irqmask/koewiba-domotic/hw/gateway_usb/doc/gateway_usb_back.png

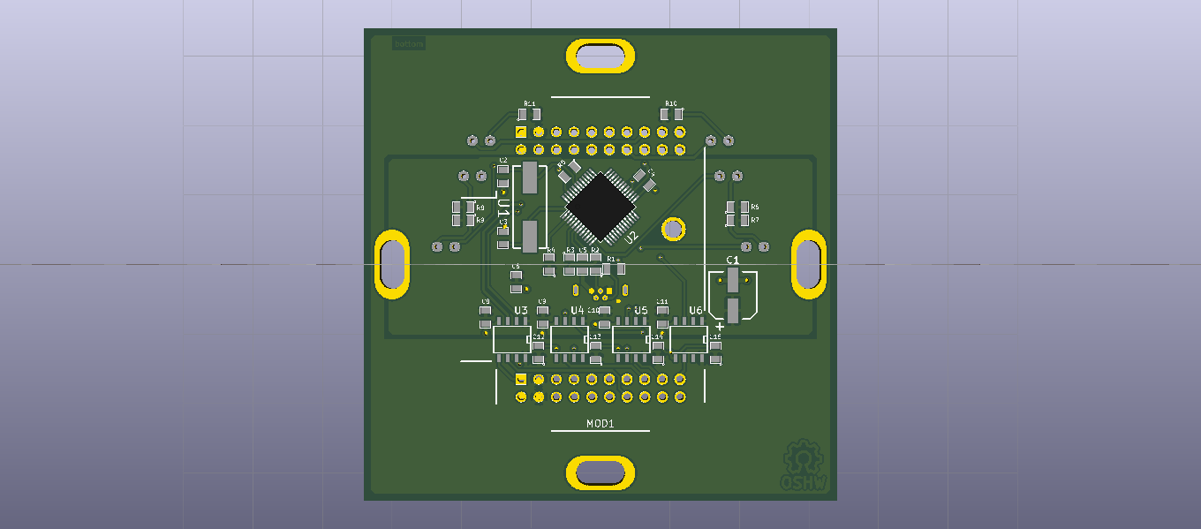
hw/gateway_usb/doc/gateway_usb_back.png
