irqmask/koewiba-domotic/hw/pi2-base/doc/pi2-base_back.jpg

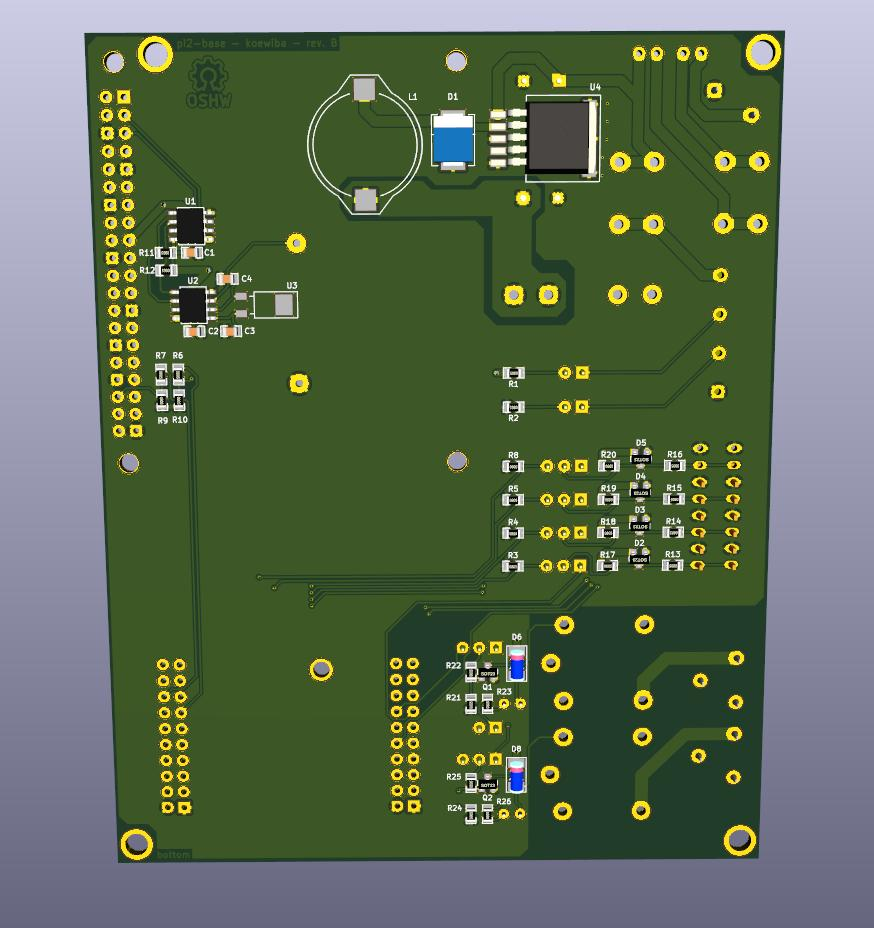
hw/pi2-base/doc/pi2-base_back.jpg
