irqmask/koewiba-domotic/README.md

# koewiba-domotic
home-automation

<a href="https://scan.coverity.com/projects/irqmask-koewiba-domotic">
  
</a>
