irqmask/koewiba-domotic/hw/README.txt

To load KICAD symbols and footprints, make a symbolic link called 'kicadlibrary' to your checked-out symbol- and footprint- library.
e.g. ln -s ~/Projekte/electronic/00library/kicad/ kicadlibrary
