irqmask/koewiba-domotic/doc/drawings/03_two_nodes_gateway_router_mqttgateway_mqtt_openhab.png

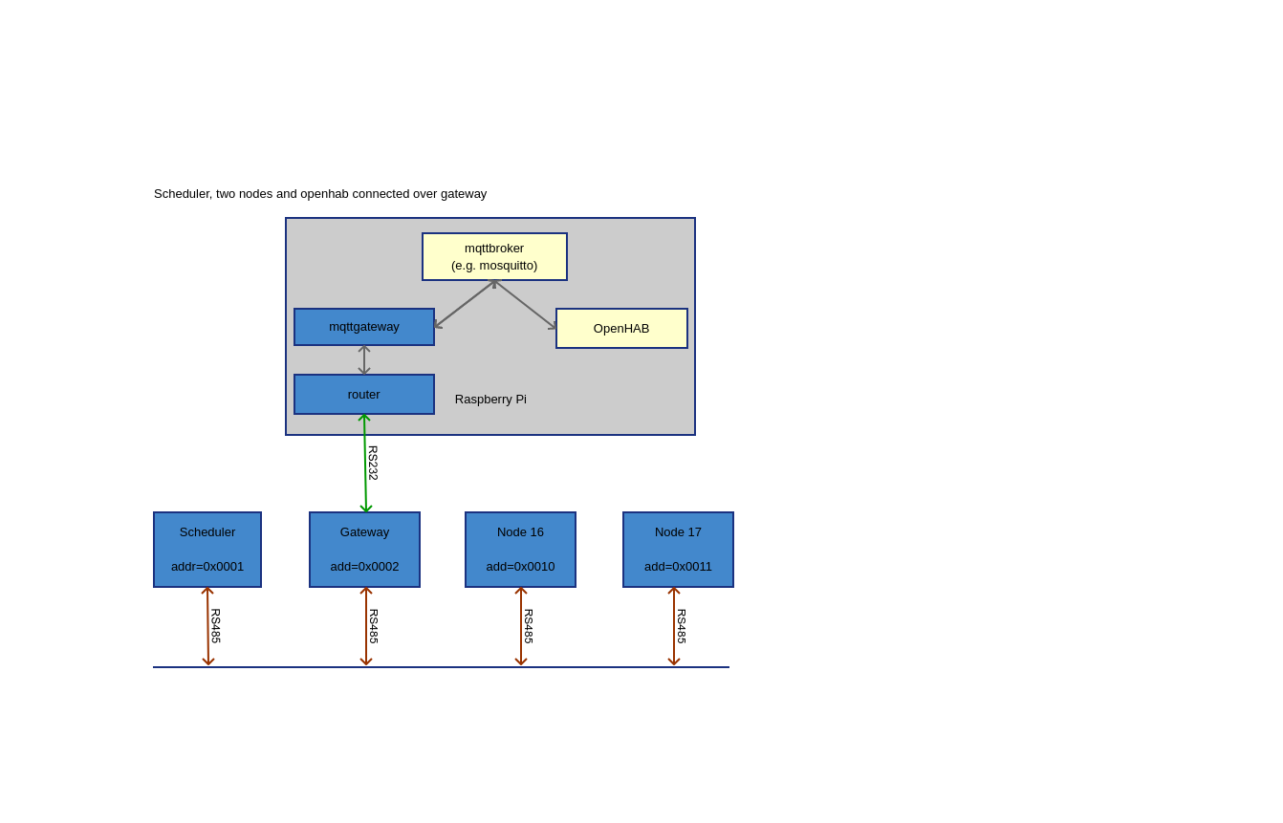
doc/drawings/03_two_nodes_gateway_router_mqttgateway_mqtt_openhab.png
