irqmask/koewiba-domotic/doc/drawings/04_two_networks.png

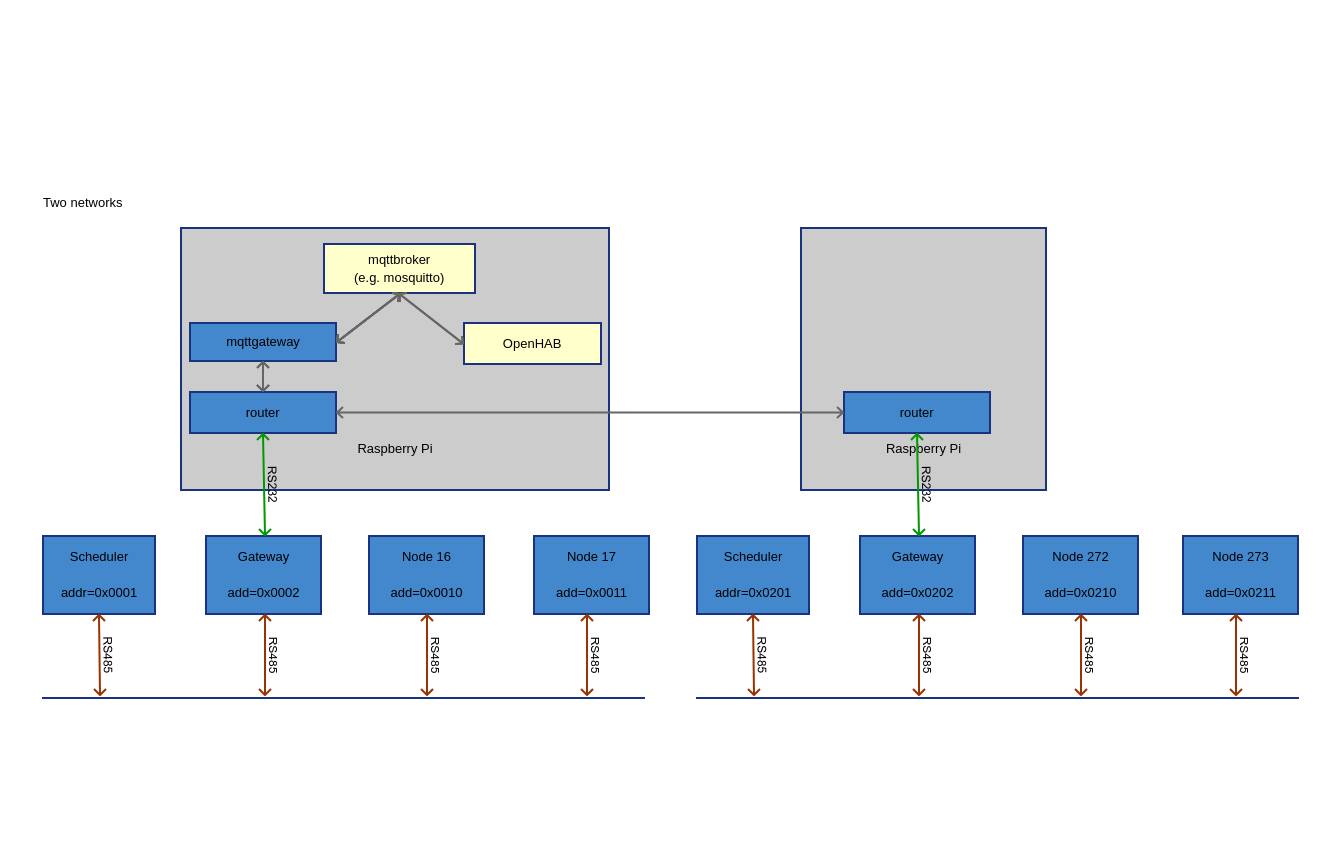
doc/drawings/04_two_networks.png
