irqmask/koewiba-domotic/hw/bus-module_atmega324/bus-module_atmega324_back.jpg

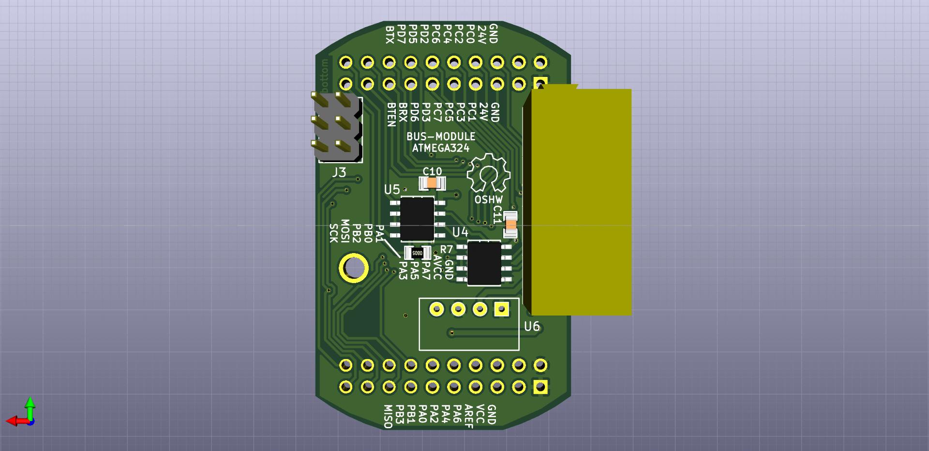
hw/bus-module_atmega324/bus-module_atmega324_back.jpg
