irqmask/koewiba-domotic/hw/bus-module_atmega324/bus-module_atmega324_front.jpg

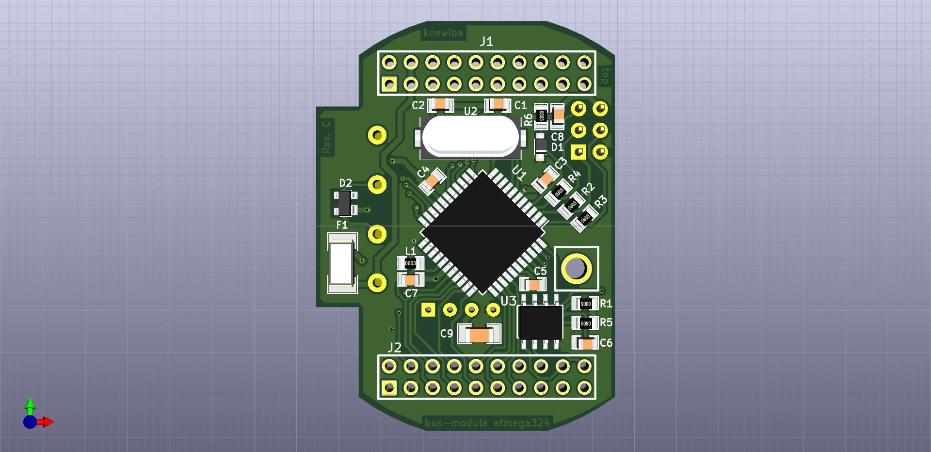
hw/bus-module_atmega324/bus-module_atmega324_front.jpg
