irqmask/koewiba-domotic/hw/bus-module_atmega328/bus-module_atmega328_back.jpg

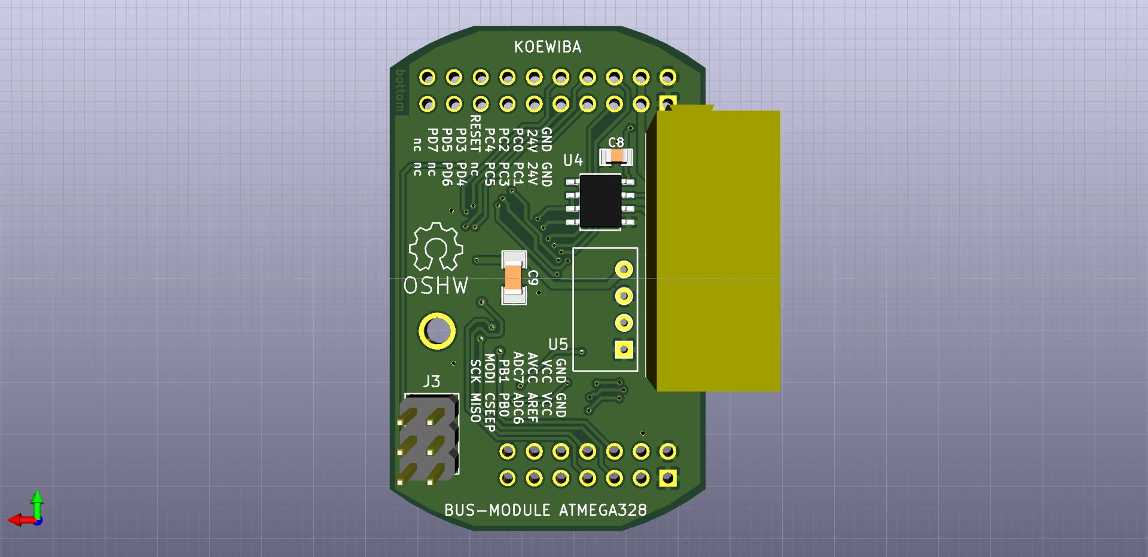
hw/bus-module_atmega328/bus-module_atmega328_back.jpg
