irqmask/koewiba-domotic/hw/bus-module_atmega328/bus-module_atmega328_front.jpg

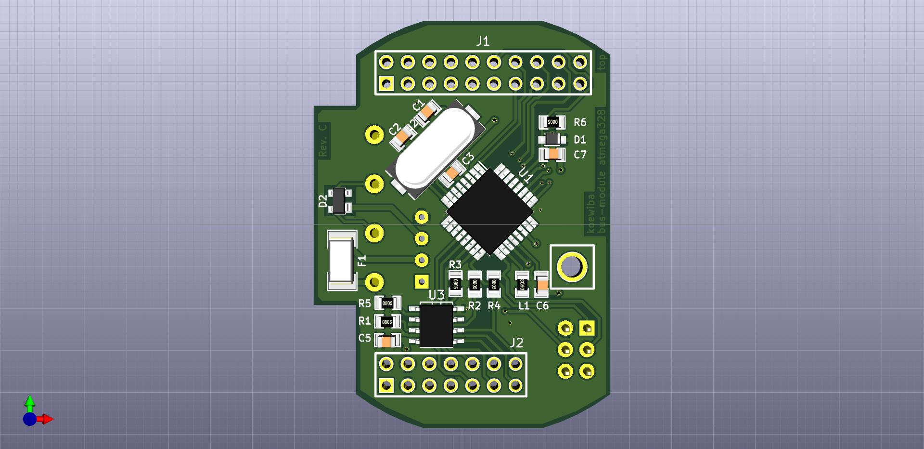
hw/bus-module_atmega328/bus-module_atmega328_front.jpg
