irqmask/koewiba-domotic/hw/bus-module_attiny1634/bus-module_attiny1634_front.jpg

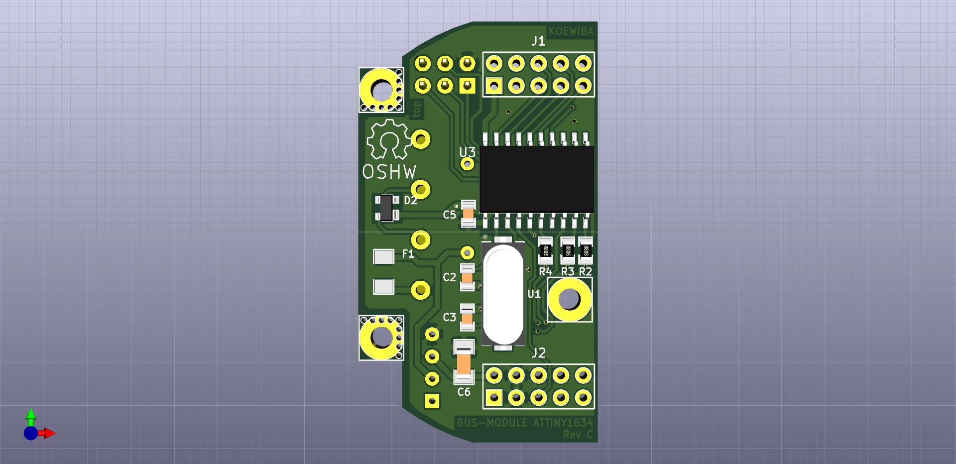
hw/bus-module_attiny1634/bus-module_attiny1634_front.jpg
