irqmask/koewiba-domotic/hw/gateway_usb/doc/gateway_usb_front.png

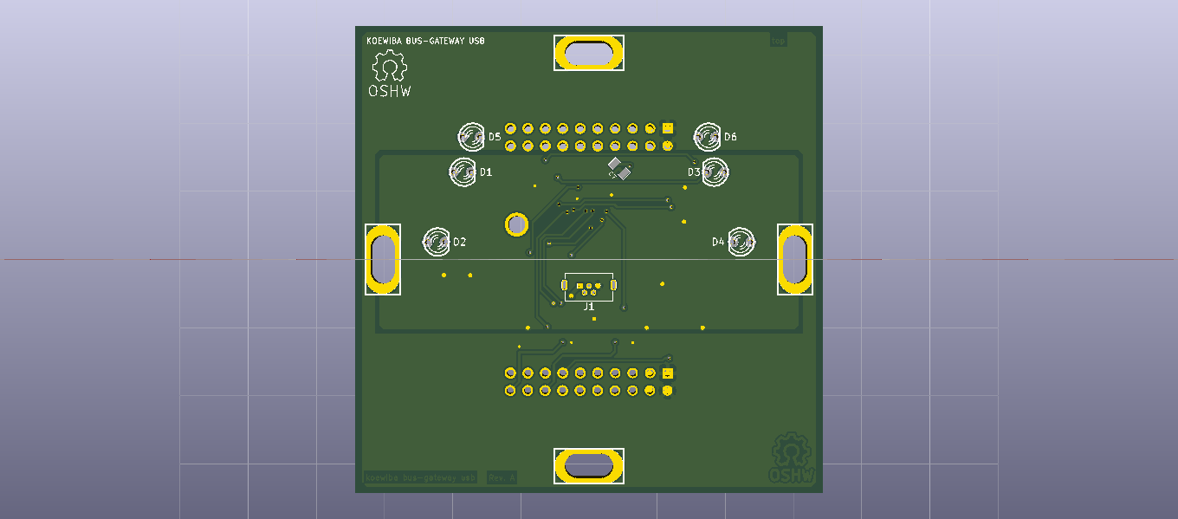
hw/gateway_usb/doc/gateway_usb_front.png
