irqmask/koewiba-domotic/hw/heatervalve/reflectedlightbarrier.png

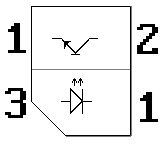
hw/heatervalve/reflectedlightbarrier.png
