irqmask/koewiba-domotic/hw/motor_switch_3pole_5x/doc/motor_switch_3pole_5x_back_3d.jpg

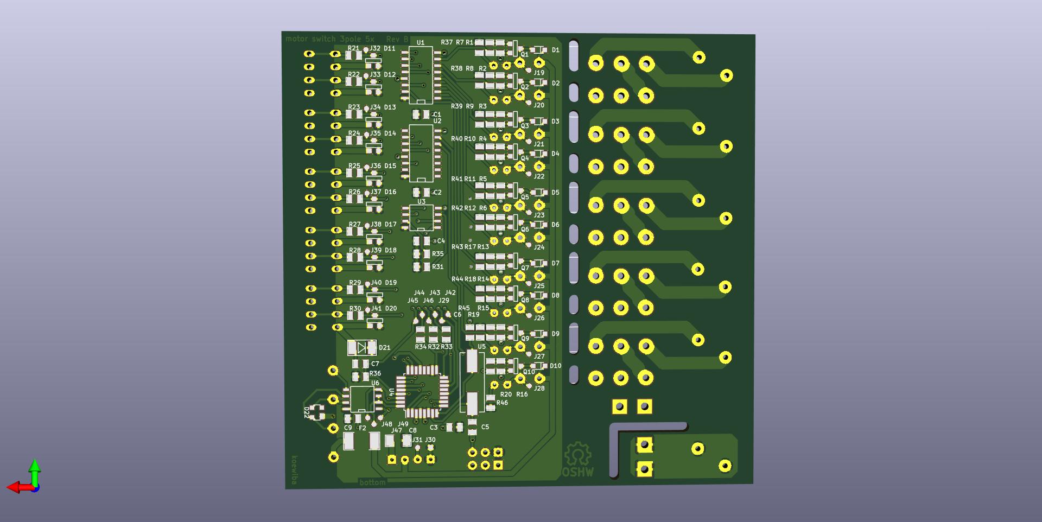
hw/motor_switch_3pole_5x/doc/motor_switch_3pole_5x_back_3d.jpg
