irqmask/koewiba-domotic/hw/motor_switch_3pole_5x/doc/motor_switch_3pole_5x_front_3d.jpg

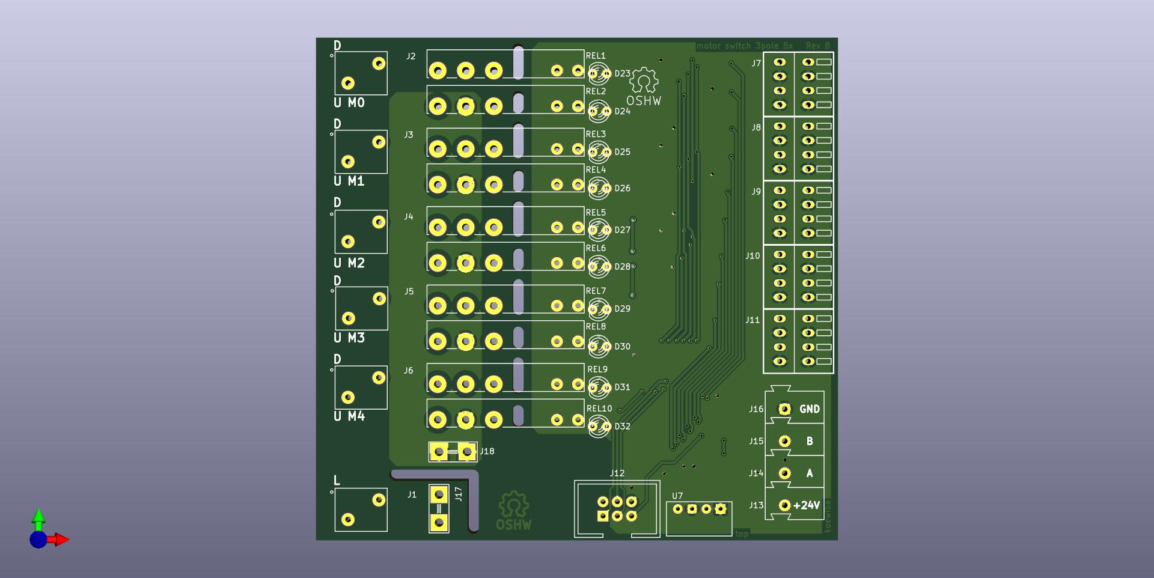
hw/motor_switch_3pole_5x/doc/motor_switch_3pole_5x_front_3d.jpg
