irqmask/koewiba-domotic/hw/roomthermostat/roomthermostat_back_3d.jpg

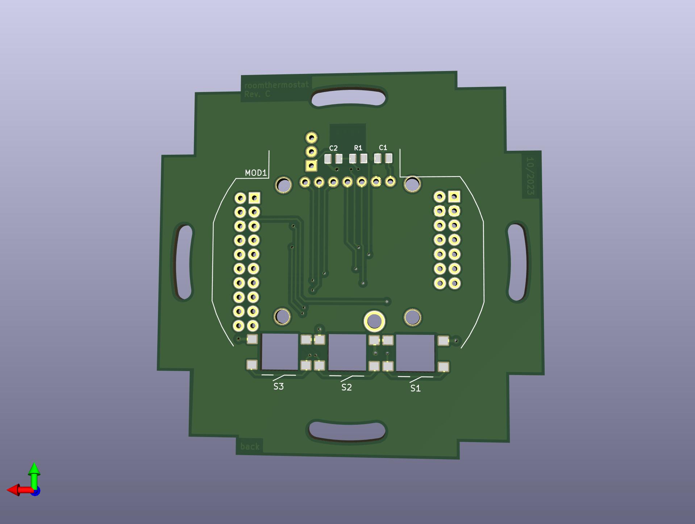
hw/roomthermostat/roomthermostat_back_3d.jpg
