irqmask/koewiba-domotic/hw/roomthermostat/roomthermostat_front_3d.jpg

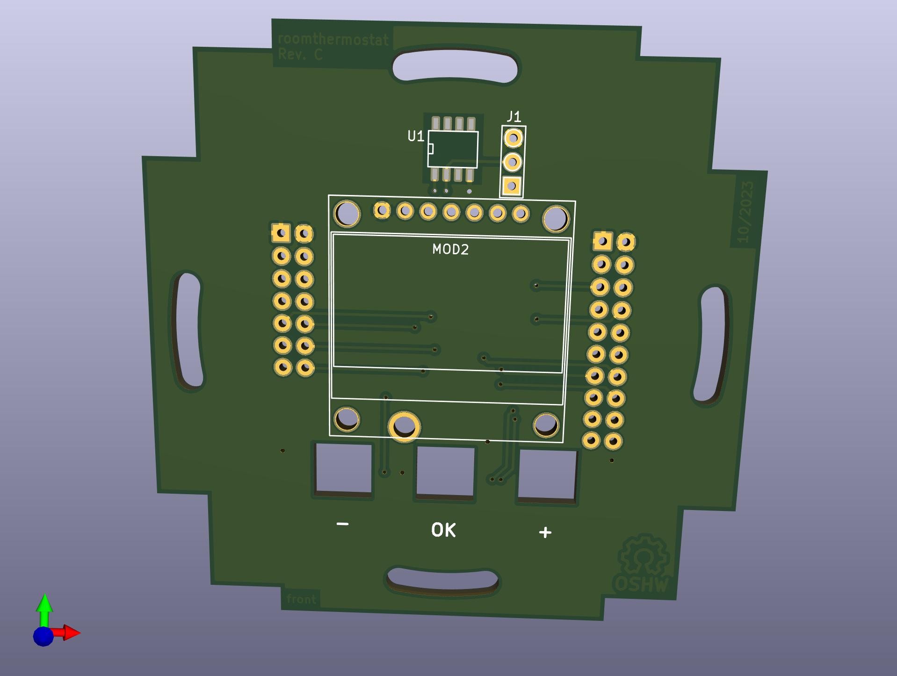
hw/roomthermostat/roomthermostat_front_3d.jpg
