irqmask/koewiba-domotic/hw/switch_3pole_5x/doc/switch_3pole_5x_front_3d.jpg

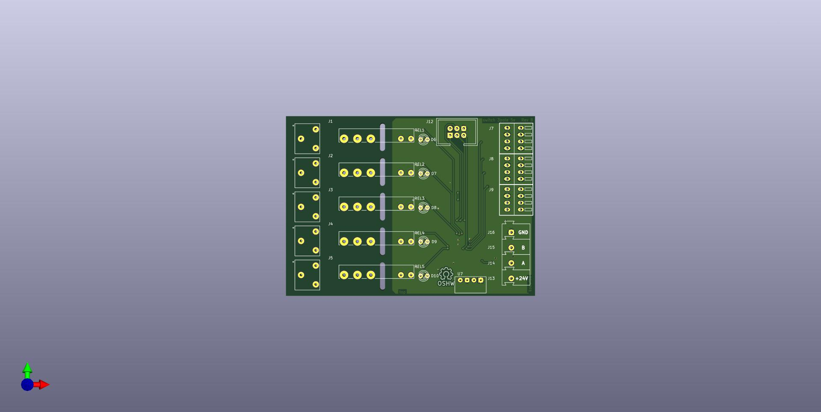
hw/switch_3pole_5x/doc/switch_3pole_5x_front_3d.jpg
