irqmask/koewiba-domotic/sw/doc/drawings/serial_gateway.png

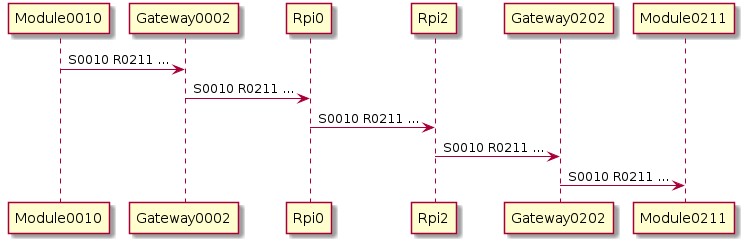
sw/doc/drawings/serial_gateway.png
