irqmask/koewiba-domotic/doc/RegisterOverview.ods

Register |  | default |  |  |  | blind-control (app id 0006h) |  |  |  | Blind-control_5+4 (app id 000Bh) |  |  |  | gateway232(app id 0002h) |  |  |  | pushbutton8 (app id 0009h) |  |  |  | roomthermostate (app id 0007h) |  |  |  | scheduler(app id 0001h) |  |  |  | led2 (app id 0008h) |  |  |  | switch5 (app id 000Ah) |  |  |  | heatervalve (app id 000Ch)
dec | hex | Name | Description | Size | pv | Name | Description | Size | pv | Name | Description | Size | pv | Name | Description | Size | pv | Name | Description | Size | pv | Name | Description | Size | pv | Name | Description | Size | pv | Name | Description | Size | pv | Name | Description | Size | pv | Name | Description | Size | pv
0 | 00 | unused | n/a |  |  | unused | n/a |  |  | unused | n/a |  |  | unused | n/a |  |  | unused | n/a |  |  | unused | n/a |  |  | unused | n/a |  |  | unused | n/a |  |  | unused | n/a |  |  | unused | n/a
1 | 01 | ModuleID | Module ID as it appears on the bus | uint8 | p | ModuleID | Module ID as it appears on the bus | uint8 | p | ModuleID | Module ID as it appears on the bus | uint8 | p | ModuleID | Module ID as it appears on the bus | uint8 | p | ModuleID | Module ID as it appears on the bus | uint8 | p | ModuleID | Module ID as it appears on the bus | uint8 | p | ModuleID | Module ID as it appears on the bus | uint8 | p | ModuleID | Module ID as it appears on the bus | uint8 | p | ModuleID | Module ID as it appears on the bus | uint8 | p | ModuleID | Module ID as it appears on the bus | uint8 | p
2 | 02 | BldFlag | Storage for bootloader flags | uint8 | p | BldFlag | Storage for bootloader flags | uint8 | p | BldFlag | Storage for bootloader flags | uint8 | p | BldFlag | Storage for bootloader flags | uint8 | p | BldFlag | Storage for bootloader flags | uint8 | p | BldFlag | Storage for bootloader flags | uint8 | p | BldFlag | Storage for bootloader flags | uint8 | p | BldFlag | Storage for bootloader flags | uint8 | p | BldFlag | Storage for bootloader flags | uint8 | p | BldFlag | Storage for bootloader flags | uint8 | p
16 | 10 | FirstAppSpecific | n/a | ? |  | PositionCurrent | Current position of blind 0. 100 = completely closed. 0 = completely open | uint8 | vro | PositionCurrent | Current position of blind 0. 100 = completely closed. 0 = completely open | uint8 | vro | Input1 | State of Input 1 (open 255, closed 0) | uint8 | vro | APP_eReg_K0_Mode | Key mode function | uint8 | p | TemperatureCurrent | Current measured temperature in 1/100Kelvin | uint16 | vro | FirstAppSpecific | n/a | ? |  | IntensityChn0Current | Current intensity 0..255 | uint8 | vro | Chn0SwitchCurrent | Current intensity 0...255 | uint8 | vro | IntTempCurrent | Internal temperature sensor measurement in 1/100 Kelvin | uint16 | vro
17 | 11 | ... | ... |  |  | PositionSetPoint | Wanted position of blind. 100 = completely closed. 0 = completely open | uint8 | v | PositionSetPoint | Wanted position of blind. 100 = completely closed. 0 = completely open | uint8 | v | Input2 | State of Input 2 (open 255, closed 0) | uint8 | vro | APP_eReg_K0_RemoteAddr | Receiver's address | uint16 | p | TemperatureSetPoint | Desired temperature in 1/100 Kelvin | uint16 | v | ... | ... |  |  | IntensityChn1Current | Current intensity 0..255 | uint8 | vro | Chn0SwitchSetPoint | Target intensity 0...255 | uint8 | v | ResTempCurrent | Resulting temperature in 1/100 Kelvin. Depends on TemperatureMode | uint16 | vro
18 | 12 |  |  |  |  | PositionDifference | Difference between wanted and current position | int8 | vro | PositionDifference | Difference between wanted and current position | int8 | vro | Input3 | State of Input 3 (open 255, closed 0) | uint8 | vro | APP_eReg_K0_RemoteReg | Receiver's register to set | uint8 | p | TemperatureOffset | Offset to adjust sensor | int16 | p |  |  |  |  | IntensityChn0SetPoint | Target intensity 0..255 | uint8 | p | Chn0ThresholdOff | If intensity goes below, channel switches off | int8 | p | IntTempOffset | Offset to calibrate internal temperature sensor in 1/100 Kelvin | int16 | p
19 | 13 |  |  |  |  | ReactionDelay | Delay time in timer ticks (1/100sec) until movement starts after applying power | uint8 | p | ReactionDelay | Delay time in timer ticks (1/100sec) until movement starts after applying power | uint8 | p | Input4 | State of Input 4 (open 255, closed 0) | uint8 | vro | APP_eReg_K0_Value | Value to set (not used in all modes) | uint8 | p | WindowSensorModuleID | Module ID of module which delivers the window state | uint16 | p |  |  |  |  | IntensityChn1SetPoint | Target intensity 0..255 | uint8 | p | Chn0ThresholdOn | Target intensity 0..255 | uint8 | p | TempMode | 0=internal, 1=external, 2=average int+ext | uint8 | p
20 | 14 |  |  |  |  | DurationOpen | Duration in timer ticks (1/100sec) to fully open the blind | uint16 | p | DurationOpen | Duration in timer ticks (1/100sec) to fully open the blind | uint16 | p |  |  |  |  | APP_eReg_K0_Reserved3 | unused | uint8 | p | WindowSensor0Reg | Register number of window 0 state | uint8 | p |  |  |  |  | IntensityChn0Store | Saved intensity restored on keypress | uint8 | p | Chn0Mode | Mode of channel: Bit0: 0 -> set; 1 -> toggle | uint8 | p
21 | 15 |  |  |  |  | DurationClose | Duration in timer ticks (1/100sec) to fully close the blind | uint16 | p | DurationClose | Duration in timer ticks (1/100sec) to fully close the blind | uint16 | p |  |  |  |  | APP_eReg_K0_Reserved2 | unused | uint8 | p | WindowSensor1Reg | Register number of window 1 state | uint8 |  |  |  |  |  | IntensityChn1Store | Saved intensity restored on keypress | uint8 | p | Chn0Timer0_Weekday | Flags on which weekday this timer applies. Index flags with day-of-week | uint8 | p
22 | 16 |  |  |  |  | Mode |  | uint8 | p | Mode |  | uint8 | p |  |  |  |  | APP_eReg_K0_Reserved1 | unused | uint8 | p | Mode | 0-normal, 1-vacation | uint8 | p |  |  |  |  |  |  |  |  | Chn0Timer0_Hour |  | uint8 | p
23 | 17 |  |  |  |  | unused |  |  |  | unused |  |  |  |  |  |  |  | APP_eReg_K0_Reserved0 | unused | uint8 | p | TemperatureWindowOpen | Temperature to set when a window is opened | uint16 | p |  |  |  |  |  |  |  |  | Chn0Timer0_Minute |  | uint8 | p
24 | 18 |  |  |  |  | unused |  |  |  | unused |  |  |  |  |  |  |  | APP_eReg_K1_Mode | Key mode function | uint8 | p | TemperatureVacation | Temperature to set when in mode vacation | uint16 | p |  |  |  |  |  |  |  |  | Chn0Timer0_SetPoint |  | uint8 | p
25 | 19 |  |  |  |  | unused |  |  |  | unused |  |  |  |  |  |  |  | APP_eReg_K1_RemoteAddr | Receiver's address | uint16 | p |  |  |  |  |  |  |  |  |  |  |  |  | Chn0Timer1_Weekday | Flags on which weekday this timer applies. Index flags with day-of-week | uint8 | p
26 | 1A |  |  |  |  | TimeUp1_Weekday | Flags on which weekday this timer applies. Index flags with day-of-week | uint8 | p | PositionCurrent | Current position of blind 0. 100 = completely closed. 0 = completely open | uint8 | vro |  |  |  |  | APP_eReg_K1_RemoteReg | Receiver's register to set | uint8 | p | Temp0_Weekday | Timepoint 0: Weekday when to switch temperature | uint8 | p |  |  |  |  |  |  |  |  | Chn0Timer1_Hour |  | uint8 | p
27 | 1B |  |  |  |  | TimeUp1_Hour |  | uint8 | p | PositionSetPoint | Wanted position of blind. 100 = completely closed. 0 = completely open | uint8 | v |  |  |  |  | APP_eReg_K1_Value | Value to set (not used in all modes) | uint8 | p | Temp0_Hour | Timepoint 0: Hour when to switch temperature | uint8 | p |  |  |  |  |  |  |  |  | Chn0Timer1_Minute |  | uint8 | p
28 | 1C |  |  |  |  | TimeUp1_Minute |  | uint8 | p | PositionDifference | Difference between wanted and current position | int8 | vro |  |  |  |  | APP_eReg_K1_Reserved3 | unused | uint8 | p | Temp0_Minute | Timepoint 0: Minute when to switch temperature | uint8 | p |  |  |  |  |  |  |  |  | Chn0Timer1_SetPoint |  | uint8 | p
29 | 1D |  |  |  |  | unused |  |  |  | ReactionDelay | Delay time in timer ticks (1/100sec) until movement starts after applying power | uint8 | p |  |  |  |  | APP_eReg_K1_Reserved2 | unused | uint8 | p | Temp0_Temperature | Timepoint 0: Temperature to set when timepoint is reached | uint16 | p |  |  |  |  |  |  |  |  | Chn0Timer2_Weekday | Flags on which weekday this timer applies. Index flags with day-of-week | uint8 | p
30 | 1E |  |  |  |  | unused |  |  |  | DurationOpen | Duration in timer ticks (1/100sec) to fully open the blind | uint16 | p |  |  |  |  | APP_eReg_K1_Reserved1 | unused | uint8 | p |  |  |  |  |  |  |  |  |  |  |  |  | Chn0Timer2_Hour |  | uint8 | p
31 | 1F |  |  |  |  | TimeDown1_Weekday | Flags on which weekday this timer applies. Index flags with day-of-week | uint8 | p | DurationClose | Duration in timer ticks (1/100sec) to fully close the blind | uint16 | p |  |  |  |  | APP_eReg_K1_Reserved0 | unused | uint8 | p | Temp1_Weekday | Timepoint 1: Weekday when to switch temperature | uint8 | p |  |  |  |  |  |  |  |  | Chn0Timer2_Minute |  | uint8 | p
32 | 20 |  |  |  |  | TimeDown1_Hour |  | uint8 | p | Mode |  | uint8 | p |  |  |  |  | APP_eReg_K2_Mode | Key mode function | uint8 | p | Temp1_Hour | Timepoint 1: Hour when to switch temperature | uint8 | p |  |  |  |  |  |  |  |  | Chn0Timer2_SetPoint |  | uint8 | p | RemTempCurrentModID | ModuleID of sender of current temperature | uint16 | p
33 | 21 |  |  |  |  | TimeDown1_Minute |  | uint8 | p | unused |  |  |  |  |  |  |  | APP_eReg_K2_RemoteAddr | Receiver's address | uint16 | p | Temp1_Minute | Timepoint 1: Minute when to switch temperature | uint8 | p |  |  |  |  |  |  |  |  | Chn0Timer3_Weekday | Flags on which weekday this timer applies. Index flags with day-of-week | uint8 | p | RemTempCurrentRegNo | Sender's register number of current temperature | uint8 | p
34 | 22 |  |  |  |  | unused |  |  |  | unused |  |  |  |  |  |  |  | APP_eReg_K2_RemoteReg | Receiver's register to set | uint8 | p | Temp1_Temperature | Timepoint 1: Temperature to set when timepoint is reached | uint16 | p |  |  |  |  |  |  |  |  | Chn0Timer3_Hour |  | uint8 | p | RemTempSetpointModID | ModuleID of sender of temperature setpoint | uint16 | p
35 | 23 |  |  |  |  | unused |  |  |  | unused |  |  |  |  |  |  |  | APP_eReg_K2_Value | Value to set (not used in all modes) | uint8 | p |  |  |  |  |  |  |  |  |  |  |  |  | Chn0Timer3_Minute |  | uint8 | p | RemTempSetpointRegNo | Sender's register number of temperature setpoint | uint8 | p
36 | 24 |  |  |  |  | TimeUp2_Weekday | Flags on which weekday this timer applies. Index flags with day-of-week | uint8 | p | PositionCurrent | Current position of blind 0. 100 = completely closed. 0 = completely open | uint8 | vro |  |  |  |  | APP_eReg_K2_Reserved3 | unused | uint8 | p | Temp2_Weekday | Timepoint 2: Weekday when to switch temperature | uint8 | p |  |  |  |  |  |  |  |  | Chn0Timer3_SetPoint |  | uint8 | p | DebugReceiverModuleID | Receiver module ID for debug messages | uint16 | p
37 | 25 |  |  |  |  | TimeUp2_Hour |  | uint8 | p | PositionSetPoint | Wanted position of blind. 100 = completely closed. 0 = completely open | uint8 | v |  |  |  |  | APP_eReg_K2_Reserved2 | unused | uint8 | p | Temp2_Hour | Timepoint 2: Hour when to switch temperature | uint8 | p |  |  |  |  |  |  |  |  | Chn0Timer4_Weekday | Flags on which weekday this timer applies. Index flags with day-of-week | uint8 | p
38 | 26 |  |  |  |  | TimeUp2_Minute |  | uint8 | p | PositionDifference | Difference between wanted and current position | int8 | vro |  |  |  |  | APP_eReg_K2_Reserved1 | unused | uint8 | p | Temp2_Minute | Timepoint 2: Minute when to switch temperature | uint8 | p |  |  |  |  |  |  |  |  | Chn0Timer4_Hour |  | uint8 | p | Reg_Kp | Regulation Proportional paramater | uint16 | p
39 | 27 |  |  |  |  | unused |  |  |  | ReactionDelay | Delay time in timer ticks (1/100sec) until movement starts after applying power | uint8 | p |  |  |  |  | APP_eReg_K2_Reserved0 | unused | uint8 | p | Temp2_Temperature | Timepoint 2: Temperature to set when timepoint is reached | uint16 | p |  |  |  |  |  |  |  |  | Chn0Timer4_Minute |  | uint8 | p
40 | 28 |  |  |  |  | unused |  |  |  | DurationOpen | Duration in timer ticks (1/100sec) to fully open the blind | uint16 | p |  |  |  |  | APP_eReg_K3_Mode | Key mode function | uint8 | p |  |  |  |  |  |  |  |  |  |  |  |  | Chn0Timer4_SetPoint |  | uint8 | p
41 | 29 |  |  |  |  | TimeDown2_Weekday | Flags on which weekday this timer applies. Index flags with day-of-week | uint8 | p | DurationClose | Duration in timer ticks (1/100sec) to fully close the blind | uint16 | p |  |  |  |  | APP_eReg_K3_RemoteAddr | Receiver's address | uint16 | p | Temp3_Weekday | Timepoint 3: Weekday when to switch temperature | uint8 | p |  |  |  |  |  |  |  |  | Chn0Timer5_Weekday | Flags on which weekday this timer applies. Index flags with day-of-week | uint8 | p
42 | 2A |  |  |  |  | TimeDown2_Hour |  | uint8 | p | Mode |  | uint8 | p |  |  |  |  | APP_eReg_K3_RemoteReg | Receiver's register to set | uint8 | p | Temp3_Hour | Timepoint 3: Hour when to switch temperature | uint8 | p |  |  |  |  |  |  |  |  | Chn0Timer5_Hour |  | uint8 | p
43 | 2B |  |  |  |  | TimeDown2_Minute |  | uint8 | p | unused |  |  |  |  |  |  |  | APP_eReg_K3_Value | Value to set (not used in all modes) | uint8 | p | Temp3_Minute | Timepoint 3: Minute when to switch temperature | uint8 | p |  |  |  |  |  |  |  |  | Chn0Timer5_Minute |  | uint8 | p
44 | 2C |  |  |  |  | unused |  |  |  | unused |  |  |  |  |  |  |  | APP_eReg_K3_Reserved3 | unused | uint8 | p | Temp3_Temperature | Timepoint 3: Temperature to set when timepoint is reached | uint16 | p |  |  |  |  |  |  |  |  | Chn0Timer5_SetPoint |  | uint8 | p
45 | 2D |  |  |  |  | unused |  |  |  | unused |  |  |  |  |  |  |  | APP_eReg_K3_Reserved2 | unused | uint8 | p |  |  |  |  |  |  |  |  |  |  |  |  | Chn0Timer6_Weekday | Flags on which weekday this timer applies. Index flags with day-of-week | uint8 | p
46 | 2E |  |  |  |  | TimeUp3_Weekday | Flags on which weekday this timer applies. Index flags with day-of-week | uint8 | p | PositionCurrent | Current position of blind 0. 100 = completely closed. 0 = completely open | uint8 | vro |  |  |  |  | APP_eReg_K3_Reserved1 | unused | uint8 | p | Temp4_Weekday | Timepoint 4: Weekday when to switch temperature | uint8 | p |  |  |  |  |  |  |  |  | Chn0Timer6_Hour |  | uint8 | p
47 | 2F |  |  |  |  | TimeUp3_Hour |  | uint8 | p | PositionSetPoint | Wanted position of blind. 100 = completely closed. 0 = completely open | uint8 | v |  |  |  |  | APP_eReg_K3_Reserved0 | unused | uint8 | p | Temp4_Hour | Timepoint 4: Hour when to switch temperature | uint8 | p |  |  |  |  |  |  |  |  | Chn0Timer6_Minute |  | uint8 | p
48 | 30 |  |  |  |  | TimeUp3_Minute |  | uint8 | p | PositionDifference | Difference between wanted and current position | int8 | vro |  |  |  |  | APP_eReg_K4_Mode | Key mode function | uint8 | p | Temp4_Minute | Timepoint 4: Minute when to switch temperature | uint8 | p |  |  |  |  |  |  |  |  | Chn0Timer6_SetPoint |  | uint8 | p | Contact0State | State of the contact 0 (e.g. window) | uint8 | vro
49 | 31 |  |  |  |  | unused |  |  |  | ReactionDelay | Delay time in timer ticks (1/100sec) until movement starts after applying power | uint8 | p |  |  |  |  | APP_eReg_K4_RemoteAddr | Receiver's address | uint16 | p | Temp4_Temperature | Timepoint 4: Temperature to set when timepoint is reached | uint16 | p |  |  |  |  |  |  |  |  | Chn0Timer7_Weekday | Flags on which weekday this timer applies. Index flags with day-of-week | uint8 | p | Contact1State | State of the contact 1 (e.g. window) | uint8 | vro
50 | 32 |  |  |  |  | unused |  |  |  | DurationOpen | Duration in timer ticks (1/100sec) to fully open the blind | uint16 | p |  |  |  |  | APP_eReg_K4_RemoteReg | Receiver's register to set | uint8 | p |  |  |  |  |  |  |  |  |  |  |  |  | Chn0Timer7_Hour |  | uint8 | p
51 | 33 |  |  |  |  | TimeDown3_Weekday | Flags on which weekday this timer applies. Index flags with day-of-week | uint8 | p | DurationClose | Duration in timer ticks (1/100sec) to fully close the blind | uint16 | p |  |  |  |  | APP_eReg_K4_Value | Value to set (not used in all modes) | uint8 | p |  |  |  |  |  |  |  |  |  |  |  |  | Chn0Timer7_Minute |  | uint8 | p
52 | 34 |  |  |  |  | TimeDown3_Hour |  | uint8 | p | Mode |  | uint8 | p |  |  |  |  | APP_eReg_K4_Reserved3 | unused | uint8 | p |  |  |  |  |  |  |  |  |  |  |  |  | Chn0Timer7_SetPoint |  | uint8 | p
53 | 35 |  |  |  |  | TimeDown3_Minute |  | uint8 | p | unused |  |  |  |  |  |  |  | APP_eReg_K4_Reserved2 | unused | uint8 | p |  |  |  |  |  |  |  |  |  |  |  |  | Chn0Unused2
54 | 36 |  |  |  |  | unused |  |  |  | unused |  |  |  |  |  |  |  | APP_eReg_K4_Reserved1 | unused | uint8 | p |  |  |  |  |  |  |  |  |  |  |  |  | Chn0Unused1
55 | 37 |  |  |  |  | unused |  |  |  | unused |  |  |  |  |  |  |  | APP_eReg_K4_Reserved0 | unused | uint8 | p |  |  |  |  |  |  |  |  |  |  |  |  | Chn0Unused0
56 | 38 |  |  |  |  | TimeUp4_Weekday | Flags on which weekday this timer applies. Index flags with day-of-week | uint8 | p | PositionCurrent | Current position of blind 0. 100 = completely closed. 0 = completely open | uint8 | vro |  |  |  |  | APP_eReg_K5_Mode | Key mode function | uint8 | p |  |  |  |  |  |  |  |  |  |  |  |  | Chn1SwitchCurrent | Current intensity 0...255 | uint8 | vro
57 | 39 |  |  |  |  | TimeUp4_Hour |  | uint8 | p | PositionSetPoint | Wanted position of blind. 100 = completely closed. 0 = completely open | uint8 | v |  |  |  |  | APP_eReg_K5_RemoteAddr | Receiver's address | uint16 | p |  |  |  |  |  |  |  |  |  |  |  |  | Chn1SwitchSetPoint | Target intensity 0...255 | uint8 | v
58 | 3A |  |  |  |  | TimeUp4_Minute |  | uint8 | p | PositionDifference | Difference between wanted and current position | int8 | vro |  |  |  |  | APP_eReg_K5_RemoteReg | Receiver's register to set | uint8 | p |  |  |  |  |  |  |  |  |  |  |  |  | Chn1ThresholdOff | If intensity goes below, channel switches off | int8 | p
59 | 3B |  |  |  |  | unused |  |  |  | ReactionDelay | Delay time in timer ticks (1/100sec) until movement starts after applying power | uint8 | p |  |  |  |  | APP_eReg_K5_Value | Value to set (not used in all modes) | uint8 | p |  |  |  |  |  |  |  |  |  |  |  |  | Chn1ThresholdOn | Target intensity 0..255 | uint8 | p
60 | 3C |  |  |  |  | unused |  |  |  | DurationOpen | Duration in timer ticks (1/100sec) to fully open the blind | uint16 | p |  |  |  |  | APP_eReg_K5_Reserved3 | unused | uint8 | p |  |  |  |  |  |  |  |  |  |  |  |  | Chn1Mode | Mode of channel: Bit0: 0 -> set; 1 -> toggle | uint8 | p
61 | 3D |  |  |  |  | TimeDown4_Weekday | Flags on which weekday this timer applies. Index flags with day-of-week | uint8 | p | DurationClose | Duration in timer ticks (1/100sec) to fully close the blind | uint16 | p |  |  |  |  | APP_eReg_K5_Reserved2 | unused | uint8 | p |  |  |  |  |  |  |  |  |  |  |  |  | Chn1Timer0_Weekday | Flags on which weekday this timer applies. Index flags with day-of-week | uint8 | p
62 | 3E |  |  |  |  | TimeDown4_Hour |  | uint8 | p | Mode |  | uint8 | p |  |  |  |  | APP_eReg_K5_Reserved1 | unused | uint8 | p |  |  |  |  |  |  |  |  |  |  |  |  | Chn1Timer0_Hour |  | uint8 | p
63 | 3F |  |  |  |  | TimeDown4_Minute |  | uint8 | p | unused |  |  |  |  |  |  |  | APP_eReg_K5_Reserved0 | unused | uint8 | p |  |  |  |  |  |  |  |  |  |  |  |  | Chn1Timer0_Minute |  | uint8 | p
64 | 40 |  |  |  |  | unused |  |  |  | unused |  |  |  |  |  |  |  | APP_eReg_K6_Mode | Key mode function | uint8 | p |  |  |  |  |  |  |  |  |  |  |  |  | Chn1Timer0_SetPoint |  | uint8 | p
65 | 41 |  |  |  |  | unused |  |  |  | unused |  |  |  |  |  |  |  | APP_eReg_K6_RemoteAddr | Receiver's address | uint16 | p |  |  |  |  |  |  |  |  |  |  |  |  | Chn1Timer1_Weekday | Flags on which weekday this timer applies. Index flags with day-of-week | uint8 | p
66 | 42 |  |  |  |  |  |  |  |  | TimeUp1_Weekday | Flags on which weekday this timer applies. Index flags with day-of-week | uint8 | p |  |  |  |  | APP_eReg_K6_RemoteReg | Receiver's register to set | uint8 | p |  |  |  |  |  |  |  |  |  |  |  |  | Chn1Timer1_Hour |  | uint8 | p
67 | 43 |  |  |  |  |  |  |  |  | TimeUp1_Hour |  | uint8 | p |  |  |  |  | APP_eReg_K6_Value | Value to set (not used in all modes) | uint8 | p |  |  |  |  |  |  |  |  |  |  |  |  | Chn1Timer1_Minute |  | uint8 | p
68 | 44 |  |  |  |  |  |  |  |  | TimeUp1_Minute |  | uint8 | p |  |  |  |  | APP_eReg_K6_Reserved3 | unused | uint8 | p |  |  |  |  |  |  |  |  |  |  |  |  | Chn1Timer1_SetPoint |  | uint8 | p
69 | 45 |  |  |  |  |  |  |  |  | unused |  |  |  |  |  |  |  | APP_eReg_K6_Reserved2 | unused | uint8 | p |  |  |  |  |  |  |  |  |  |  |  |  | Chn1Timer2_Weekday | Flags on which weekday this timer applies. Index flags with day-of-week | uint8 | p
70 | 46 |  |  |  |  |  |  |  |  | unused |  |  |  |  |  |  |  | APP_eReg_K6_Reserved1 | unused | uint8 | p |  |  |  |  |  |  |  |  |  |  |  |  | Chn1Timer2_Hour |  | uint8 | p
71 | 47 |  |  |  |  |  |  |  |  | TimeDown1_Weekday | Flags on which weekday this timer applies. Index flags with day-of-week | uint8 | p |  |  |  |  | APP_eReg_K6_Reserved0 | unused | uint8 | p |  |  |  |  |  |  |  |  |  |  |  |  | Chn1Timer2_Minute |  | uint8 | p
72 | 48 |  |  |  |  |  |  |  |  | TimeDown1_Hour |  | uint8 | p |  |  |  |  | APP_eReg_K7_Mode | Key mode function | uint8 | p |  |  |  |  |  |  |  |  |  |  |  |  | Chn1Timer2_SetPoint |  | uint8 | p
73 | 49 |  |  |  |  |  |  |  |  | TimeDown1_Minute |  | uint8 | p |  |  |  |  | APP_eReg_K7_RemoteAddr | Receiver's address | uint16 | p |  |  |  |  |  |  |  |  |  |  |  |  | Chn1Timer3_Weekday | Flags on which weekday this timer applies. Index flags with day-of-week | uint8 | p
74 | 4A |  |  |  |  |  |  |  |  | unused |  |  |  |  |  |  |  | APP_eReg_K7_RemoteReg | Receiver's register to set | uint8 | p |  |  |  |  |  |  |  |  |  |  |  |  | Chn1Timer3_Hour |  | uint8 | p
75 | 4B |  |  |  |  |  |  |  |  | unused |  |  |  |  |  |  |  | APP_eReg_K7_Value | Value to set (not used in all modes) | uint8 | p |  |  |  |  |  |  |  |  |  |  |  |  | Chn1Timer3_Minute |  | uint8 | p
76 | 4C |  |  |  |  |  |  |  |  | TimeUp2_Hour |  | uint8 | p |  |  |  |  | APP_eReg_K7_Reserved3 | unused | uint8 | p |  |  |  |  |  |  |  |  |  |  |  |  | Chn1Timer3_SetPoint |  | uint8 | p
77 | 4D |  |  |  |  |  |  |  |  | TimeUp2_Minute |  | uint8 | p |  |  |  |  | APP_eReg_K7_Reserved2 | unused | uint8 | p |  |  |  |  |  |  |  |  |  |  |  |  | Chn1Timer4_Weekday | Flags on which weekday this timer applies. Index flags with day-of-week | uint8 | p
78 | 4E |  |  |  |  |  |  |  |  | TimeUp2_Weekday | Flags on which weekday this timer applies. Index flags with day-of-week | uint8 | p |  |  |  |  | APP_eReg_K7_Reserved1 | unused | uint8 | p |  |  |  |  |  |  |  |  |  |  |  |  | Chn1Timer4_Hour |  | uint8 | p
79 | 4F |  |  |  |  |  |  |  |  | unused |  |  |  |  |  |  |  | APP_eReg_K7_Reserved0 | unused | uint8 | p |  |  |  |  |  |  |  |  |  |  |  |  | Chn1Timer4_Minute |  | uint8 | p
80 | 50 |  |  |  |  |  |  |  |  | unused |  |  |  |  |  |  |  | APP_eReg_RecMsg0_RemoteAddr | Sender's address | uint8 | p |  |  |  |  |  |  |  |  |  |  |  |  | Chn1Timer4_SetPoint |  | uint8 | p
81 | 51 |  |  |  |  |  |  |  |  | TimeDown2_Weekday | Flags on which weekday this timer applies. Index flags with day-of-week | uint8 | p |  |  |  |  | APP_eReg_RecMsg0_Command | Message command | uint16 | p |  |  |  |  |  |  |  |  |  |  |  |  | Chn1Timer5_Weekday | Flags on which weekday this timer applies. Index flags with day-of-week | uint8 | p
82 | 52 |  |  |  |  |  |  |  |  | TimeDown2_Hour |  | uint8 | p |  |  |  |  | APP_eReg_RecMsg0_Register | Messages Register number | uint8 | p |  |  |  |  |  |  |  |  |  |  |  |  | Chn1Timer5_Hour |  | uint8 | p
83 | 53 |  |  |  |  |  |  |  |  | TimeDown2_Minute |  | uint8 | p |  |  |  |  | APP_eReg_RecMsg0_LEDFunc | LED function 2: [0:3]: Bitposition | [4:7] anzusteuernde LED | uint8 | p |  |  |  |  |  |  |  |  |  |  |  |  | Chn1Timer5_Minute |  | uint8 | p
84 | 54 |  |  |  |  |  |  |  |  | unused |  |  |  |  |  |  |  | APP_eReg_RecMsg0_AddInfo | Bit -> LED | uint8 | p |  |  |  |  |  |  |  |  |  |  |  |  | Chn1Timer5_SetPoint |  | uint8 | p
85 | 55 |  |  |  |  |  |  |  |  | unused |  |  |  |  |  |  |  | APP_eReg_RecMsg1_RemoteAddr | Sender's address | uint16 | p |  |  |  |  |  |  |  |  |  |  |  |  | Chn1Timer6_Weekday | Flags on which weekday this timer applies. Index flags with day-of-week | uint8 | p
86 | 56 |  |  |  |  |  |  |  |  | TimeUp1_Weekday | Flags on which weekday this timer applies. Index flags with day-of-week | uint8 | p |  |  |  |  | APP_eReg_RecMsg1_Command | Message command | uint8 | p |  |  |  |  |  |  |  |  |  |  |  |  | Chn1Timer6_Hour |  | uint8 | p
87 | 57 |  |  |  |  |  |  |  |  | TimeUp1_Hour |  | uint8 | p |  |  |  |  | APP_eReg_RecMsg1_Register | Messages Register number | uint8 | p |  |  |  |  |  |  |  |  |  |  |  |  | Chn1Timer6_Minute |  | uint8 | p
88 | 58 |  |  |  |  |  |  |  |  | TimeUp1_Minute |  | uint8 | p |  |  |  |  | APP_eReg_RecMsg1_LEDFunc | APP_eReg_K1_Mode | uint8 | p |  |  |  |  |  |  |  |  |  |  |  |  | Chn1Timer6_SetPoint |  | uint8 | p
89 | 59 |  |  |  |  |  |  |  |  | unused |  |  |  |  |  |  |  | APP_eReg_RecMsg1_AddInfo | Bit -> LED | uint16 | p |  |  |  |  |  |  |  |  |  |  |  |  | Chn1Timer7_Weekday | Flags on which weekday this timer applies. Index flags with day-of-week | uint8 | p
90 | 5A |  |  |  |  |  |  |  |  | unused |  |  |  |  |  |  |  | APP_eReg_RecMsg2_RemoteAddr | Sender's address | uint8 | p |  |  |  |  |  |  |  |  |  |  |  |  | Chn1Timer7_Hour |  | uint8 | p
91 | 5B |  |  |  |  |  |  |  |  | TimeDown1_Weekday | Flags on which weekday this timer applies. Index flags with day-of-week | uint8 | p |  |  |  |  | APP_eReg_RecMsg2_Command | Message command | uint8 | p |  |  |  |  |  |  |  |  |  |  |  |  | Chn1Timer7_Minute |  | uint8 | p
92 | 5C |  |  |  |  |  |  |  |  | TimeDown1_Hour |  | uint8 | p |  |  |  |  | APP_eReg_RecMsg2_Register | Messages Register number | uint8 | p |  |  |  |  |  |  |  |  |  |  |  |  | Chn1Timer7_SetPoint |  | uint8 | p
93 | 5D |  |  |  |  |  |  |  |  | TimeDown1_Minute |  | uint8 | p |  |  |  |  | APP_eReg_RecMsg2_LEDFunc | LED function | uint16 | p |  |  |  |  |  |  |  |  |  |  |  |  | Chn1Unused2
94 | 5E |  |  |  |  |  |  |  |  | unused |  |  |  |  |  |  |  | APP_eReg_RecMsg2_AddInfo |  | uint8 | p |  |  |  |  |  |  |  |  |  |  |  |  | Chn1Unused1
95 | 5F |  |  |  |  |  |  |  |  | unused |  |  |  |  |  |  |  | APP_eReg_RecMsg3_RemoteAddr | Sender's address | uint8 | p |  |  |  |  |  |  |  |  |  |  |  |  | Chn1Unused0
96 | 60 |  |  |  |  |  |  |  |  | TimeUp2_Hour |  | uint8 | p |  |  |  |  | APP_eReg_RecMsg3_Command | Message command | uint8 | p |  |  |  |  |  |  |  |  |  |  |  |  | Chn2SwitchCurrent | Current intensity 0...255 | uint8 | vro
97 | 61 |  |  |  |  |  |  |  |  | TimeUp2_Minute |  | uint8 | p |  |  |  |  | APP_eReg_RecMsg3_Register | Messages Register number | uint16 | p |  |  |  |  |  |  |  |  |  |  |  |  | Chn2SwitchSetPoint | Target intensity 0...255 | uint8 | v
98 | 62 |  |  |  |  |  |  |  |  | TimeUp2_Weekday | Flags on which weekday this timer applies. Index flags with day-of-week | uint8 | p |  |  |  |  | APP_eReg_RecMsg3_LEDFunc | LED function | uint8 | p |  |  |  |  |  |  |  |  |  |  |  |  | Chn2ThresholdOff | If intensity goes below, channel switches off | int8 | p
99 | 63 |  |  |  |  |  |  |  |  | unused |  |  |  |  |  |  |  | APP_eReg_RecMsg3_AddInfo |  | uint8 | p |  |  |  |  |  |  |  |  |  |  |  |  | Chn2ThresholdOn | Target intensity 0..255 | uint8 | p
100 | 64 |  |  |  |  |  |  |  |  | unused |  |  |  |  |  |  |  | APP_eReg_RecMsg4_RemoteAddr | Sender's address | uint8 | p |  |  |  |  |  |  |  |  |  |  |  |  | Chn2Mode | Mode of channel: Bit0: 0 -> set; 1 -> toggle | uint8 | p
101 | 65 |  |  |  |  |  |  |  |  | TimeDown2_Weekday | Flags on which weekday this timer applies. Index flags with day-of-week | uint8 | p |  |  |  |  | APP_eReg_RecMsg4_Command | Message command | uint16 | p |  |  |  |  |  |  |  |  |  |  |  |  | Chn2Timer0_Weekday | Flags on which weekday this timer applies. Index flags with day-of-week | uint8 | p
102 | 66 |  |  |  |  |  |  |  |  | TimeDown2_Hour |  | uint8 | p |  |  |  |  | APP_eReg_RecMsg4_Register | Messages Register number | uint8 | p |  |  |  |  |  |  |  |  |  |  |  |  | Chn2Timer0_Hour |  | uint8 | p
103 | 67 |  |  |  |  |  |  |  |  | TimeDown2_Minute |  | uint8 | p |  |  |  |  | APP_eReg_RecMsg4_LEDFunc | LED function | uint8 | p |  |  |  |  |  |  |  |  |  |  |  |  | Chn2Timer0_Minute |  | uint8 | p
104 | 68 |  |  |  |  |  |  |  |  | unused |  |  |  |  |  |  |  | APP_eReg_RecMsg4_AddInfo |  | uint8 | p |  |  |  |  |  |  |  |  |  |  |  |  | Chn2Timer0_SetPoint | Flags on which weekday this timer applies. Index flags with day-of-week | uint8 | p
105 | 69 |  |  |  |  |  |  |  |  | unused |  |  |  |  |  |  |  | APP_eReg_RecMsg5_RemoteAddr | Sender's address | uint16 | p |  |  |  |  |  |  |  |  |  |  |  |  | Chn2Timer1_Weekday |  | uint8 | p
106 | 6A |  |  |  |  |  |  |  |  | TimeUp1_Weekday | Flags on which weekday this timer applies. Index flags with day-of-week | uint8 | p |  |  |  |  | APP_eReg_RecMsg5_Command | Message command | uint8 | p |  |  |  |  |  |  |  |  |  |  |  |  | Chn2Timer1_Hour |  | uint8 | p
107 | 6B |  |  |  |  |  |  |  |  | TimeUp1_Hour |  | uint8 | p |  |  |  |  | APP_eReg_RecMsg5_Register | Messages Register number | uint8 | p |  |  |  |  |  |  |  |  |  |  |  |  | Chn2Timer1_Minute | Flags on which weekday this timer applies. Index flags with day-of-week | uint8 | p
108 | 6C |  |  |  |  |  |  |  |  | TimeUp1_Minute |  | uint8 | p |  |  |  |  | APP_eReg_RecMsg5_LEDFunc | LED function | uint8 | p |  |  |  |  |  |  |  |  |  |  |  |  | Chn2Timer1_SetPoint |  | uint8 | p
109 | 6D |  |  |  |  |  |  |  |  | unused |  |  |  |  |  |  |  | APP_eReg_RecMsg5_AddInfo |  | uint16 | p |  |  |  |  |  |  |  |  |  |  |  |  | Chn2Timer2_Weekday |  | uint8 | p
110 | 6E |  |  |  |  |  |  |  |  | unused |  |  |  |  |  |  |  | APP_eReg_RecMsg6_RemoteAddr | Sender's address | uint8 | p |  |  |  |  |  |  |  |  |  |  |  |  | Chn2Timer2_Hour | Flags on which weekday this timer applies. Index flags with day-of-week | uint8 | p
111 | 6F |  |  |  |  |  |  |  |  | TimeDown1_Weekday | Flags on which weekday this timer applies. Index flags with day-of-week | uint8 | p |  |  |  |  | APP_eReg_RecMsg6_Command | Message command | uint8 | p |  |  |  |  |  |  |  |  |  |  |  |  | Chn2Timer2_Minute |  | uint8 | p
112 | 70 |  |  |  |  |  |  |  |  | TimeDown1_Hour |  | uint8 | p |  |  |  |  | APP_eReg_RecMsg6_Register | Messages Register number | uint8 | p |  |  |  |  |  |  |  |  |  |  |  |  | Chn2Timer2_SetPoint |  | uint8 | p
113 | 71 |  |  |  |  |  |  |  |  | TimeDown1_Minute |  | uint8 | p |  |  |  |  | APP_eReg_RecMsg6_LEDFunc | LED function | uint16 | p |  |  |  |  |  |  |  |  |  |  |  |  | Chn2Timer3_Weekday | Flags on which weekday this timer applies. Index flags with day-of-week | uint8 | p
114 | 72 |  |  |  |  |  |  |  |  | unused |  |  |  |  |  |  |  | APP_eReg_RecMsg6_AddInfo |  | uint8 | p |  |  |  |  |  |  |  |  |  |  |  |  | Chn2Timer3_Hour |  | uint8 | p
115 | 73 |  |  |  |  |  |  |  |  | unused |  |  |  |  |  |  |  | APP_eReg_RecMsg7_RemoteAddr | Sender's address | uint8 | p |  |  |  |  |  |  |  |  |  |  |  |  | Chn2Timer3_Minute |  | uint8 | p
116 | 74 |  |  |  |  |  |  |  |  | TimeUp2_Hour |  | uint8 | p |  |  |  |  | APP_eReg_RecMsg7_Command | Message command | uint8 | p |  |  |  |  |  |  |  |  |  |  |  |  | Chn2Timer3_SetPoint | Flags on which weekday this timer applies. Index flags with day-of-week | uint8 | p
117 | 75 |  |  |  |  |  |  |  |  | TimeUp2_Minute |  | uint8 | p |  |  |  |  | APP_eReg_RecMsg7_Register | Messages Register number | uint16 | p |  |  |  |  |  |  |  |  |  |  |  |  | Chn2Timer4_Weekday |  | uint8 | p
118 | 76 |  |  |  |  |  |  |  |  | TimeUp2_Weekday | Flags on which weekday this timer applies. Index flags with day-of-week | uint8 | p |  |  |  |  | APP_eReg_RecMsg7_LEDFunc | LED function | uint8 | p |  |  |  |  |  |  |  |  |  |  |  |  | Chn2Timer4_Hour |  | uint8 | p
119 | 77 |  |  |  |  |  |  |  |  | unused |  |  |  |  |  |  |  | APP_eReg_RecMsg7_AddInfo |  | uint8 | p |  |  |  |  |  |  |  |  |  |  |  |  | Chn2Timer4_Minute | Flags on which weekday this timer applies. Index flags with day-of-week | uint8 | p
120 | 78 |  |  |  |  |  |  |  |  | unused |  |  |  |  |  |  |  | APP_eReg_RecMsg8_RemoteAddr | Sender's address | uint8 | p |  |  |  |  |  |  |  |  |  |  |  |  | Chn2Timer4_SetPoint |  | uint8 | p
121 | 79 |  |  |  |  |  |  |  |  | TimeDown2_Weekday | Flags on which weekday this timer applies. Index flags with day-of-week | uint8 | p |  |  |  |  | APP_eReg_RecMsg8_Command | Message command | uint16 | p |  |  |  |  |  |  |  |  |  |  |  |  | Chn2Timer5_Weekday |  | uint8 | p
122 | 7A |  |  |  |  |  |  |  |  | TimeDown2_Hour |  | uint8 | p |  |  |  |  | APP_eReg_RecMsg8_Register | Messages Register number | uint8 | p |  |  |  |  |  |  |  |  |  |  |  |  | Chn2Timer5_Hour | Flags on which weekday this timer applies. Index flags with day-of-week | uint8 | p
123 | 7B |  |  |  |  |  |  |  |  | TimeDown2_Minute |  | uint8 | p |  |  |  |  | APP_eReg_RecMsg8_LEDFunc | LED function | uint8 | p |  |  |  |  |  |  |  |  |  |  |  |  | Chn2Timer5_Minute |  | uint8 | p
124 | 7C |  |  |  |  |  |  |  |  | unused |  |  |  |  |  |  |  | APP_eReg_RecMsg8_AddInfo |  | uint8 | p |  |  |  |  |  |  |  |  |  |  |  |  | Chn2Timer5_SetPoint |  | uint8 | p
125 | 7D |  |  |  |  |  |  |  |  | unused |  |  |  |  |  |  |  | APP_eReg_RecMsg9_RemoteAddr | Sender's address | uint16 | p |  |  |  |  |  |  |  |  |  |  |  |  | Chn2Timer6_Weekday |  | uint8 | p
126 | 7E |  |  |  |  |  |  |  |  | TimeUp1_Weekday | Flags on which weekday this timer applies. Index flags with day-of-week | uint8 | p |  |  |  |  | APP_eReg_RecMsg9_Command | Message command | uint8 | p |  |  |  |  |  |  |  |  |  |  |  |  | Chn2Timer6_Hour |  | uint8 | p
127 | 7F |  |  |  |  |  |  |  |  | TimeUp1_Hour |  | uint8 | p |  |  |  |  | APP_eReg_RecMsg9_Register | Messages Register number | uint8 | p |  |  |  |  |  |  |  |  |  |  |  |  | Chn2Timer6_Minute |  | uint8 | p
128 | 80 |  |  |  |  | 0 |  |  |  | TimeUp1_Minute |  | uint8 | p | 0 | 0 |  |  | APP_eReg_RecMsg9_LEDFunc | LED function | uint8 | p | 0 | 0 |  |  | 0 | 0 |  |  | 0 | 0 |  |  | Chn2Timer6_SetPoint |  | uint8 | p | 0 | 0
129 | 81 |  |  |  |  | 0 |  |  |  | unused |  |  |  | 0 | 0 |  |  | APP_eReg_RecMsg9_AddInfo |  | uint16 | p | 0 | 0 |  |  | 0 | 0 |  |  | 0 | 0 |  |  | Chn2Timer7_Weekday |  | uint8 | p | 0 | 0
130 | 82 |  |  |  |  | 0 |  |  |  | unused |  |  |  | 0 | 0 |  |  | APP_eReg_RecMsg10_RemoteAddr | Sender's address | uint8 | p | 0 | 0 |  |  | 0 | 0 |  |  | 0 | 0 |  |  | Chn2Timer7_Hour |  | uint8 | p | 0 | 0
131 | 83 |  |  |  |  | 0 |  |  |  | TimeDown1_Weekday | Flags on which weekday this timer applies. Index flags with day-of-week | uint8 | p | 0 | 0 |  |  | APP_eReg_RecMsg10_Command | Message command | uint8 | p | 0 | 0 |  |  | 0 | 0 |  |  | 0 | 0 |  |  | Chn2Timer7_Minute |  | uint8 | p | 0 | 0
132 | 84 |  |  |  |  | 0 |  |  |  | TimeDown1_Hour |  | uint8 | p | 0 | 0 |  |  | APP_eReg_RecMsg10_Register | Messages Register number | uint8 | p | 0 | 0 |  |  | 0 | 0 |  |  | 0 | 0 |  |  | Chn2Timer7_SetPoint |  | uint8 | p | 0 | 0
133 | 85 |  |  |  |  | 0 |  |  |  | TimeDown1_Minute |  | uint8 | p | 0 | 0 |  |  | APP_eReg_RecMsg10_LEDFunc | LED function | uint16 | p | 0 | 0 |  |  | 0 | 0 |  |  | 0 | 0 |  |  | Chn2Unused2 |  |  |  | 0 | 0
134 | 86 |  |  |  |  | 0 |  |  |  | unused |  |  |  | 0 | 0 |  |  | APP_eReg_RecMsg10_AddInfo |  | uint8 | p | 0 | 0 |  |  | 0 | 0 |  |  | 0 | 0 |  |  | Chn2Unused1 |  |  |  | 0 | 0
135 | 87 |  |  |  |  | 0 |  |  |  | unused |  |  |  | 0 | 0 |  |  | APP_eReg_RecMsg11_RemoteAddr | Sender's address | uint8 | p | 0 | 0 |  |  | 0 | 0 |  |  | 0 | 0 |  |  | Chn2Unused0 |  |  |  | 0 | 0
136 | 88 |  |  |  |  | 0 |  |  |  | TimeUp2_Hour |  | uint8 | p | 0 | 0 |  |  | APP_eReg_RecMsg11_Command | Message command | uint8 | p | 0 | 0 |  |  | 0 | 0 |  |  | 0 | 0 |  |  | Chn3SwitchCurrent | Current intensity 0...255 | uint8 | vro | 0 | 0
137 | 89 |  |  |  |  | 0 |  |  |  | TimeUp2_Minute |  | uint8 | p | 0 | 0 |  |  | APP_eReg_RecMsg11_Register | Messages Register number | uint16 | p | 0 | 0 |  |  | 0 | 0 |  |  | 0 | 0 |  |  | Chn3SwitchSetPoint | Target intensity 0...255 | uint8 | v | 0 | 0
138 | 8A |  |  |  |  | 0 |  |  |  | TimeUp2_Weekday | Flags on which weekday this timer applies. Index flags with day-of-week | uint8 | p | 0 | 0 |  |  | APP_eReg_RecMsg11_LEDFunc | LED function | uint8 | p | 0 | 0 |  |  | 0 | 0 |  |  | 0 | 0 |  |  | Chn3ThresholdOff | If intensity goes below, channel switches off | int8 | p | 0 | 0
139 | 8B |  |  |  |  | 0 |  |  |  | unused |  |  |  | 0 | 0 |  |  | APP_eReg_RecMsg11_AddInfo |  | uint8 | p | 0 | 0 |  |  | 0 | 0 |  |  | 0 | 0 |  |  | Chn3ThresholdOn | Target intensity 0..255 | uint8 | p | 0 | 0
140 | 8C |  |  |  |  | 0 |  |  |  | unused |  |  |  | 0 | 0 |  |  | APP_eReg_RecMsg12_RemoteAddr | Sender's address | uint8 | p | 0 | 0 |  |  | 0 | 0 |  |  | 0 | 0 |  |  | Chn3Mode | Mode of channel: Bit0: 0 -> set; 1 -> toggle | uint8 | p | 0 | 0
141 | 8D |  |  |  |  | 0 |  |  |  | TimeDown2_Weekday | Flags on which weekday this timer applies. Index flags with day-of-week | uint8 | p | 0 | 0 |  |  | APP_eReg_RecMsg12_Command | Message command | uint16 | p | 0 | 0 |  |  | 0 | 0 |  |  | 0 | 0 |  |  | Chn3Timer0_Weekday | Flags on which weekday this timer applies. Index flags with day-of-week | uint8 | p | 0 | 0
142 | 8E |  |  |  |  | 0 |  |  |  | TimeDown2_Hour |  | uint8 | p | 0 | 0 |  |  | APP_eReg_RecMsg12_Register | Messages Register number | uint8 | p | 0 | 0 |  |  | 0 | 0 |  |  | 0 | 0 |  |  | Chn3Timer0_Hour |  | uint8 | p | 0 | 0
143 | 8F |  |  |  |  | 0 |  |  |  | TimeDown2_Minute |  | uint8 | p | 0 | 0 |  |  | APP_eReg_RecMsg12_LEDFunc | LED function | uint8 | p | 0 | 0 |  |  | 0 | 0 |  |  | 0 | 0 |  |  | Chn3Timer0_Minute |  | uint8 | p | 0 | 0
144 | 90 |  |  |  |  | 0 |  |  |  | unused |  |  |  | 0 | 0 |  |  | APP_eReg_RecMsg12_AddInfo |  |  |  | 0 | 0 |  |  | 0 | 0 |  |  | 0 | 0 |  |  | Chn3Timer0_SetPoint | Flags on which weekday this timer applies. Index flags with day-of-week | uint8 | p | 0 | 0
145 | 91 |  |  |  |  | 0 |  |  |  | unused |  |  |  | 0 | 0 |  |  | APP_eReg_RecMsg13_RemoteAddr | Sender's address |  |  | 0 | 0 |  |  | 0 | 0 |  |  | 0 | 0 |  |  | Chn3Timer1_Weekday | Flags on which weekday this timer applies. Index flags with day-of-week | uint8 | p | 0 | 0
146 | 92 |  |  |  |  | 0 |  |  |  | 0 | 0 |  |  | 0 | 0 |  |  | APP_eReg_RecMsg13_Command | Message command |  |  | 0 | 0 |  |  | 0 | 0 |  |  | 0 | 0 |  |  | Chn3Timer1_Hour |  | uint8 | p | 0 | 0
147 | 93 |  |  |  |  | 0 |  |  |  | 0 | 0 |  |  | 0 | 0 |  |  | APP_eReg_RecMsg13_Register | Messages Register number |  |  | 0 | 0 |  |  | 0 | 0 |  |  | 0 | 0 |  |  | Chn3Timer1_Minute |  | uint8 | p | 0 | 0
148 | 94 |  |  |  |  | 0 |  |  |  | 0 | 0 |  |  | 0 | 0 |  |  | APP_eReg_RecMsg13_LEDFunc | LED function |  |  | 0 | 0 |  |  | 0 | 0 |  |  | 0 | 0 |  |  | Chn3Timer1_SetPoint |  | uint8 | p | 0 | 0
149 | 95 |  |  |  |  | 0 |  |  |  | 0 | 0 |  |  | 0 | 0 |  |  | APP_eReg_RecMsg13_AddInfo |  |  |  | 0 | 0 |  |  | 0 | 0 |  |  | 0 | 0 |  |  | Chn3Timer2_Weekday | Flags on which weekday this timer applies. Index flags with day-of-week | uint8 | p | 0 | 0
150 | 96 |  |  |  |  | 0 |  |  |  | 0 | 0 |  |  | 0 | 0 |  |  | APP_eReg_RecMsg14_RemoteAddr | Sender's address |  |  | 0 | 0 |  |  | 0 | 0 |  |  | 0 | 0 |  |  | Chn3Timer2_Hour |  | uint8 | p | 0 | 0
151 | 97 |  |  |  |  | 0 |  |  |  | 0 | 0 |  |  | 0 | 0 |  |  | APP_eReg_RecMsg14_Command | Message command |  |  | 0 | 0 |  |  | 0 | 0 |  |  | 0 | 0 |  |  | Chn3Timer2_Minute |  | uint8 | p | 0 | 0
152 | 98 |  |  |  |  | 0 |  |  |  | 0 | 0 |  |  | 0 | 0 |  |  | APP_eReg_RecMsg14_Register | Messages Register number |  |  | 0 | 0 |  |  | 0 | 0 |  |  | 0 | 0 |  |  | Chn3Timer2_SetPoint |  | uint8 | p | 0 | 0
153 | 99 |  |  |  |  | 0 |  |  |  | 0 | 0 |  |  | 0 | 0 |  |  | APP_eReg_RecMsg14_LEDFunc | LED function |  |  | 0 | 0 |  |  | 0 | 0 |  |  | 0 | 0 |  |  | Chn3Timer3_Weekday | Flags on which weekday this timer applies. Index flags with day-of-week | uint8 | p | 0 | 0
154 | 9A |  |  |  |  | 0 |  |  |  | 0 | 0 |  |  | 0 | 0 |  |  | APP_eReg_RecMsg14_AddInfo |  |  |  | 0 | 0 |  |  | 0 | 0 |  |  | 0 | 0 |  |  | Chn3Timer3_Hour |  | uint8 | p | 0 | 0
155 | 9B |  |  |  |  | 0 |  |  |  | 0 | 0 |  |  | 0 | 0 |  |  | APP_eReg_RecMsg15_RemoteAddr | Sender's address |  |  | 0 | 0 |  |  | 0 | 0 |  |  | 0 | 0 |  |  | Chn3Timer3_Minute |  | uint8 | p | 0 | 0
156 | 9C |  |  |  |  | 0 |  |  |  | 0 | 0 |  |  | 0 | 0 |  |  | APP_eReg_RecMsg15_Command | Message command |  |  | 0 | 0 |  |  | 0 | 0 |  |  | 0 | 0 |  |  | Chn3Timer3_SetPoint |  | uint8 | p | 0 | 0
157 | 9D |  |  |  |  | 0 |  |  |  | 0 | 0 |  |  | 0 | 0 |  |  | APP_eReg_RecMsg15_Register | Messages Register number |  |  | 0 | 0 |  |  | 0 | 0 |  |  | 0 | 0 |  |  | Chn3Timer4_Weekday | Flags on which weekday this timer applies. Index flags with day-of-week | uint8 | p | 0 | 0
158 | 9E |  |  |  |  | 0 |  |  |  | 0 | 0 |  |  | 0 | 0 |  |  | APP_eReg_RecMsg15_LEDFunc | LED function |  |  | 0 | 0 |  |  | 0 | 0 |  |  | 0 | 0 |  |  | Chn3Timer4_Hour |  | uint8 | p | 0 | 0
159 | 9F |  |  |  |  | 0 |  |  |  | 0 | 0 |  |  | 0 | 0 |  |  | APP_eReg_RecMsg15_AddInfo |  |  |  | 0 | 0 |  |  | 0 | 0 |  |  | 0 | 0 |  |  | Chn3Timer4_Minute |  | uint8 | p | 0 | 0
160 | A0 |  |  |  |  | 0 |  |  |  | 0 | 0 |  |  | 0 | 0 |  |  | APP_eReg_0_LEDState | [0..3] Intensity: 0x0=off ... 0xF=bright [4..7] Blink freq.: 0x0=const. | 0x10=slow ... 0xF0=fast Examples: 0x0F = LED on 0x?0 = LED off (higher nibble doesn't matter) 0xFF = LED very fast blinking 0x88 = LED half inensity, blinking with medium freq. |  |  | 0 | 0 |  |  | 0 | 0 |  |  | 0 | 0 |  |  | Chn3Timer4_SetPoint |  | uint8 | p | 0 | 0
161 | A1 |  |  |  |  | 0 |  |  |  | 0 | 0 |  |  | 0 | 0 |  |  | APP_eReg_1_LEDState |  |  |  | 0 | 0 |  |  | 0 | 0 |  |  | 0 | 0 |  |  | Chn3Timer5_Weekday | Flags on which weekday this timer applies. Index flags with day-of-week | uint8 | p | 0 | 0
162 | A2 |  |  |  |  | 0 |  |  |  | 0 | 0 |  |  | 0 | 0 |  |  | APP_eReg_2_LEDState | 0 |  |  | 0 | 0 |  |  | 0 | 0 |  |  | 0 | 0 |  |  | Chn3Timer5_Hour |  | uint8 | p | 0 | 0
163 | A3 |  |  |  |  | 0 |  |  |  | 0 | 0 |  |  | 0 | 0 |  |  | APP_eReg_3_LEDState | 0 |  |  | 0 | 0 |  |  | 0 | 0 |  |  | 0 | 0 |  |  | Chn3Timer5_Minute |  | uint8 | p | 0 | 0
164 | A4 |  |  |  |  | 0 |  |  |  | 0 | 0 |  |  | 0 | 0 |  |  | APP_eReg_4_LEDState | 0 |  |  | 0 | 0 |  |  | 0 | 0 |  |  | 0 | 0 |  |  | Chn3Timer5_SetPoint |  | uint8 | p | 0 | 0
165 | A5 |  |  |  |  | 0 |  |  |  | 0 | 0 |  |  | 0 | 0 |  |  | APP_eReg_5_LEDState | 0 |  |  | 0 | 0 |  |  | 0 | 0 |  |  | 0 | 0 |  |  | Chn3Timer6_Weekday | Flags on which weekday this timer applies. Index flags with day-of-week | uint8 | p | 0 | 0
166 | A6 |  |  |  |  | 0 |  |  |  | 0 | 0 |  |  | 0 | 0 |  |  | APP_eReg_6_LEDState | 0 |  |  | 0 | 0 |  |  | 0 | 0 |  |  | 0 | 0 |  |  | Chn3Timer6_Hour |  | uint8 | p | 0 | 0
167 | A7 |  |  |  |  | 0 |  |  |  | 0 | 0 |  |  | 0 | 0 |  |  | APP_eReg_7_LEDState | 0 |  |  | 0 | 0 |  |  | 0 | 0 |  |  | 0 | 0 |  |  | Chn3Timer6_Minute |  | uint8 | p | 0 | 0
168 | A8 |  |  |  |  | 0 |  |  |  | 0 | 0 |  |  | 0 | 0 |  |  |  |  |  |  | 0 | 0 |  |  | 0 | 0 |  |  | 0 | 0 |  |  | Chn3Timer6_SetPoint |  | uint8 | p | 0 | 0
169 | A9 |  |  |  |  | 0 |  |  |  | 0 | 0 |  |  | 0 | 0 |  |  |  |  |  |  | 0 | 0 |  |  | 0 | 0 |  |  | 0 | 0 |  |  | Chn3Timer7_Weekday | Flags on which weekday this timer applies. Index flags with day-of-week | uint8 | p | 0 | 0
170 | AA |  |  |  |  | 0 |  |  |  | 0 | 0 |  |  | 0 | 0 |  |  |  |  |  |  | 0 | 0 |  |  | 0 | 0 |  |  | 0 | 0 |  |  | Chn3Timer7_Hour |  | uint8 | p | 0 | 0
171 | AB |  |  |  |  | 0 |  |  |  | 0 | 0 |  |  | 0 | 0 |  |  |  |  |  |  | 0 | 0 |  |  | 0 | 0 |  |  | 0 | 0 |  |  | Chn3Timer7_Minute |  | uint8 | p | 0 | 0
172 | AC |  |  |  |  | 0 |  |  |  | 0 | 0 |  |  | 0 | 0 |  |  |  |  |  |  | 0 | 0 |  |  | 0 | 0 |  |  | 0 | 0 |  |  | Chn3Timer7_SetPoint |  | uint8 | p | 0 | 0
173 | AD |  |  |  |  | 0 |  |  |  | 0 | 0 |  |  | 0 | 0 |  |  |  |  |  |  | 0 | 0 |  |  | 0 | 0 |  |  | 0 | 0 |  |  | Chn3Unused2 |  |  |  | 0 | 0
174 | AE |  |  |  |  | 0 |  |  |  | 0 | 0 |  |  | 0 | 0 |  |  |  |  |  |  | 0 | 0 |  |  | 0 | 0 |  |  | 0 | 0 |  |  | Chn3Unused1 |  |  |  | 0 | 0
175 | AF |  |  |  |  | 0 |  |  |  | 0 | 0 |  |  | 0 | 0 |  |  |  |  |  |  | 0 | 0 |  |  | 0 | 0 |  |  | 0 | 0 |  |  | Chn3Unused0 |  |  |  | 0 | 0
176 | B0 |  |  |  |  | 0 |  |  |  | 0 | 0 |  |  | 0 | 0 |  |  |  |  |  |  | 0 | 0 |  |  | 0 | 0 |  |  | 0 | 0 |  |  | Chn4SwitchCurrent | Current intensity 0...255 | uint8 | vro | 0 | 0
177 | B1 |  |  |  |  | 0 |  |  |  | 0 | 0 |  |  | 0 | 0 |  |  |  |  |  |  | 0 | 0 |  |  | 0 | 0 |  |  | 0 | 0 |  |  | Chn4SetPoint | Target intensity 0...255 | uint8 | v | 0 | 0
178 | B2 |  |  |  |  | 0 |  |  |  | 0 | 0 |  |  | 0 | 0 |  |  |  |  |  |  | 0 | 0 |  |  | 0 | 0 |  |  | 0 | 0 |  |  | Chn4ThresholdOff | If intensity goes below, channel switches off | int8 | p | 0 | 0
179 | B3 |  |  |  |  | 0 |  |  |  | 0 | 0 |  |  | 0 | 0 |  |  |  |  |  |  | 0 | 0 |  |  | 0 | 0 |  |  | 0 | 0 |  |  | Chn4ThresholdOn | Target intensity 0..255 | uint8 | p | 0 | 0
180 | B4 |  |  |  |  | 0 |  |  |  | 0 | 0 |  |  | 0 | 0 |  |  |  |  |  |  | 0 | 0 |  |  | 0 | 0 |  |  | 0 | 0 |  |  | Chn4Mode | Mode of channel: Bit0: 0 -> set; 1 -> toggle | uint8 | p | 0 | 0
181 | B5 |  |  |  |  | 0 |  |  |  | 0 | 0 |  |  | 0 | 0 |  |  |  |  |  |  | 0 | 0 |  |  | 0 | 0 |  |  | 0 | 0 |  |  | Chn4Timer0_Weekday | Flags on which weekday this timer applies. Index flags with day-of-week | uint8 | p | 0 | 0
182 | B6 |  |  |  |  | 0 |  |  |  | 0 | 0 |  |  | 0 | 0 |  |  |  |  |  |  | 0 | 0 |  |  | 0 | 0 |  |  | 0 | 0 |  |  | Chn4Timer0_Hour |  | uint8 | p | 0 | 0
183 | B7 |  |  |  |  | 0 |  |  |  | 0 | 0 |  |  | 0 | 0 |  |  |  |  |  |  | 0 | 0 |  |  | 0 | 0 |  |  | 0 | 0 |  |  | Chn4Timer0_Minute |  | uint8 | p | 0 | 0
184 | B8 |  |  |  |  | 0 |  |  |  | 0 | 0 |  |  | 0 | 0 |  |  |  |  |  |  | 0 | 0 |  |  | 0 | 0 |  |  | 0 | 0 |  |  | Chn4Timer0_SetPoint |  | uint8 | p | 0 | 0
185 | B9 |  |  |  |  | 0 |  |  |  | 0 | 0 |  |  | 0 | 0 |  |  |  |  |  |  | 0 | 0 |  |  | 0 | 0 |  |  | 0 | 0 |  |  | Chn4Timer1_Weekday | Flags on which weekday this timer applies. Index flags with day-of-week | uint8 | p | 0 | 0
186 | BA |  |  |  |  | 0 |  |  |  | 0 | 0 |  |  | 0 | 0 |  |  |  |  |  |  | 0 | 0 |  |  | 0 | 0 |  |  | 0 | 0 |  |  | Chn4Timer1_Hour |  | uint8 | p | 0 | 0
187 | BB |  |  |  |  | 0 |  |  |  | 0 | 0 |  |  | 0 | 0 |  |  |  |  |  |  | 0 | 0 |  |  | 0 | 0 |  |  | 0 | 0 |  |  | Chn4Timer1_Minute |  | uint8 | p | 0 | 0
188 | BC |  |  |  |  | 0 |  |  |  | 0 | 0 |  |  | 0 | 0 |  |  |  |  |  |  | 0 | 0 |  |  | 0 | 0 |  |  | 0 | 0 |  |  | Chn4Timer1_SetPoint |  | uint8 | p | 0 | 0
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
213 | D5 |  |  |  |  | 0 |  |  |  | 0 | 0 |  |  | 0 | 0 |  |  |  |  |  |  | 0 | 0 |  |  | 0 | 0 |  |  | 0 | 0 |  |  | Chn4Unused2 |  | uint8 | p | 0 | 0
214 | D6 |  |  |  |  | 0 |  |  |  | 0 | 0 |  |  | 0 | 0 |  |  |  |  |  |  | 0 | 0 |  |  | 0 | 0 |  |  | 0 | 0 |  |  | Chn4Unused1 |  | uint8 | p | 0 | 0
215 | D7 |  |  |  |  | 0 |  |  |  | 0 | 0 |  |  | 0 | 0 |  |  |  |  |  |  | 0 | 0 |  |  | 0 | 0 |  |  | 0 | 0 |  |  | Chn4Unused0 |  | uint8 | p | 0 | 0
216 | D8 |  |  |  |  | 0 |  |  |  | 0 | 0 |  |  | 0 | 0 |  |  |  |  |  |  | 0 | 0 |  |  | 0 | 0 |  |  | 0 | 0 |  |  |  |  |  |  | 0 | 0
217 | D9 |  |  |  |  | 0 |  |  |  | 0 | 0 |  |  | 0 | 0 |  |  |  |  |  |  | 0 | 0 |  |  | 0 | 0 |  |  | 0 | 0 |  |  |  |  |  |  | 0 | 0
218 | DA |  |  |  |  | 0 |  |  |  | 0 | 0 |  |  | 0 | 0 |  |  |  |  |  |  | 0 | 0 |  |  | 0 | 0 |  |  | 0 | 0 |  |  |  |  |  |  | 0 | 0
219 | DB |  |  |  |  | 0 |  |  |  | 0 | 0 |  |  | 0 | 0 |  |  |  |  |  |  | 0 | 0 |  |  | 0 | 0 |  |  | 0 | 0 |  |  |  |  |  |  | 0 | 0
220 | DC |  |  |  |  | 0 |  |  |  | 0 | 0 |  |  | 0 | 0 |  |  |  |  |  |  | 0 | 0 |  |  | 0 | 0 |  |  | 0 | 0 |  |  |  |  |  |  | 0 | 0
221 | DD |  |  |  |  | 0 |  |  |  | 0 | 0 |  |  | 0 | 0 |  |  |  |  |  |  | 0 | 0 |  |  | 0 | 0 |  |  | 0 | 0 |  |  |  |  |  |  | 0 | 0
222 | DE |  |  |  |  | 0 |  |  |  | 0 | 0 |  |  | 0 | 0 |  |  |  |  |  |  | 0 | 0 |  |  | 0 | 0 |  |  | 0 | 0 |  |  |  |  |  |  | 0 | 0
223 | DF |  |  |  |  | Year | Current date and time. DayOfWeek: 0=Monday, 6=Sunday | uint16 | v | Year | Current date and time. DayOfWeek: 0=Monday, 6=Sunday | uint16 | v | 0 | 0 |  |  |  |  |  |  | 0 | 0 |  |  | 0 | 0 |  |  | 0 | 0 |  |  | Year | Current date and time. DayOfWeek: 0=Monday, 6=Sunday | uint16 | v | 0 | 0
224 | E0 |  |  |  |  | Month |  | uint8 | v | Month |  | uint8 | v | 0 | 0 |  |  |  |  |  |  | 0 | 0 |  |  | 0 | 0 |  |  | 0 | 0 |  |  | Month |  | uint8 | v | 0 | 0
225 | E1 |  |  |  |  | Day |  | uint8 | v | Day |  | uint8 | v | 0 | 0 |  |  |  |  |  |  | 0 | 0 |  |  | 0 | 0 |  |  | 0 | 0 |  |  | Day |  | uint8 | v | 0 | 0
226 | E2 |  |  |  |  | DayOfWeek |  | uint8 | v | DayOfWeek |  | uint8 | v | 0 | 0 |  |  |  |  |  |  | 0 | 0 |  |  | 0 | 0 |  |  | 0 | 0 |  |  | DayOfWeek |  | uint8 | v | 0 | 0
227 | E3 |  |  |  |  | Hour |  | uint8 | v | Hour |  | uint8 | v | 0 | 0 |  |  |  |  |  |  | 0 | 0 |  |  | 0 | 0 |  |  | 0 | 0 |  |  | Hour |  | uint8 | v | 0 | 0
228 | E4 | ... |  |  |  | Minute |  | uint8 | v | Minute |  | uint8 | v | ... | 0 |  |  |  |  |  |  | ... | 0 |  |  | ... | 0 |  |  | ... | 0 |  |  | Minute |  | uint8 | v | ... | 0
229 | E5 | LastAppSpecific | n/a |  |  | Second |  | uint8 | v | Second |  | uint8 | v | LastAppSpecific | n/a |  |  | LastAppSpecific | n/a |  |  | LastAppSpecific | n/a |  |  | LastAppSpecific | n/a |  |  | LastAppSpecific | n/a |  |  | Second |  | uint8 | v | LastAppSpecific | n/a
230 | E6 | DeviceSignature0 | 1st byte of device signature | uint8 | pro | DeviceSignature0 | 1st byte of device signature | uint8 | pro | DeviceSignature0 | 1st byte of device signature | uint8 | pro | DeviceSignature0 | 1st byte of device signature | uint8 | pro | DeviceSignature0 | 1st byte of device signature | uint8 | pro | DeviceSignature0 | 1st byte of device signature | uint8 | pro | DeviceSignature0 | 1st byte of device signature | uint8 | pro | DeviceSignature0 | 1st byte of device signature | uint8 | pro | DeviceSignature0 | 1st byte of device signature | uint8 | pro | DeviceSignature0 | 1st byte of device signature | uint8 | pro
231 | E7 | DeviceSignature1 | 2nd byte of device signature | uint8 | pro | DeviceSignature1 | 2nd byte of device signature | uint8 | pro | DeviceSignature1 | 2nd byte of device signature | uint8 | pro | DeviceSignature1 | 2nd byte of device signature | uint8 | pro | DeviceSignature1 | 2nd byte of device signature | uint8 | pro | DeviceSignature1 | 2nd byte of device signature | uint8 | pro | DeviceSignature1 | 2nd byte of device signature | uint8 | pro | DeviceSignature1 | 2nd byte of device signature | uint8 | pro | DeviceSignature1 | 2nd byte of device signature | uint8 | pro | DeviceSignature1 | 2nd byte of device signature | uint8 | pro
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
241 | F1
242 | F2
243 | F3
244 | F4
245 | F5
