irqmask/koewiba-domotic/hw/templates/board_outline_missing_left.dxf

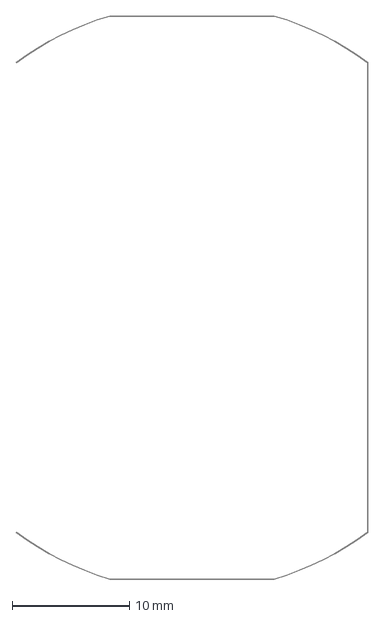
[picture p22: CAD file, 2015-11-01]
hw/templates/board_outline_missing_left.dxf
30.0 x 48.0 mm
