irqmask/koewiba-domotic/hw/templates/board_outline.dxf

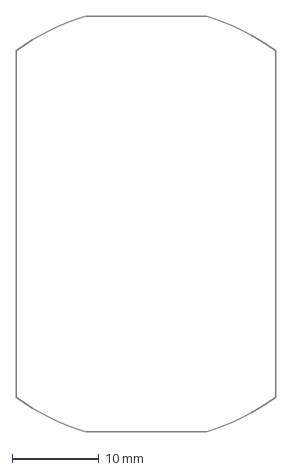
[picture p23: CAD file, 2015-11-01]
hw/templates/board_outline.dxf
30.0 x 48.0 mm
