irqmask/koewiba-domotic/doc/drawings/01_minimal_setup_2nodes.png

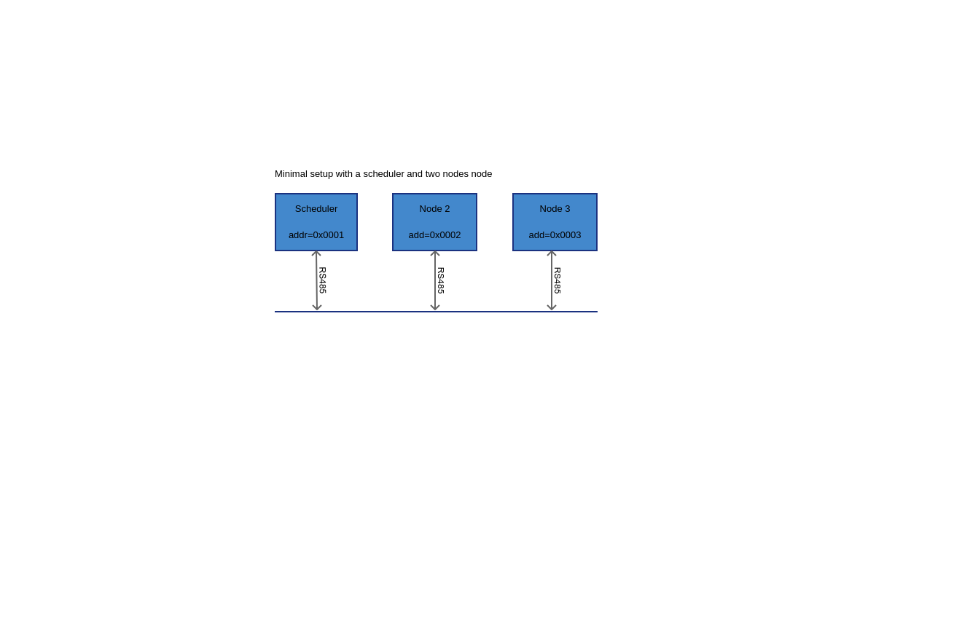
doc/drawings/01_minimal_setup_2nodes.png
