irqmask/koewiba-domotic/doc/drawings/02_minimal_setup_with_gateway.png

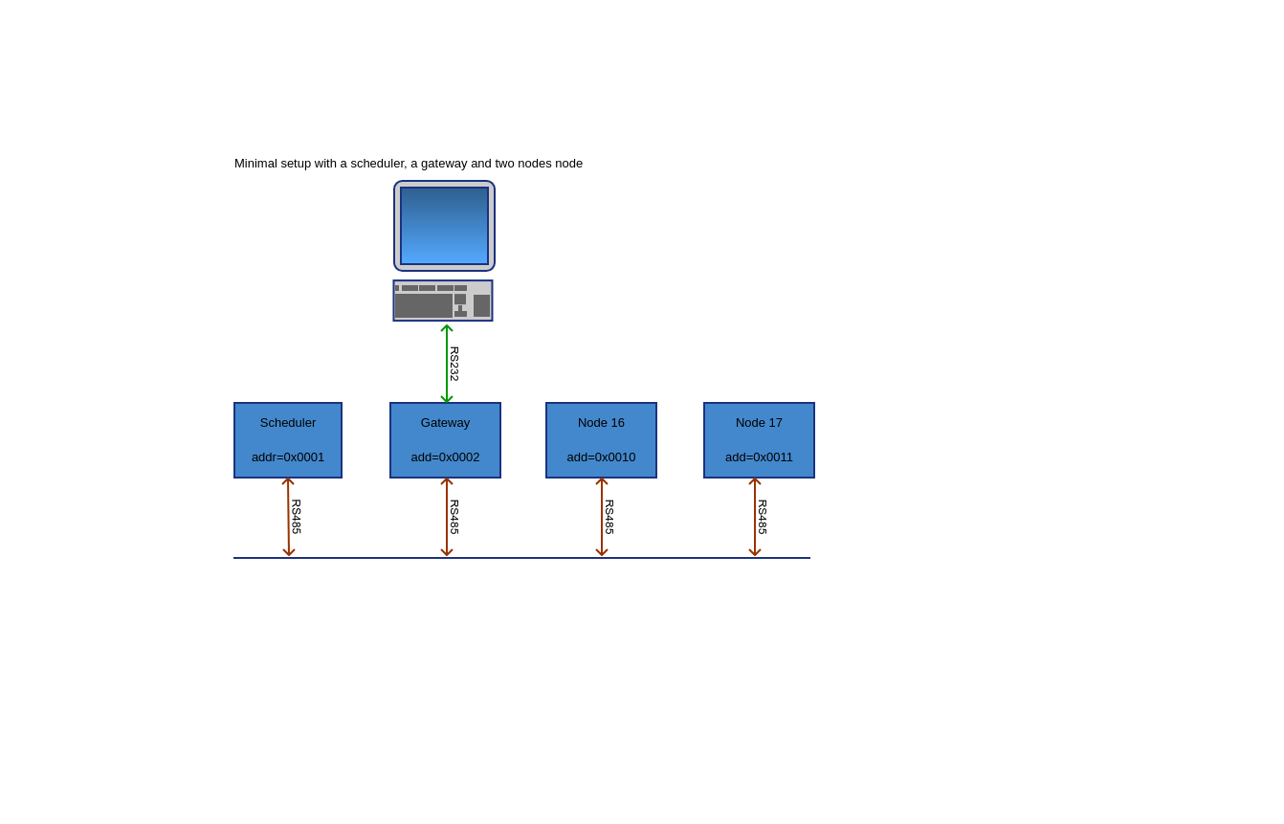
doc/drawings/02_minimal_setup_with_gateway.png
