irqmask/koewiba-domotic/hw/pi2-base/doc/errata.txt

Revision A:
-------------------
<n/a>

Revision B:
-------------------
- WAGO243 pin-holes are too tight
