irqmask/koewiba-domotic/hw/motor_switch_3pole/doc/errata.txt

motor-switch-3pole

Revision 1
- Relay Pins totally mixed up in footprint!
