irqmask/koewiba-domotic/(threads)

Thread 2 (2019-04-19):

wallclock stops when controller goes into sleepmode

irqmask, 2019-04-19:

irqmask, 2019-04-23:
Solved. Modules which need the time to wake the controller from sleepmode shall place a "#define TIMER_WAKEUP 1" definition in appconfig.h

Closed 2019-04-23.
