irqmask/koewiba-domotic/hw/roomthermostat/roomthermostat.pdf

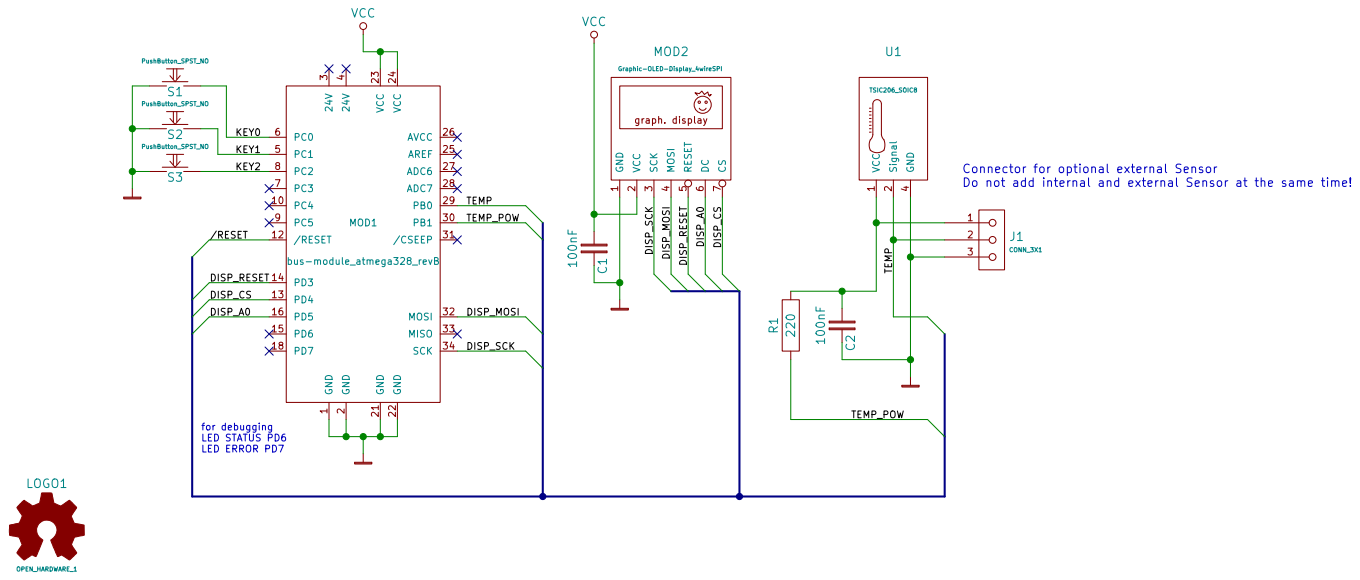
[picture p26: page 1]

2 GND 21 GND 22 VCC 23 VCC 24 AREF

Id: 1/1 Title: roomthermostat File: roomthermostat.kicad_sch Sheet: / koewiba
