irqmask/koewiba-domotic/hw/heatervalve-interface/heatervalve-interface.pdf

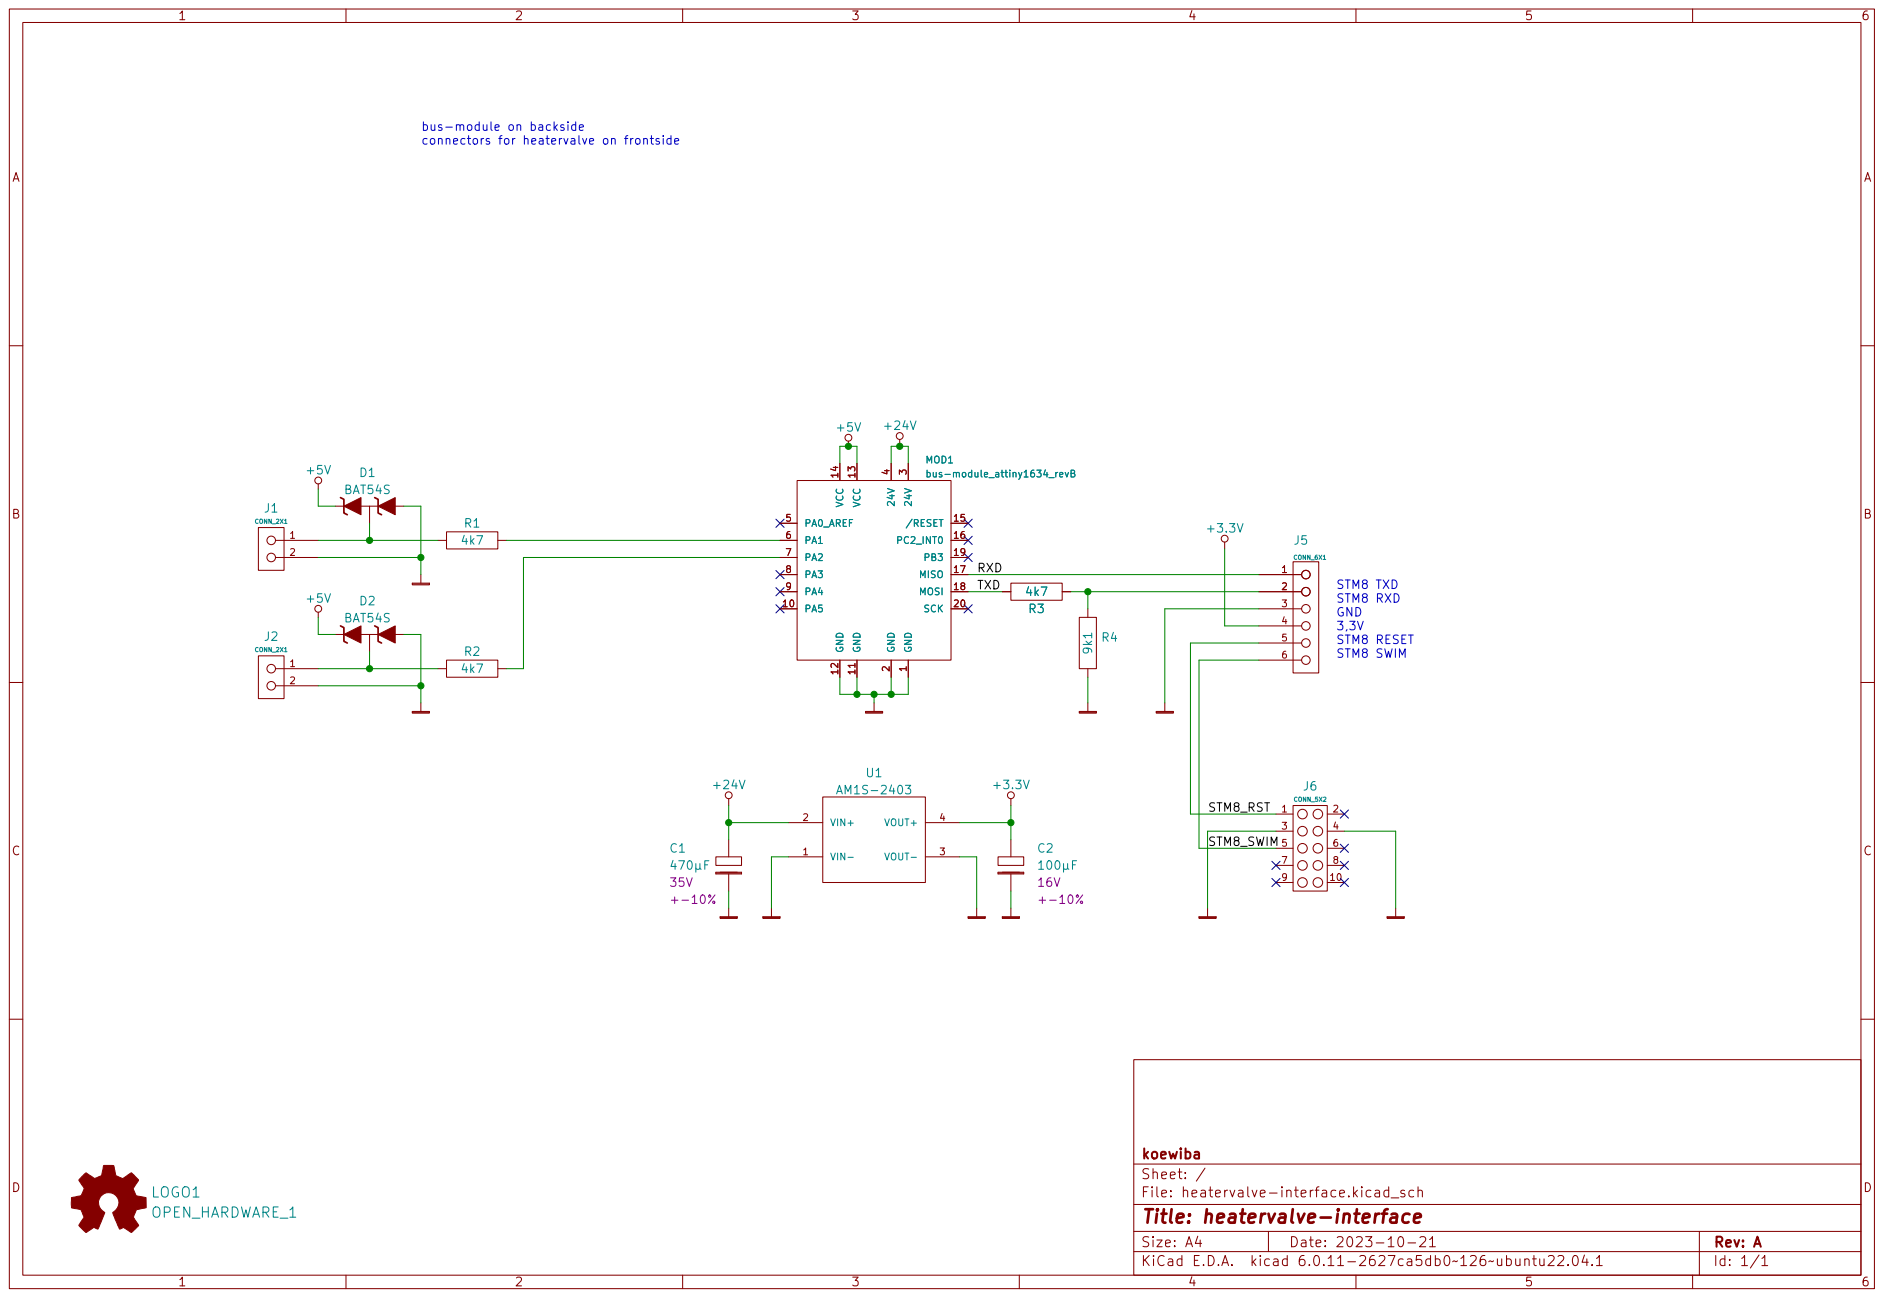
[picture p27: page 1]

Id: 1/1 Title: heatervalve-interface
