irqmask/koewiba-domotic/hw/heatervalve/heatervalve.pdf

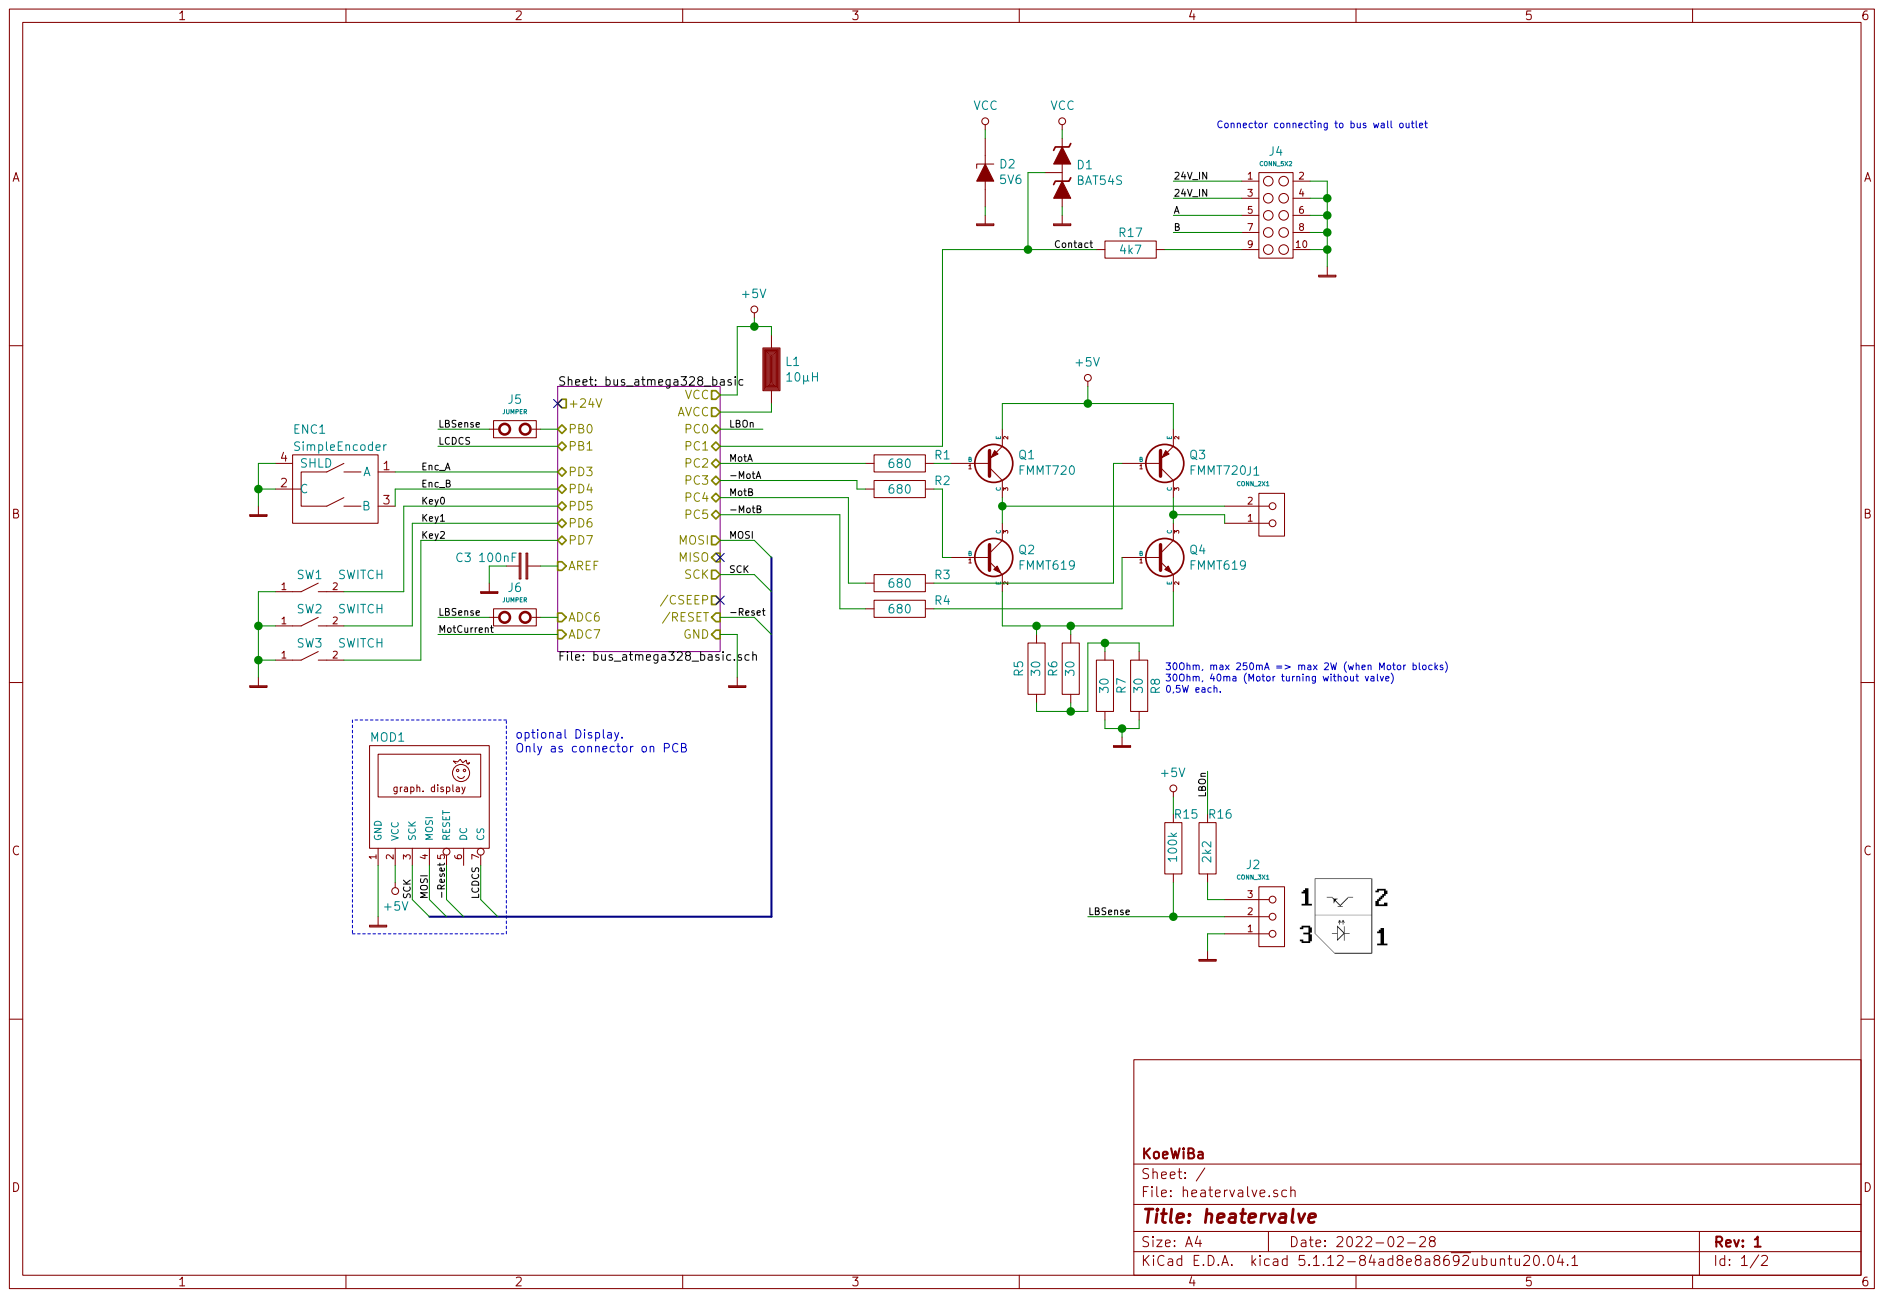
[picture p28: page 1]

Connector connecting to bus wall outlet

30Ohm, max 250mA => max 2W (when Motor blocks) 30Ohm, 40ma (Motor turning without valve) 0,5W each.

optional Display.
Only as connector on PCB

File: heatervalve.sch Sheet: / KoeWiBa

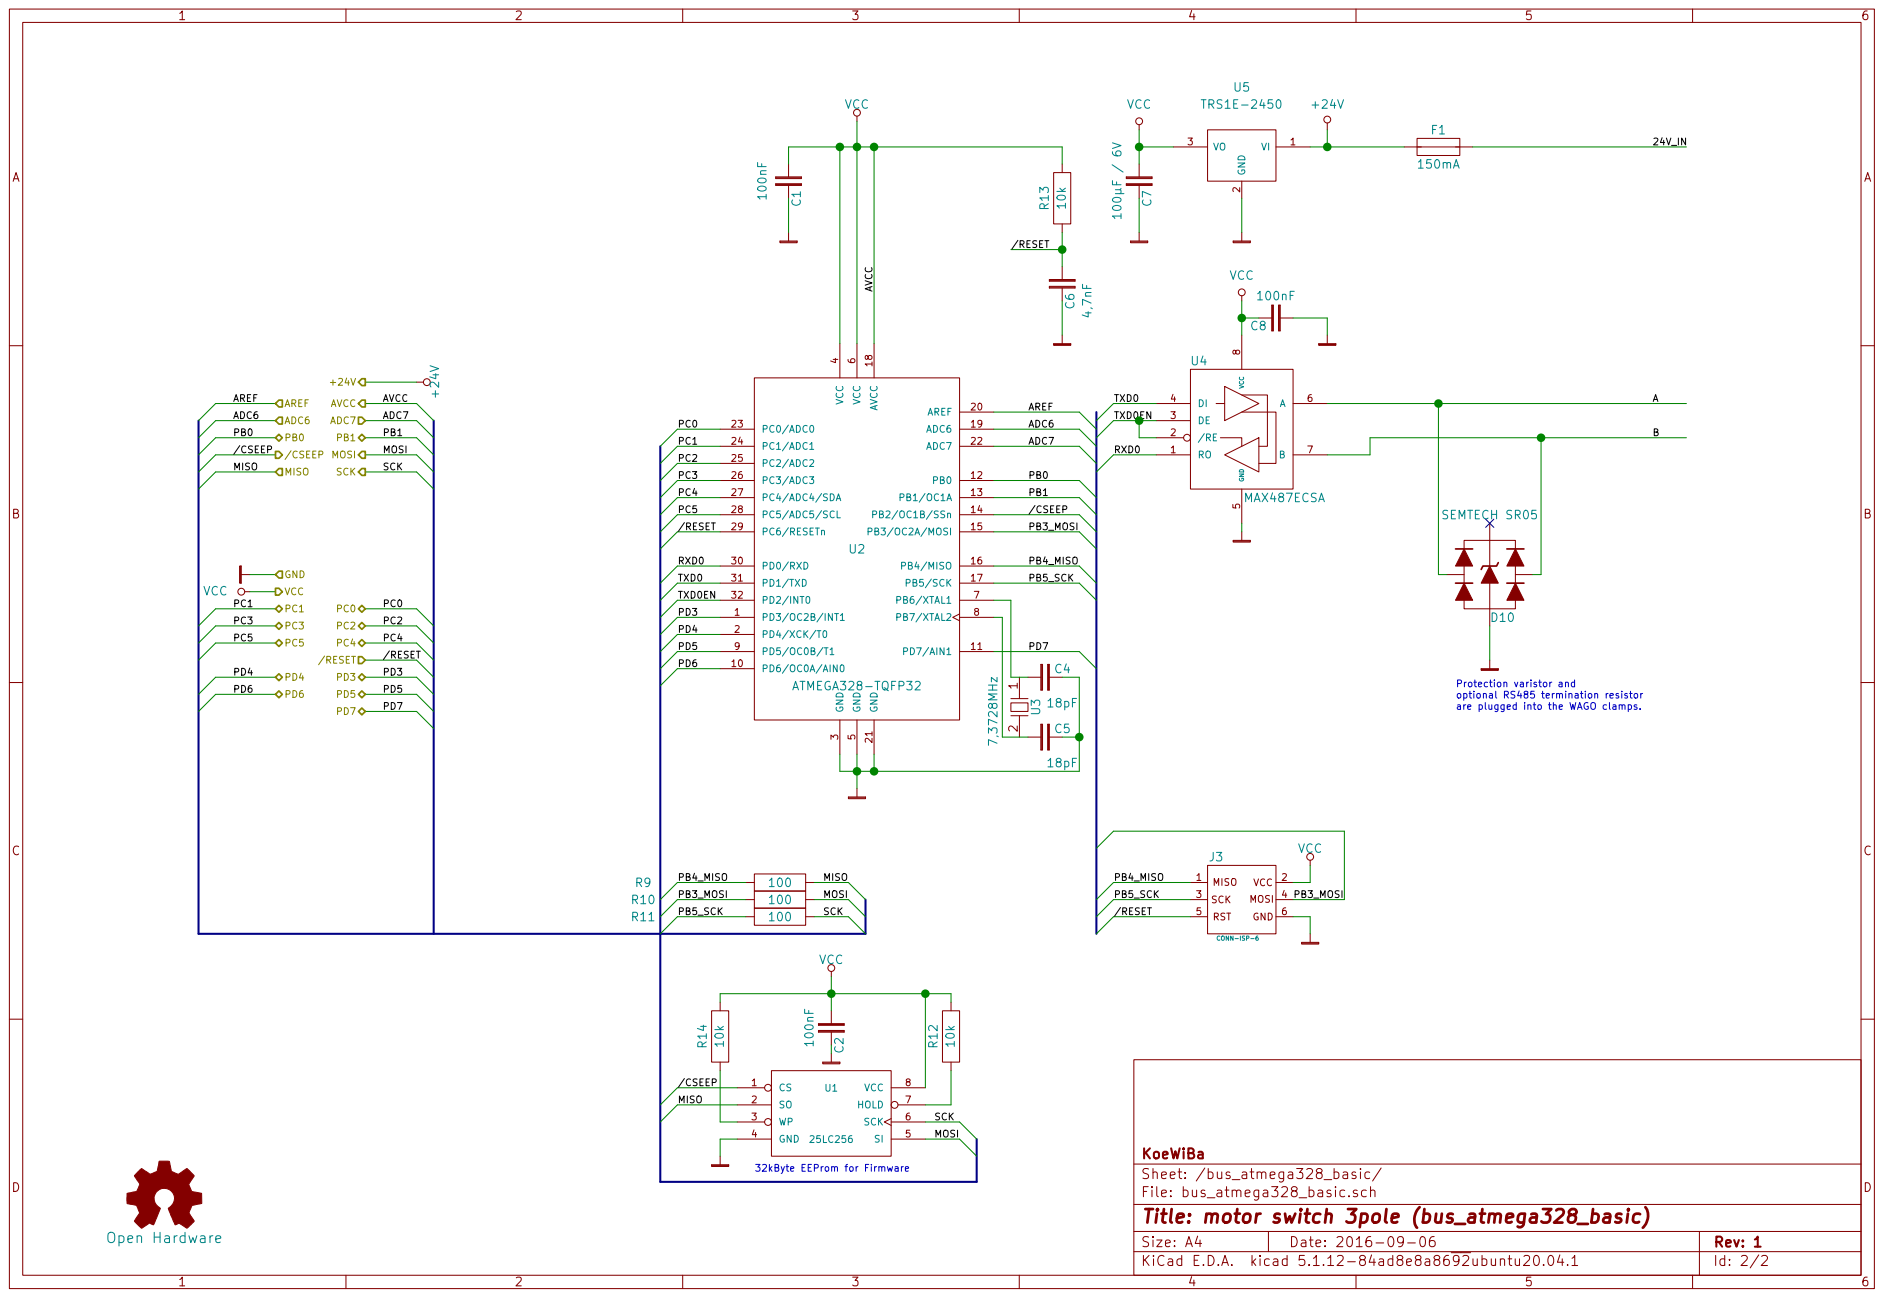
[picture p29: page 2]

Protection varistor and
optional RS485 termination resistor are plugged into the WAGO clamps.

File: bus_atmega328_basic.sch
Id: 2/2 Title: motor switch 3pole (bus_atmega328_basic)
