irqmask/koewiba-domotic/hw/switch_3pole_5x/switch_3pole_5x.pdf

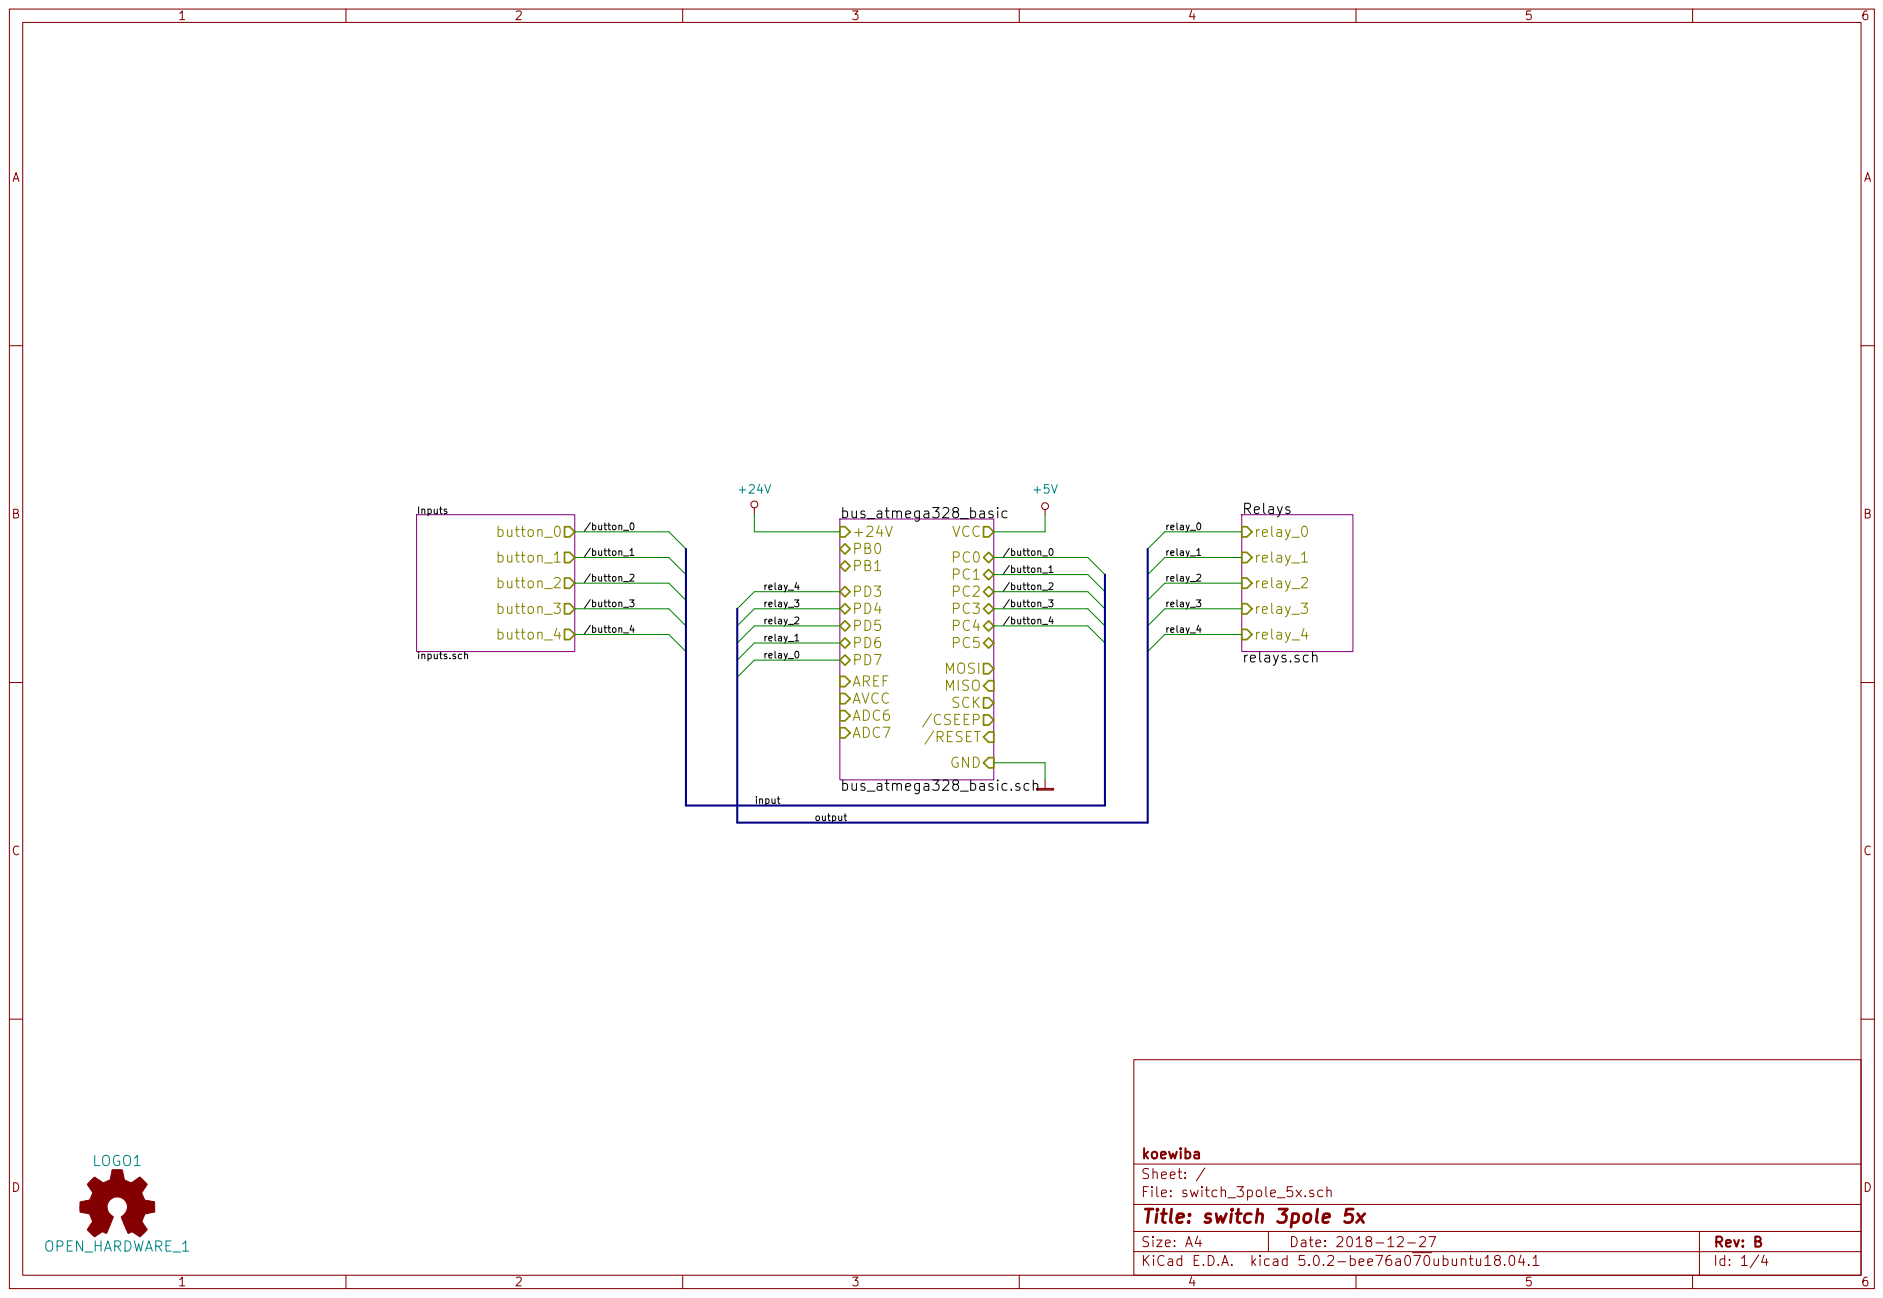
[picture p30: page 1]

File: switch_3pole_5x.sch Sheet: / koewiba

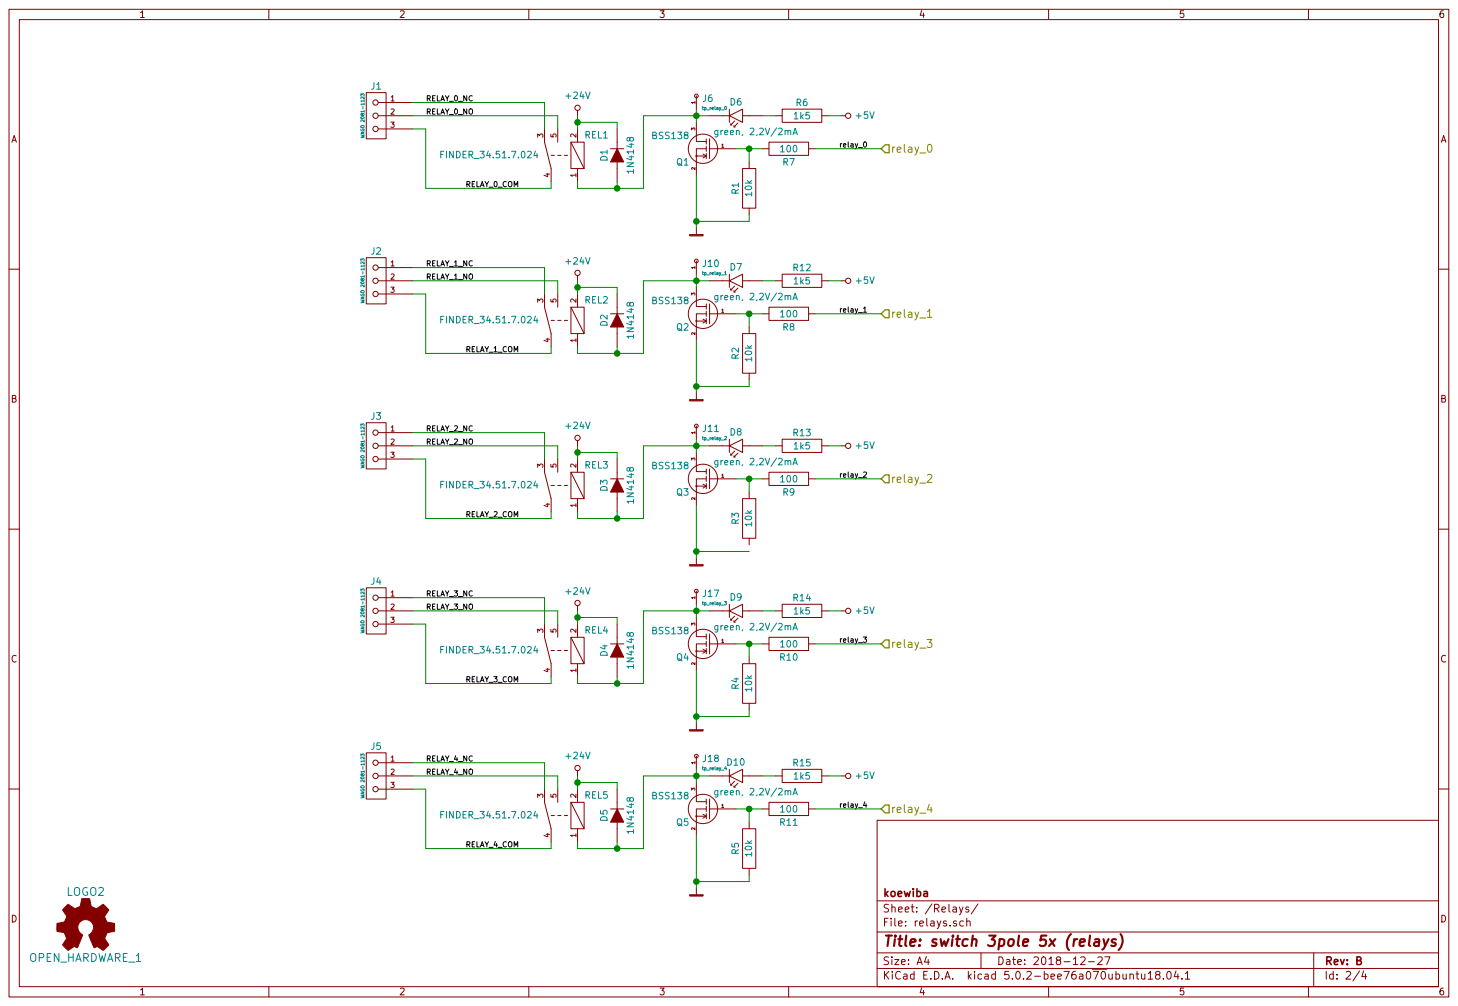
[picture p31: page 2]

File: relays.sch
Id: 2/4 Title: switch 3pole 5x (relays)

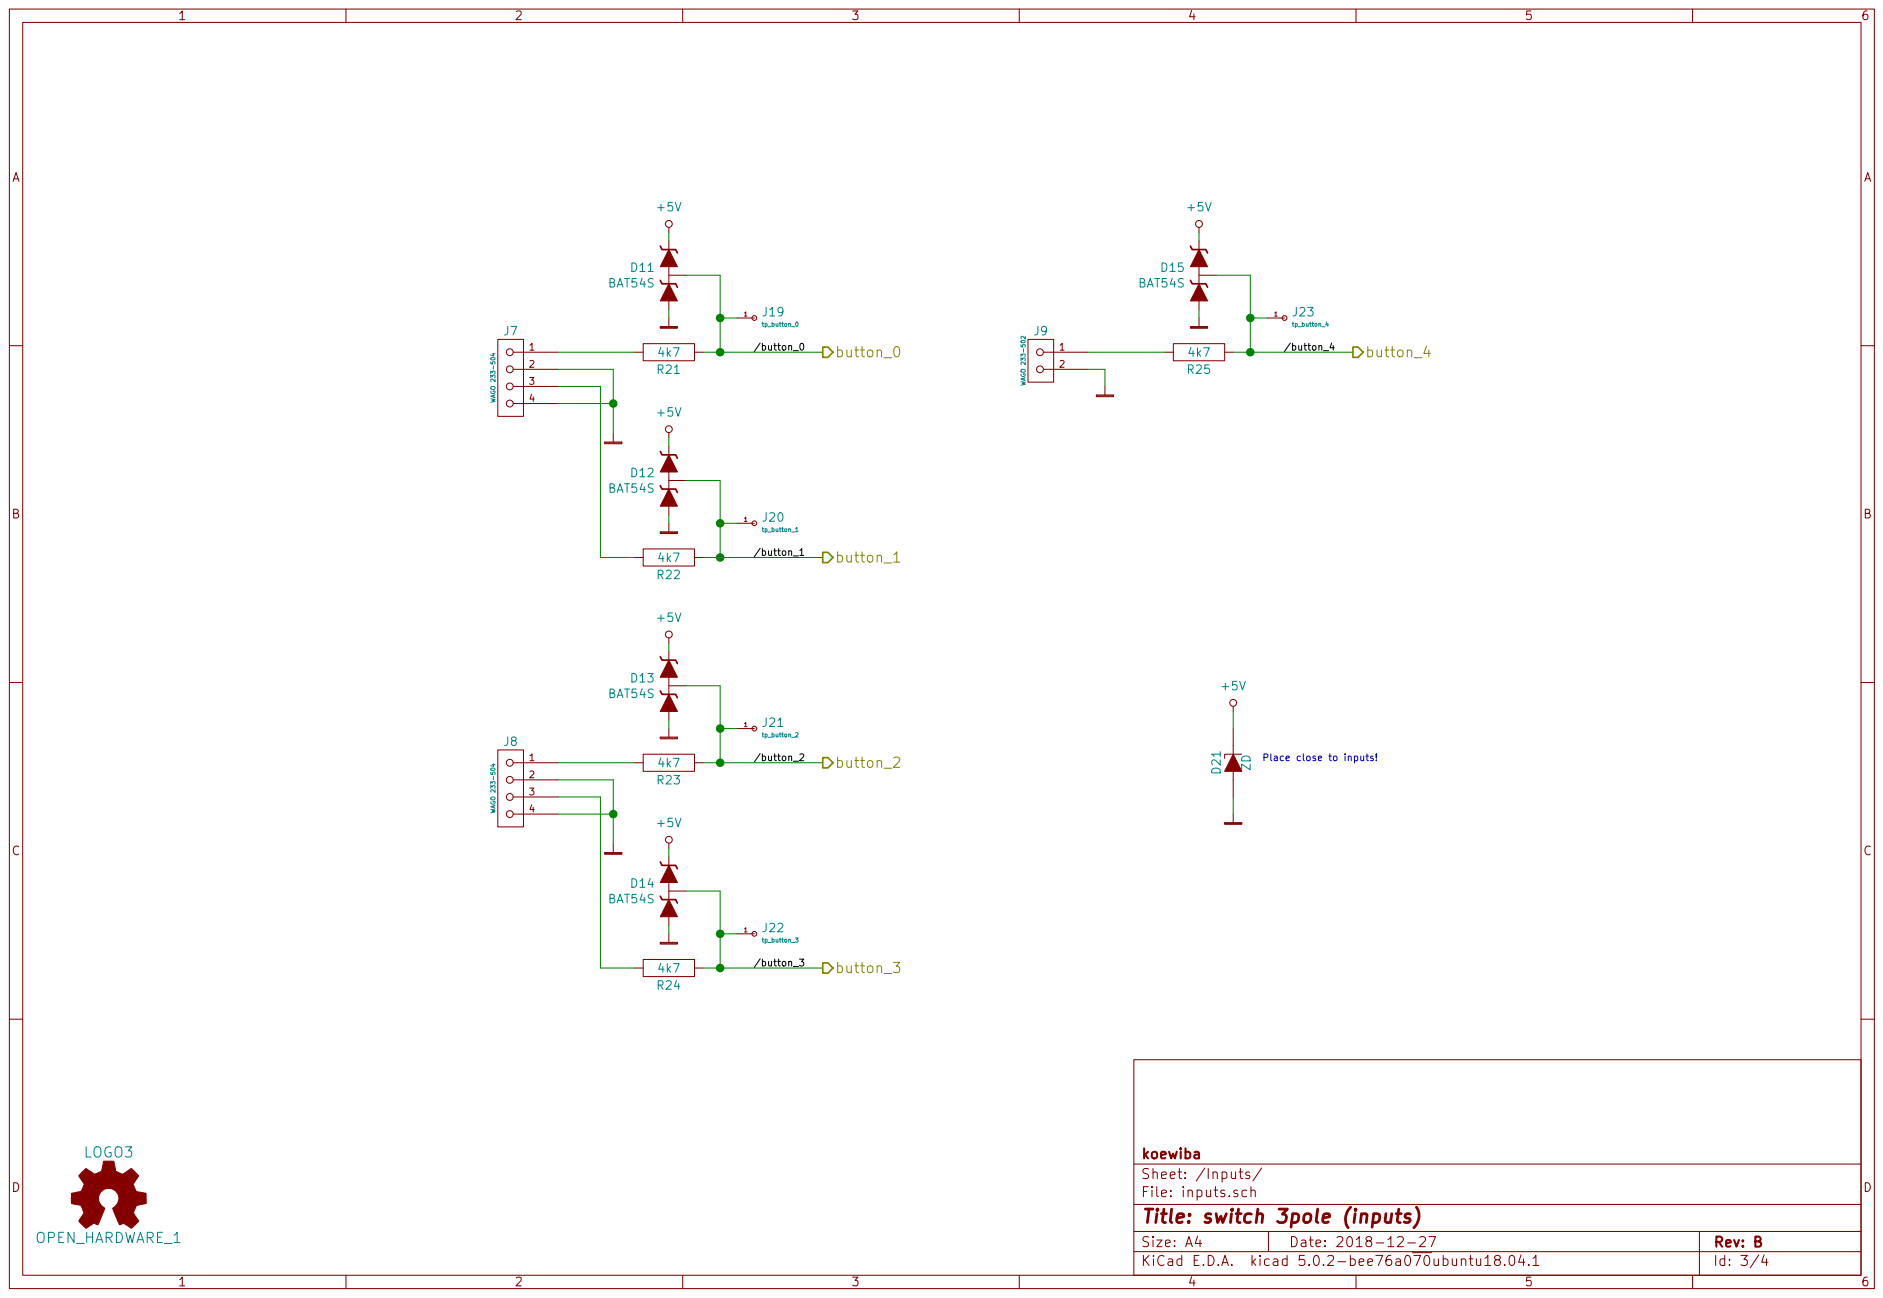
[picture p32: page 3]

Place close to inputs!

File: inputs.sch
Id: 3/4 Title: switch 3pole (inputs)

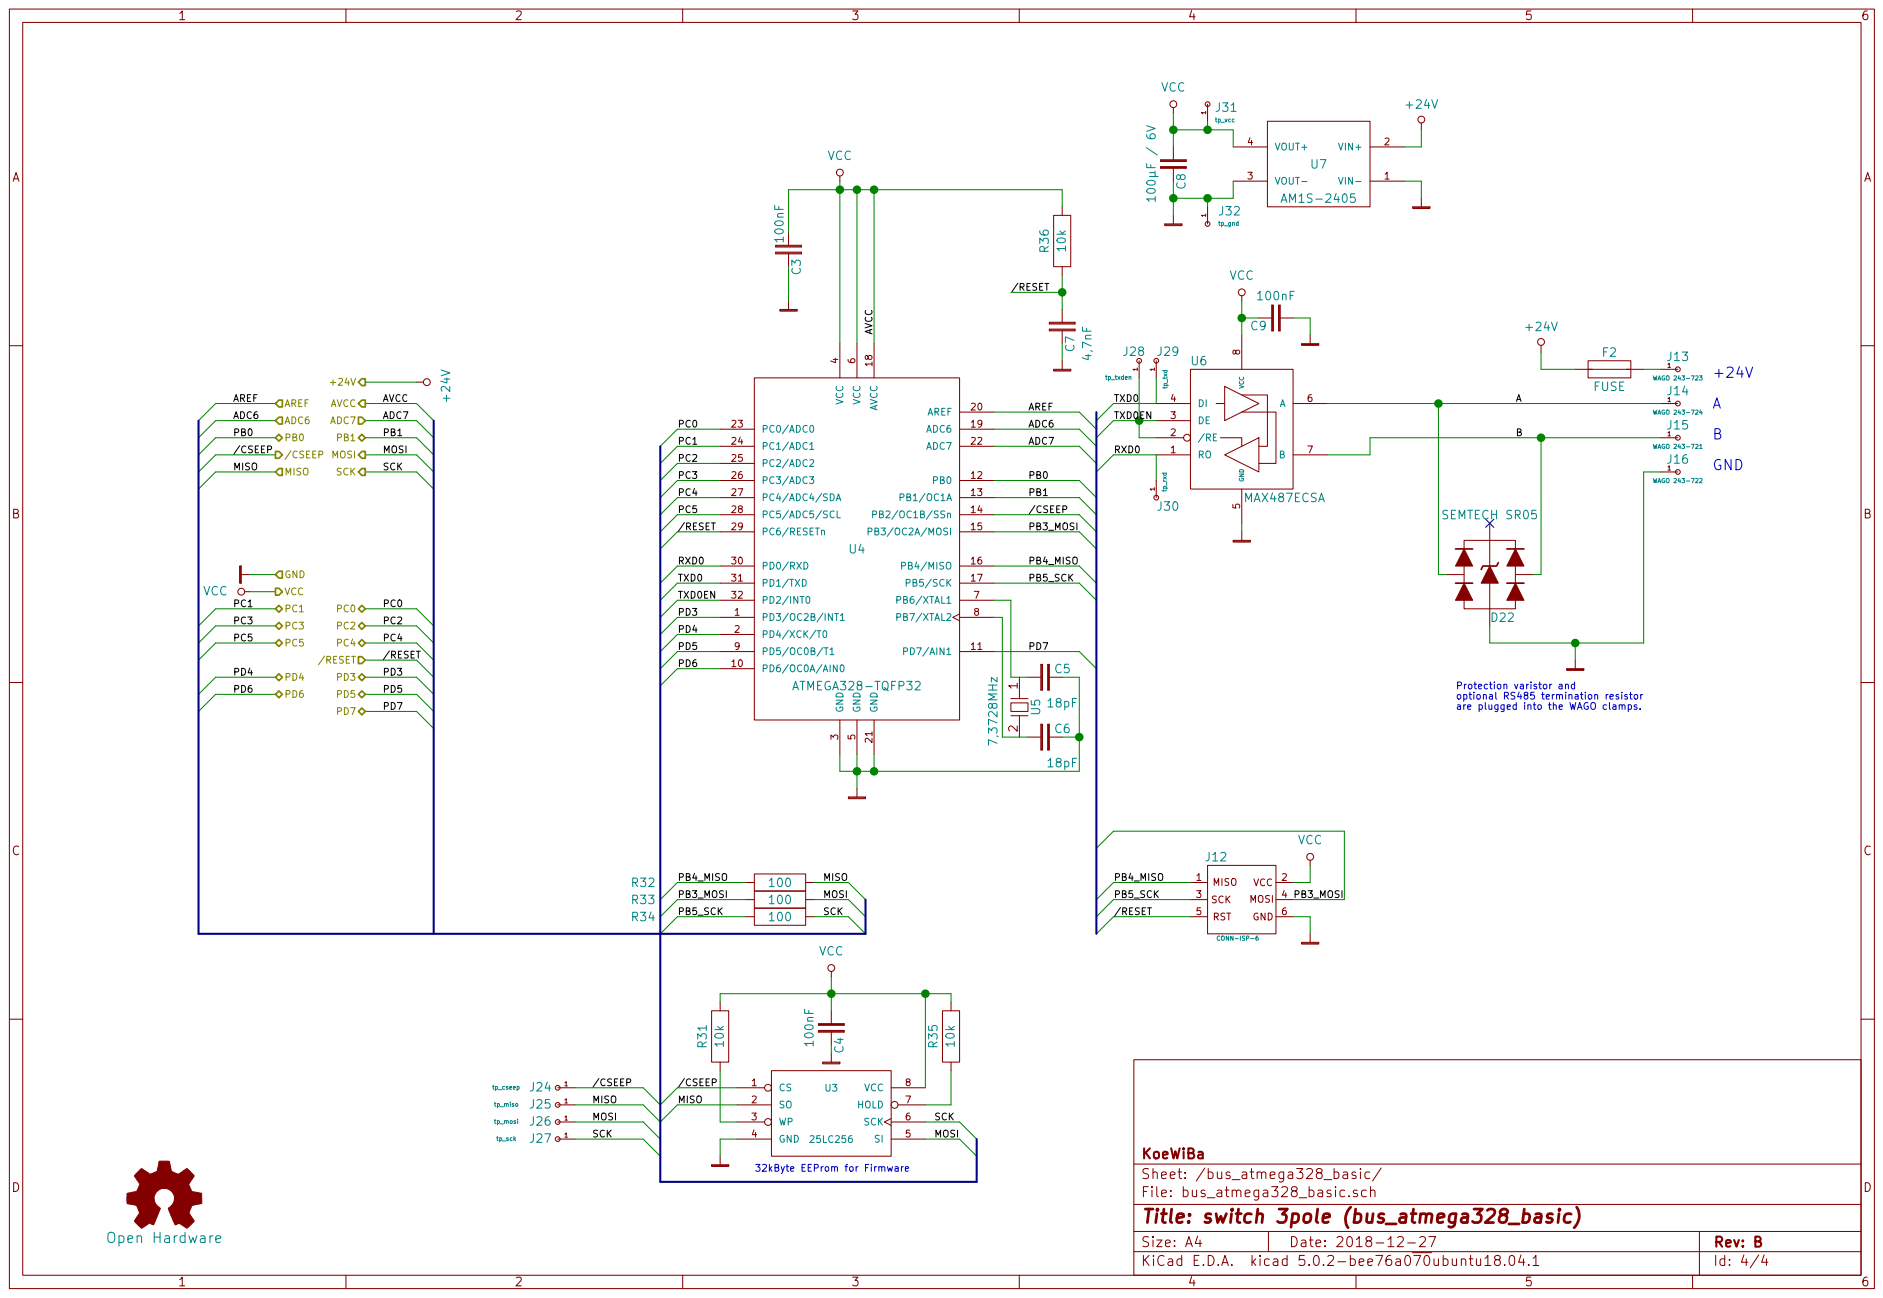
[picture p33: page 4]

optional RS485 termination resistor are plugged into the WAGO clamps. D22 SEMTECH SR05 VCC

/CSEEP MISO MOSI SCK
