irqmask/koewiba-domotic/hw/bus-module_attiny1634/bus-module_attiny1634.pdf

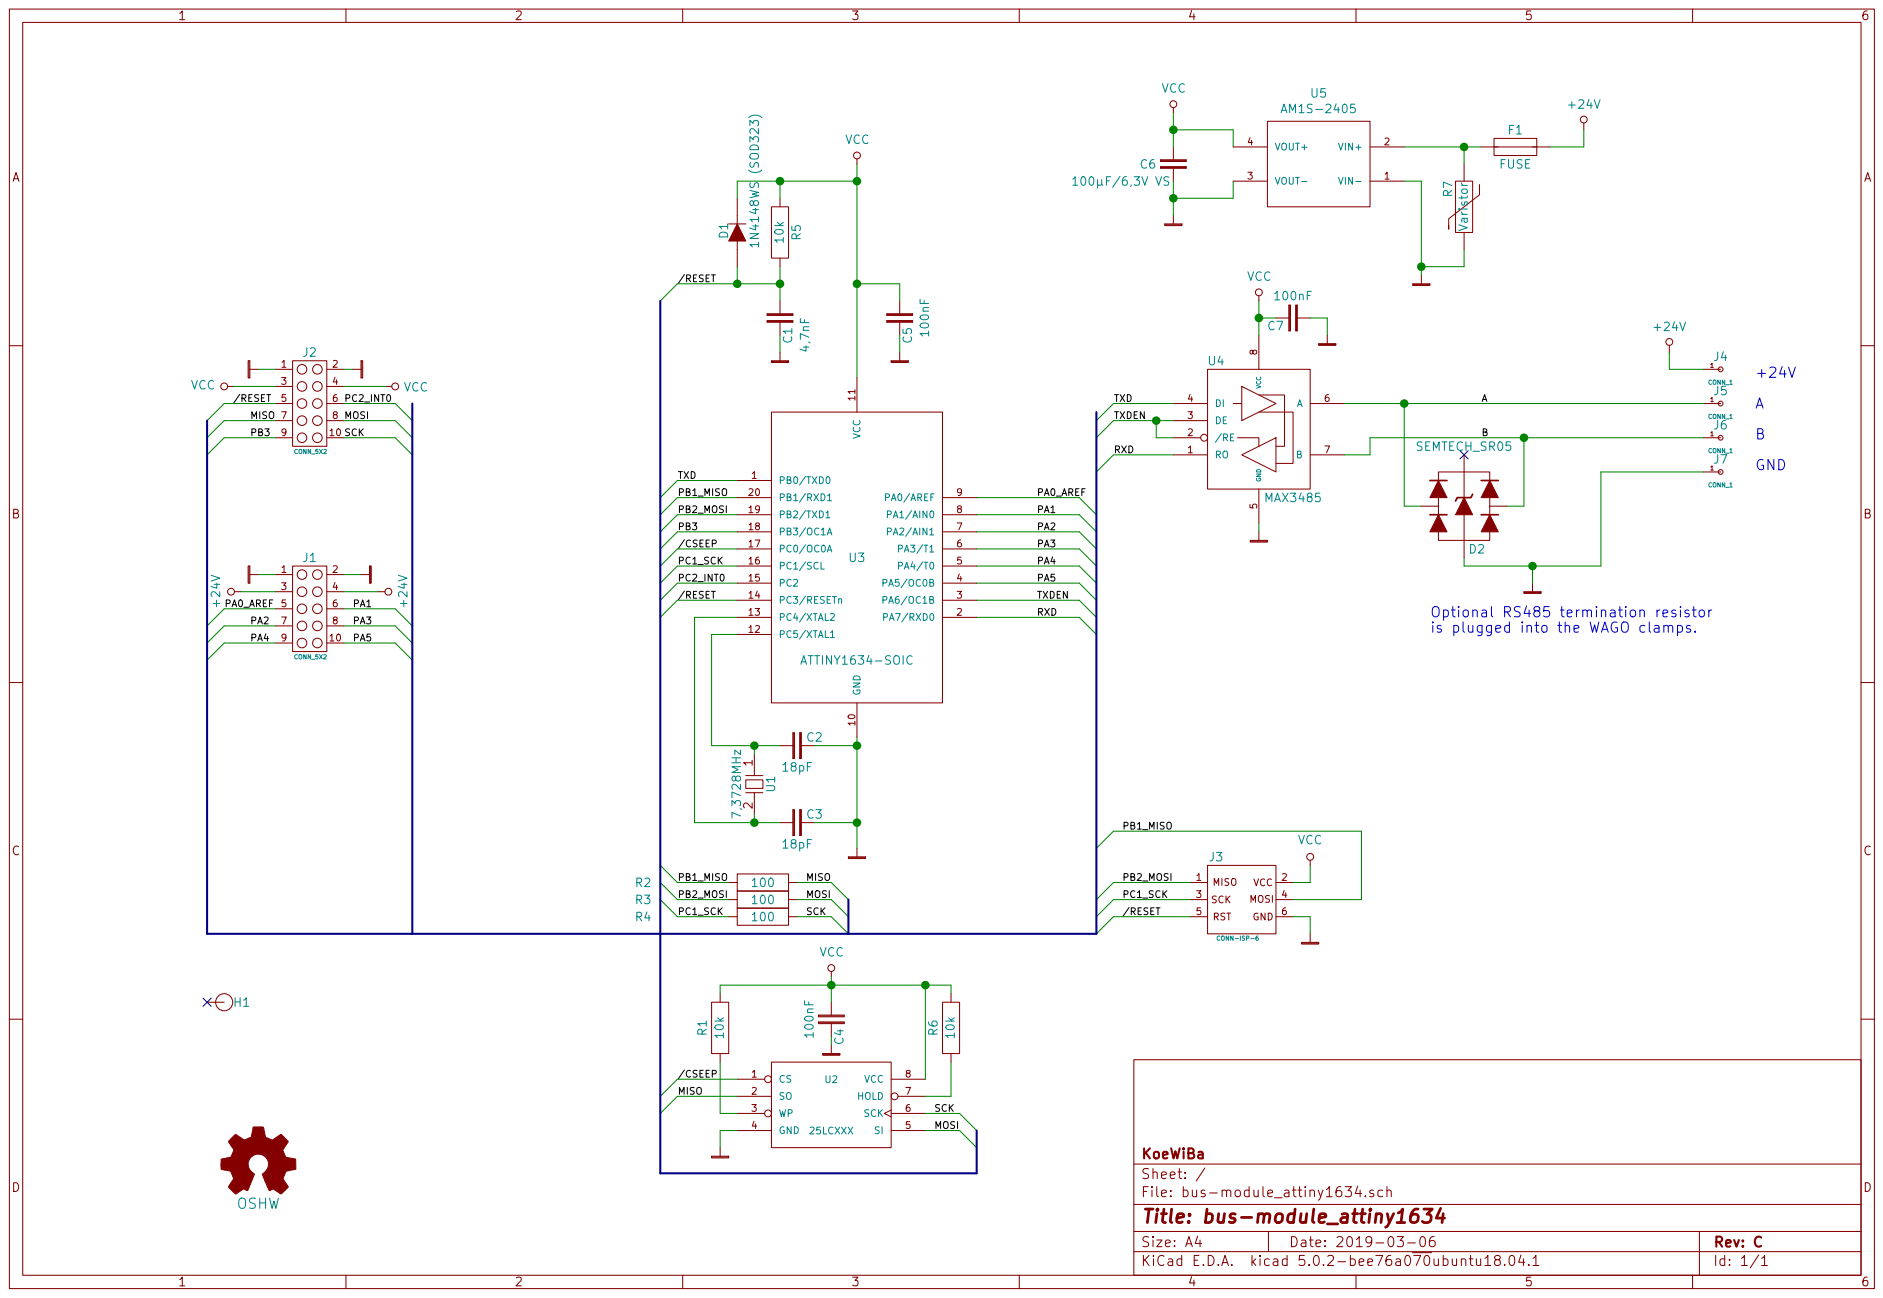
[picture p34: page 1]

Optional RS485 termination resistor
is plugged into the WAGO clamps.

File: bus-module_attiny1634.sch Sheet: / KoeWiBa
