irqmask/koewiba-domotic/hw/motor_switch_3pole_5x/motor_switch_3pole_5x.pdf

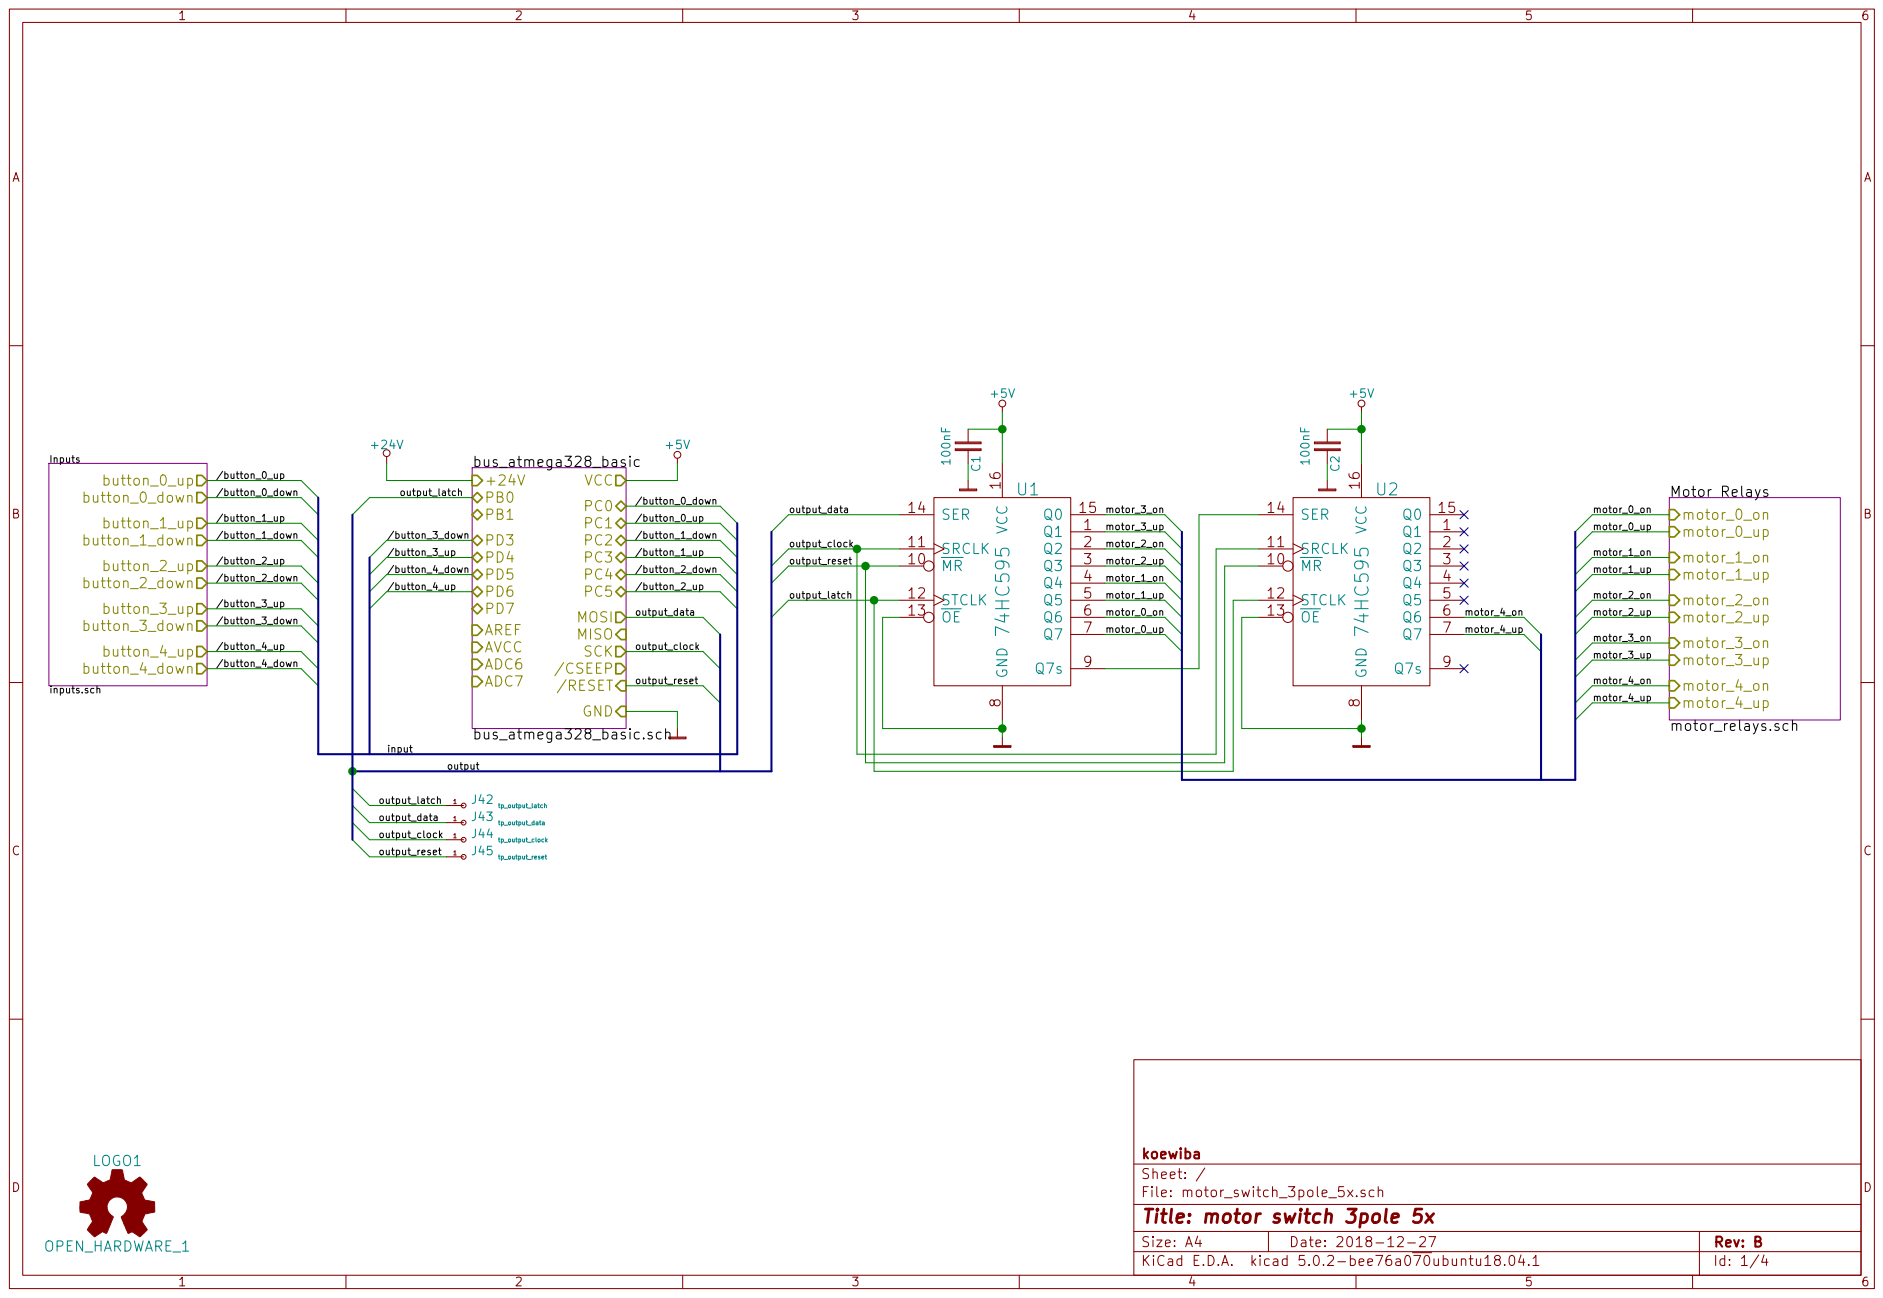
[picture p35: page 1]

8 Q7s 9 MR 10 SRCLK 11 STCLK 12 OE 13 SER 14 Q0 15 VCC 16 U1 74HC595 C2100nF C1100nF

8 Q7s 9 MR 10 SRCLK 11 STCLK 12 OE 13 SER 14 Q0 15 VCC 16 U2 74HC595

File: motor_switch_3pole_5x.sch Sheet: / koewiba

Id: 1/4 Title: motor switch 3pole 5x

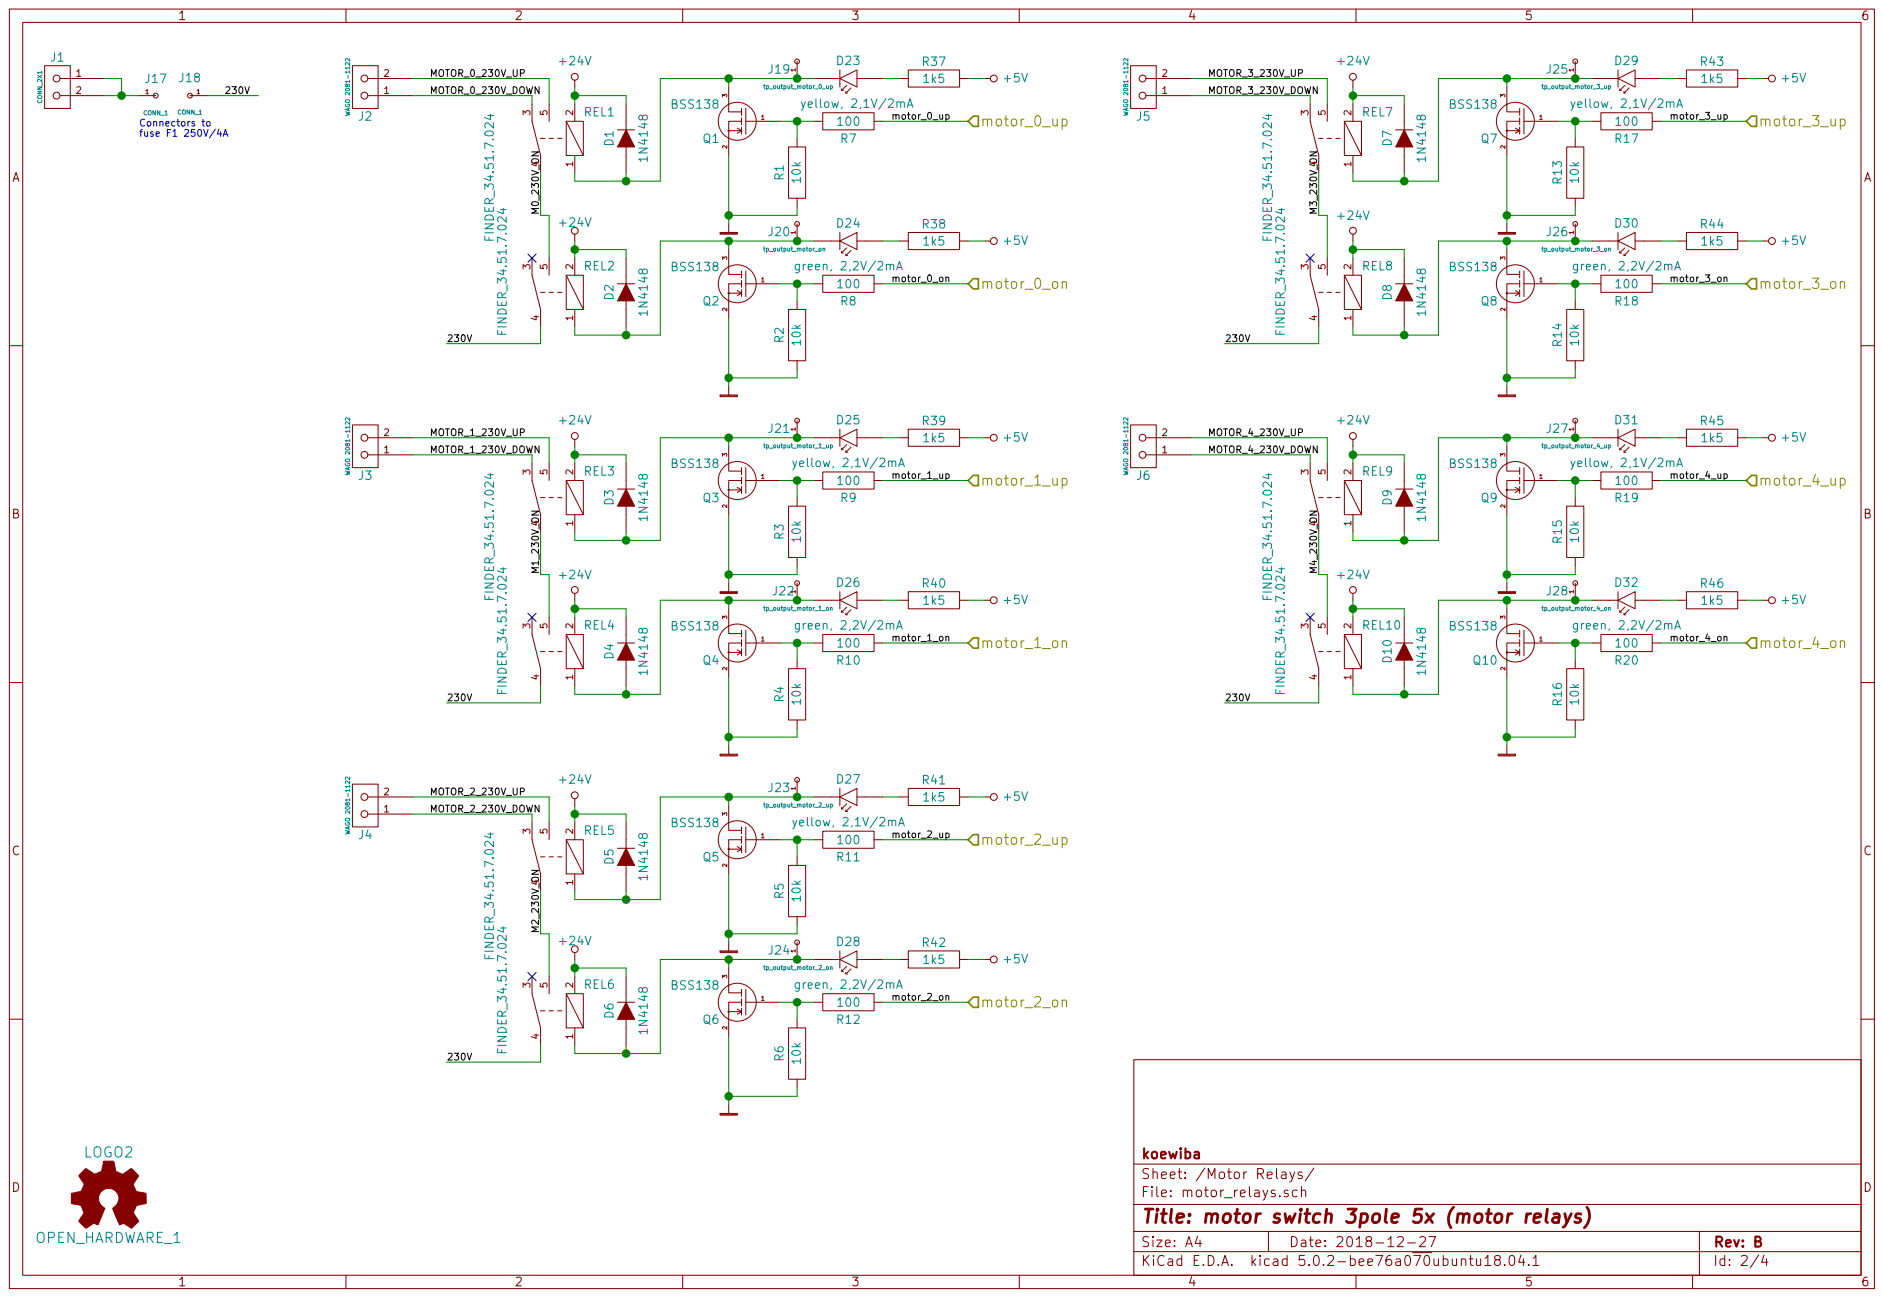
[picture p36: page 2]

Sheet: /Motor Relays/ koewiba

File: motor_relays.sch
Id: 2/4 Title: motor switch 3pole 5x (motor relays)

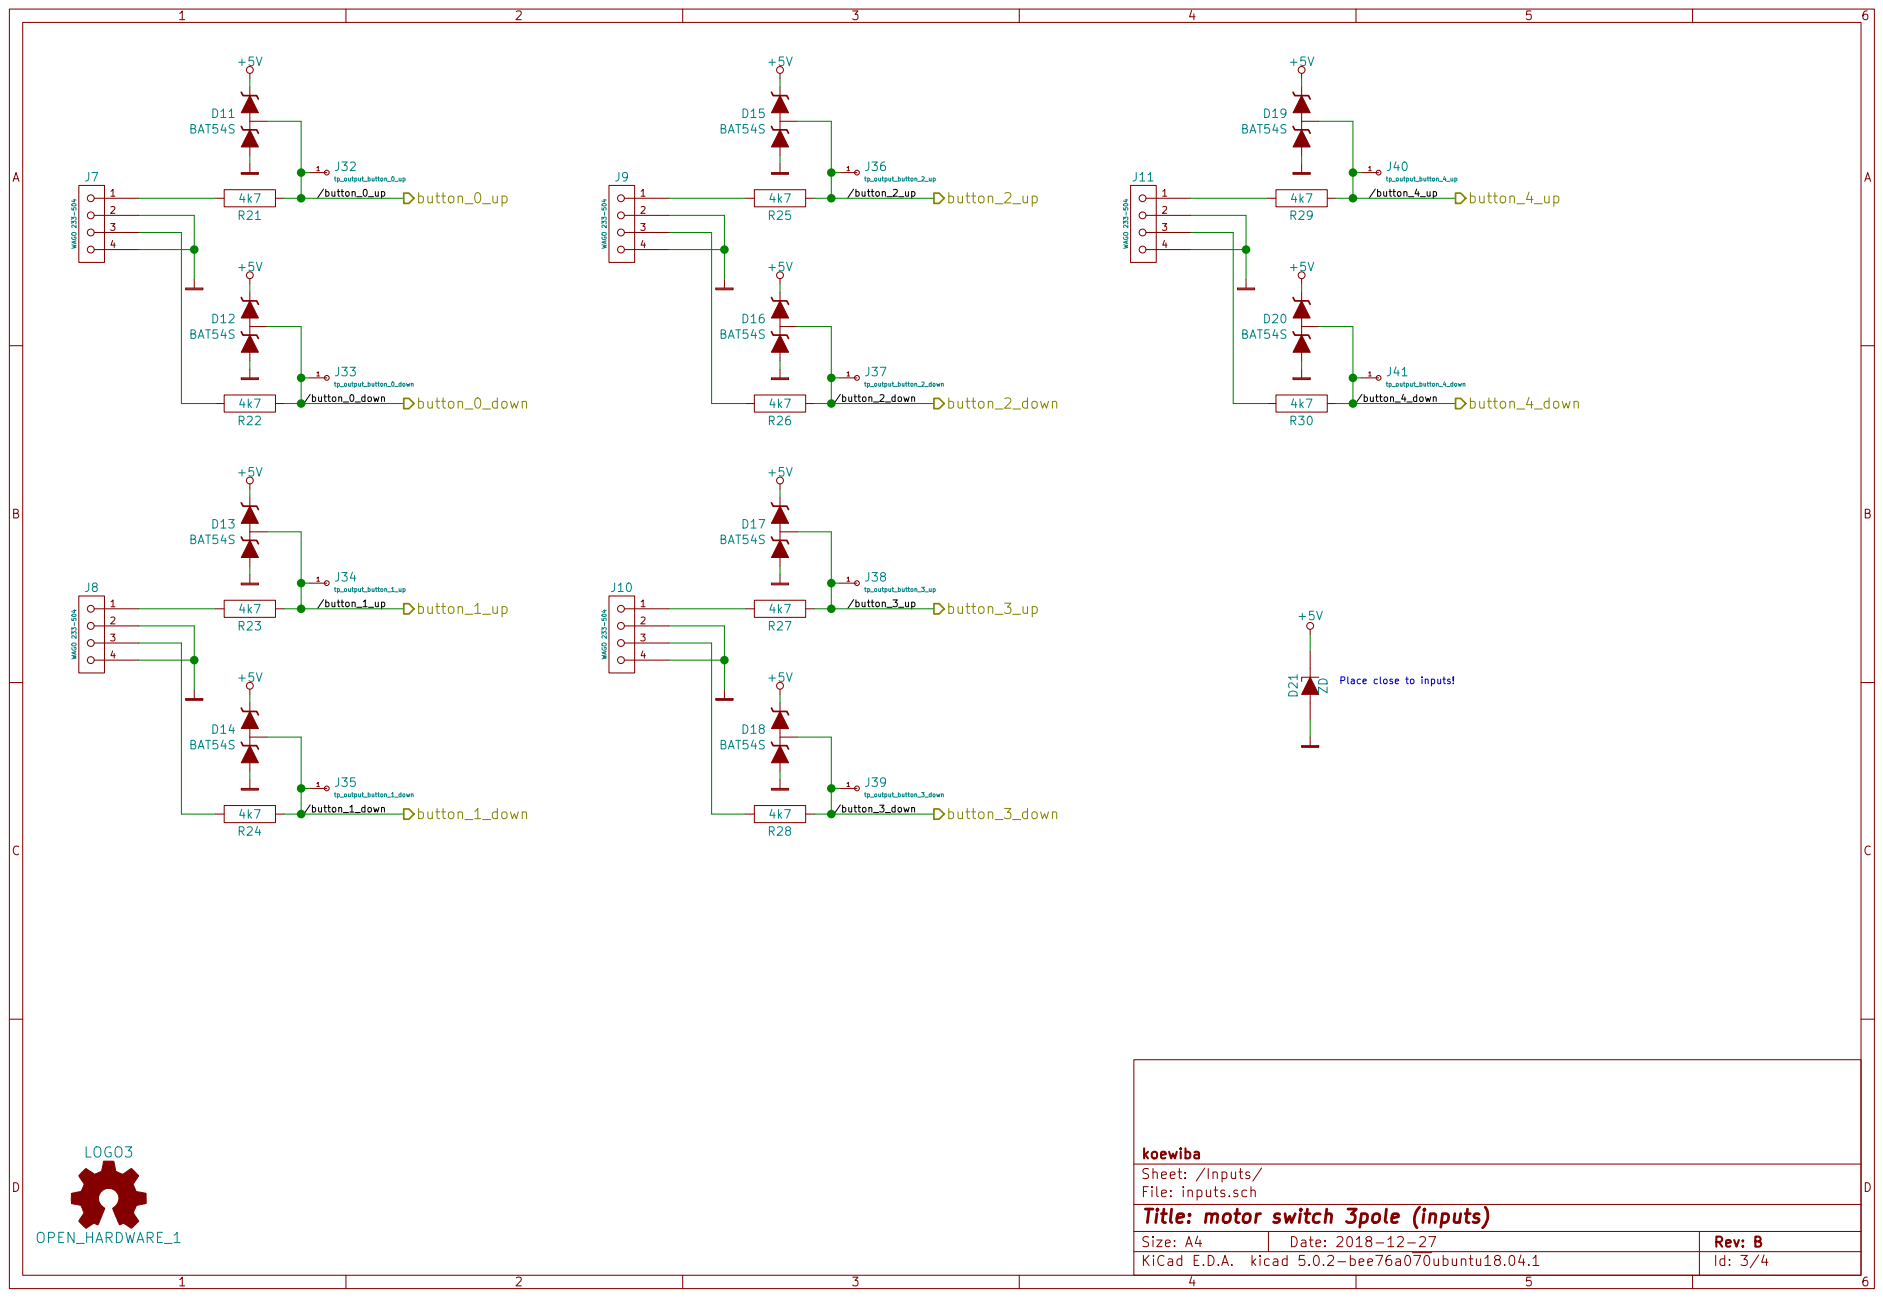
[picture p37: page 3]

Place close to inputs!

File: inputs.sch
Id: 3/4 Title: motor switch 3pole (inputs)

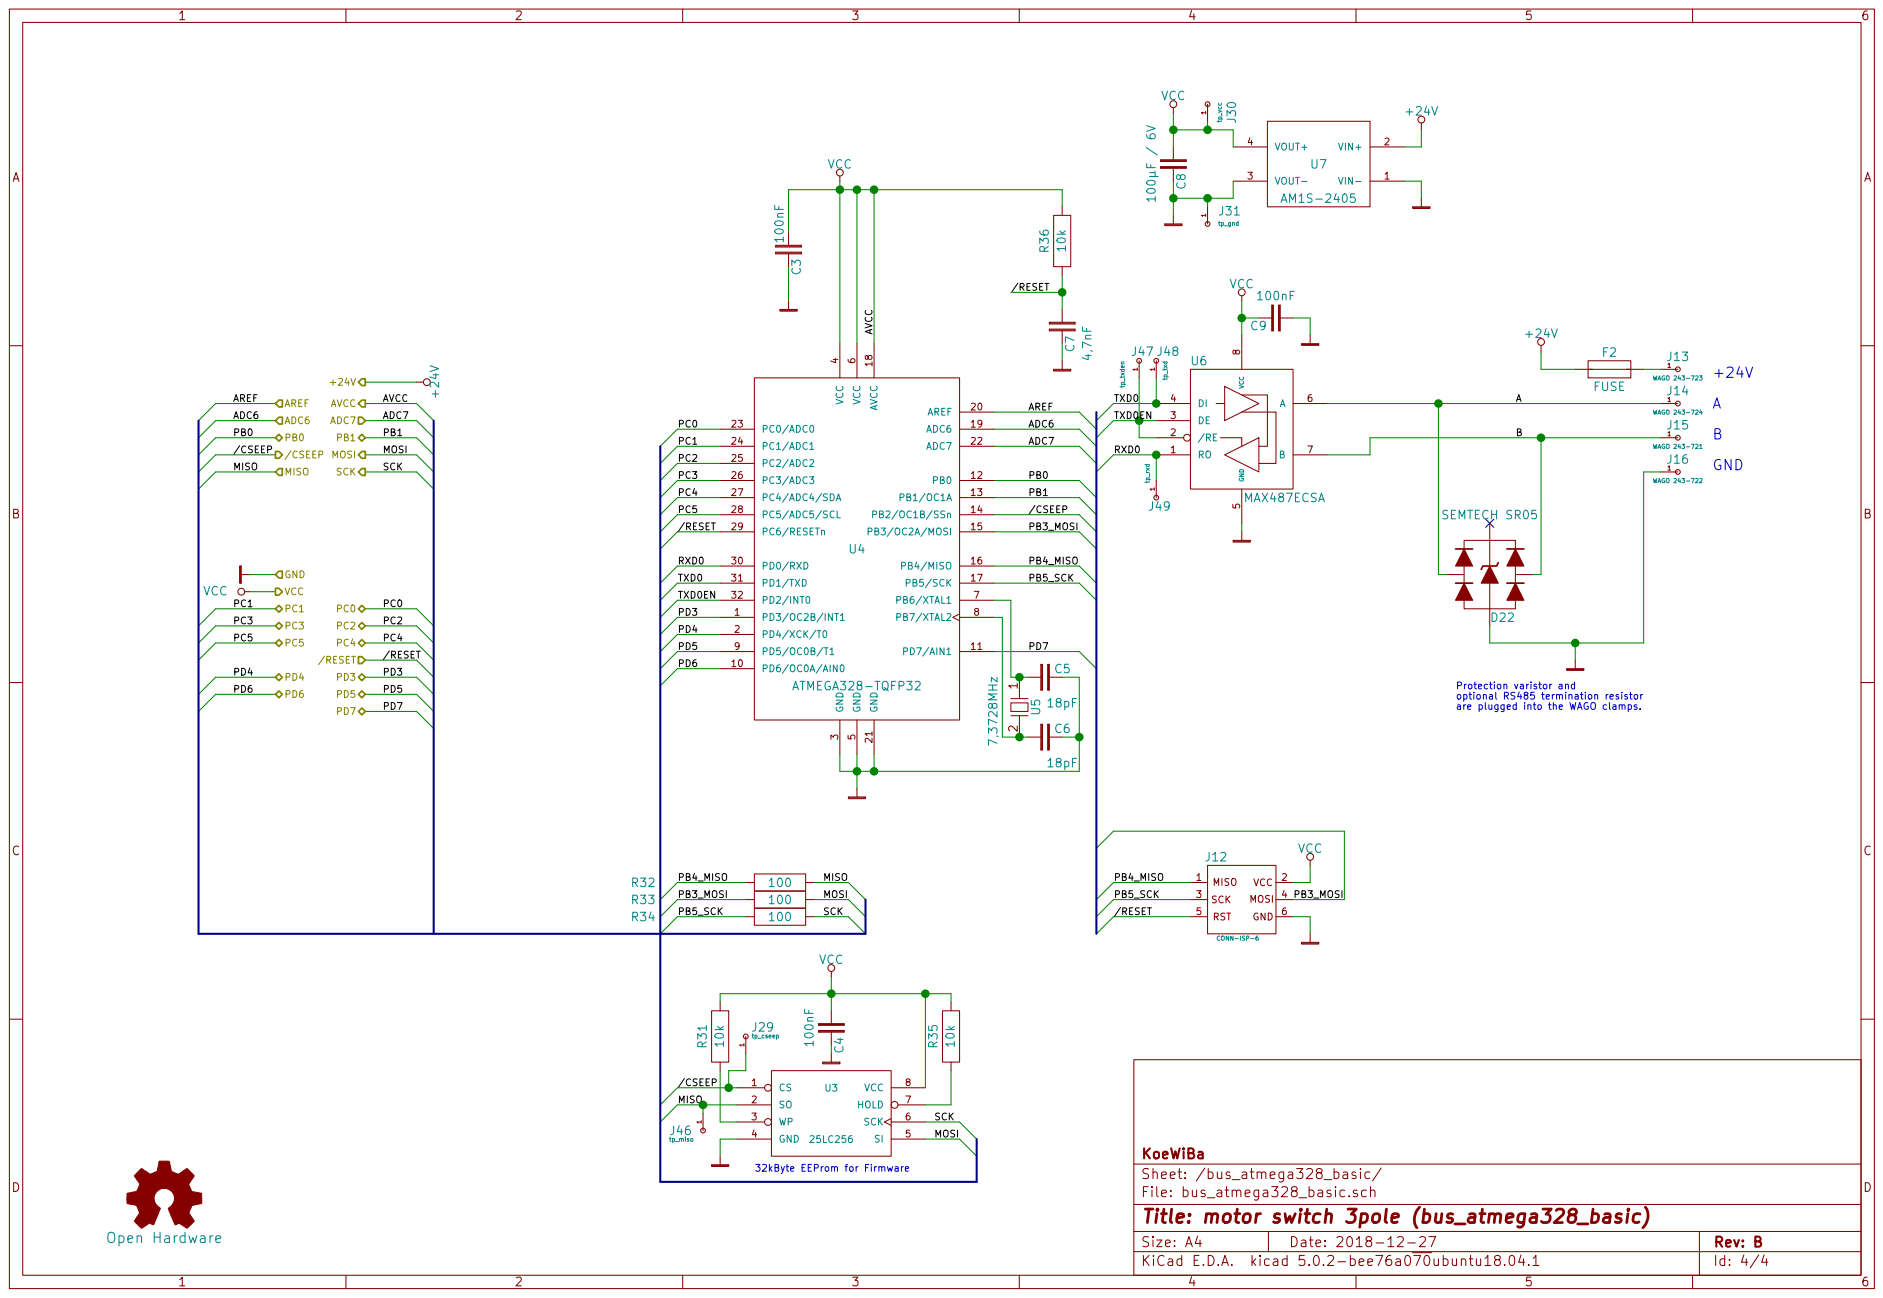
[picture p38: page 4]

optional RS485 termination resistor are plugged into the WAGO clamps. D22 SEMTECH SR05 VCC

File: bus_atmega328_basic.sch
Id: 4/4 Title: motor switch 3pole (bus_atmega328_basic)
