irqmask/koewiba-domotic/hw/pi2-base/pi2-base.pdf

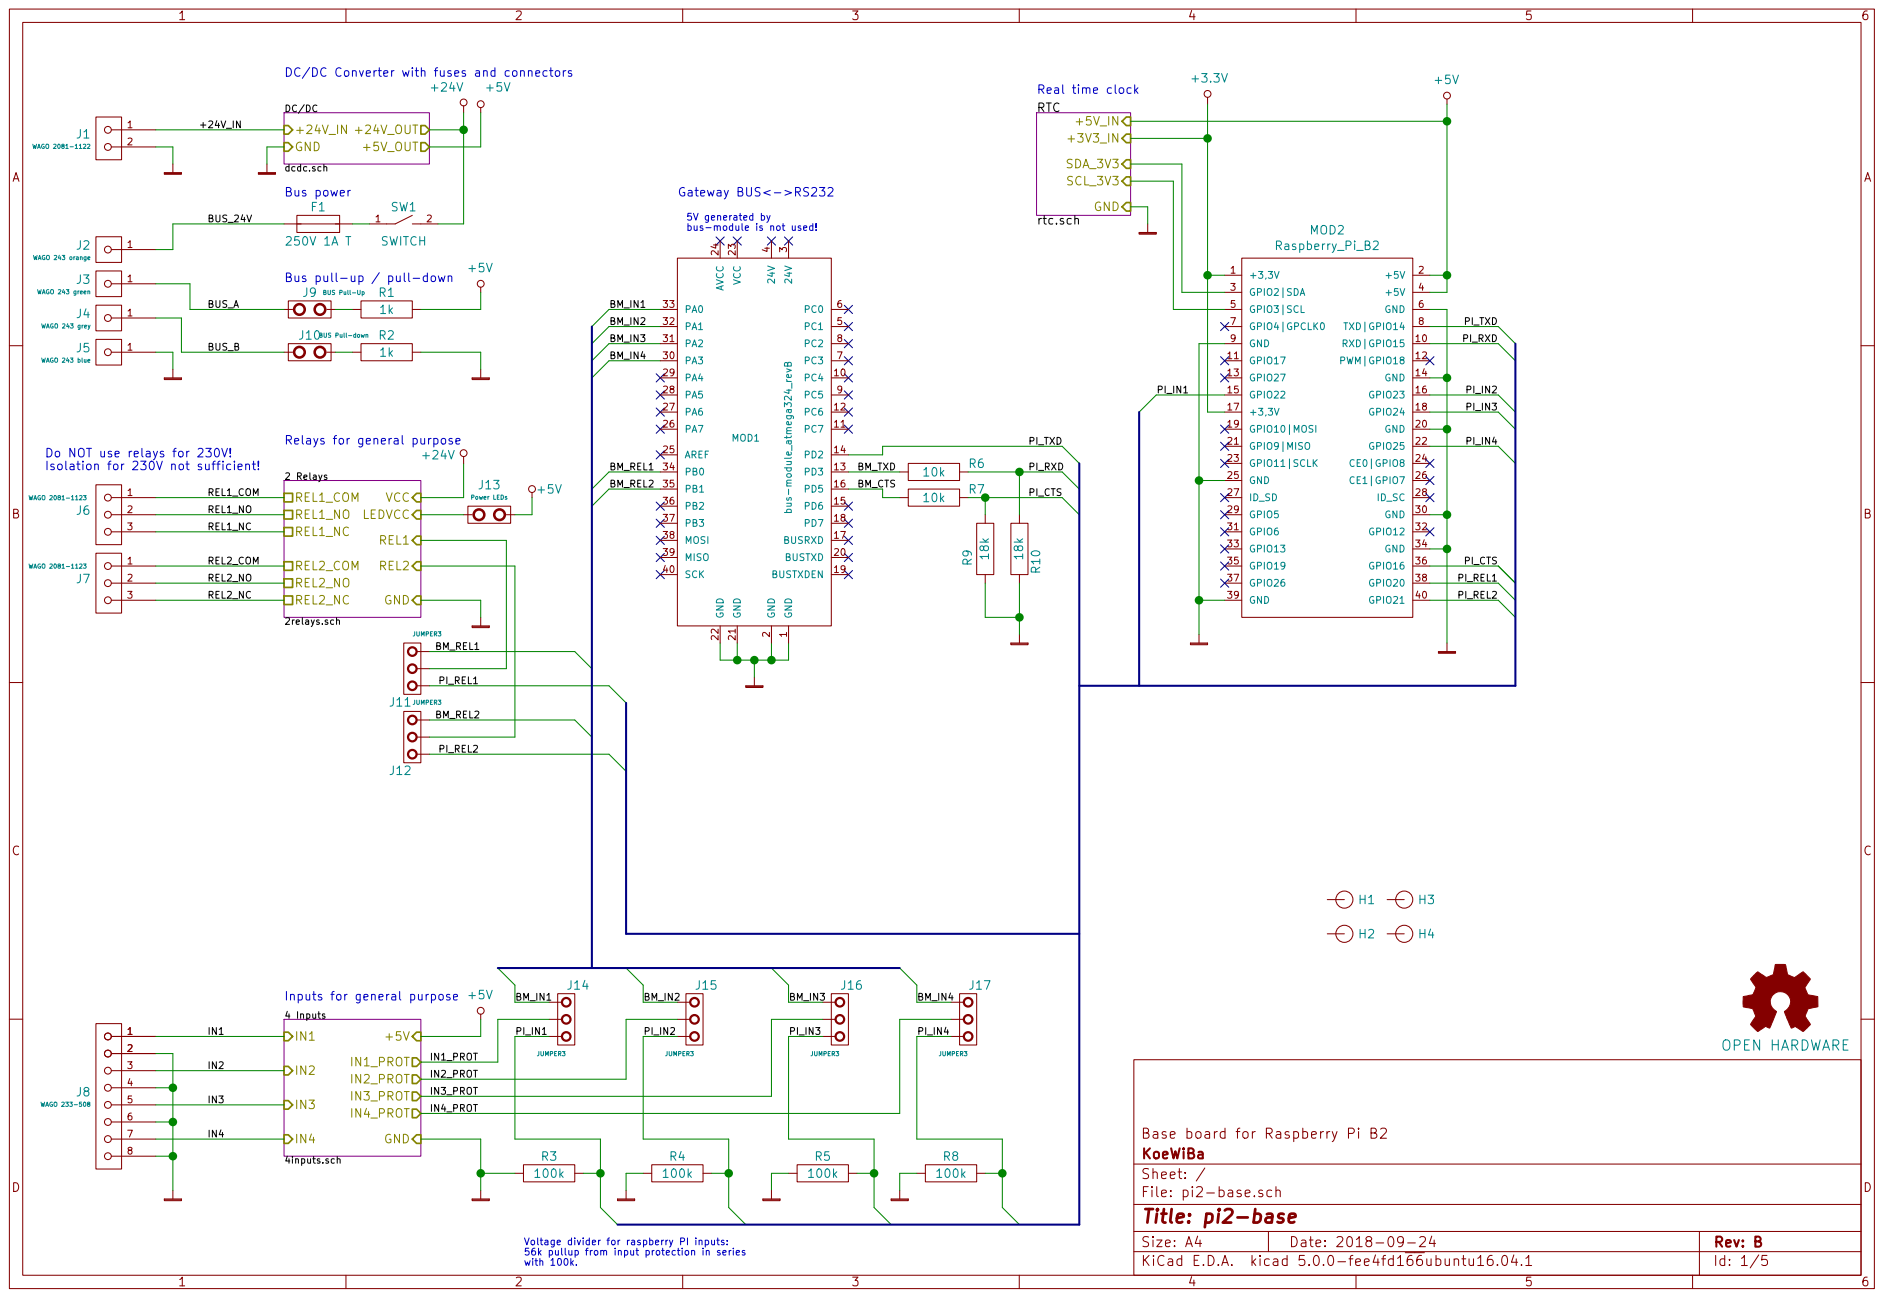
[picture p39: page 1]

Bus power
5V generated by bus-module is not used! F1

2 BUSTXD 20 GND 21 GND 22 VCC 23 AVCC 24 AREF 25 PA7 26 PA6 27 PA5 28 PA4 29 24V

Do NOT use relays for 230V!

File: pi2-base.sch Sheet: / KoeWiBa Base board for Raspberry Pi B2

Voltage divider for raspberry PI inputs: 56k pullup from input protection in series with 100k.

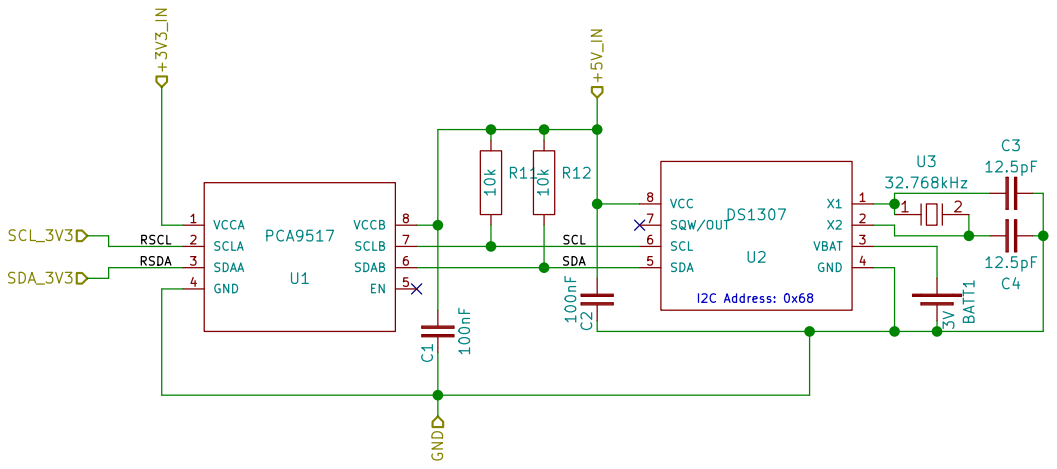
[picture p40: page 2]

File: rtc.sch Sheet: /RTC/ KoeWiBa Baseboard for Raspberry PI 2

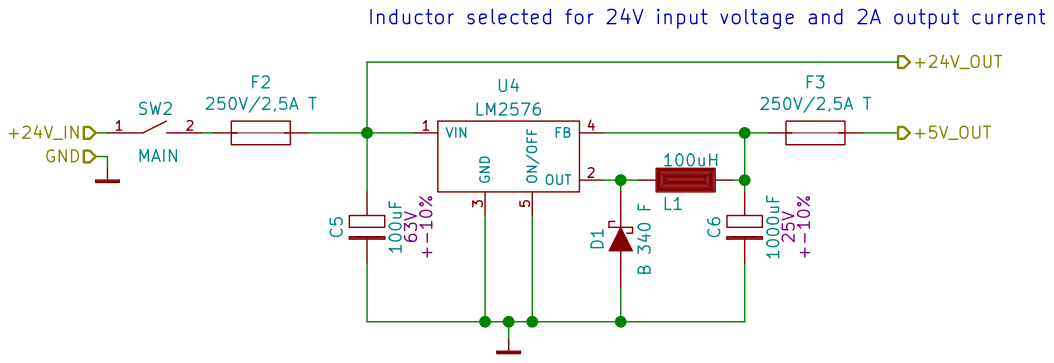
[picture p41: page 3]

Inductor selected for 24V input voltage and 2A output current

Id: 3/5 Title: DC/DC Converter File: dcdc.sch Sheet: /DC/DC/ KoeWiBa Baseboard for Raspberry Pi 2

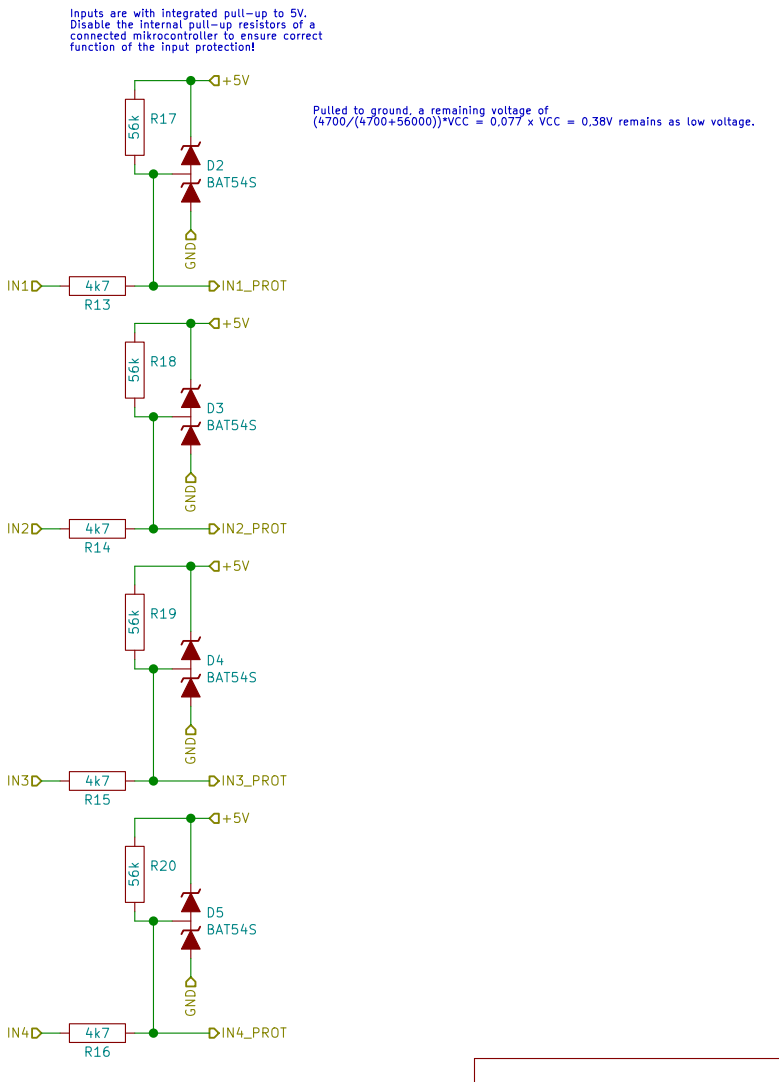
[picture p42: page 4]

Inputs are with integrated pull-up to 5V. Disable the internal pull-up resistors of a connected mikrocontroller to ensure correct

Sheet: /4 Inputs/ KoeWiBa Baseboard for Raspberry PI 2B

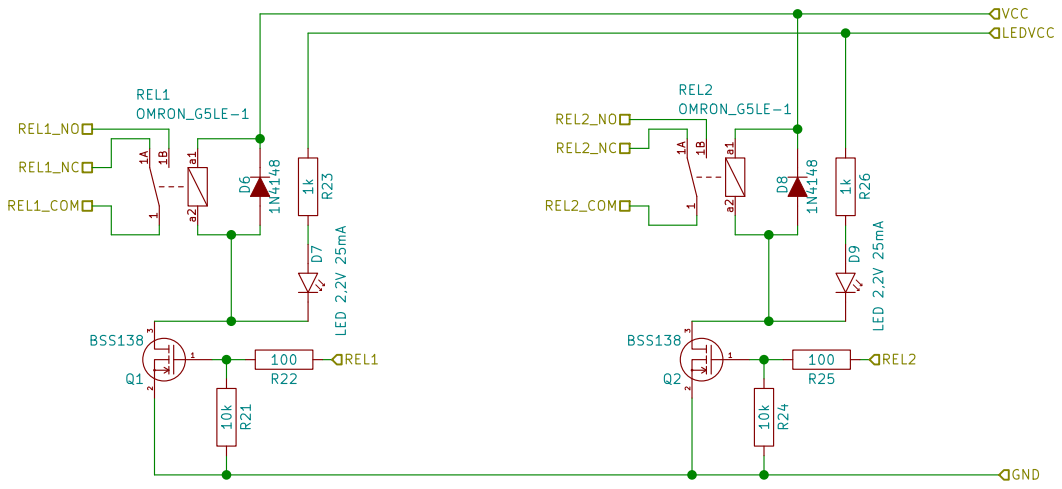
[picture p43: page 5]

Sheet: /2 Relays/ KoeWiBa Baseboard for Raspberry PI 2B
