irqmask/koewiba-domotic/hw/gateway_usb/gateway_usb.pdf

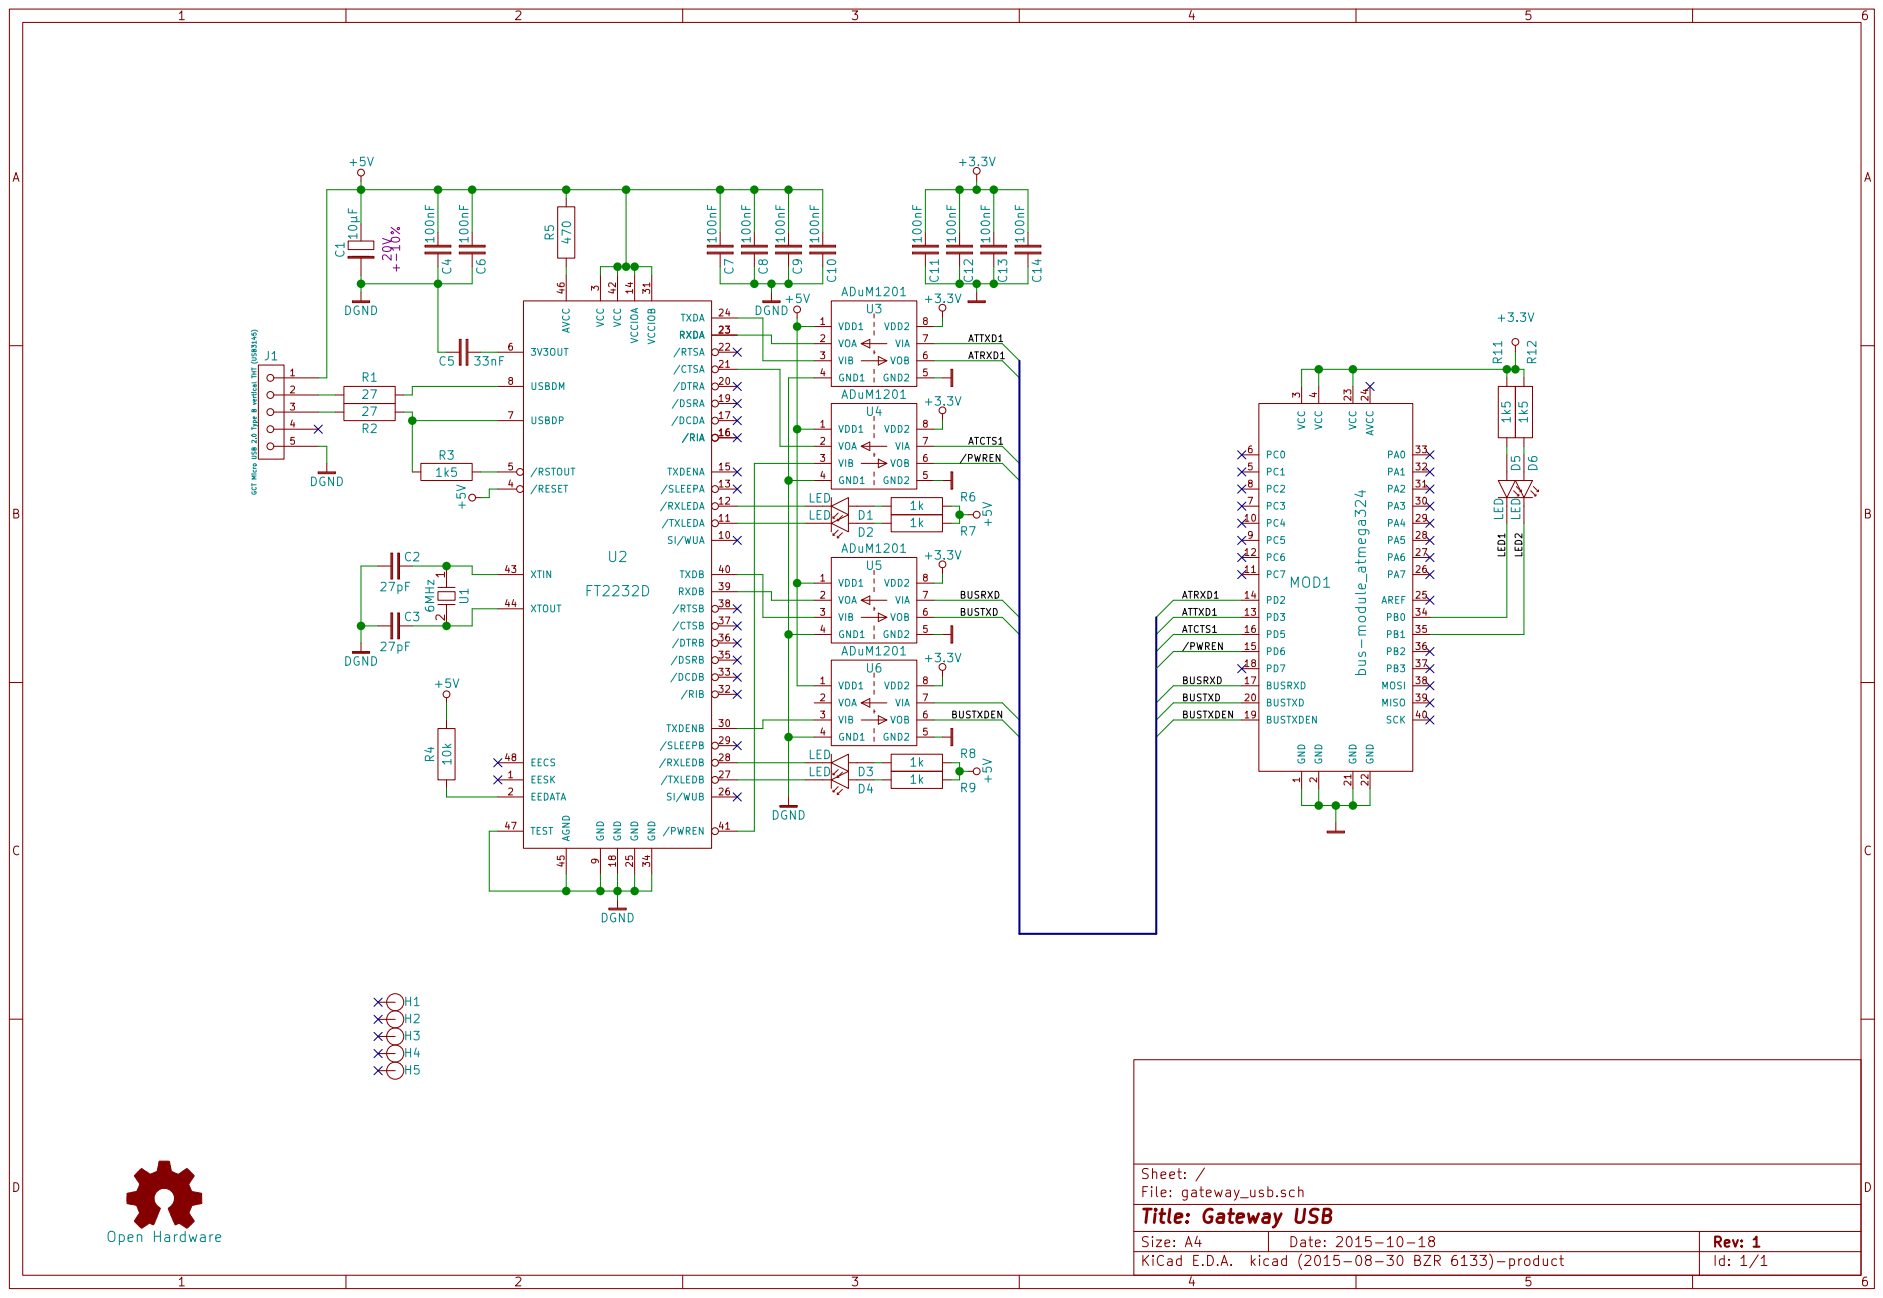
[picture p46: page 1]

4 PC1 5 PC0 6 PC3 7 PC2 8 PC5 9 PC4 10 BUSTXD 20 PA3 30 SCK 40 PC7 11 GND 21 PA2 31 PC6 12 GND 22 PA1 32 PD3 13 VCC 23 PA0 33 PD2 14 AVCC 24 PB0 34 PD6 15 AREF 25 PB1 35 PD5 16 PA7 26 PB2 36 BUSRXD 17 PA6 27 PB3 37 PD7 18 PA5 28 MOSI 38 BUSTXDEN 19 PA4 29 MISO 39 MOD1 bus-module_atmega324 /PWREN DGND

File: gateway_usb.sch Sheet: /
Id: 1/1 Title: Gateway USB
