irqmask/koewiba-domotic/hw/motor_switch_3pole/doc/motor_switch_3pole_rev1.pdf

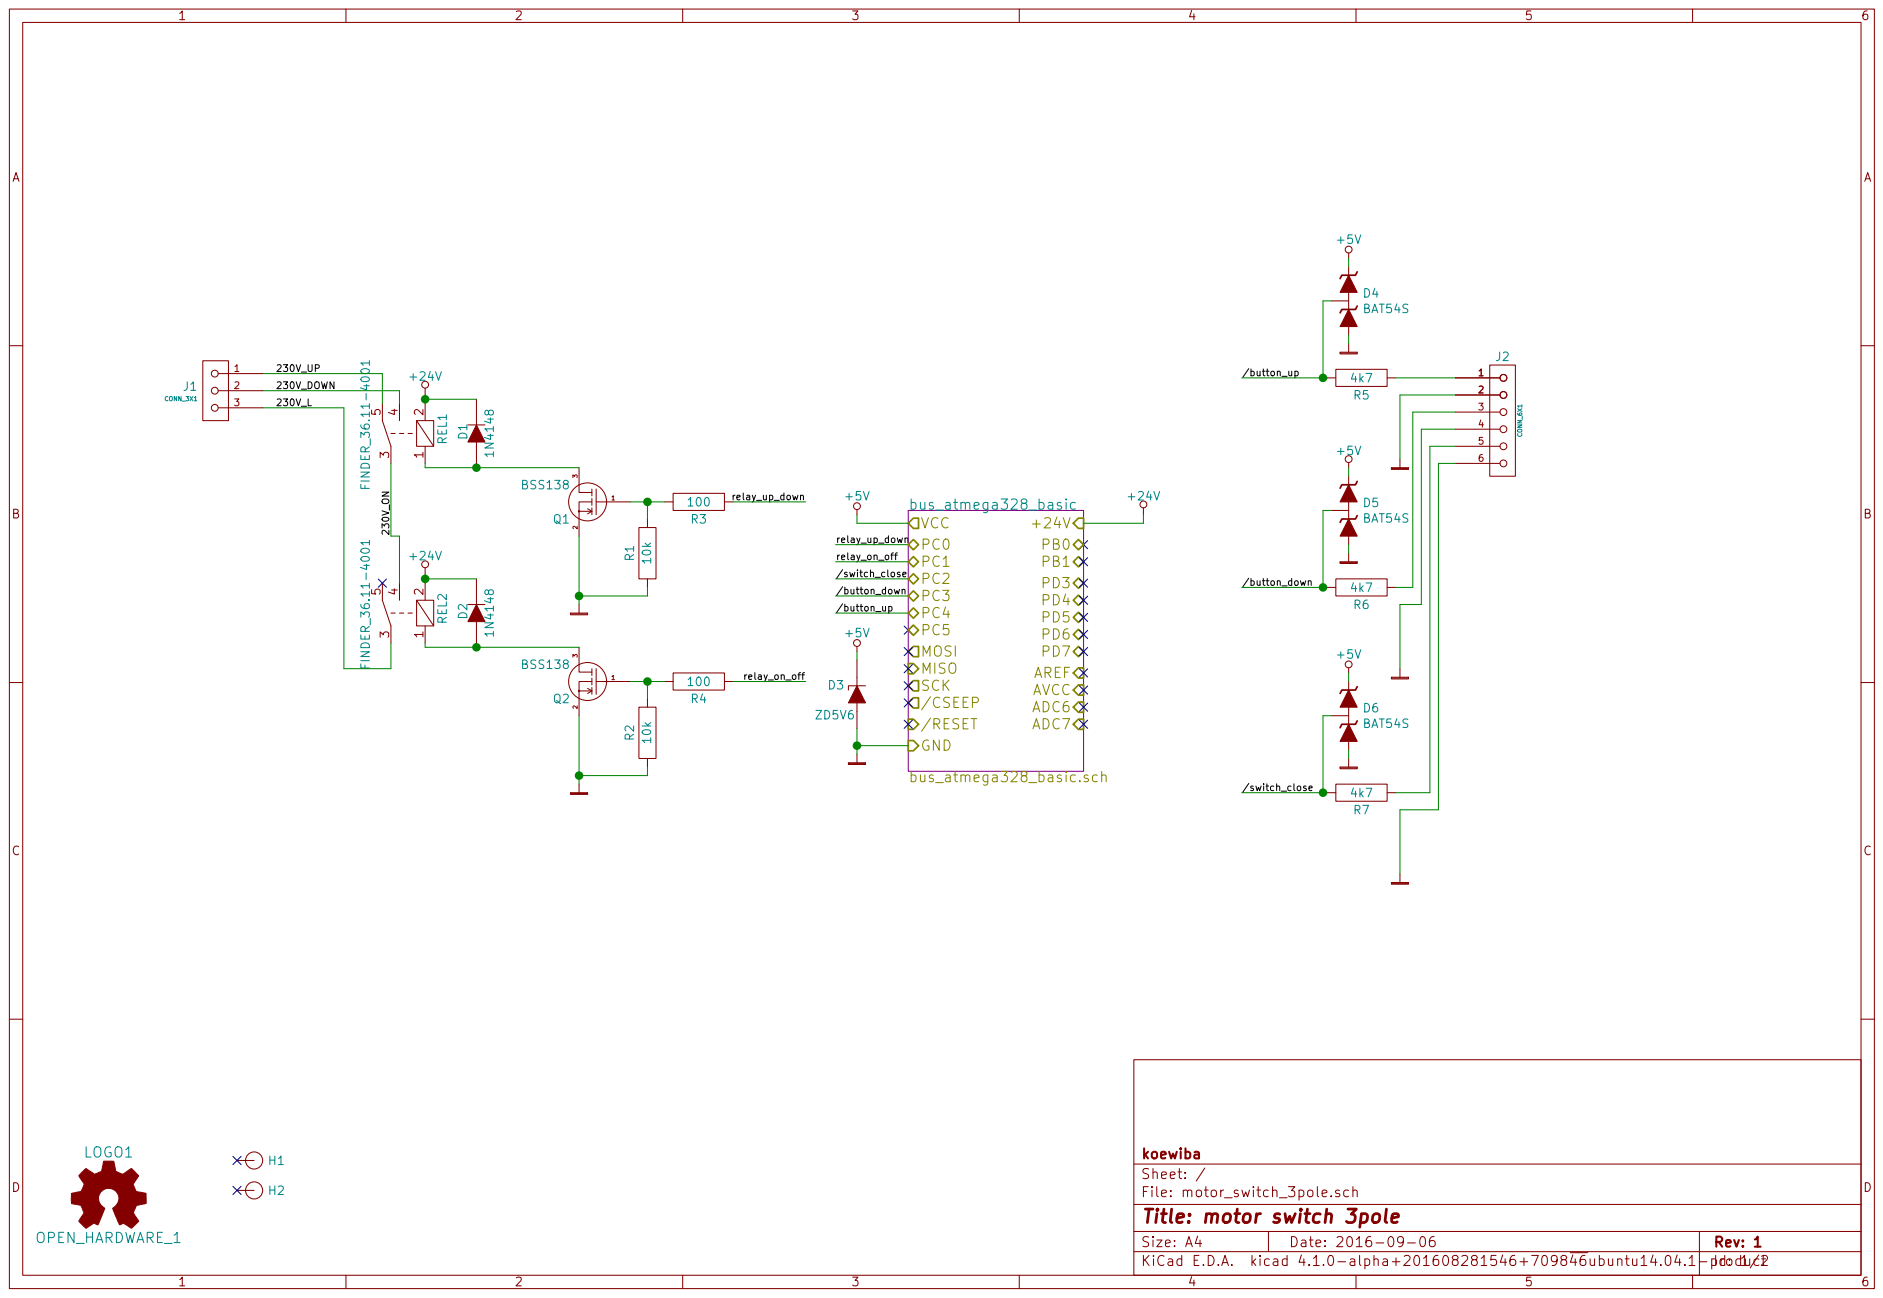
[picture p47: page 1]

File: motor_switch_3pole.sch Sheet: / koewiba

Id: 1/2 Title: motor switch 3pole

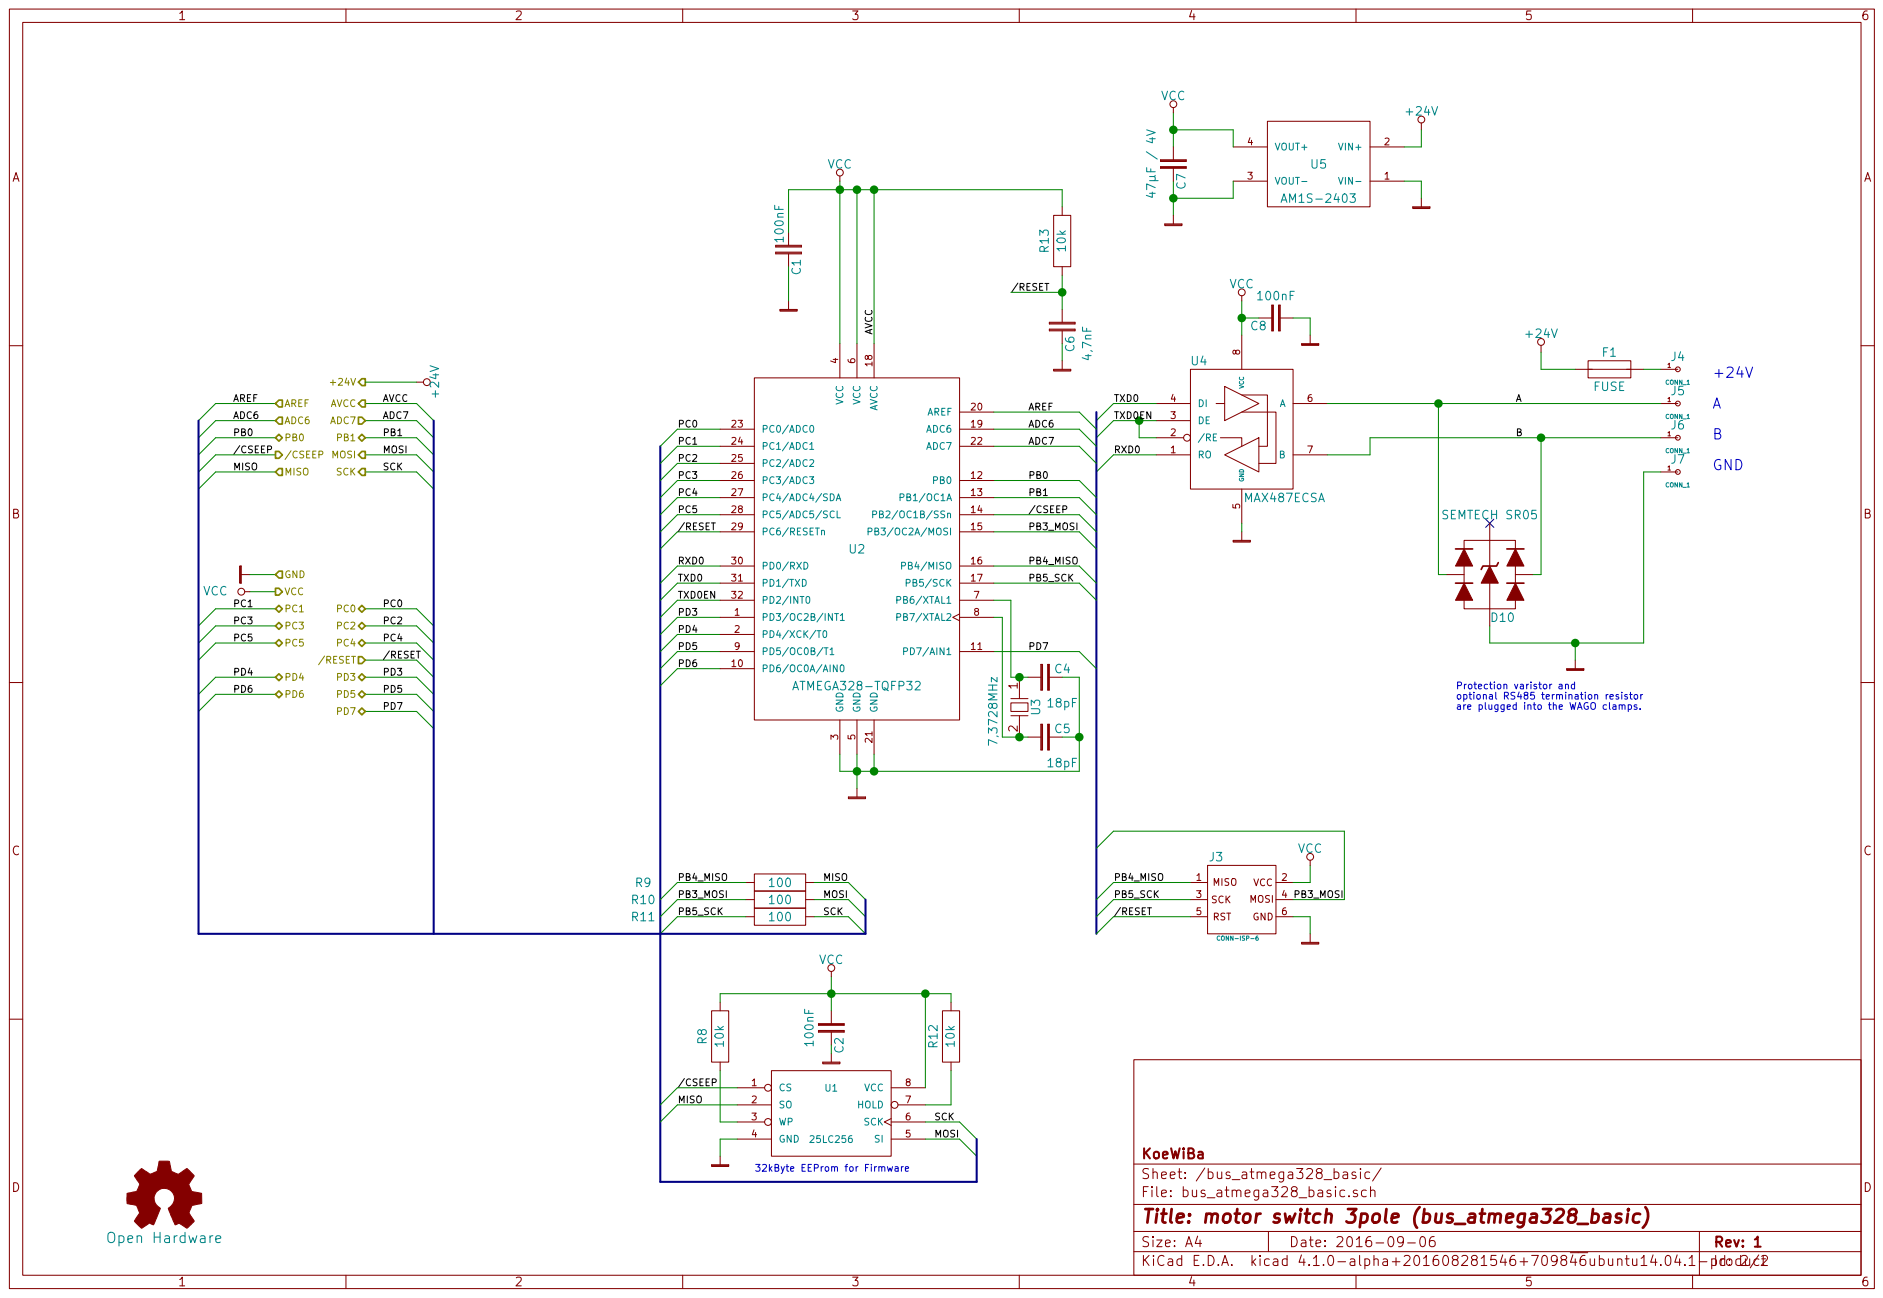
[picture p48: page 2]

optional RS485 termination resistor are plugged into the WAGO clamps. D10 SEMTECH SR05 VCC

6 PB6/XTAL1 7 PB7/XTAL2 8 PD5/OC0B/T1 9 PD6/OC0A/AIN0 10 AREF 20 PD0/RXD 30 PD7/AIN1 11 GND 21 PD1/TXD 31 PB0 12 ADC7 22 PD2/INT0 32 PB1/OC1A 13 PC0/ADC0 23 PB2/OC1B/SSn 14 PC1/ADC1 24 PB3/OC2A/MOSI 15 PC2/ADC2 25 PB4/MISO 16 PC3/ADC3 26 PB5/SCK 17 PC4/ADC4/SDA 27 AVCC 18 PC5/ADC5/SCL 28 ADC6 19 PC6/RESETn 29 U2 ATMEGA328-TQFP32 AVCC

File: bus_atmega328_basic.sch
Id: 2/2 Title: motor switch 3pole (bus_atmega328_basic)
