irqmask/koewiba-domotic/hw/roomthermostat/roomthermostat_components_back.pdf

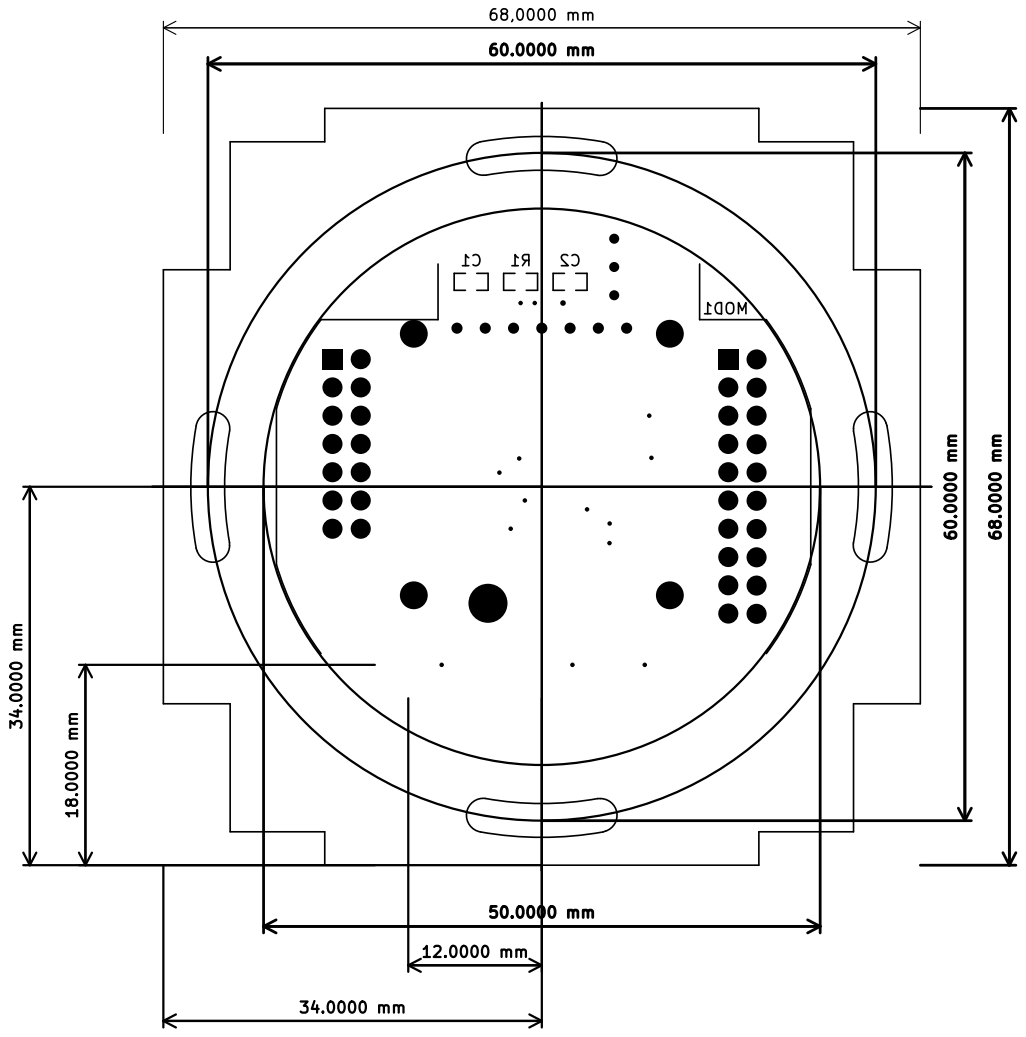
[picture p49: page 1]
