irqmask/koewiba-domotic/hw/roomthermostat/roomthermostat_components_front.pdf

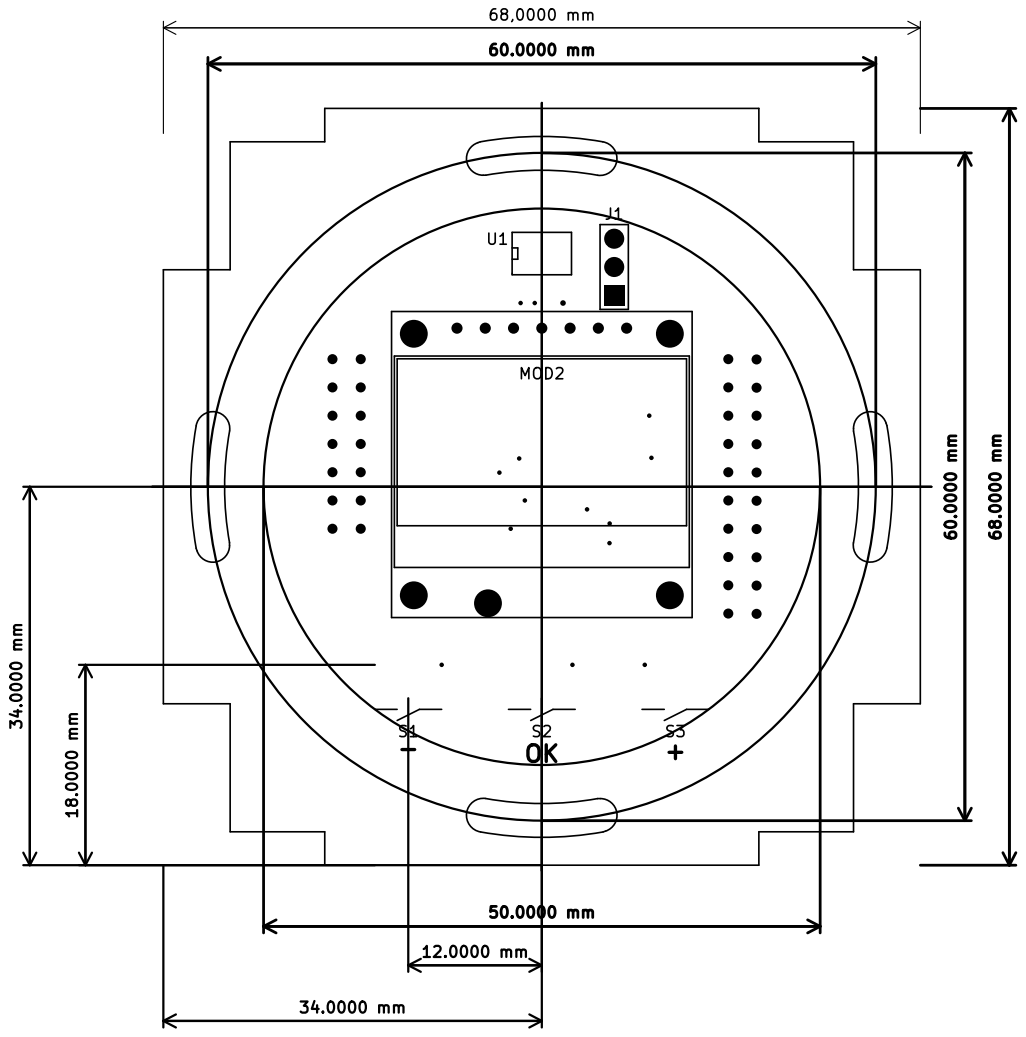
[picture p50: page 1]
