irqmask/koewiba-domotic/hw/bus-module_atmega324/bus-module_atmega324_components_back.pdf

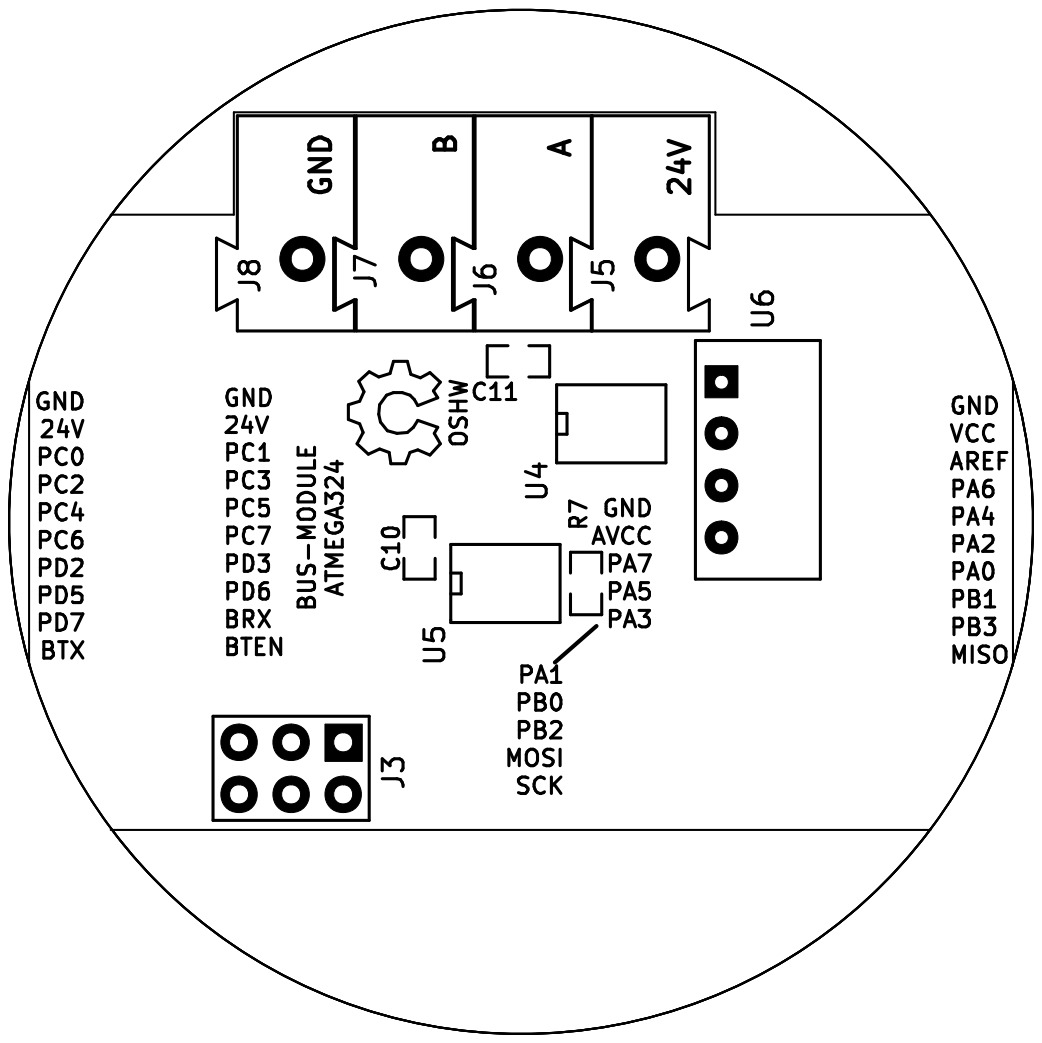
[picture p51: page 1]
