irqmask/koewiba-domotic/hw/bus-module_atmega324/bus-module_atmega324_components_front.pdf

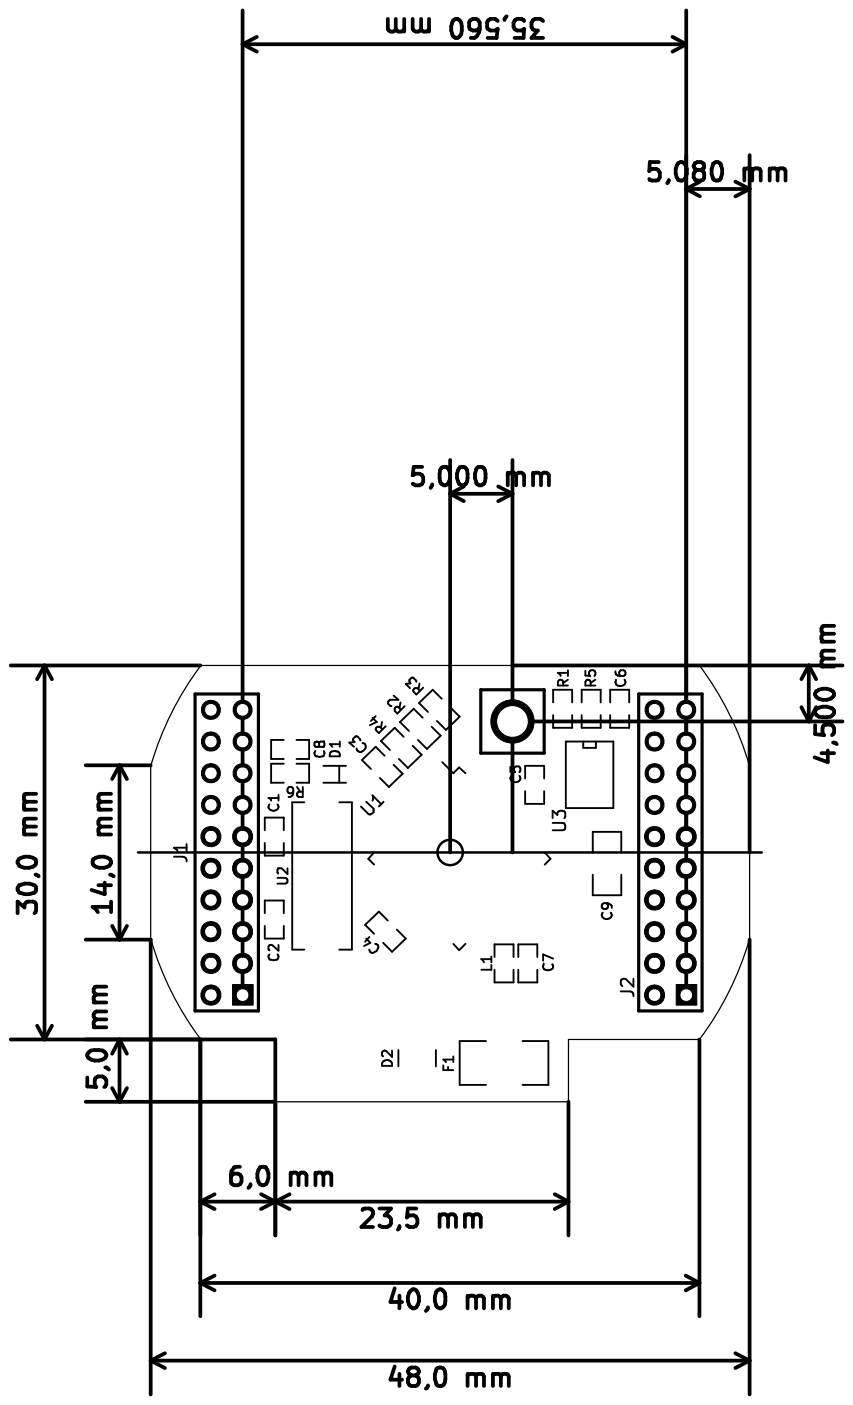
[picture p52: page 1]
