irqmask/koewiba-domotic/hw/bus-module_atmega328/bus-module_atmega328_components_back.pdf

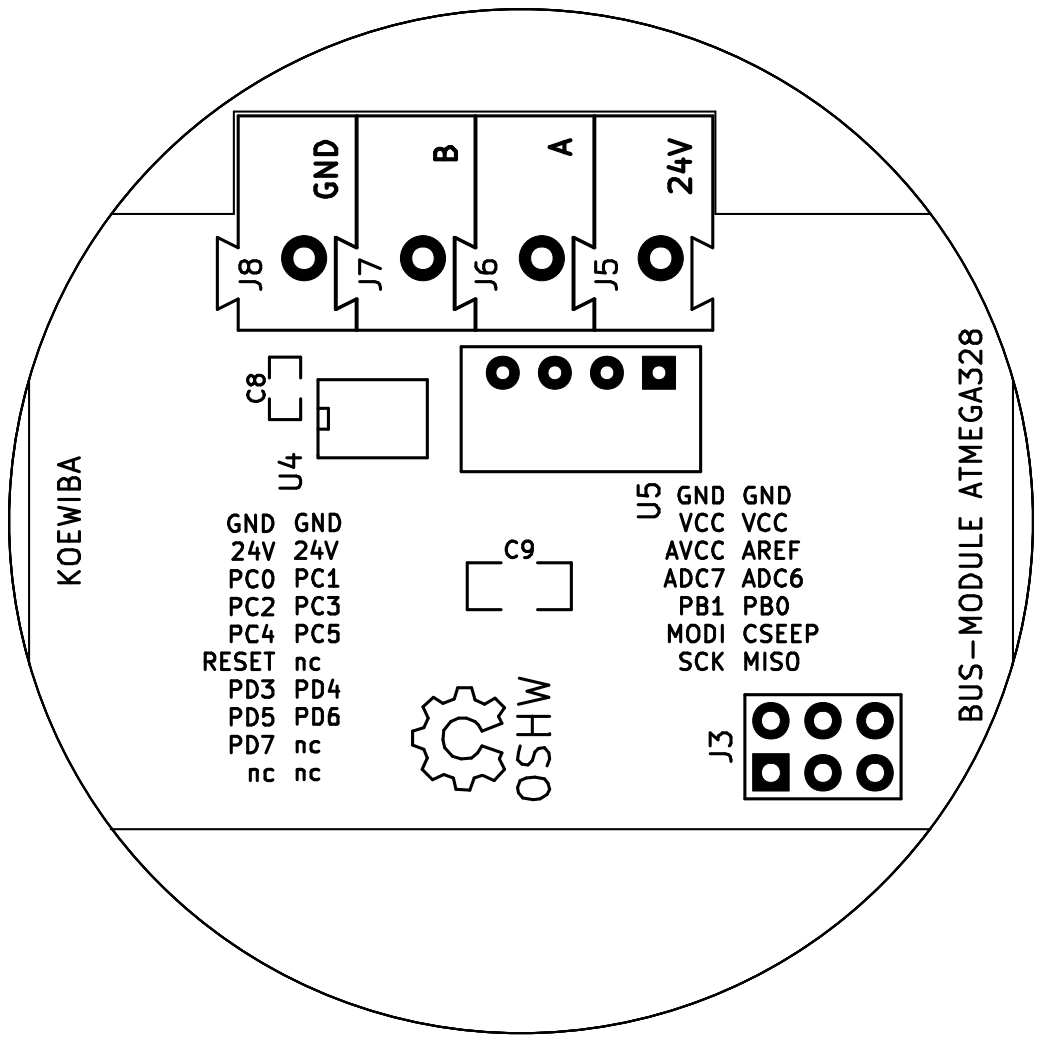
[picture p53: page 1]
