irqmask/koewiba-domotic/hw/bus-module_atmega328/bus-module_atmega328_components_front.pdf

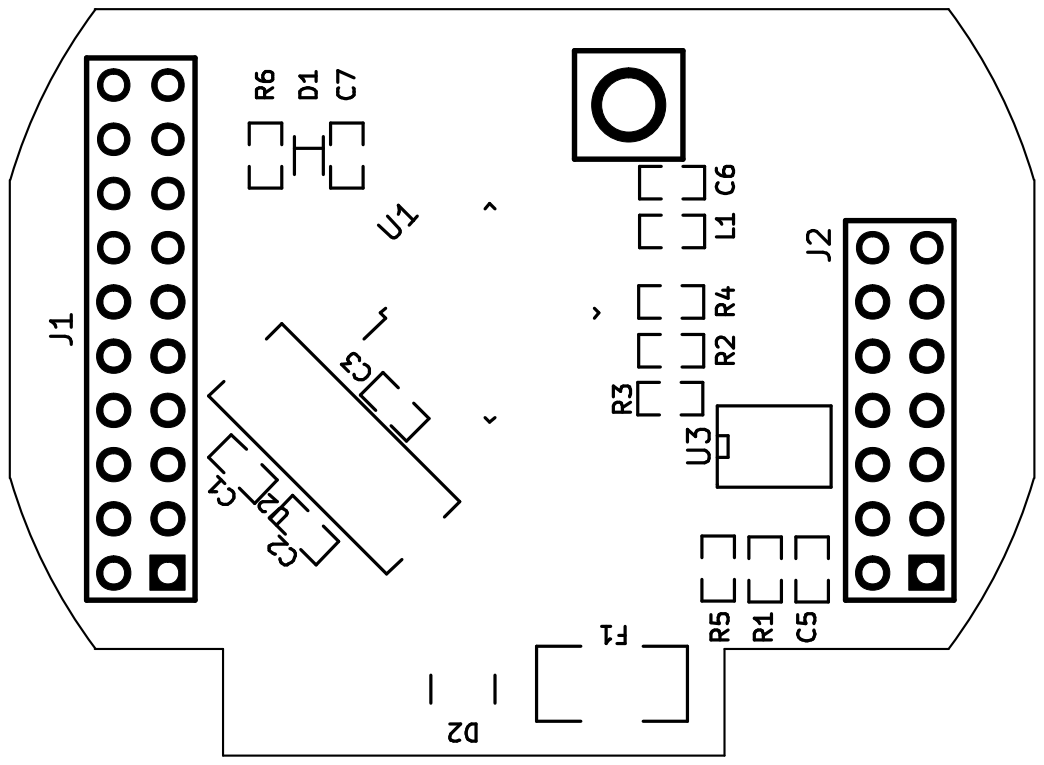
[picture p54: page 1]
