irqmask/koewiba-domotic/hw/bus-module_attiny1634/bus-module_attiny1634_components_back.pdf

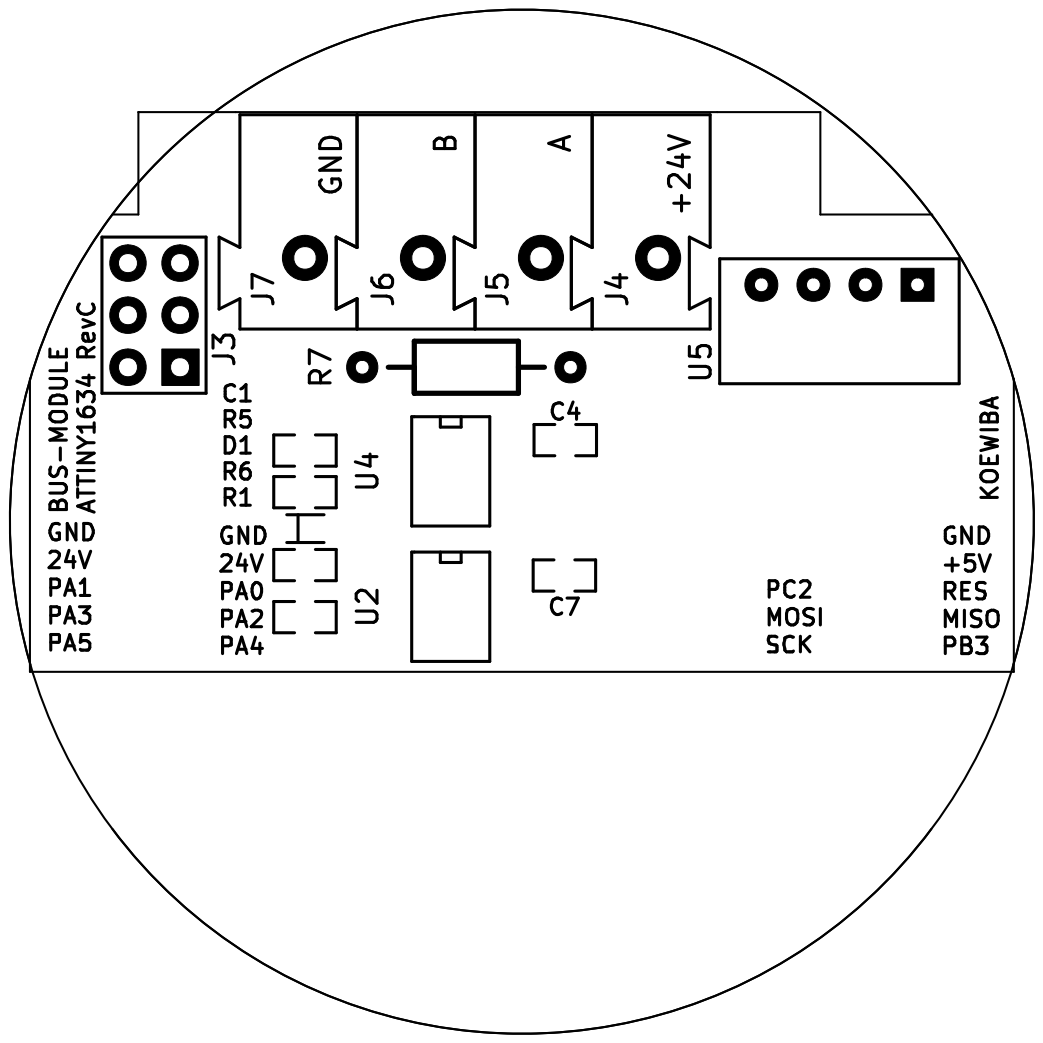
[picture p55: page 1]
