irqmask/koewiba-domotic/hw/bus-module_attiny1634/bus-module_attiny1634_components_front.pdf

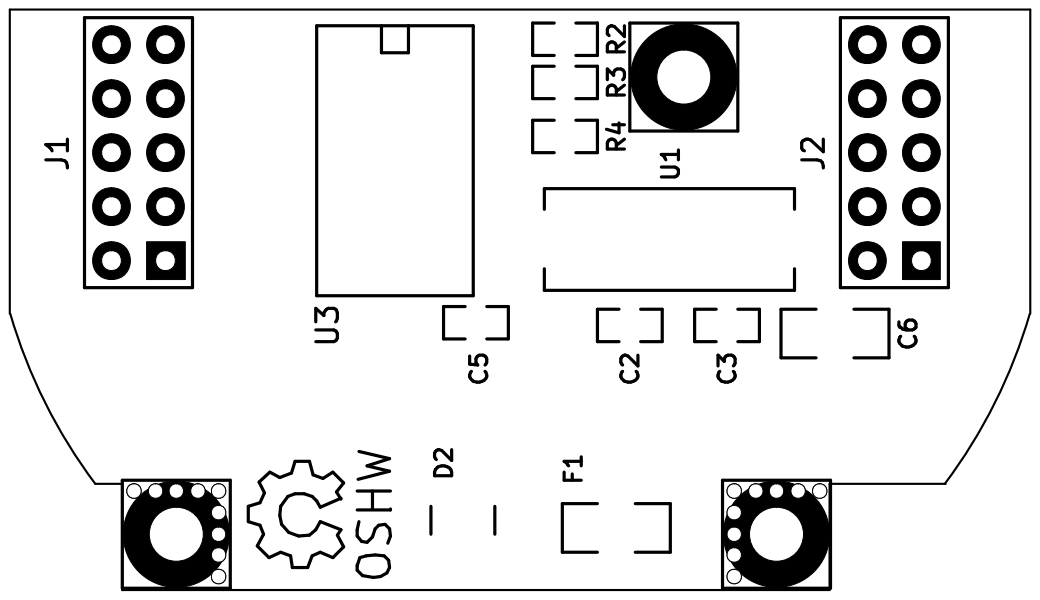
[picture p56: page 1]
