irqmask/koewiba-domotic/hw/switch_3pole_5x/doc/switch_3pole_5x_components_back.pdf

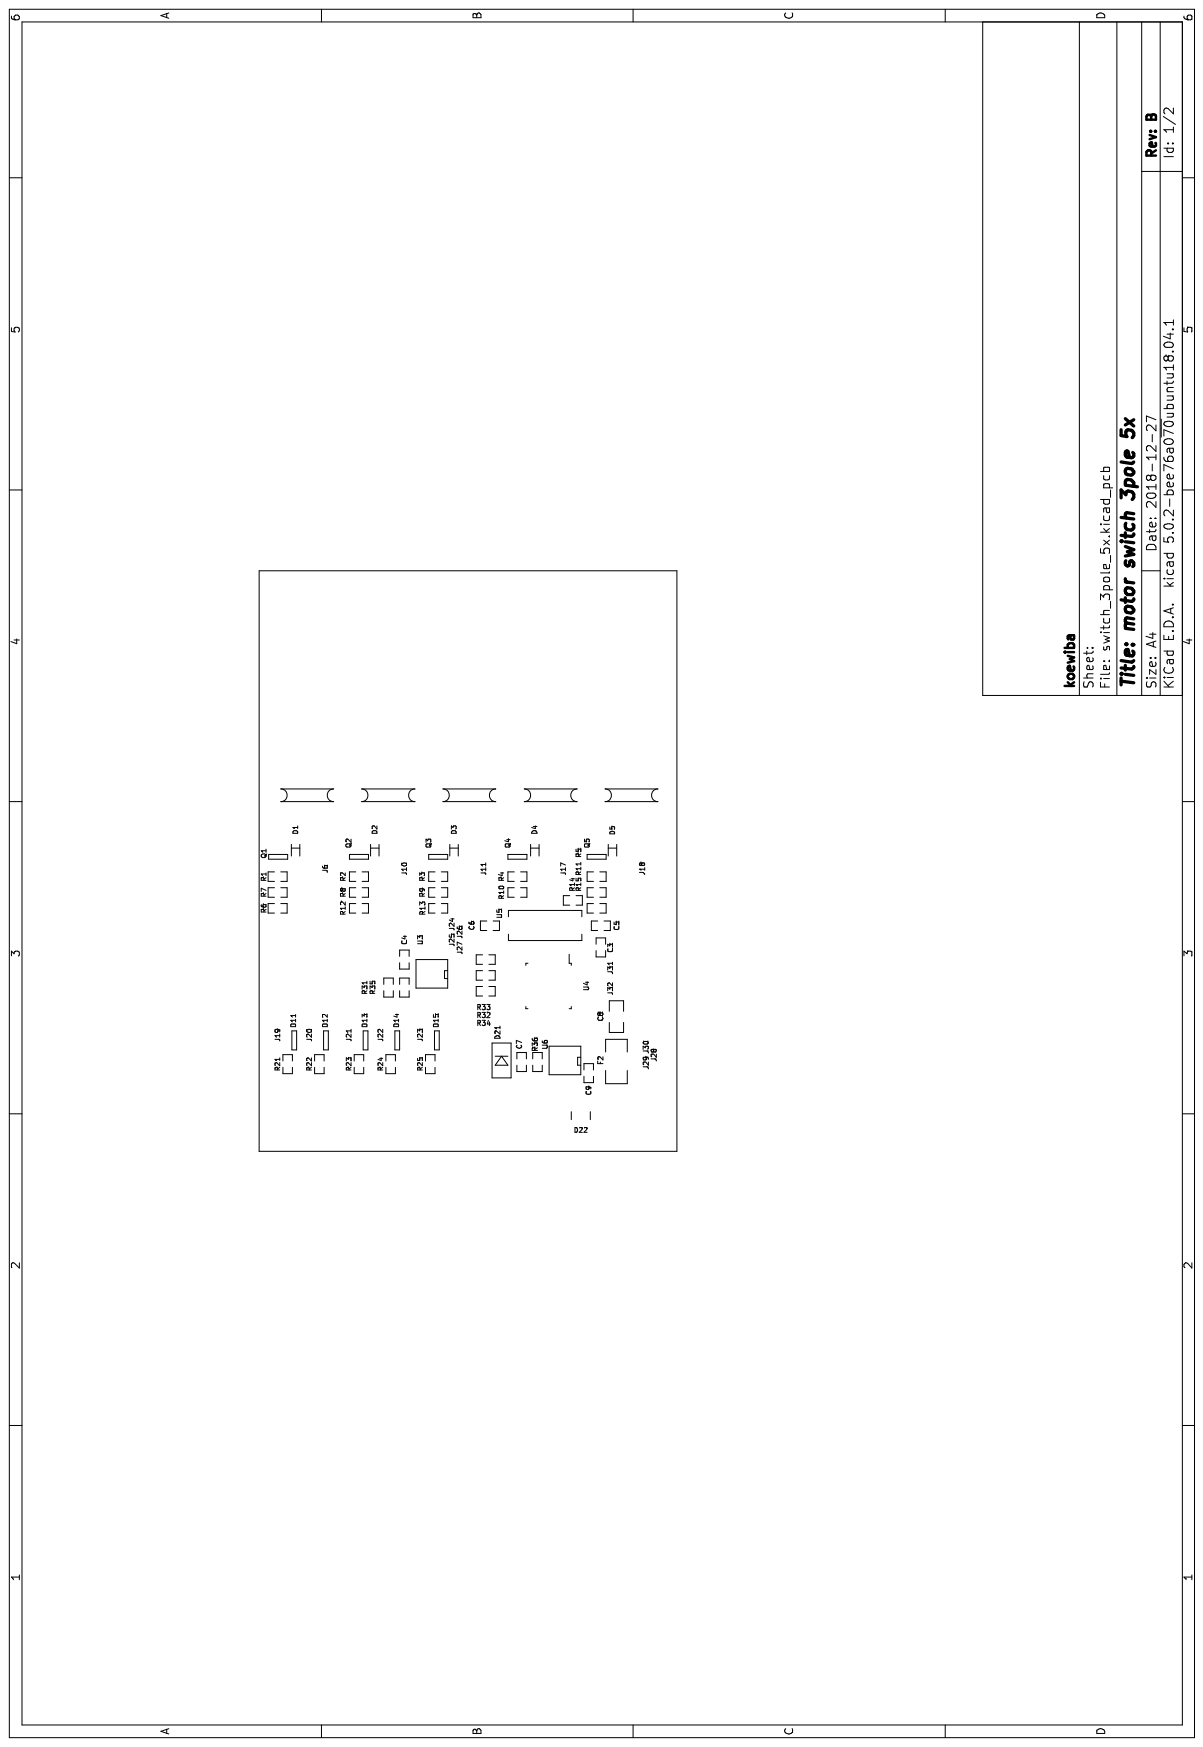
[picture p57: page 1]
