irqmask/koewiba-domotic/hw/switch_3pole_5x/doc/switch_3pole_5x_components_front.pdf

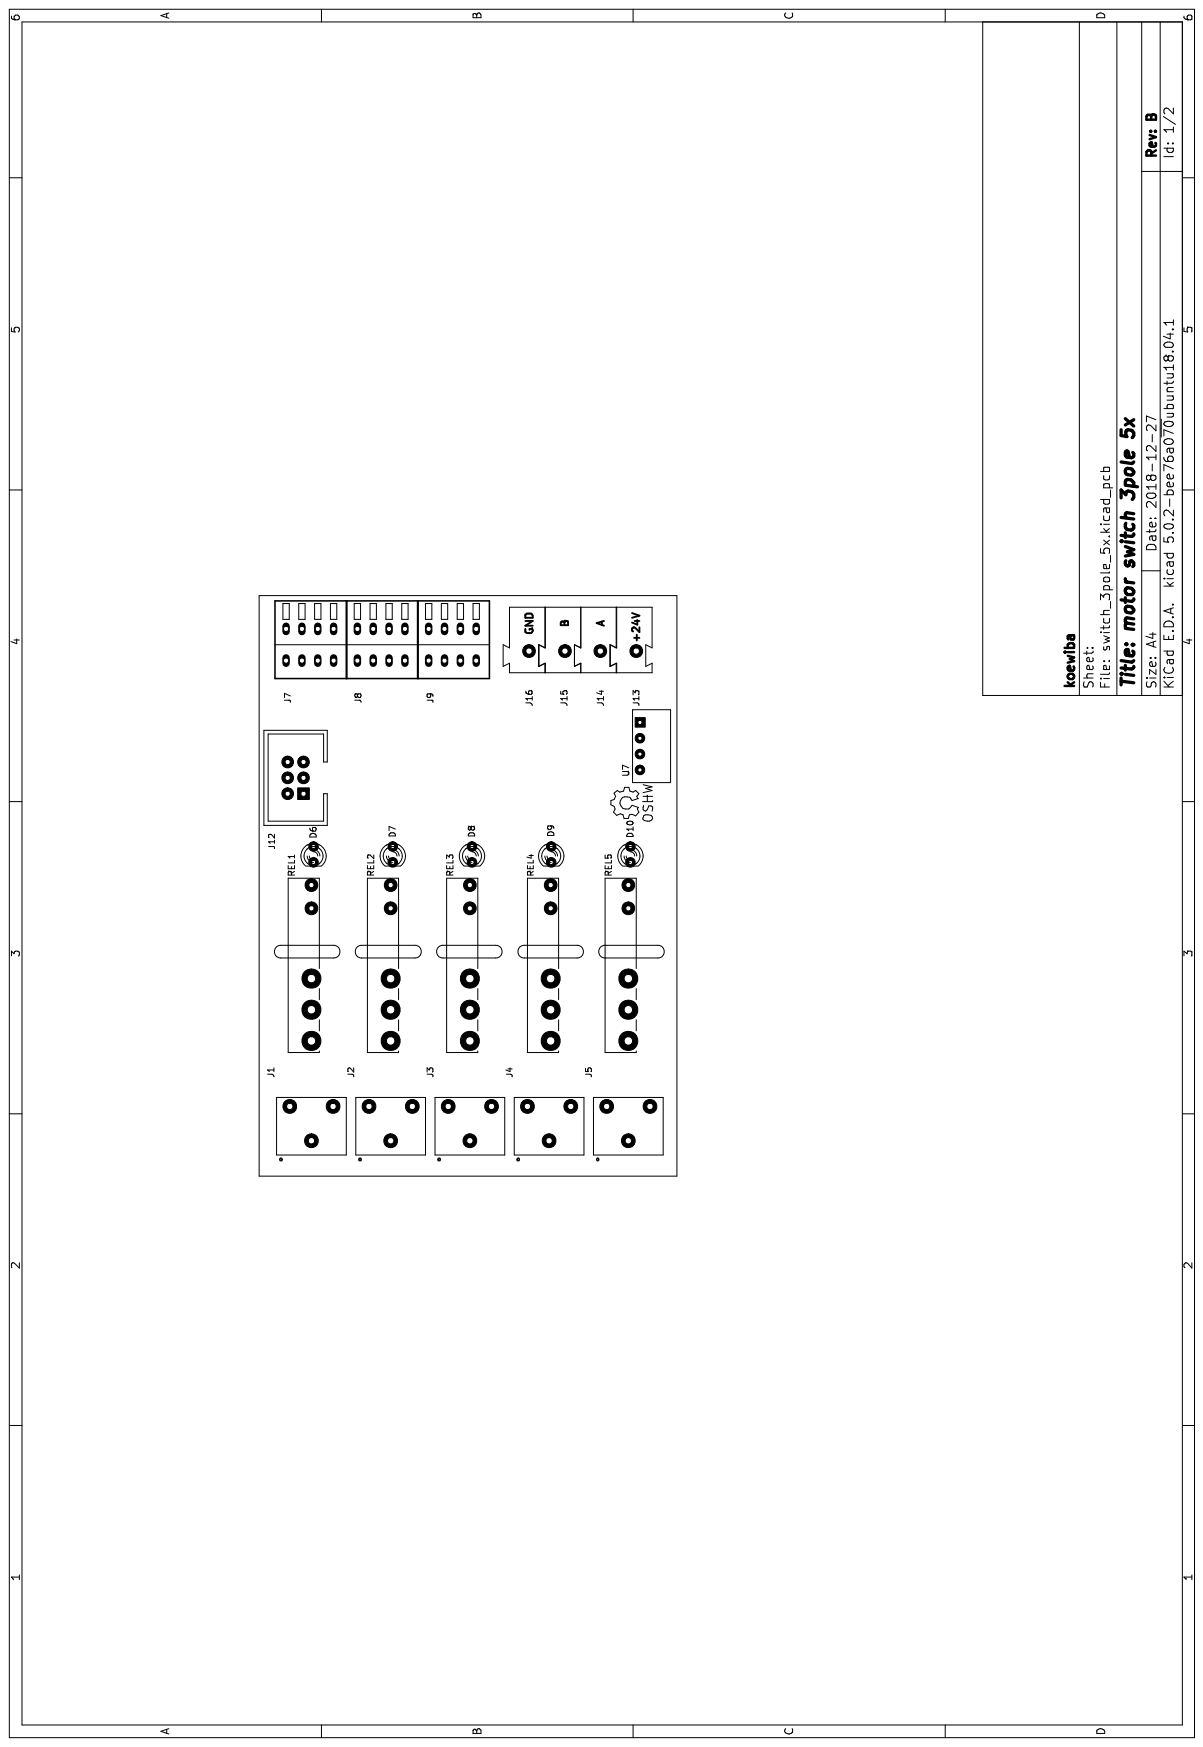
[picture p58: page 1]
