irqmask/koewiba-domotic/hw/motor_switch_3pole_5x/doc/motor_switch_3pole_5x_components_back.pdf

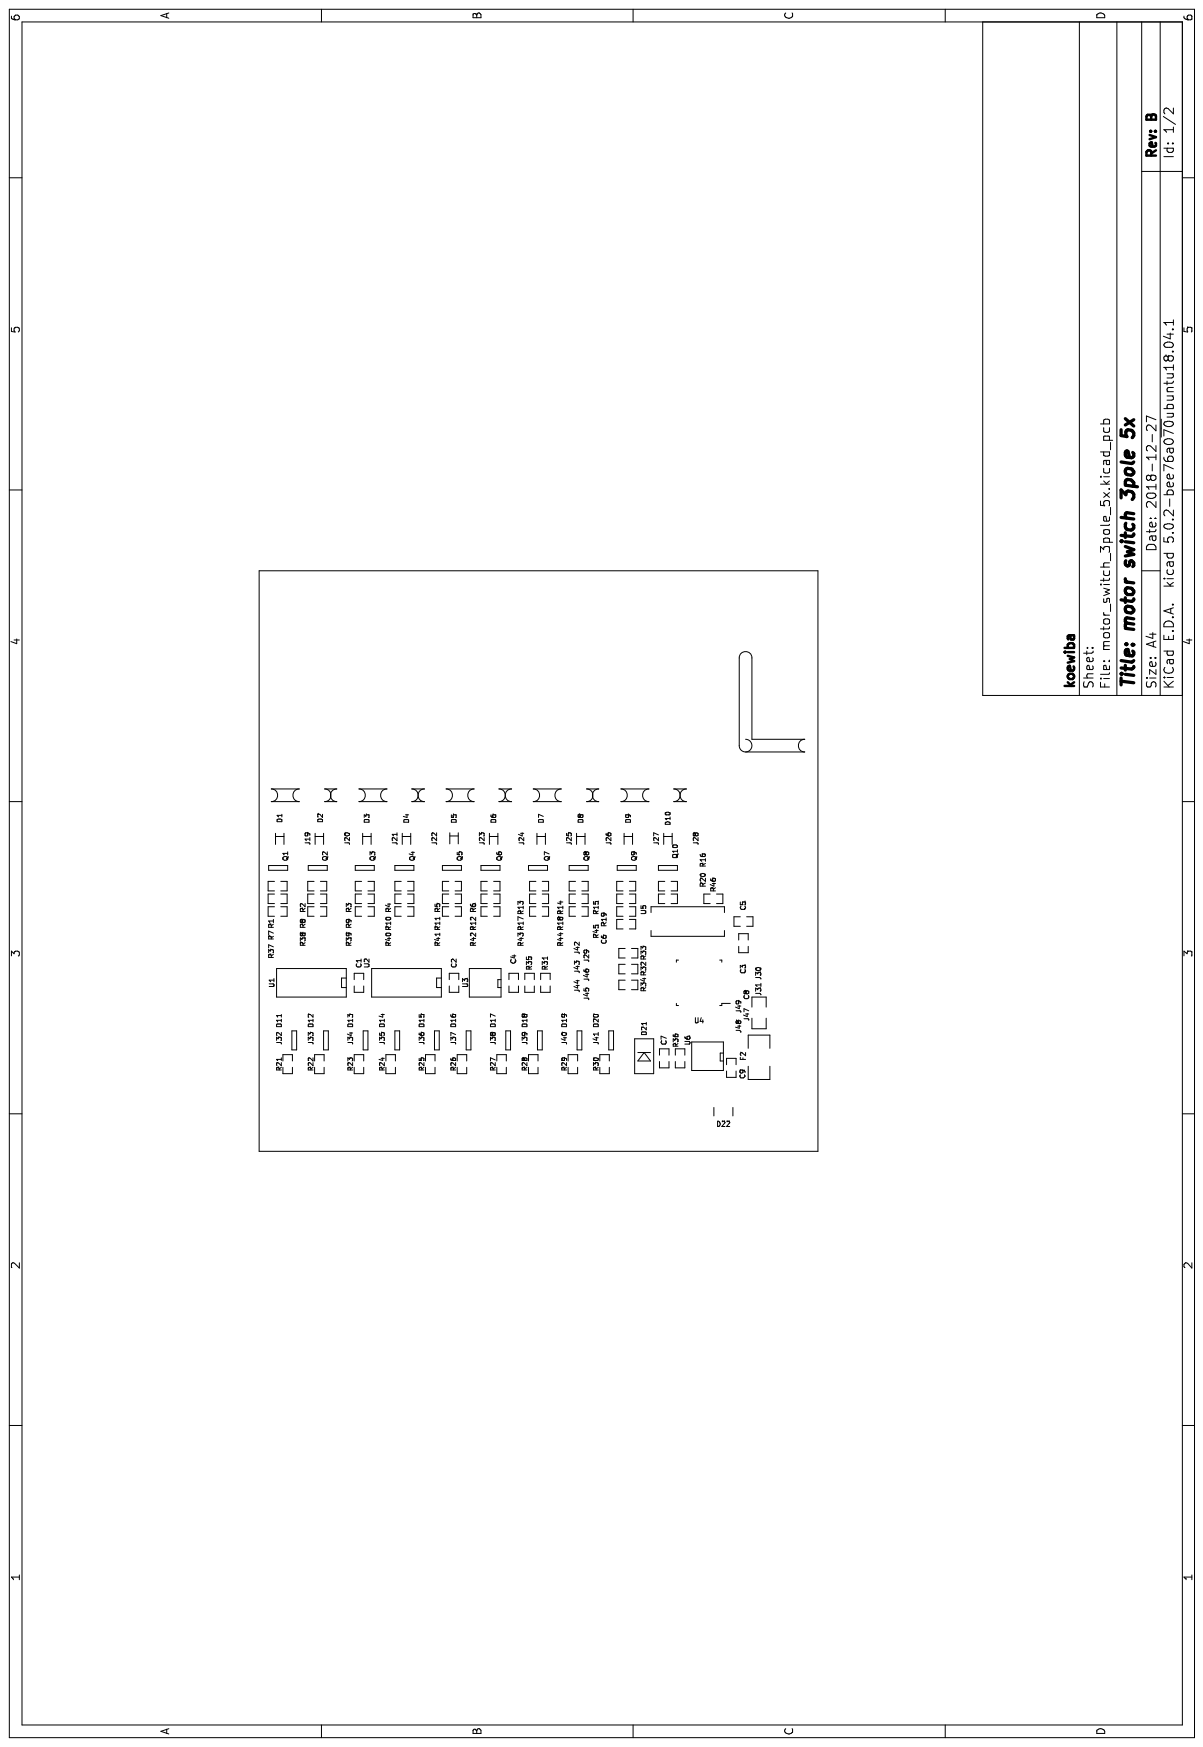
[picture p59: page 1]
