irqmask/koewiba-domotic/hw/motor_switch_3pole_5x/doc/motor_switch_3pole_5x_components_front.pdf

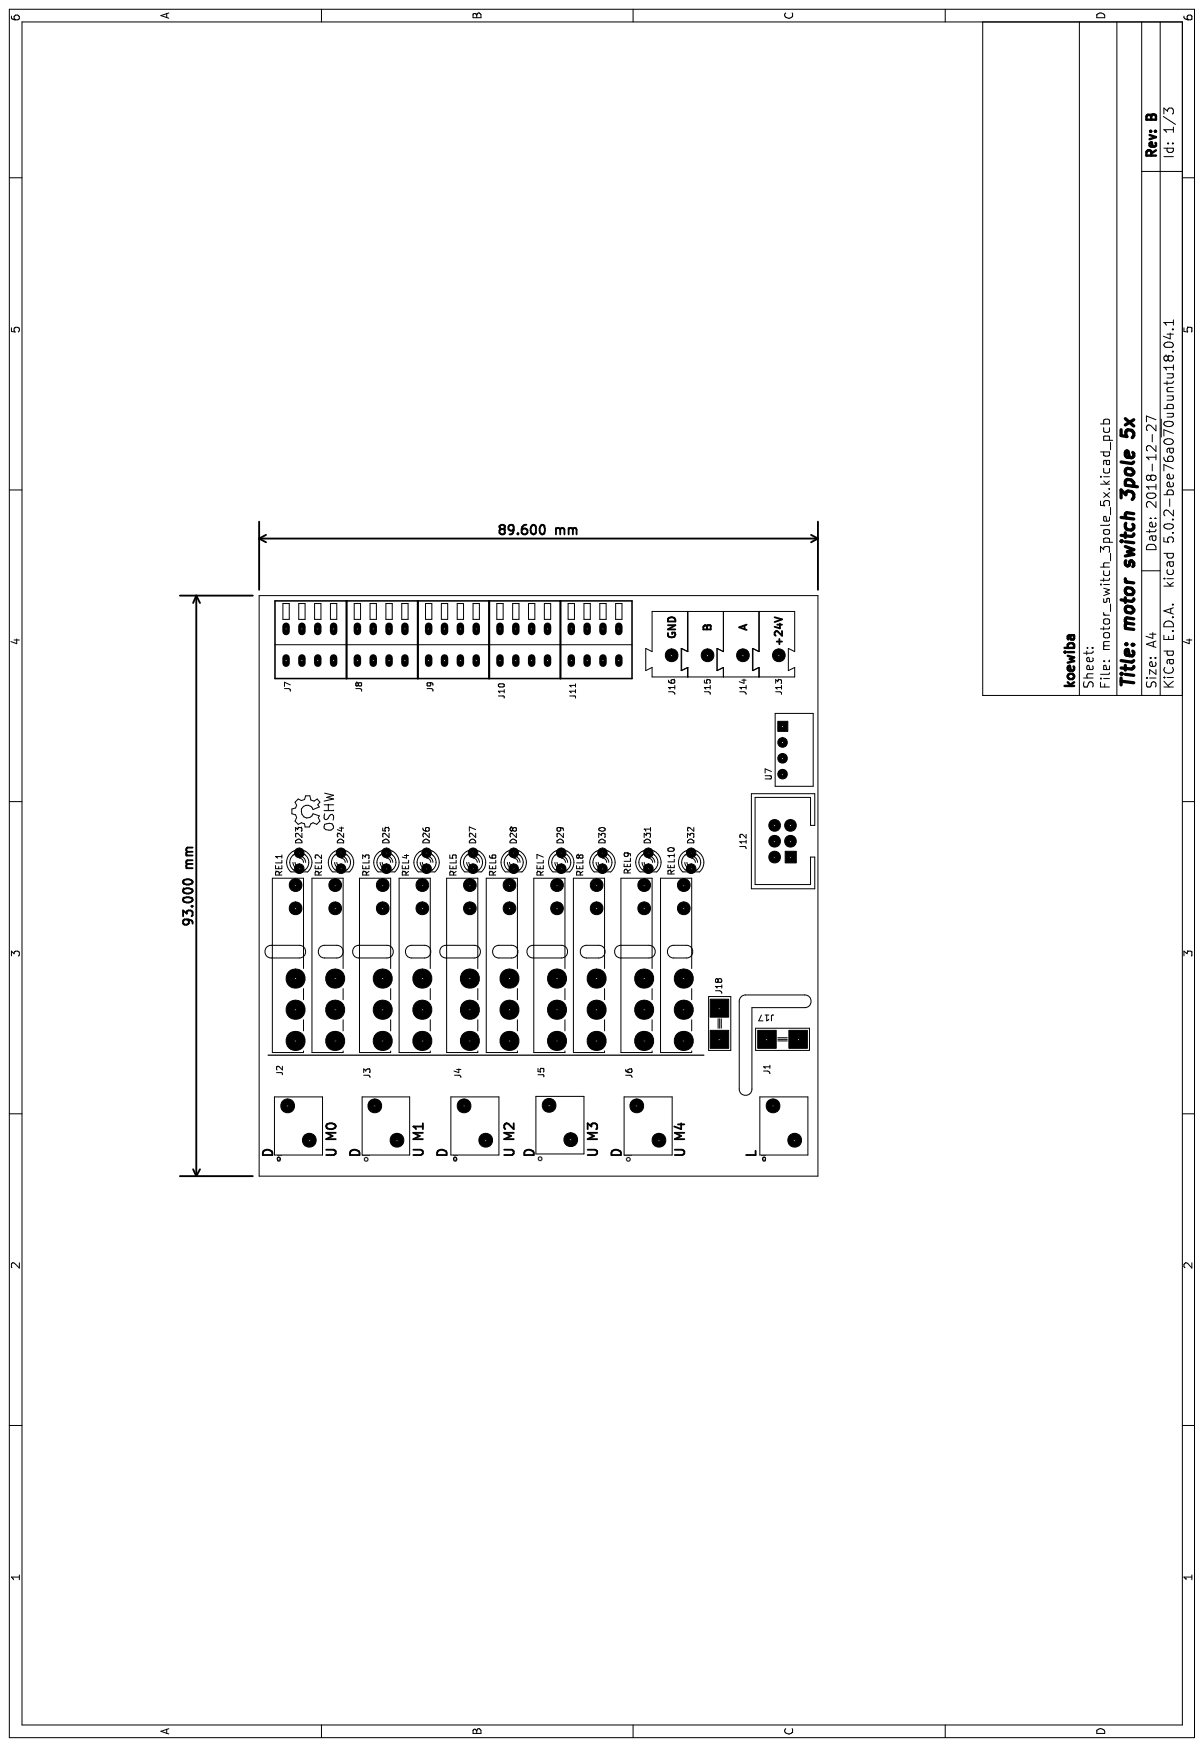
[picture p60: page 1]
