irqmask/koewiba-domotic/hw/pi2-base/doc/pi2-base_components_back.pdf

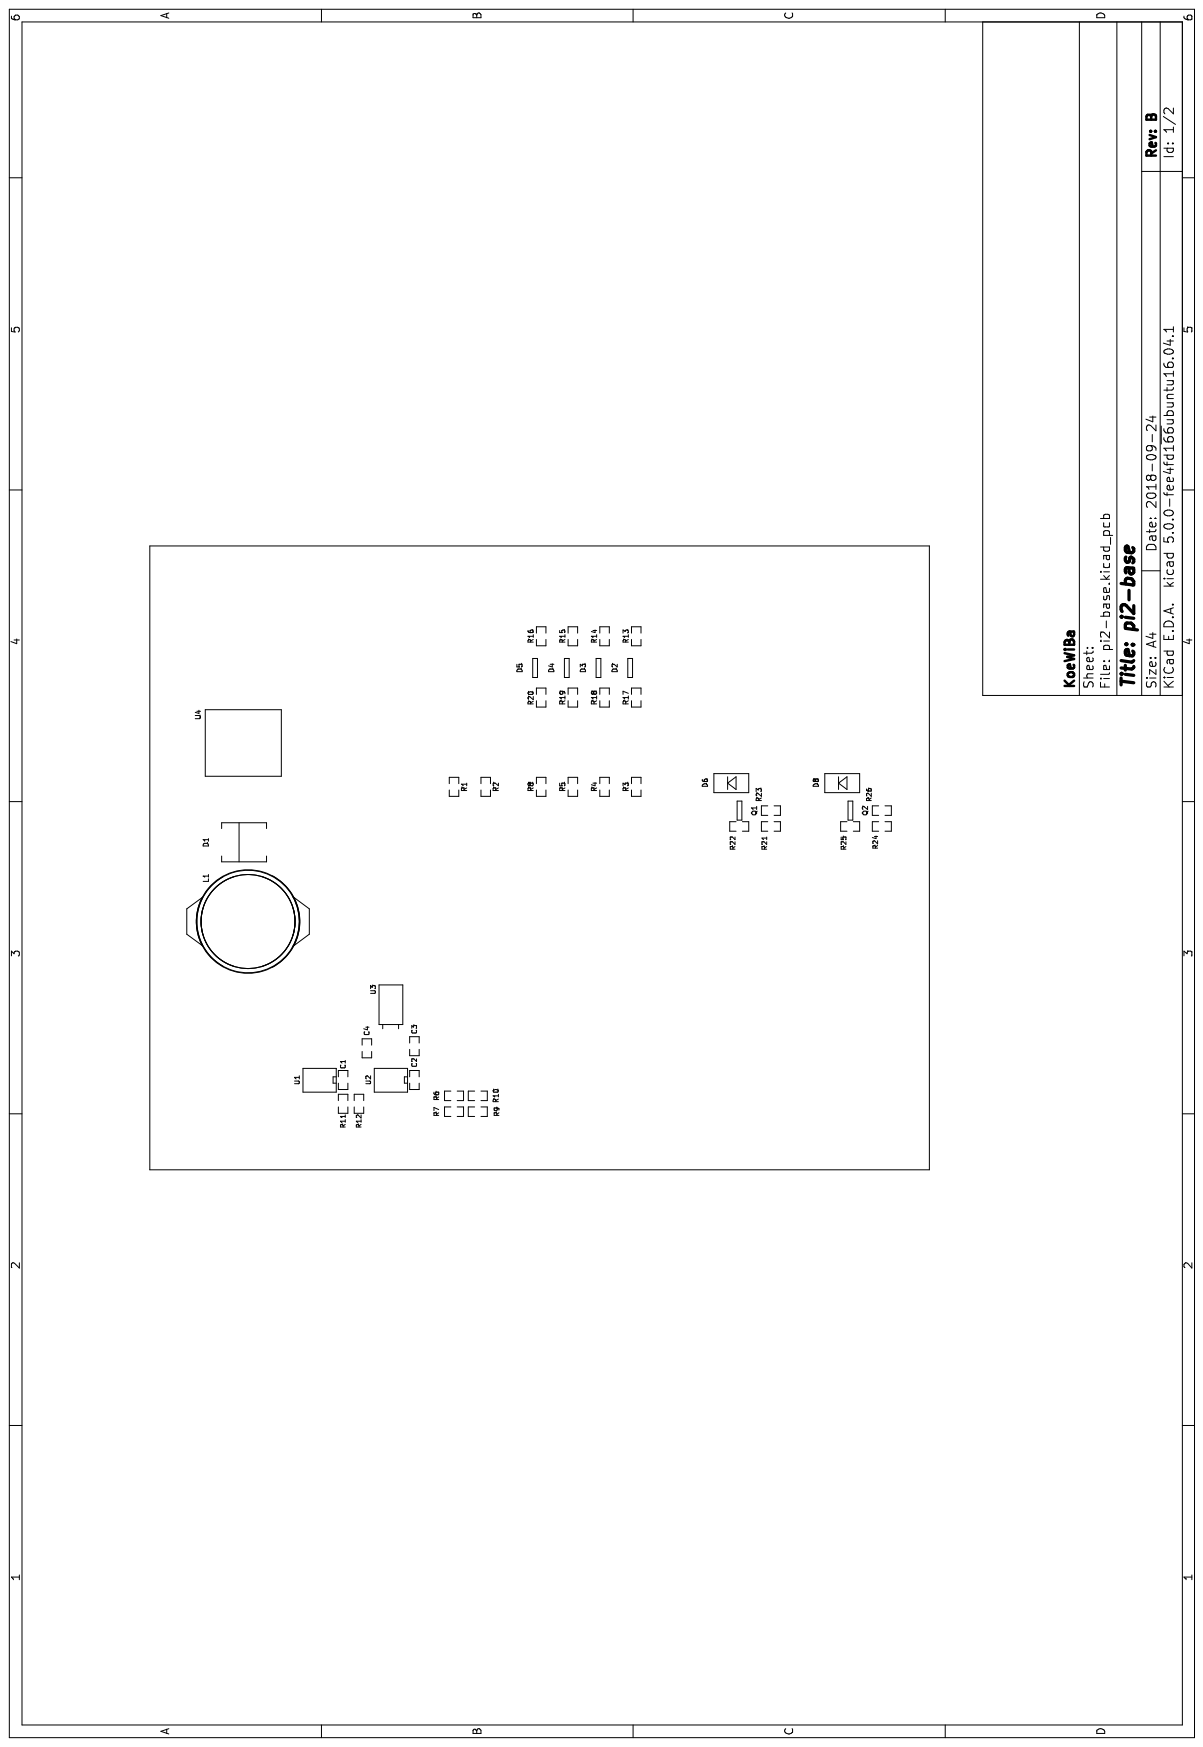
[picture p61: page 1]
