irqmask/koewiba-domotic/hw/pi2-base/doc/pi2-base_components_front.pdf

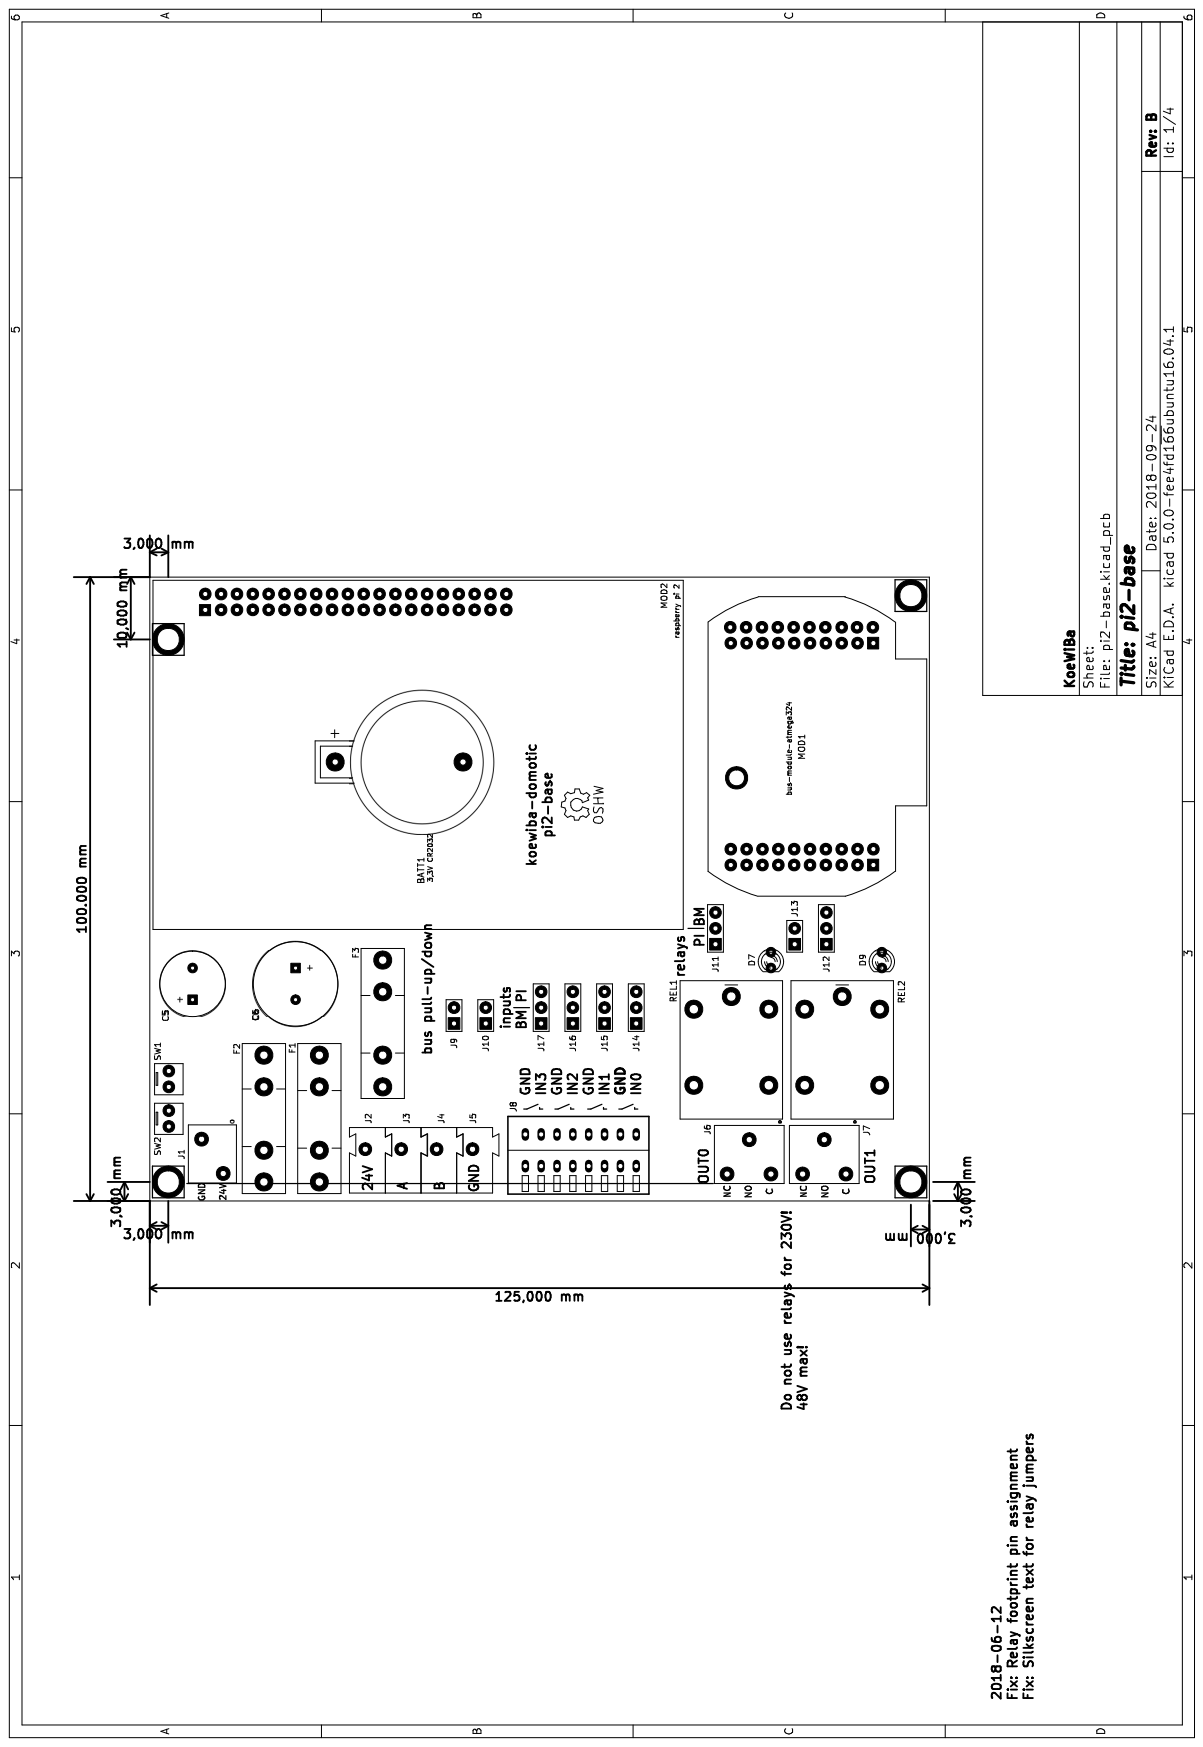
[picture p62: page 1]
