irqmask/koewiba-domotic/hw/gateway_usb/doc/gateway_usb_components_back.pdf

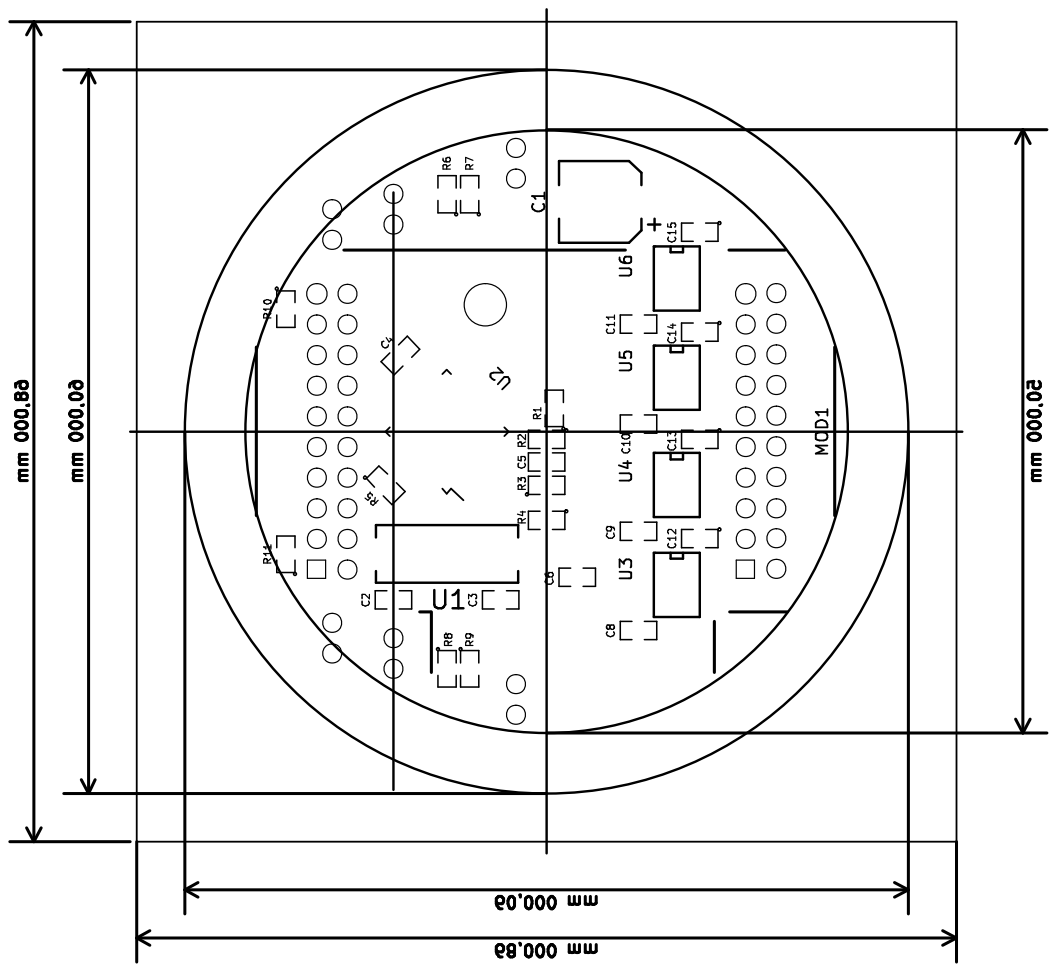
[picture p63: page 1]
