irqmask/koewiba-domotic/hw/gateway_usb/doc/gateway_usb_components_front.pdf

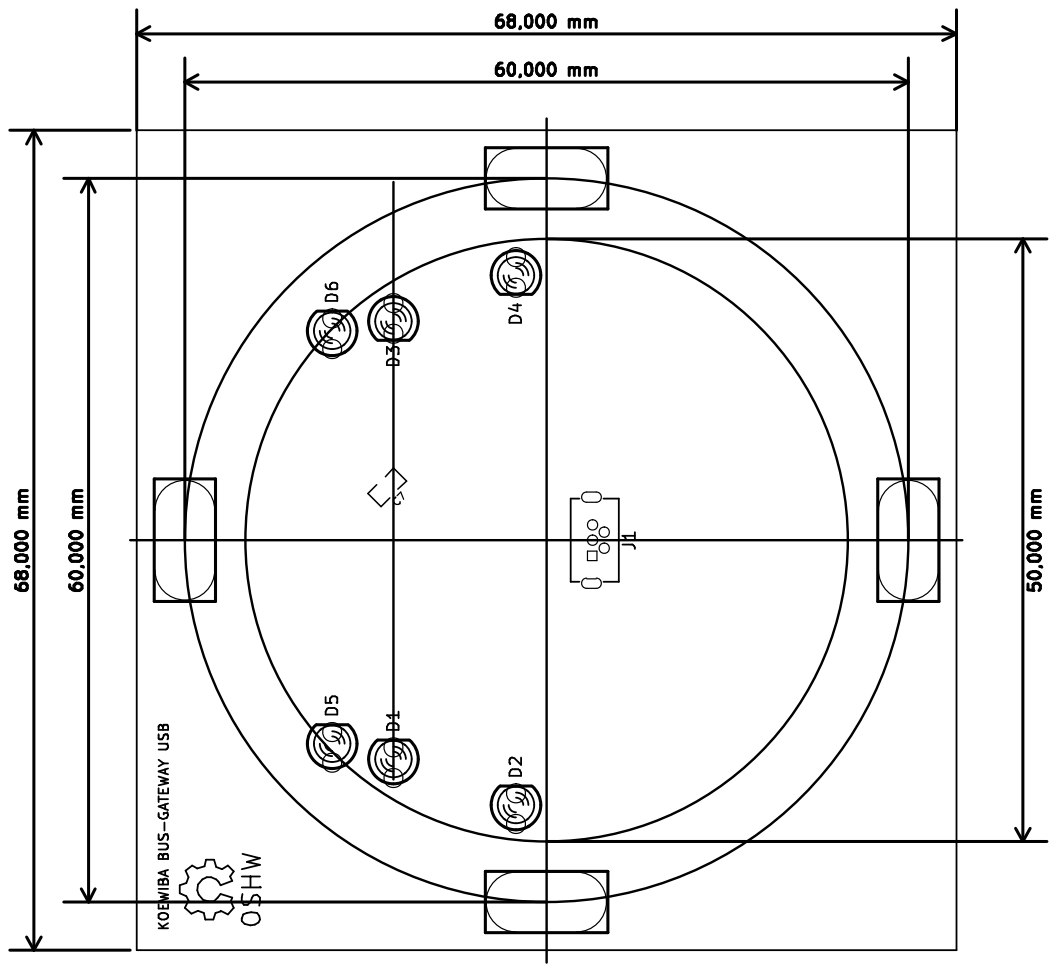
[picture p64: page 1]
