irqmask/koewiba-domotic/hw/pushbutton8/pushbutton8_rev3.pdf

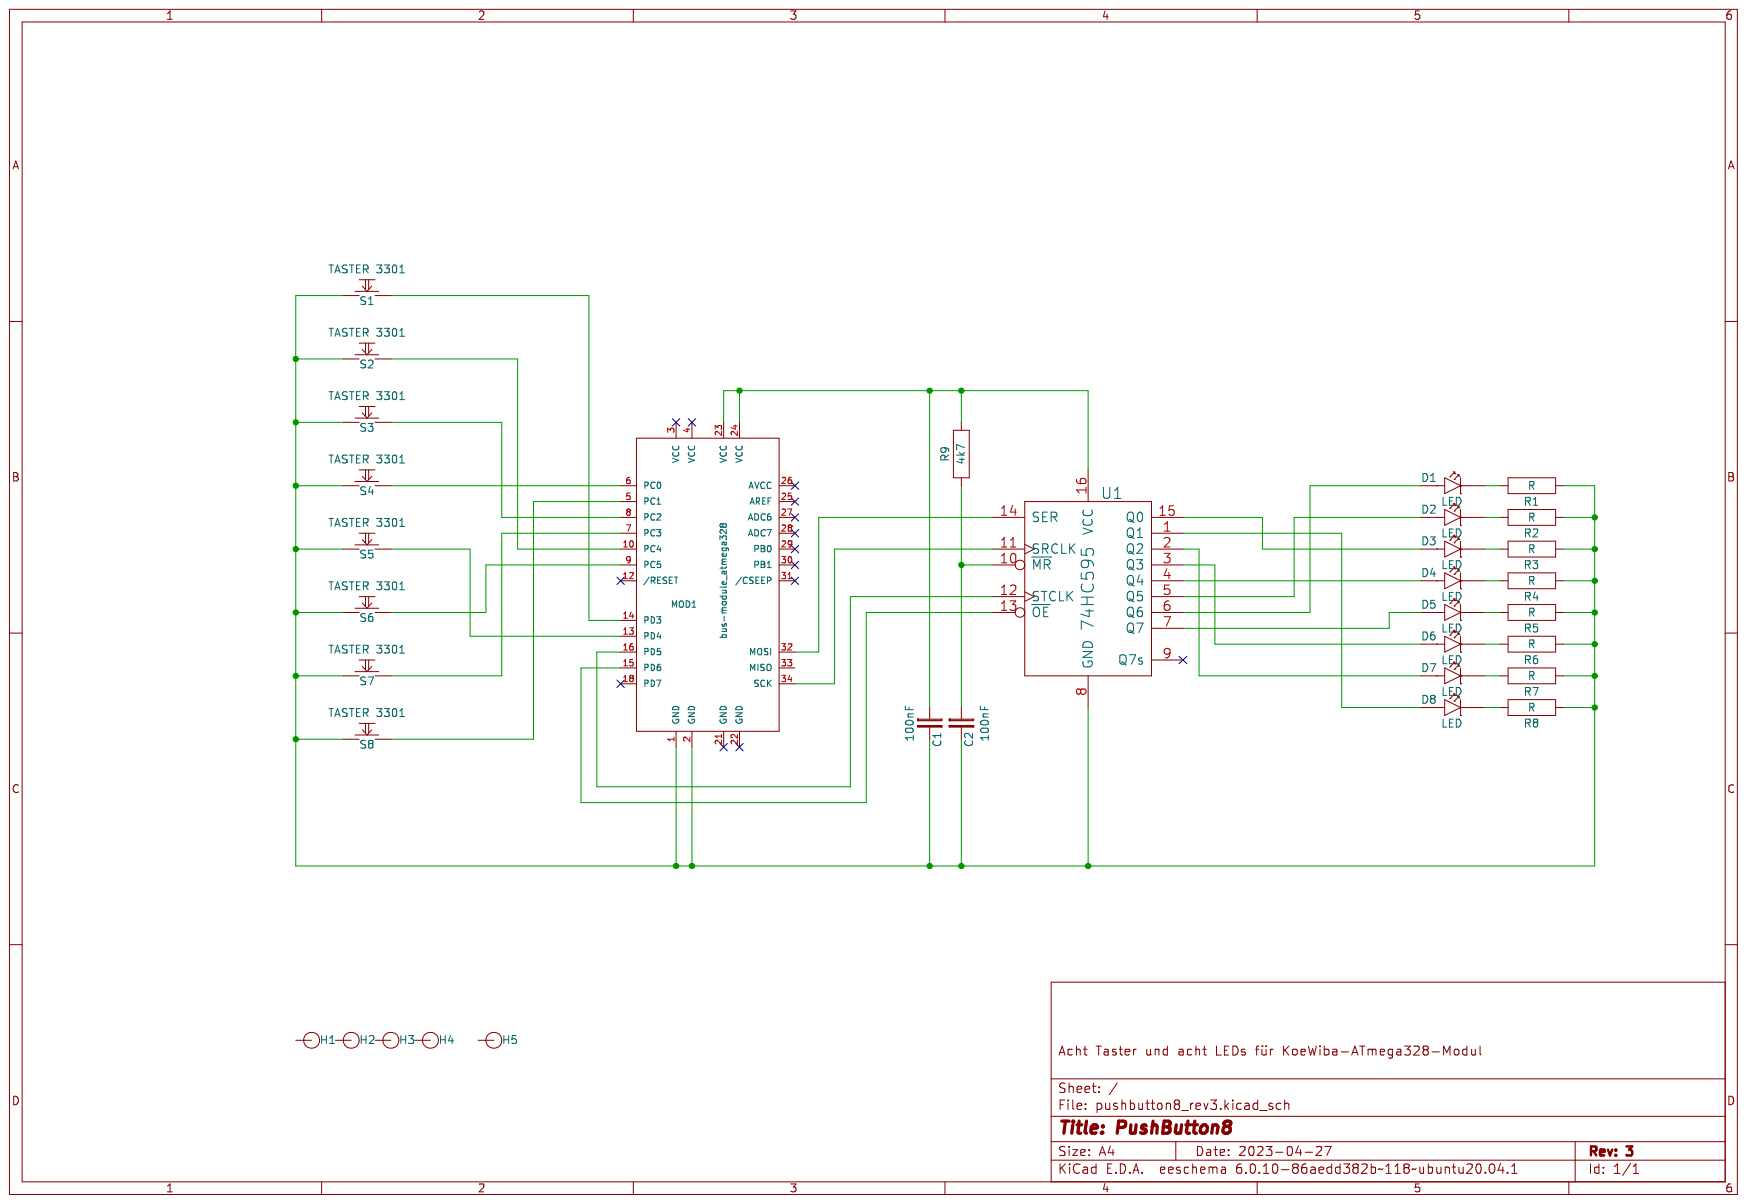
[picture p65: page 1]
