irqmask/koewiba-domotic/hw/koewibapi/koewibapi.pdf

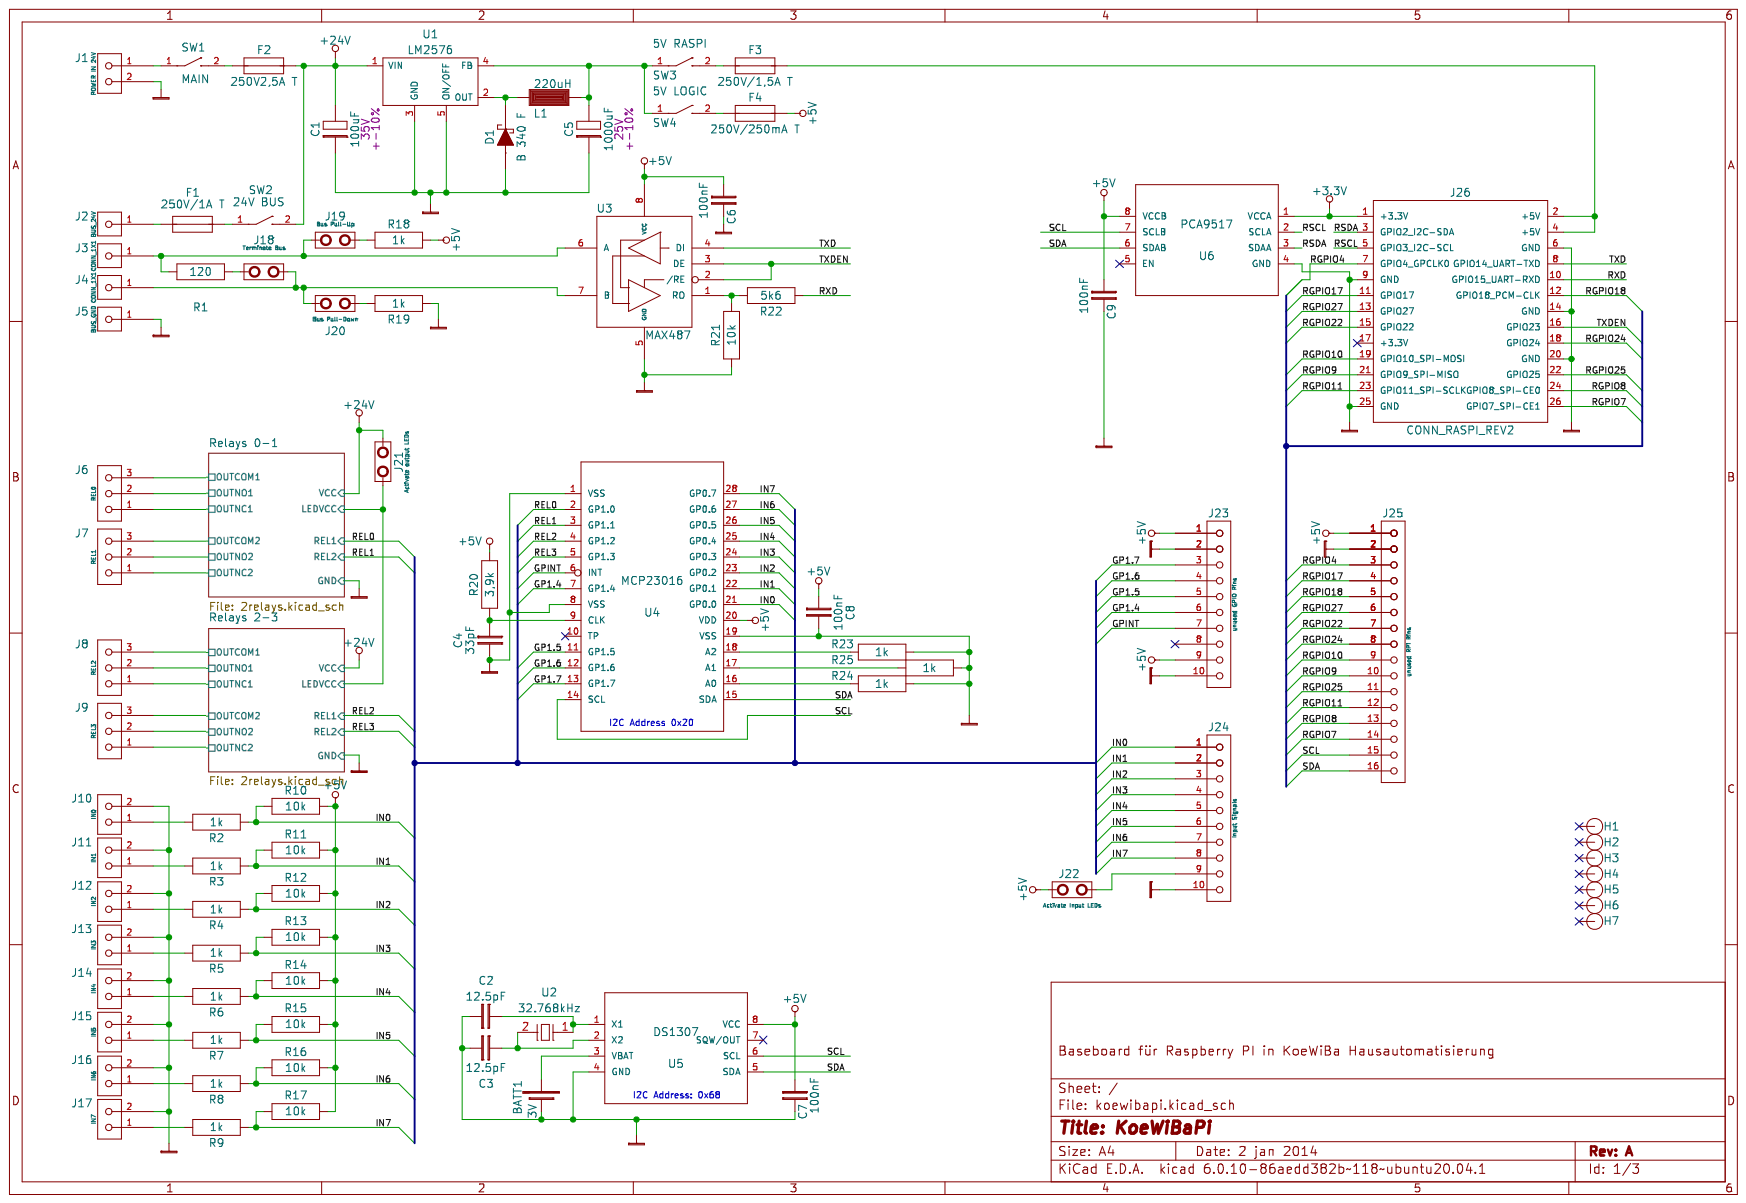
[picture p66: page 1]

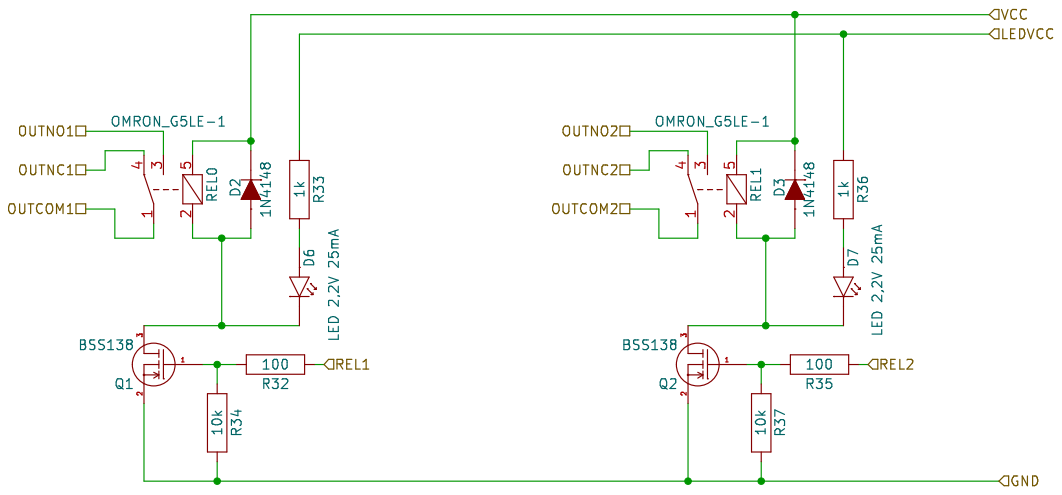
[picture p67: page 2]

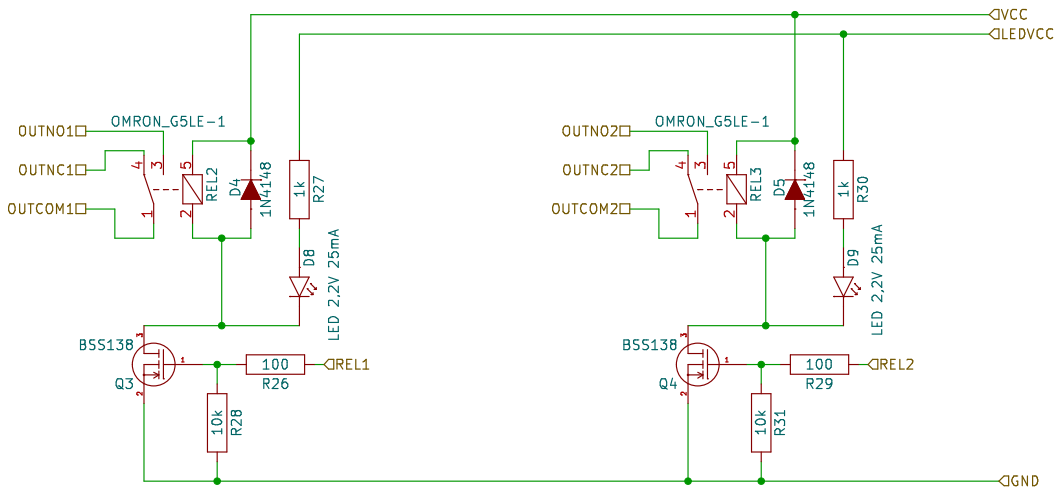
[picture p68: page 3]
