irqmask/koewiba-domotic/hw/bus-module_atmega324/bus-module_atmega324.pdf

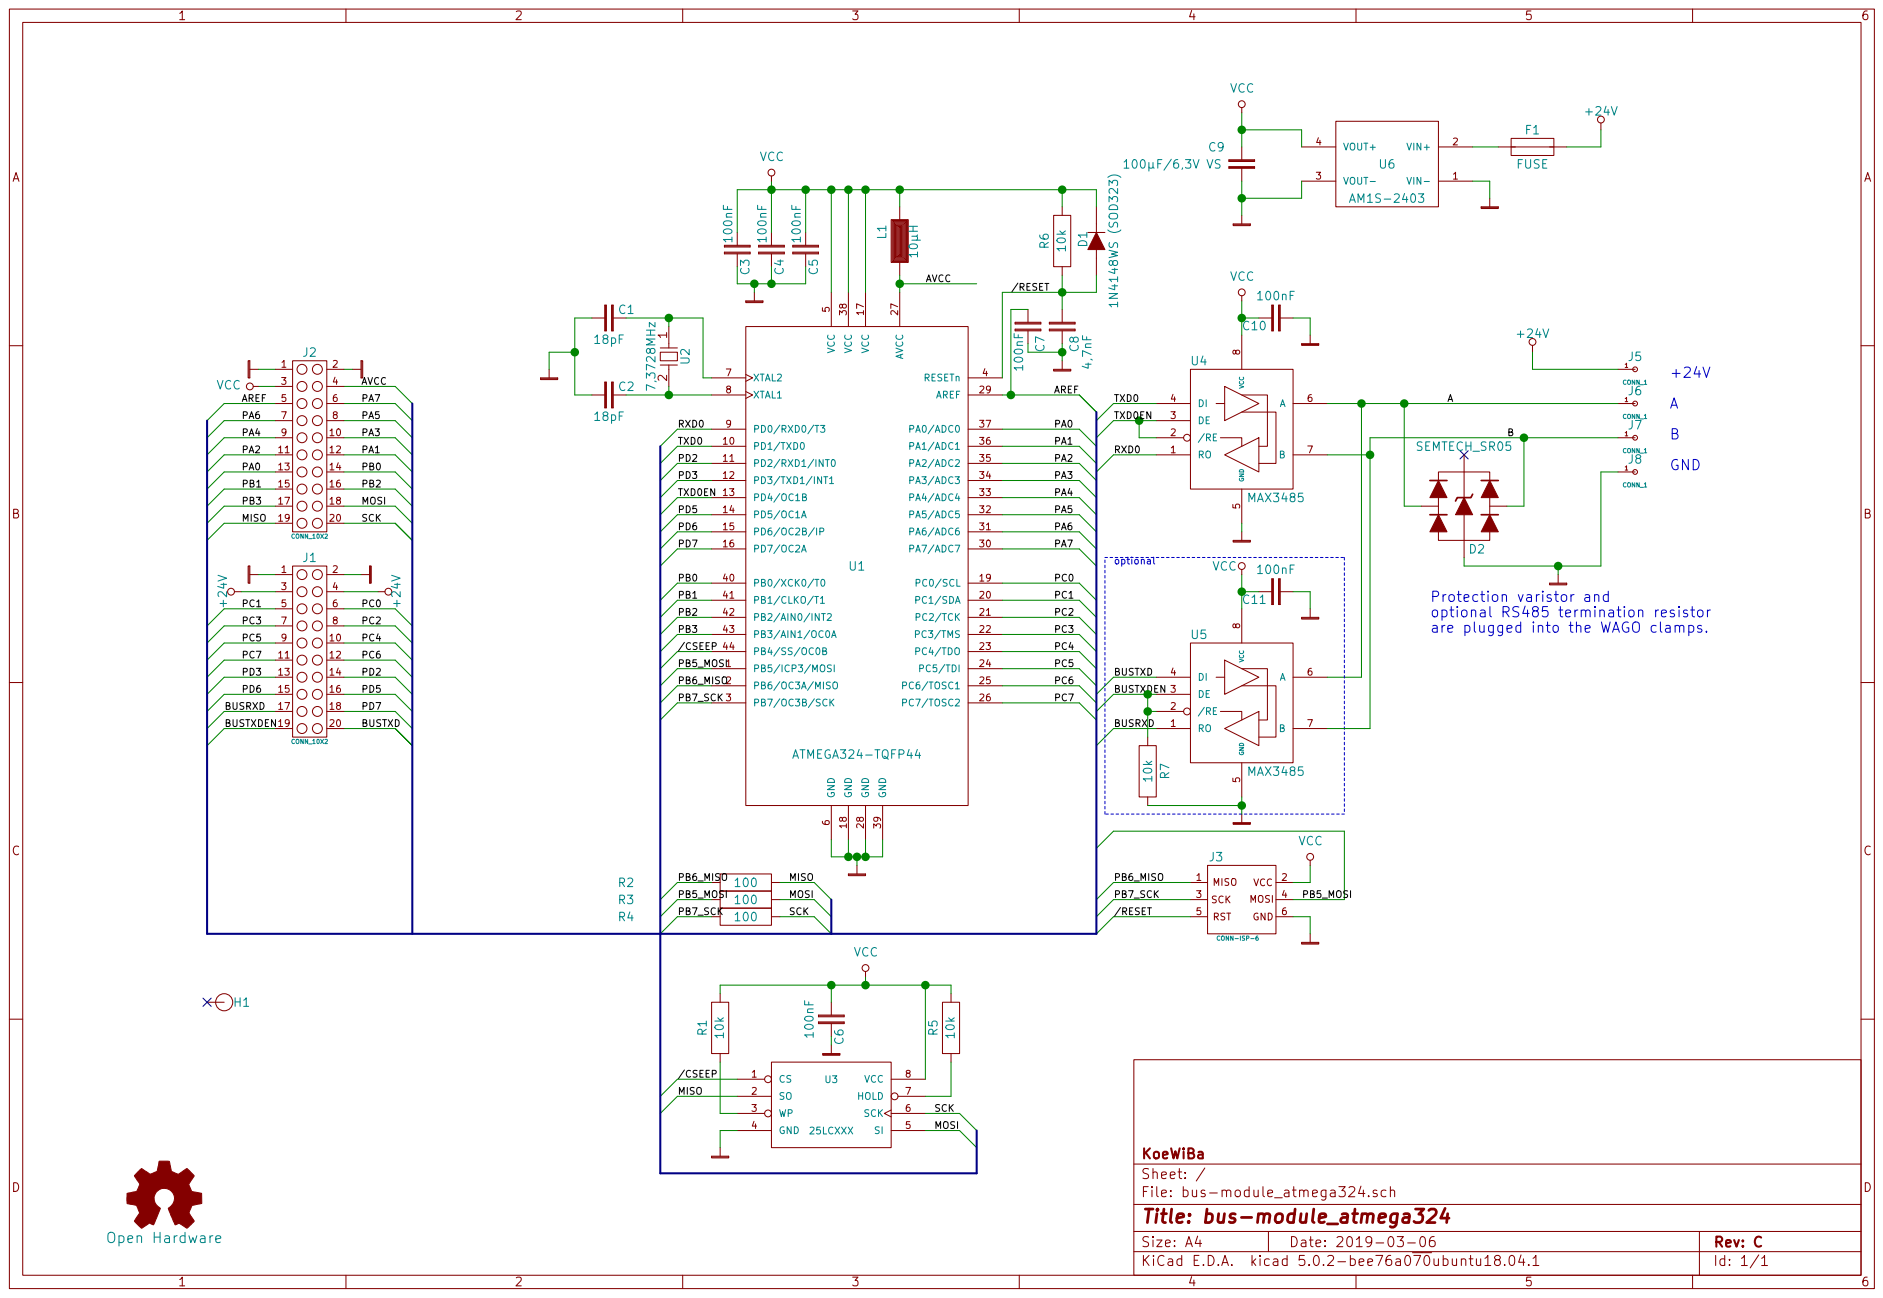
[picture p69: page 1]

File: bus-module_atmega324.sch Sheet: / KoeWiBa
