irqmask/koewiba-domotic/hw/bus-module_atmega328/bus-module_atmega328.pdf

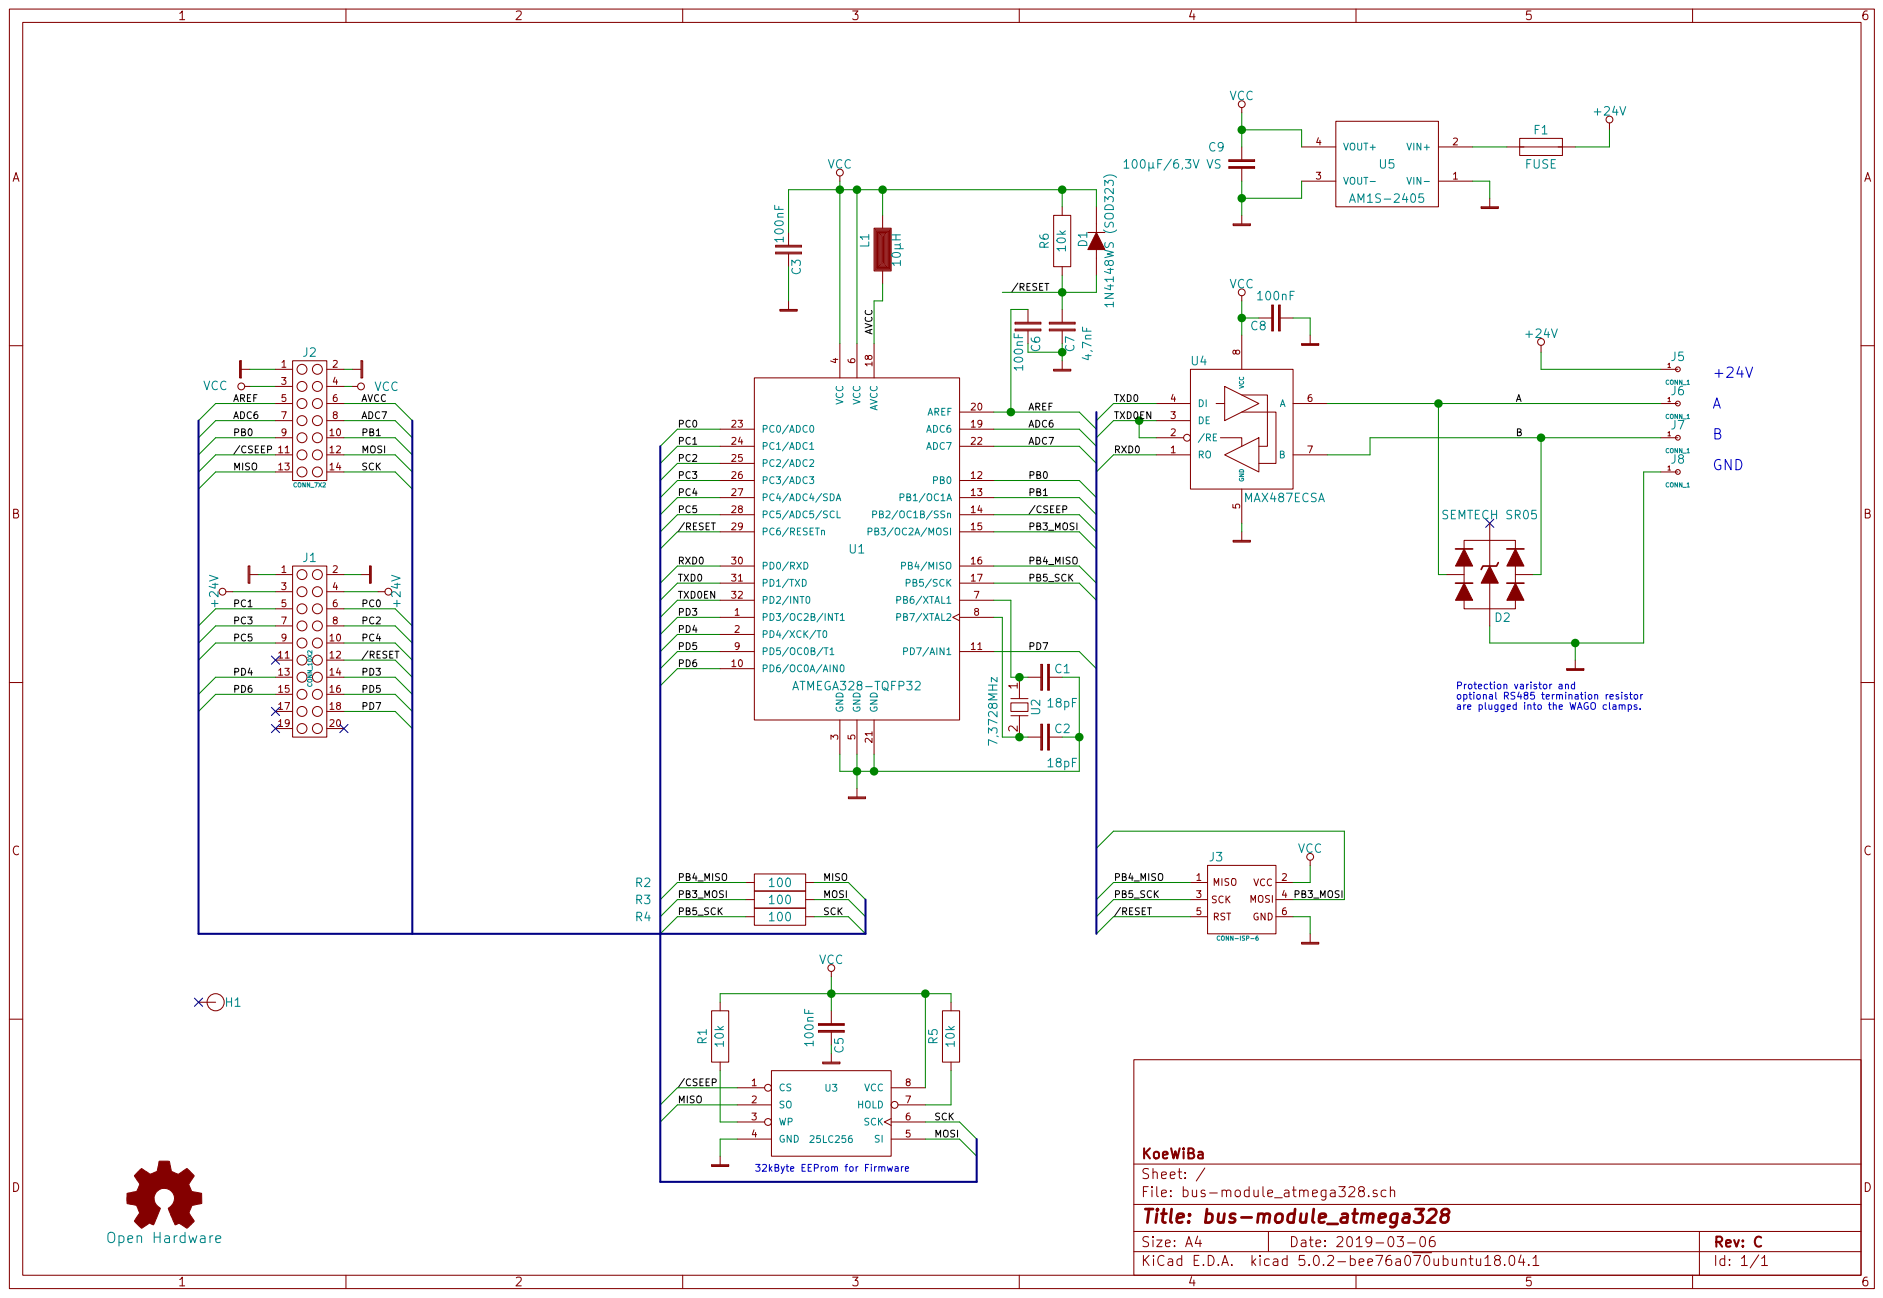
[picture p70: page 1]

File: bus-module_atmega328.sch Sheet: / KoeWiBa
