irqmask/koewiba-domotic/hw/templates/front_panel_for_60mm_wall_inlet.pdf

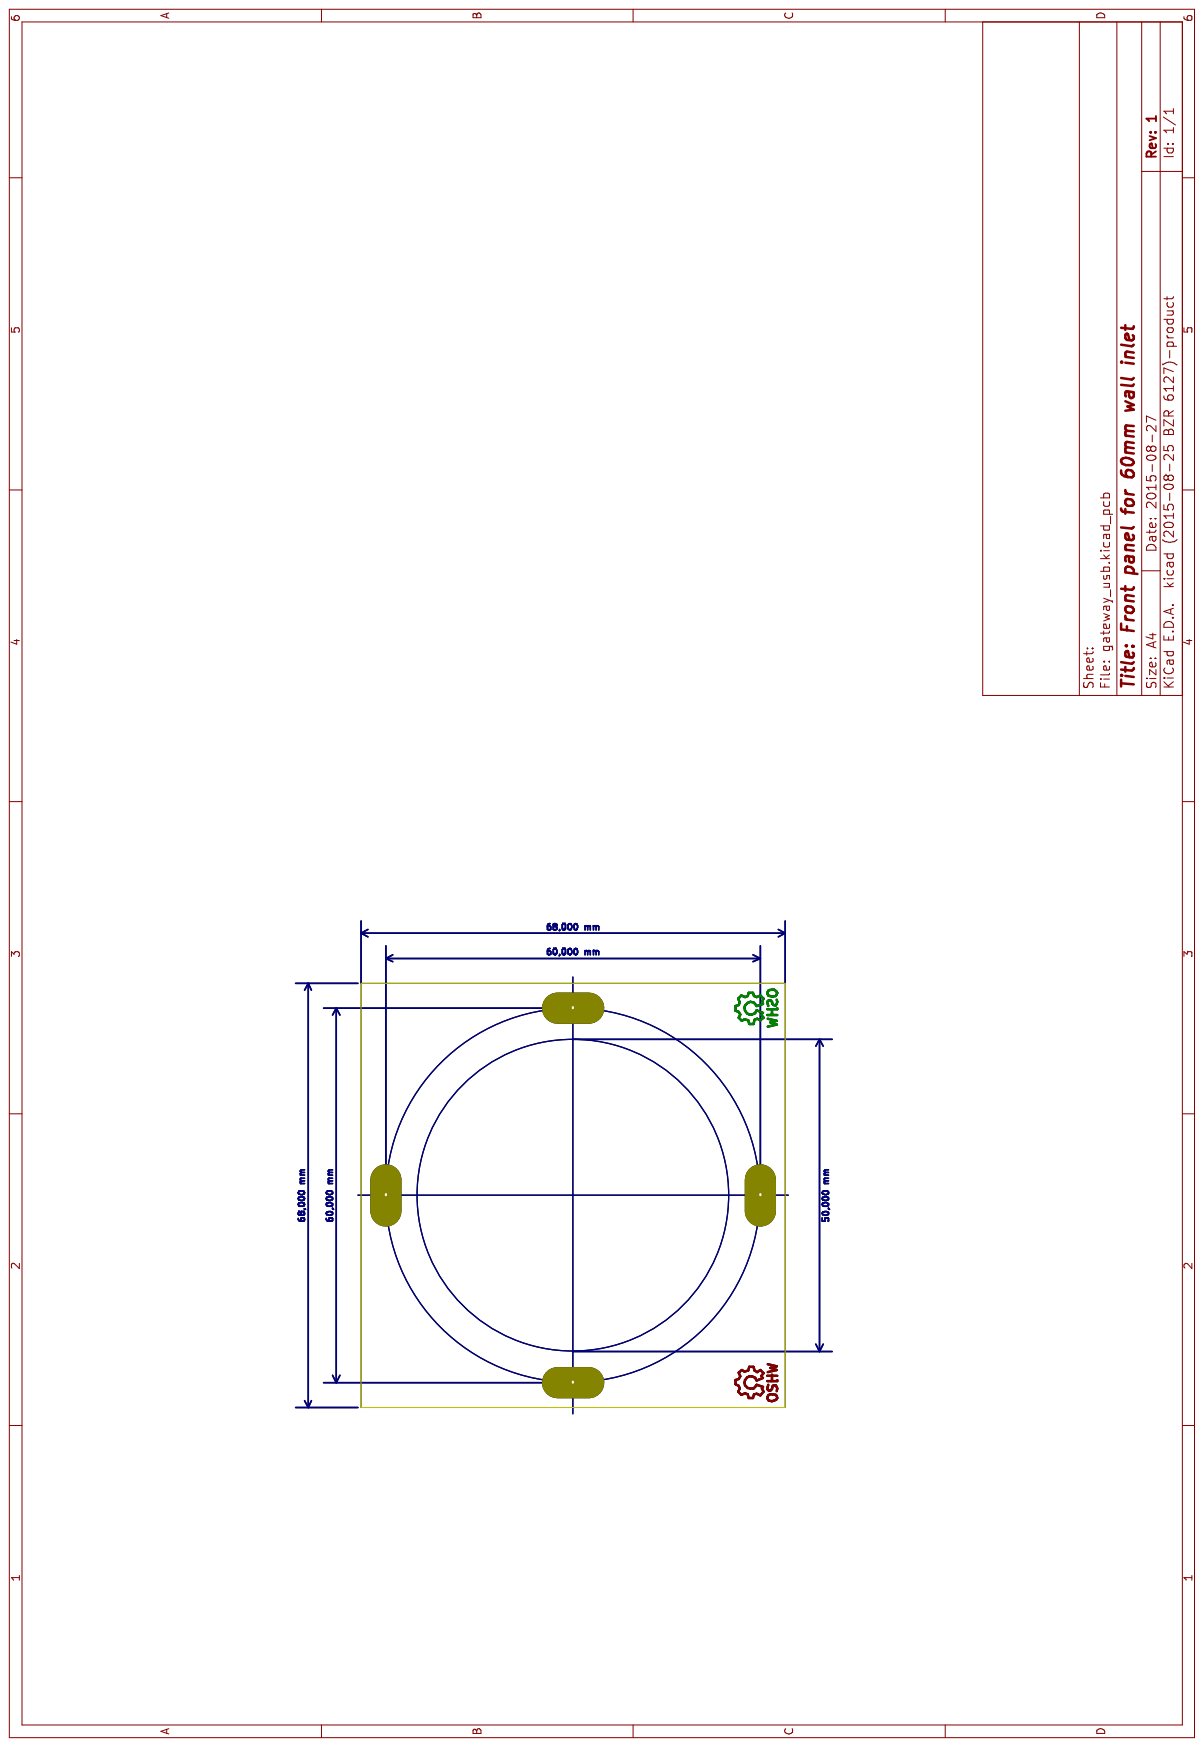
[picture p71: page 1]
