irqmask/koewiba-domotic/hw/motor_switch_3pole/doc/motor_switch_3pole_back.pdf

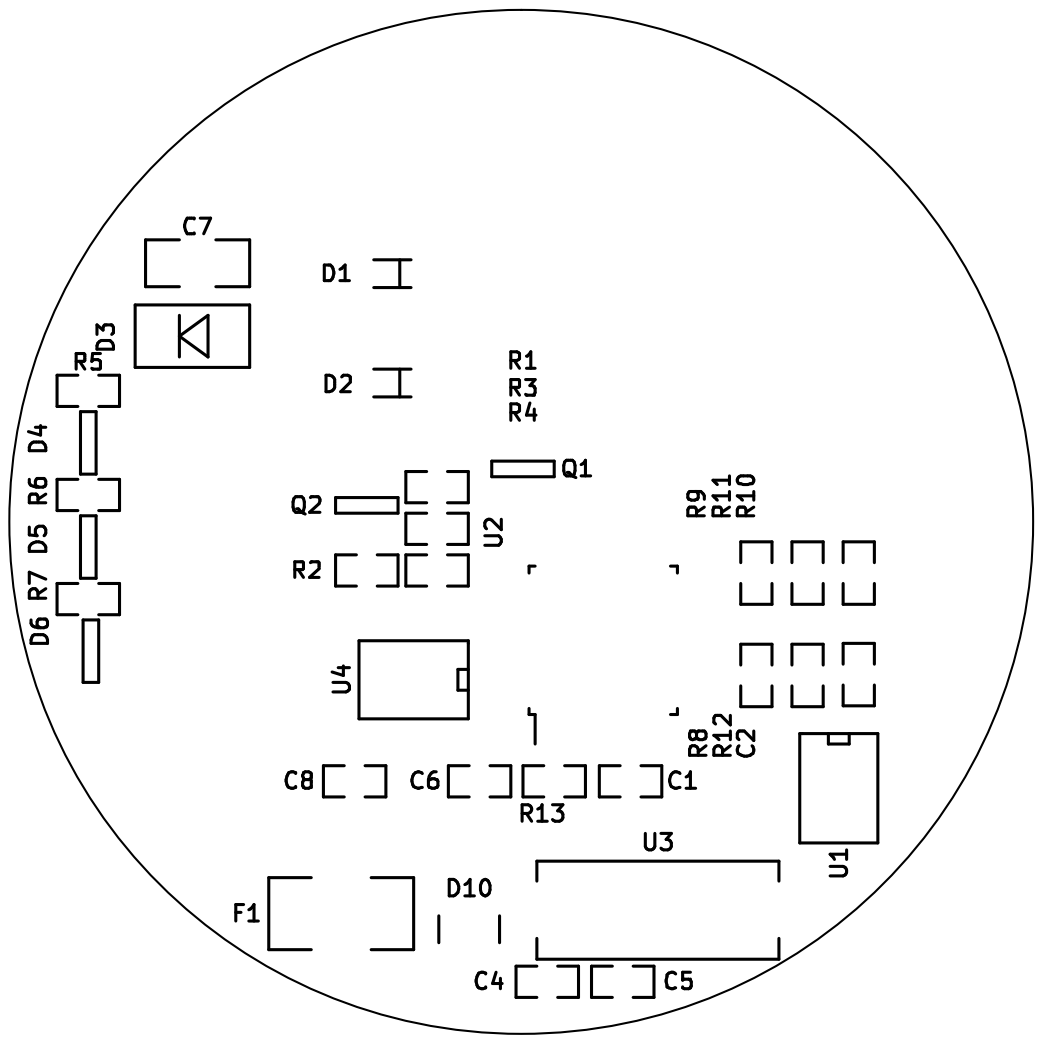
[picture p72: page 1]
