irqmask/koewiba-domotic/hw/motor_switch_3pole/doc/motor_switch_3pole_front.pdf

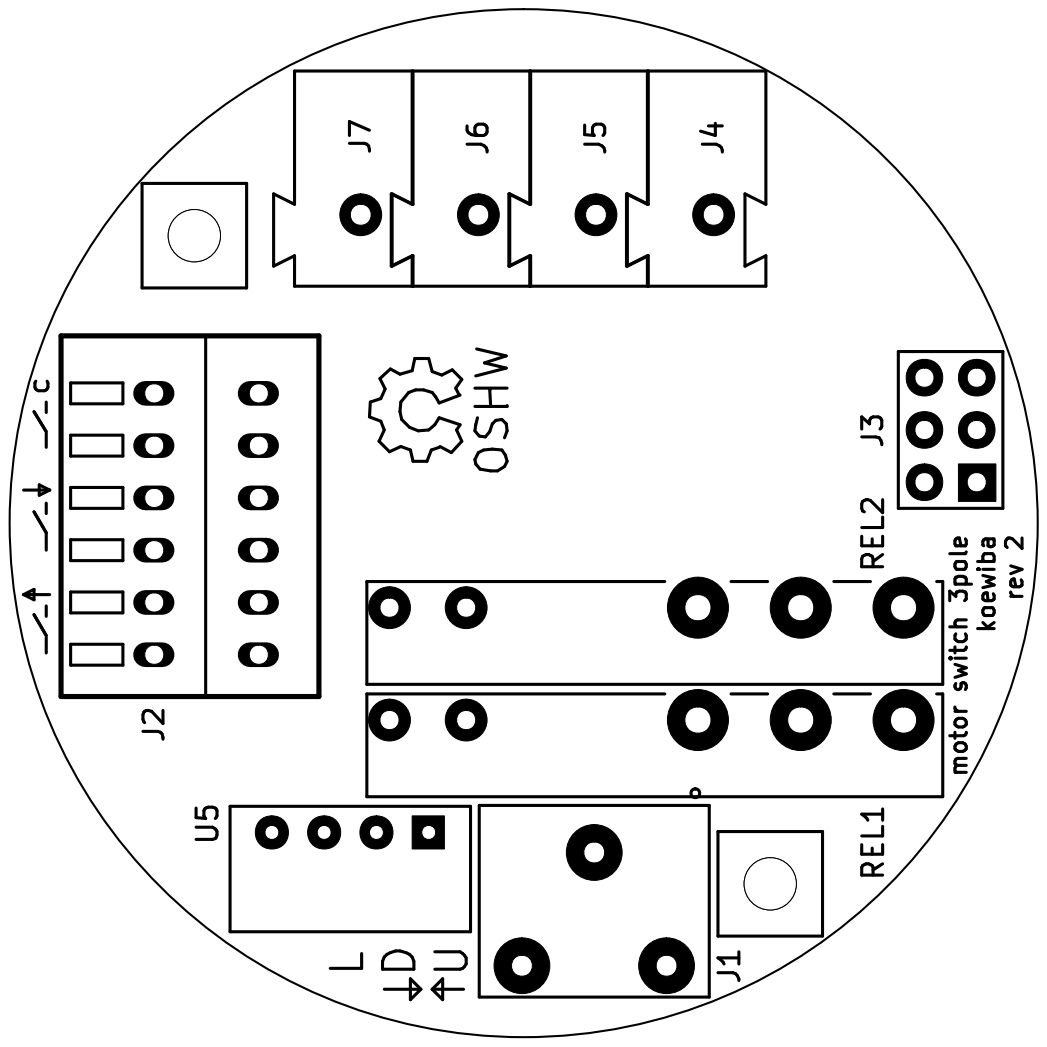
[picture p73: page 1]
