irqmask/koewiba-domotic/hw/motor_switch_3pole/doc/Rev1/motor_switch_3pole-B.Cu.pdf

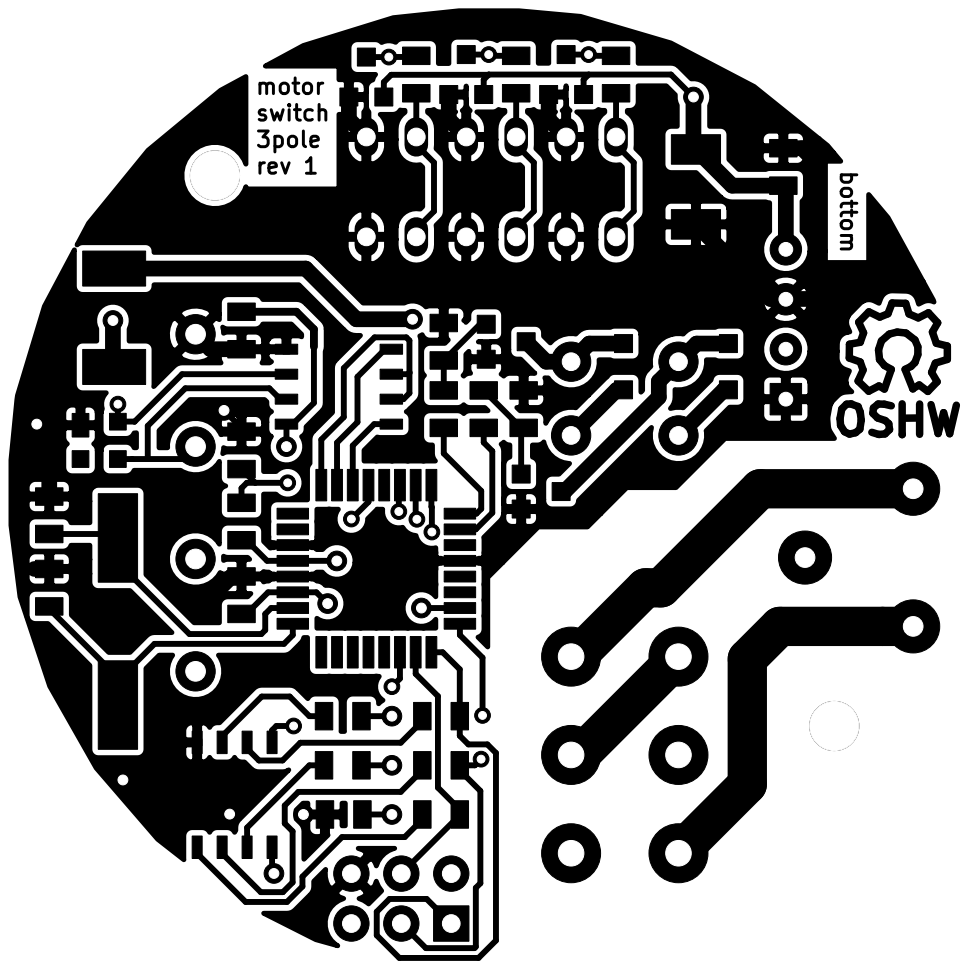
[picture p74: page 1]
