irqmask/koewiba-domotic/hw/motor_switch_3pole/doc/Rev1/motor_switch_3pole-B.SilkS.pdf

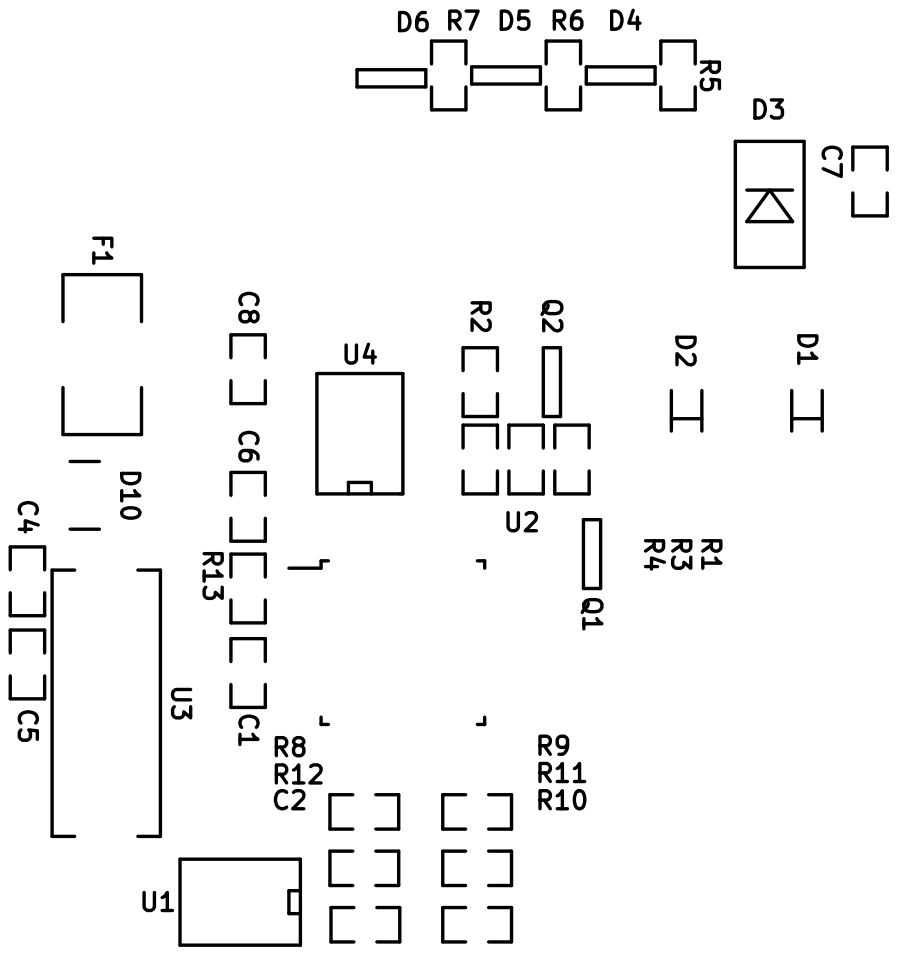
[picture p75: page 1]
