irqmask/koewiba-domotic/hw/motor_switch_3pole/doc/Rev1/motor_switch_3pole-F.Cu.pdf

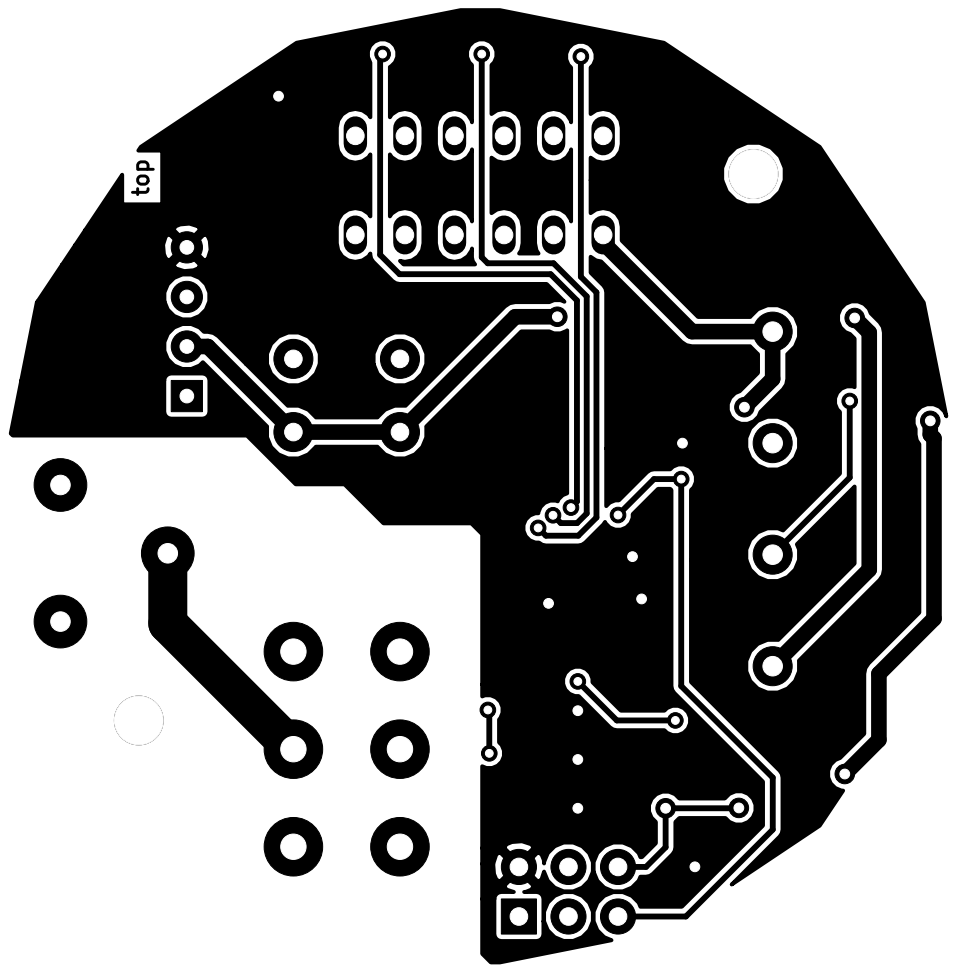
[picture p76: page 1]
