irqmask/koewiba-domotic/hw/pushbutton8/pushbutton8_rev1.pdf

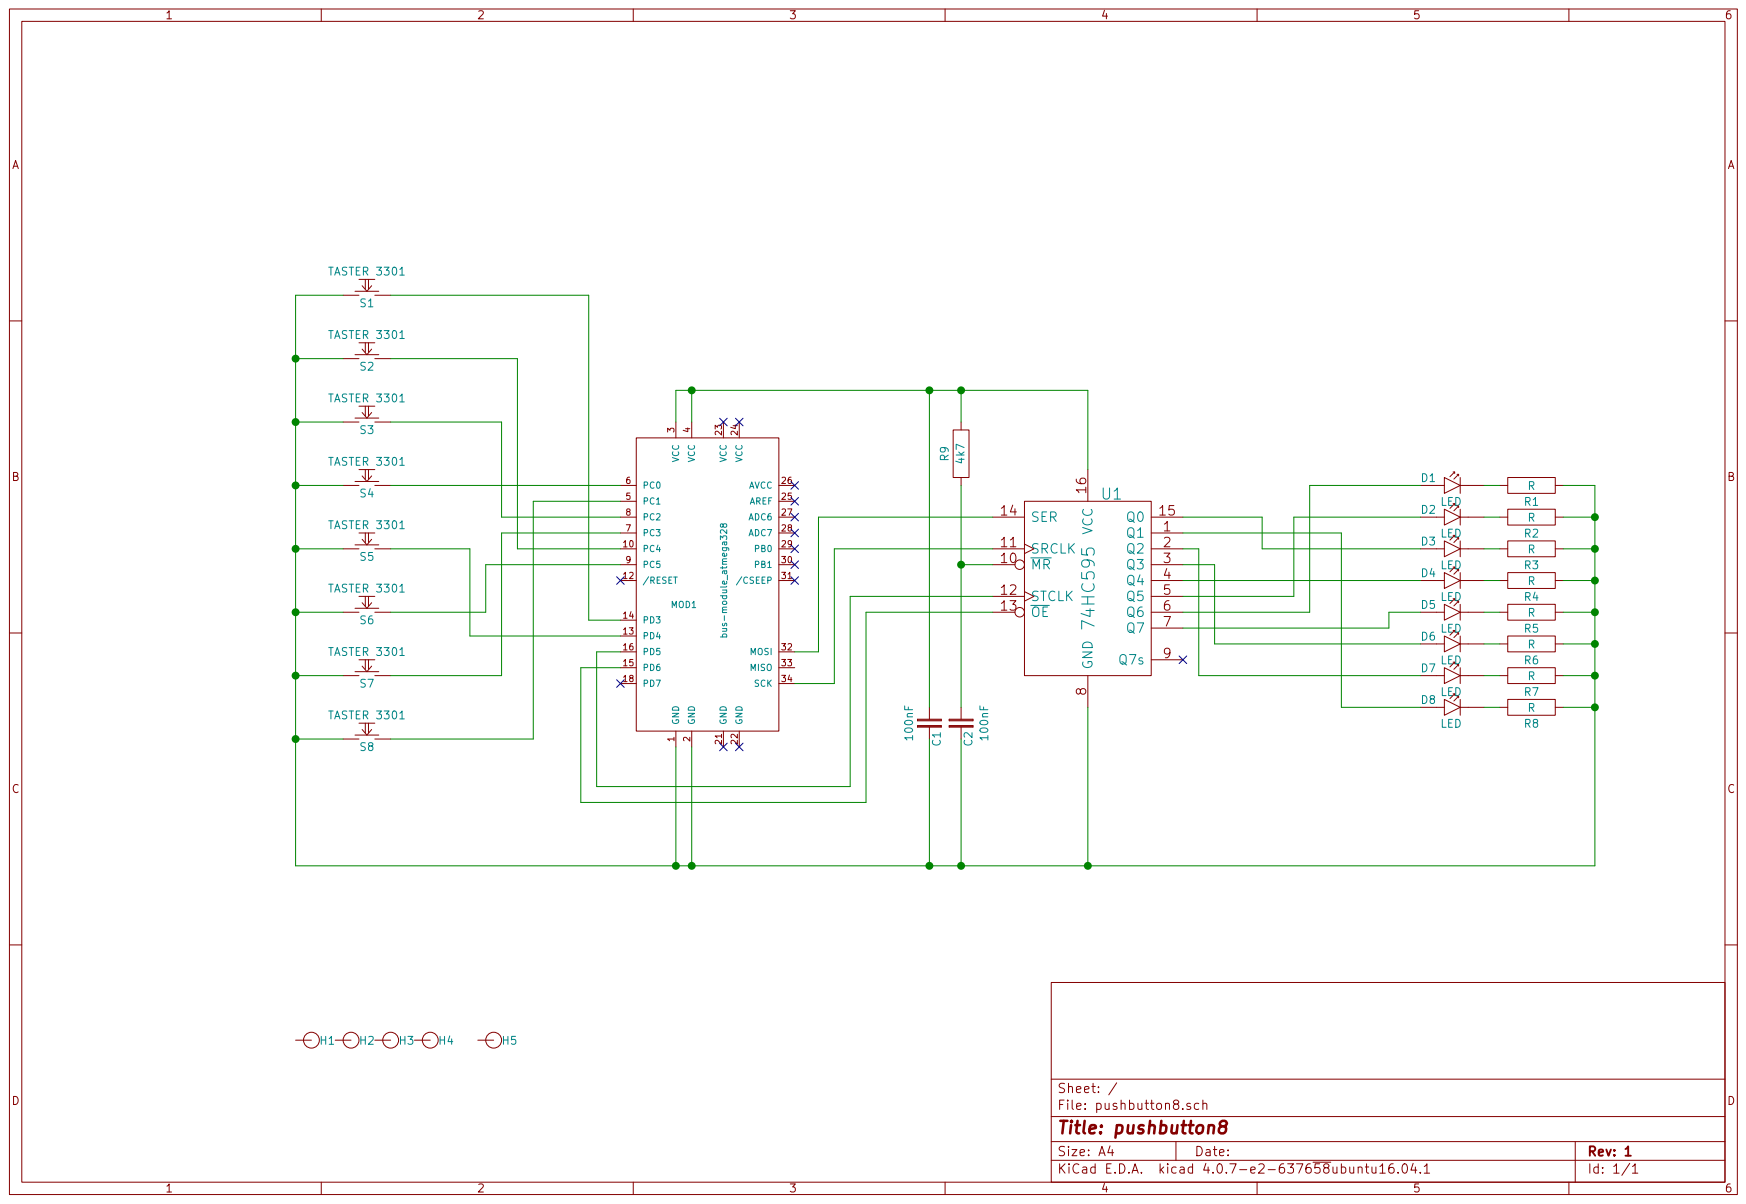
[picture p77: page 1]
