irqmask/koewiba-domotic/hw/bus-module_attiny1634/bus-module_attiny1634.kicad_pcb

## KiCad design hw/bus-module_attiny1634/bus-module_attiny1634.kicad_pcb (2023-12-06)

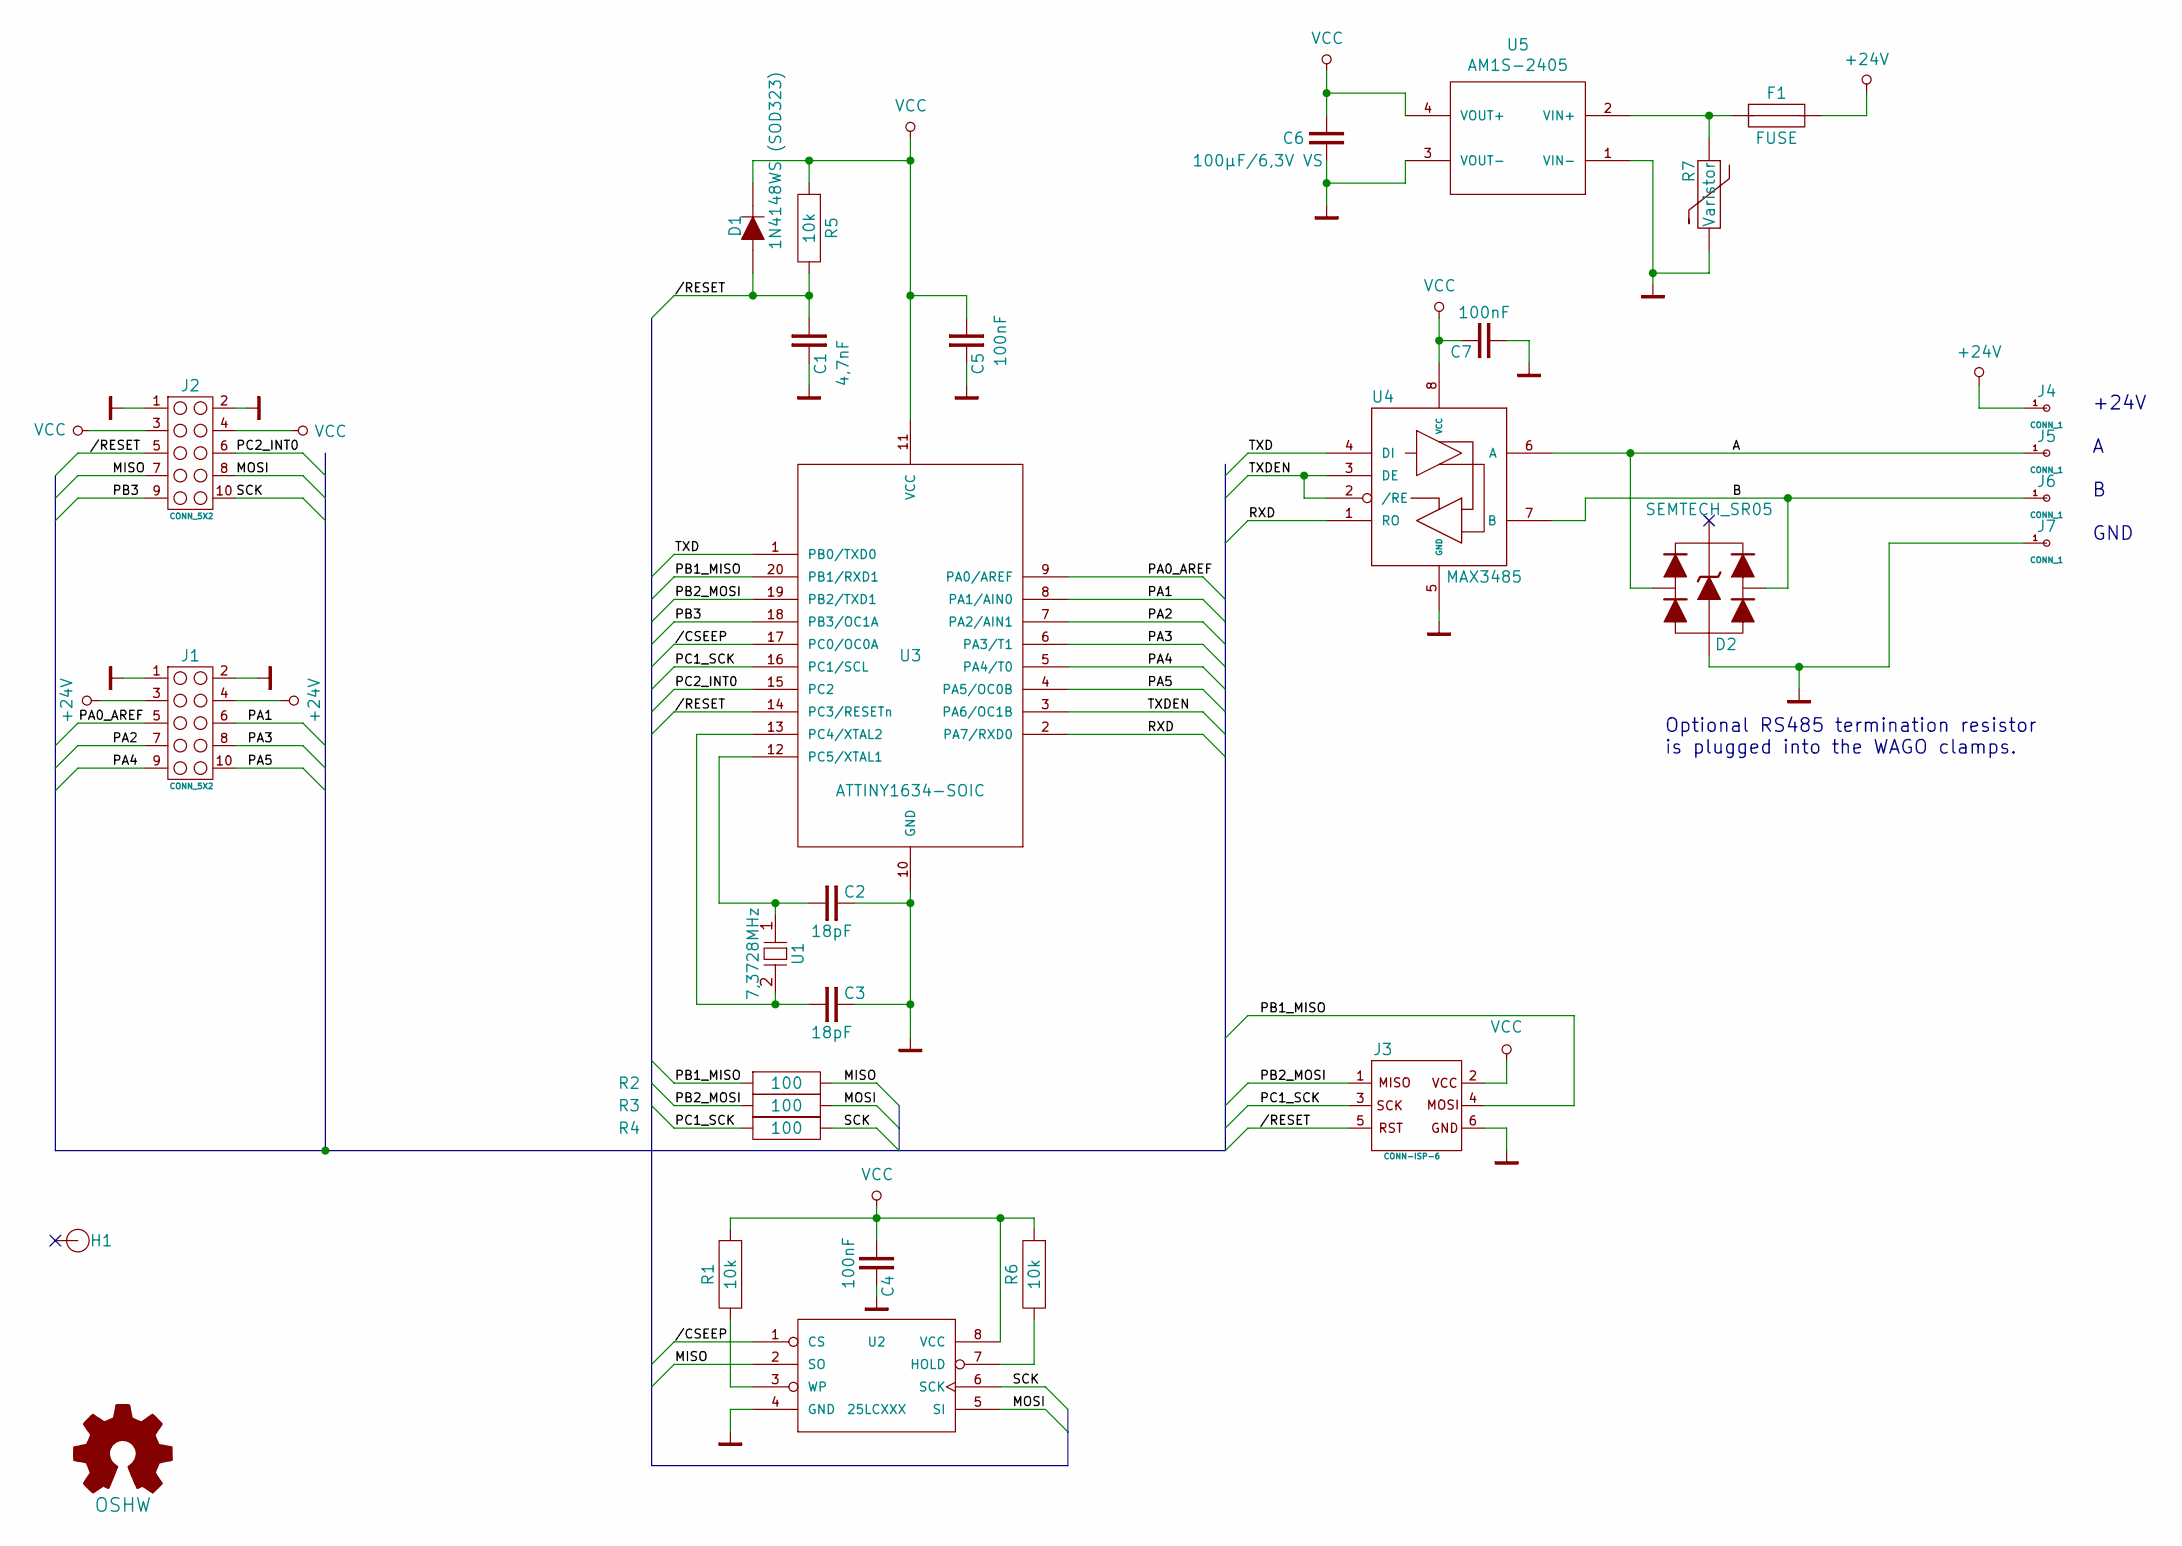
[picture p78: schematic bus-module_attiny1634.kicad_sch]

Parts:
C1: 4,7nF; C_0805
C2, C3: 18pF; C_0805
C4, C5, C7: 100nF; C_0805
C6: 100µF/6,3V VS; C_1206
D1: 1N4148WS (SOD323); D_SOD323
D2: SEMTECH_SR05; D_SOT143
F1: FUSE; R_1206
H1: HOLE; HOLE_2.5mm
J1, J2: CONN_5X2; HEADER_5x2
J3: CONN-ISP-6; HEADER_3x2
J4, J5, J6, J7: CONN_1; WAGO243
LOGO1: OSHW; Symbol_OSHW-Logo_SilkScreen
R1, R5, R6: 10k; R_0805
R2, R3, R4: 100; R_0805
R7: Varistor; R400
U1: 7,3728MHz; CRY_HC49_SMD
U2: 25LCXXX; SO8E
U3: ATTINY1634-SOIC; SO20L
U4: MAX3485; SO8E
U5: AM1S-2405; AM1S-XXXX_SIL4

Connections:
+24V: F1.2, J1.3, J1.4, J4.1
//CSEEP: U2.1 (CS), U3.17 (PC0/OC0A)
//RESET: C1.1, D1.1 (A), J2.5, J3.5, R5.2, U3.14 (PC3/RESETn)
/A: D2.4, J5.1, U4.6 (A)
/B: D2.3, J6.1, U4.7 (B)
/MISO: J2.7, R2.2, U2.2 (SO)
/MOSI: J2.8, R3.2, U2.5 (SI)
/PA0_AREF: J1.5, U3.9 (PA0/AREF)
/PA1: J1.6, U3.8 (PA1/AIN0)
/PA2: J1.7, U3.7 (PA2/AIN1)
/PA3: J1.8, U3.6 (PA3/T1)
/PA4: J1.9, U3.5 (PA4/T0)
/PA5: J1.10, U3.4 (PA5/OC0B)
/PB1_MISO: J3.4, R2.1, U3.20 (PB1/RXD1)
/PB2_MOSI: J3.1, R3.1, U3.19 (PB2/TXD1)
/PB3: J2.9, U3.18 (PB3/OC1A)
/PC1_SCK: J3.3, R4.1, U3.16 (PC1/SCL)
/PC2_INT0: J2.6, U3.15 (PC2)
/RXD: U3.2 (PA7/RXD0), U4.1 (RO)
/SCK: J2.10, R4.2, U2.6 (SCK)
/TXD: U3.1 (PB0/TXD0), U4.4 (DI)
/TXDEN: U3.3 (PA6/OC1B), U4.2 (/RE), U4.3 (DE)
GND: C1.2, C2.2, C3.2, C4.2, C5.2, C6.2, C7.1, D2.1, J1.1, J1.2, J2.1, J2.2, J3.6, J7.1, R7.2, U2.4 (GND), U3.10 (GND), U4.5 (GND), U5.1 (VIN-), U5.3 (VOUT-)
unnamed: C2.1, U1.1, U3.12 (PC5/XTAL1)
unnamed: C3.1, U1.2, U3.13 (PC4/XTAL2)
unnamed: F1.1, R7.1, U5.2 (VIN+)
unnamed: R1.2, U2.3 (WP)
unnamed: R6.2, U2.7 (HOLD)
VCC: C4.1, C5.1, C6.1, C7.2, D1.2 (C), J2.3, J2.4, J3.2, R1.1, R5.1, R6.1, U2.8 (VCC), U3.11 (VCC), U4.8 (VCC), U5.4 (VOUT+)

Notes on the sheet:
+24V A B GND
Optional RS485 termination resistor is plugged into the WAGO clamps.

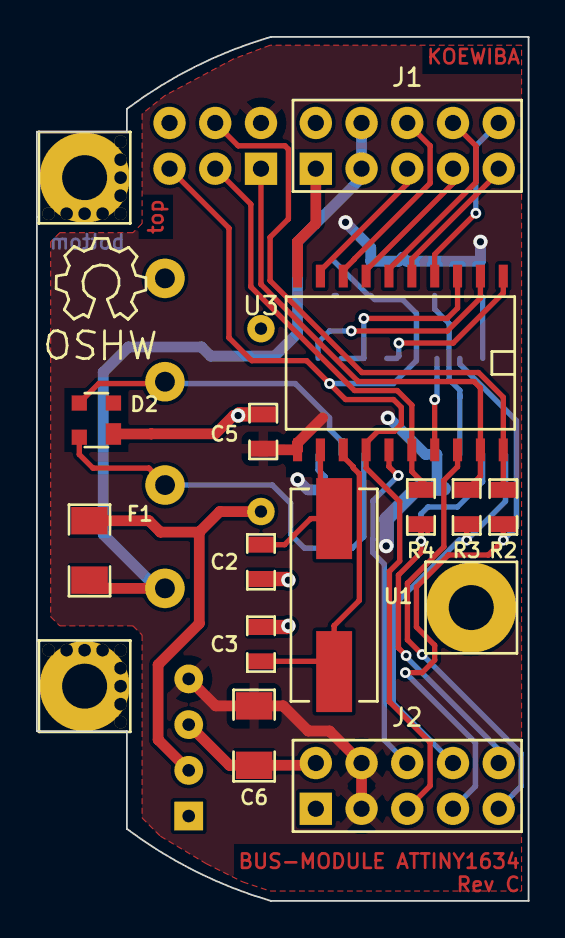
[picture p79: board bus-module_attiny1634.kicad_pcb from above]

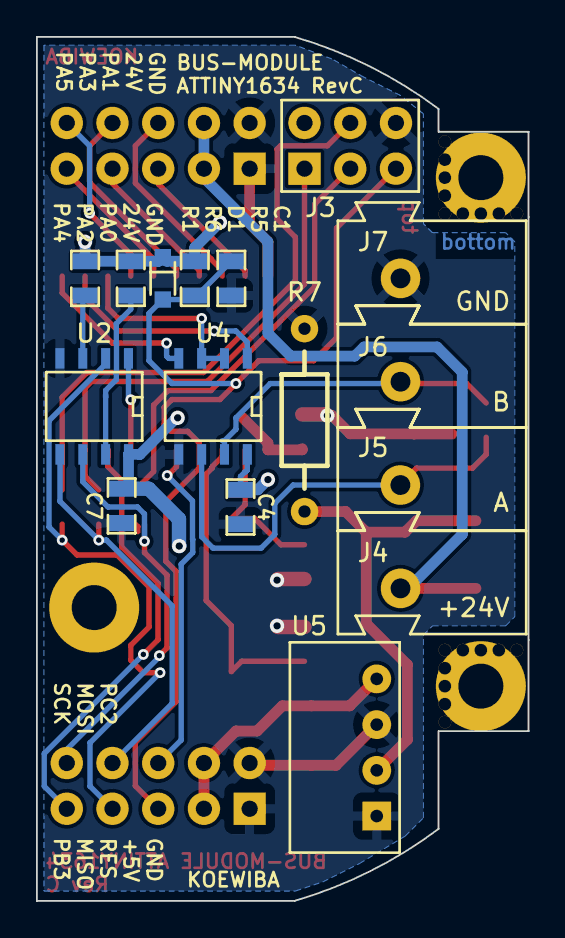
[picture p80: board bus-module_attiny1634.kicad_pcb from below]

Board: 2 copper layers, 27.3 x 48.0 mm, 33 parts (16 on the bottom side), 29 nets.

Other parts of the board:
HOLE_2.5mm, HOLE_2.5mm#2: VAL**; HOLE_2.5mm
