irqmask/koewiba-domotic/hw/bus-module_atmega328/bus-module_atmega328.kicad_pcb

## KiCad design hw/bus-module_atmega328/bus-module_atmega328.kicad_pcb (2023-12-06)

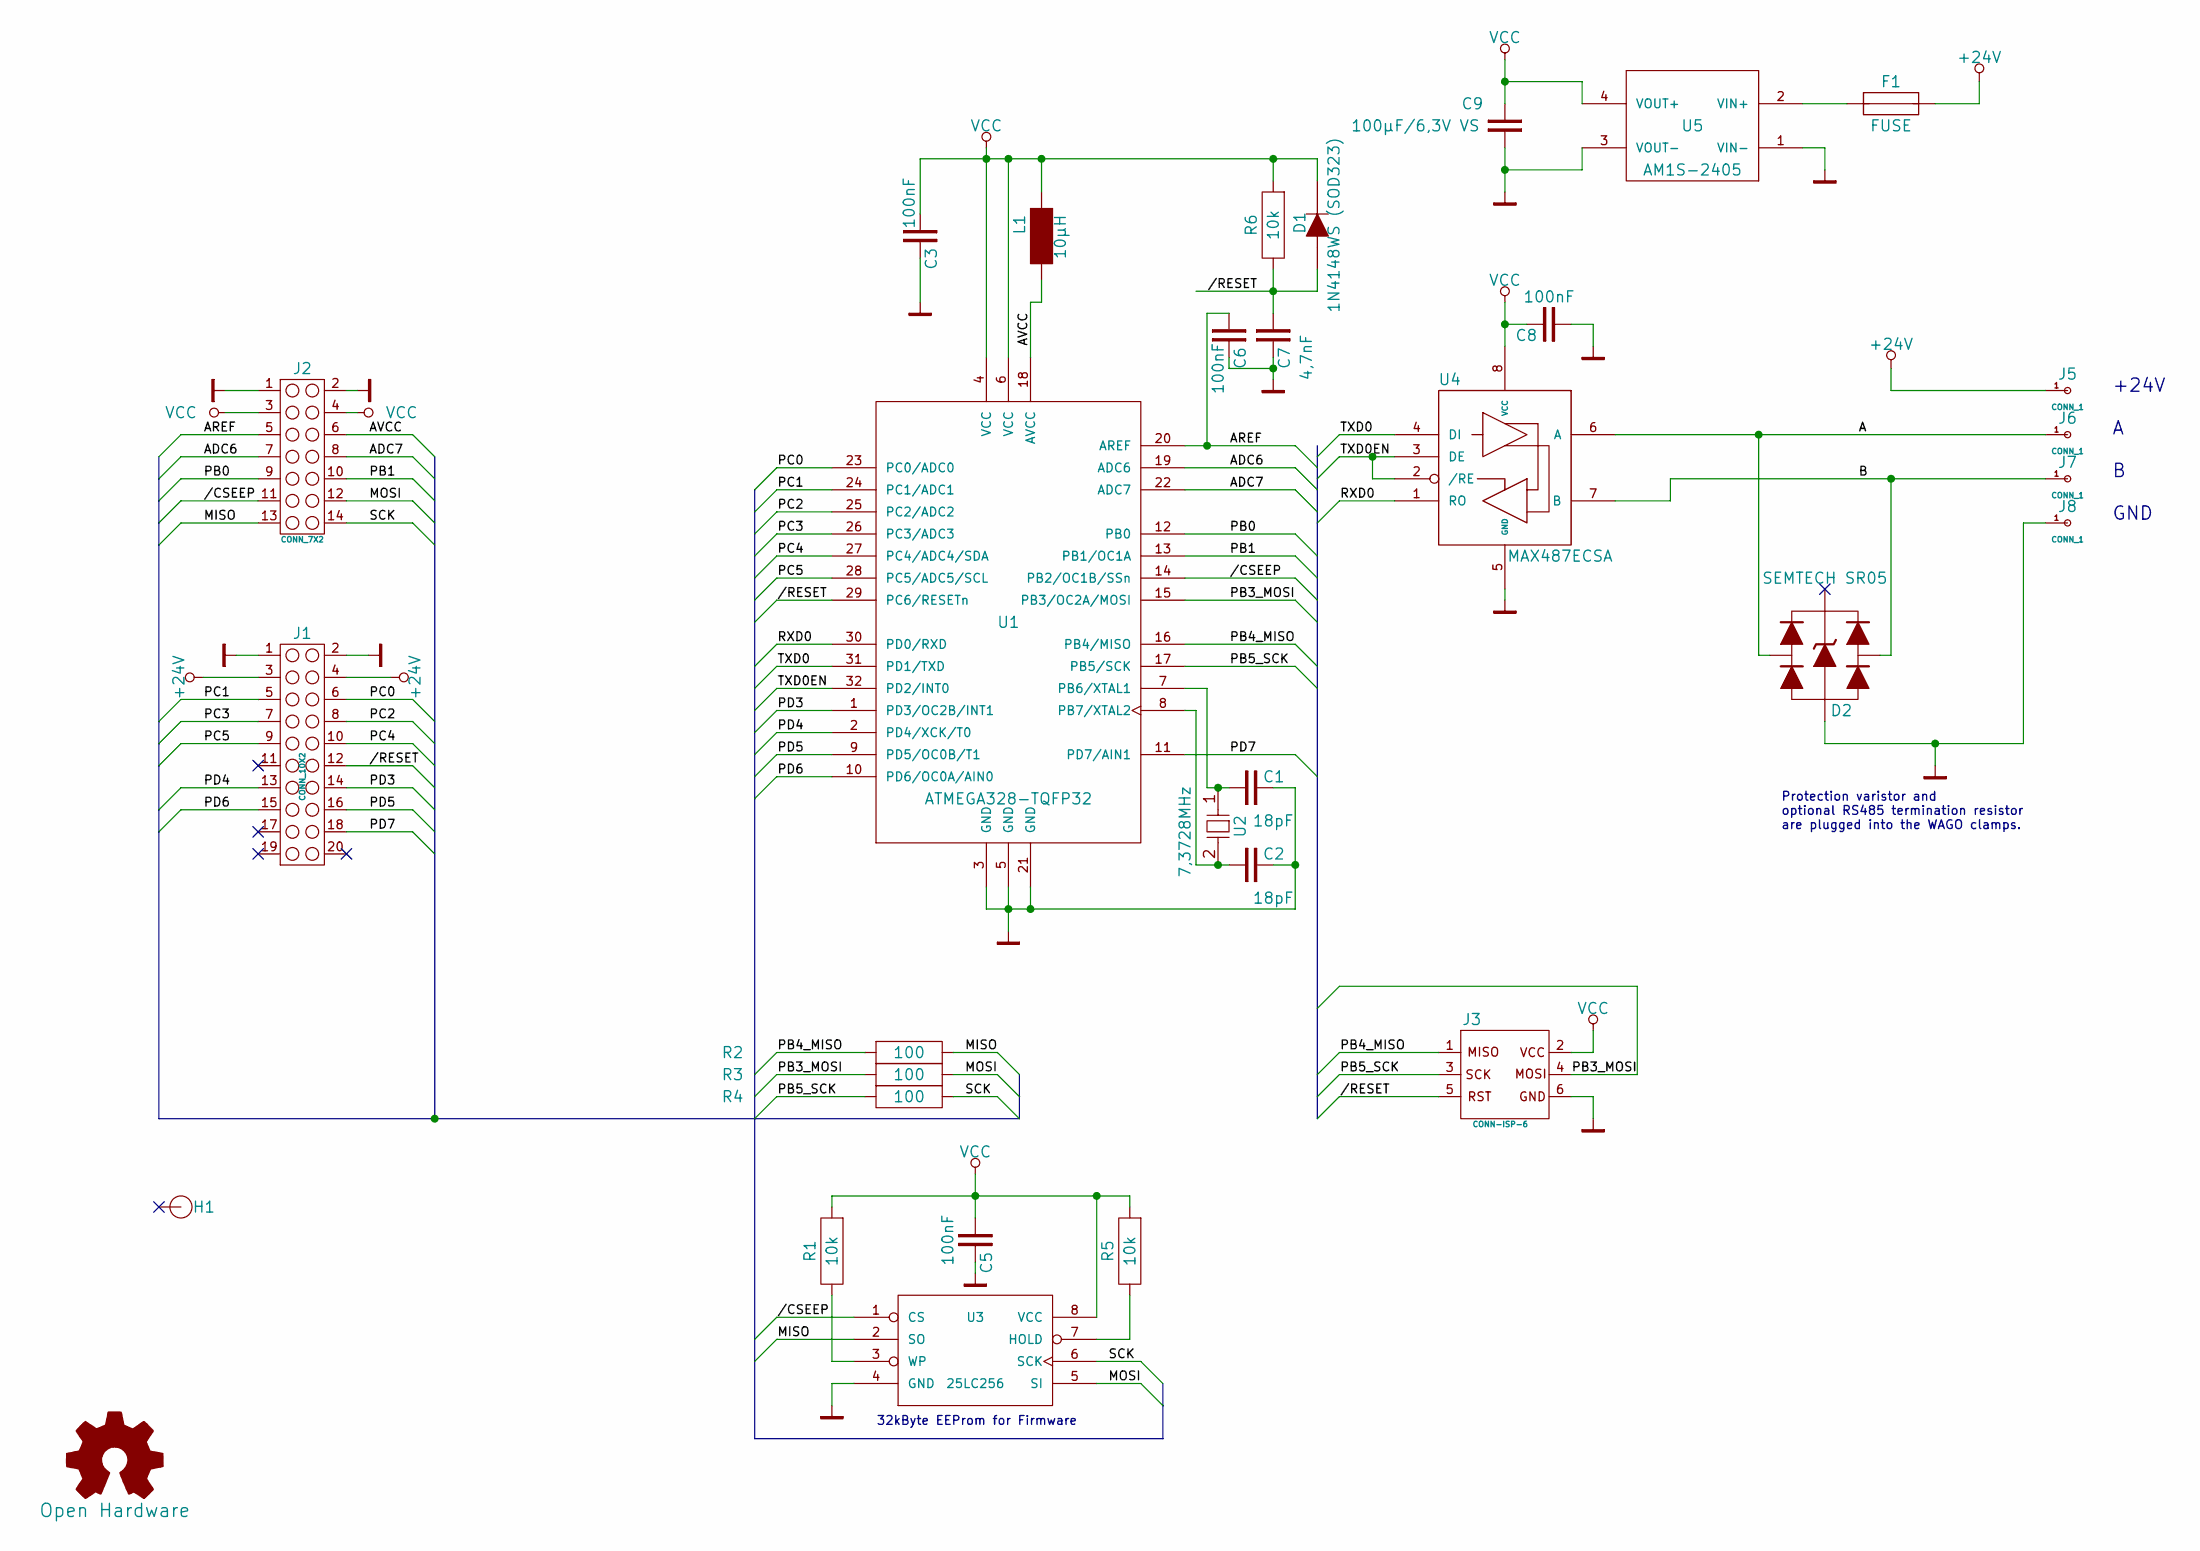
[picture p81: schematic bus-module_atmega328.kicad_sch]

Parts:
C1, C2: 18pF; C_0805
C3, C5, C6, C8: 100nF; C_0805
C7: 4,7nF; C_0805
C9: 100µF/6,3V VS; C_1206
D1: 1N4148WS (SOD323); D_SOD323
D2: SEMTECH SR05; D_SOT143
F1: FUSE; R_1812
H1: HOLE; HOLE_2.5mm
J1: CONN_10X2; HEADER_10x2
J2: CONN_7X2; HEADER_7x2
J3: CONN-ISP-6; HEADER_3x2
J5, J6, J7, J8: CONN_1; WAGO243
L1: 10µH; L_0805
LOGO1: Open Hardware; Symbol_OSHW-Logo_SilkScreen
R1, R5, R6: 10k; R_0805
R2, R3, R4: 100; R_0805
U1: ATMEGA328-TQFP32; TQFP-32_7x7mm_Pitch0.8mm
U2: 7,3728MHz; CRY_HC49_SMD
U3: 25LC256; SO8E
U4: MAX487ECSA; SO8E
U5: AM1S-2405; AM1S-XXXX_SIL4

Connections:
+24V: F1.2, J1.3, J1.4, J5.1
//CSEEP: J2.11, U1.14 (PB2/OC1B/SSn), U3.1 (CS)
//RESET: C7.1, D1.1 (A), J1.12, J3.5, R6.2, U1.29 (PC6/RESETn)
/A: D2.4, J6.1, U4.6 (A)
/ADC6: J2.7, U1.19 (ADC6)
/ADC7: J2.8, U1.22 (ADC7)
/AREF: C6.1, J2.5, U1.20 (AREF)
/AVCC: J2.6, L1.2, U1.18 (AVCC)
/B: D2.3, J7.1, U4.7 (B)
/MISO: J2.13, R2.2, U3.2 (SO)
/MOSI: J2.12, R3.2, U3.5 (SI)
/PB0: J2.9, U1.12 (PB0)
/PB1: J2.10, U1.13 (PB1/OC1A)
/PB3_MOSI: J3.4, R3.1, U1.15 (PB3/OC2A/MOSI)
/PB4_MISO: J3.1, R2.1, U1.16 (PB4/MISO)
/PB5_SCK: J3.3, R4.1, U1.17 (PB5/SCK)
/PC0: J1.6, U1.23 (PC0/ADC0)
/PC1: J1.5, U1.24 (PC1/ADC1)
/PC2: J1.8, U1.25 (PC2/ADC2)
/PC3: J1.7, U1.26 (PC3/ADC3)
/PC4: J1.10, U1.27 (PC4/ADC4/SDA)
/PC5: J1.9, U1.28 (PC5/ADC5/SCL)
/PD3: J1.14, U1.1 (PD3/OC2B/INT1)
/PD4: J1.13, U1.2 (PD4/XCK/T0)
/PD5: J1.16, U1.9 (PD5/OC0B/T1)
/PD6: J1.15, U1.10 (PD6/OC0A/AIN0)
/PD7: J1.18, U1.11 (PD7/AIN1)
/RXD0: U1.30 (PD0/RXD), U4.1 (RO)
/SCK: J2.14, R4.2, U3.6 (SCK)
/TXD0: U1.31 (PD1/TXD), U4.4 (DI)
/TXD0EN: U1.32 (PD2/INT0), U4.2 (/RE), U4.3 (DE)
GND: C1.2, C2.2, C3.2, C5.2, C6.2, C7.2, C8.1, C9.2, D2.1, J1.1, J1.2, J2.1, J2.2, J3.6, J8.1, U1.3 (GND), U1.5 (GND), U1.21 (GND), U3.4 (GND), U4.5 (GND), U5.1 (VIN-), U5.3 (VOUT-)
unnamed: C1.1, U1.7 (PB6/XTAL1), U2.1
unnamed: C2.1, U1.8 (PB7/XTAL2), U2.2
unnamed: F1.1, U5.2 (VIN+)
unnamed: R1.2, U3.3 (WP)
unnamed: R5.2, U3.7 (HOLD)
VCC: C3.1, C5.1, C8.2, C9.1, D1.2 (C), J2.3, J2.4, J3.2, L1.1, R1.1, R5.1, R6.1, U1.4 (VCC), U1.6 (VCC), U3.8 (VCC), U4.8 (VCC), U5.4 (VOUT+)

Notes on the sheet:
Protection varistor and optional RS485 termination resistor are plugged into the WAGO clamps.
+24V A B GND
32kByte EEProm for Firmware

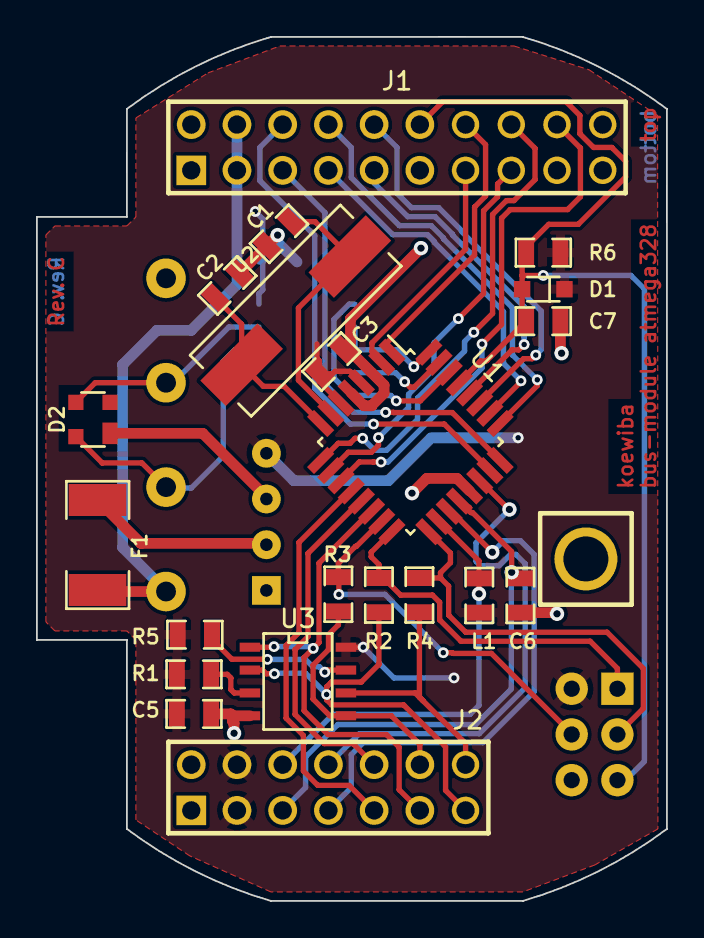
[picture p82: board bus-module_atmega328.kicad_pcb from above]

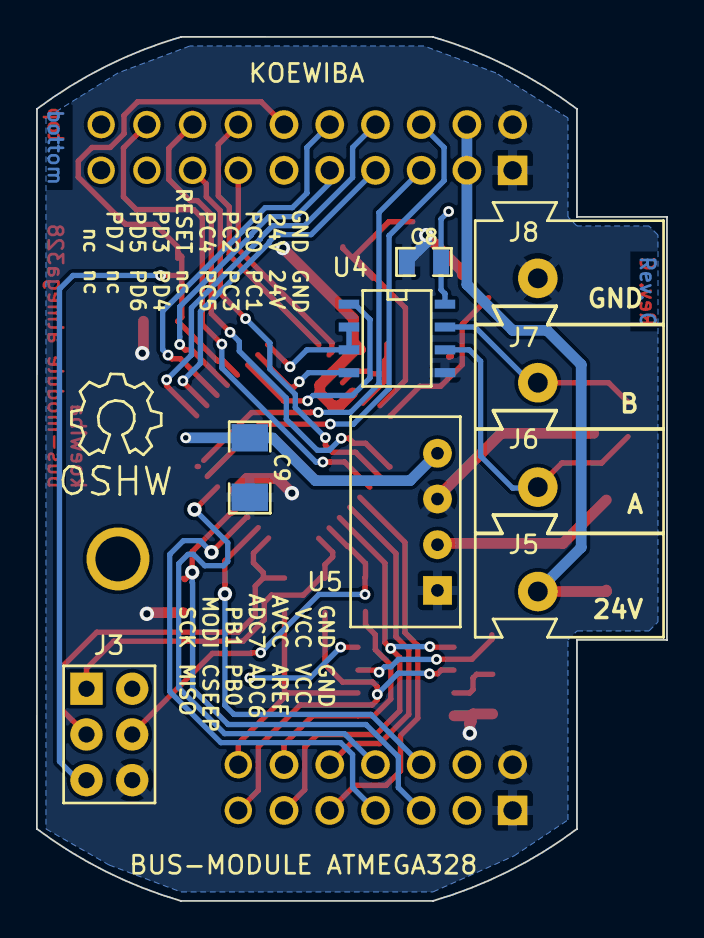
[picture p83: board bus-module_atmega328.kicad_pcb from below]

Board: 2 copper layers, 35.0 x 48.0 mm, 32 parts (10 on the bottom side), 38 nets.
