irqmask/koewiba-domotic/hw/bus-module_atmega324/bus-module_atmega324.kicad_pcb

## KiCad design hw/bus-module_atmega324/bus-module_atmega324.kicad_pcb (2023-12-06)

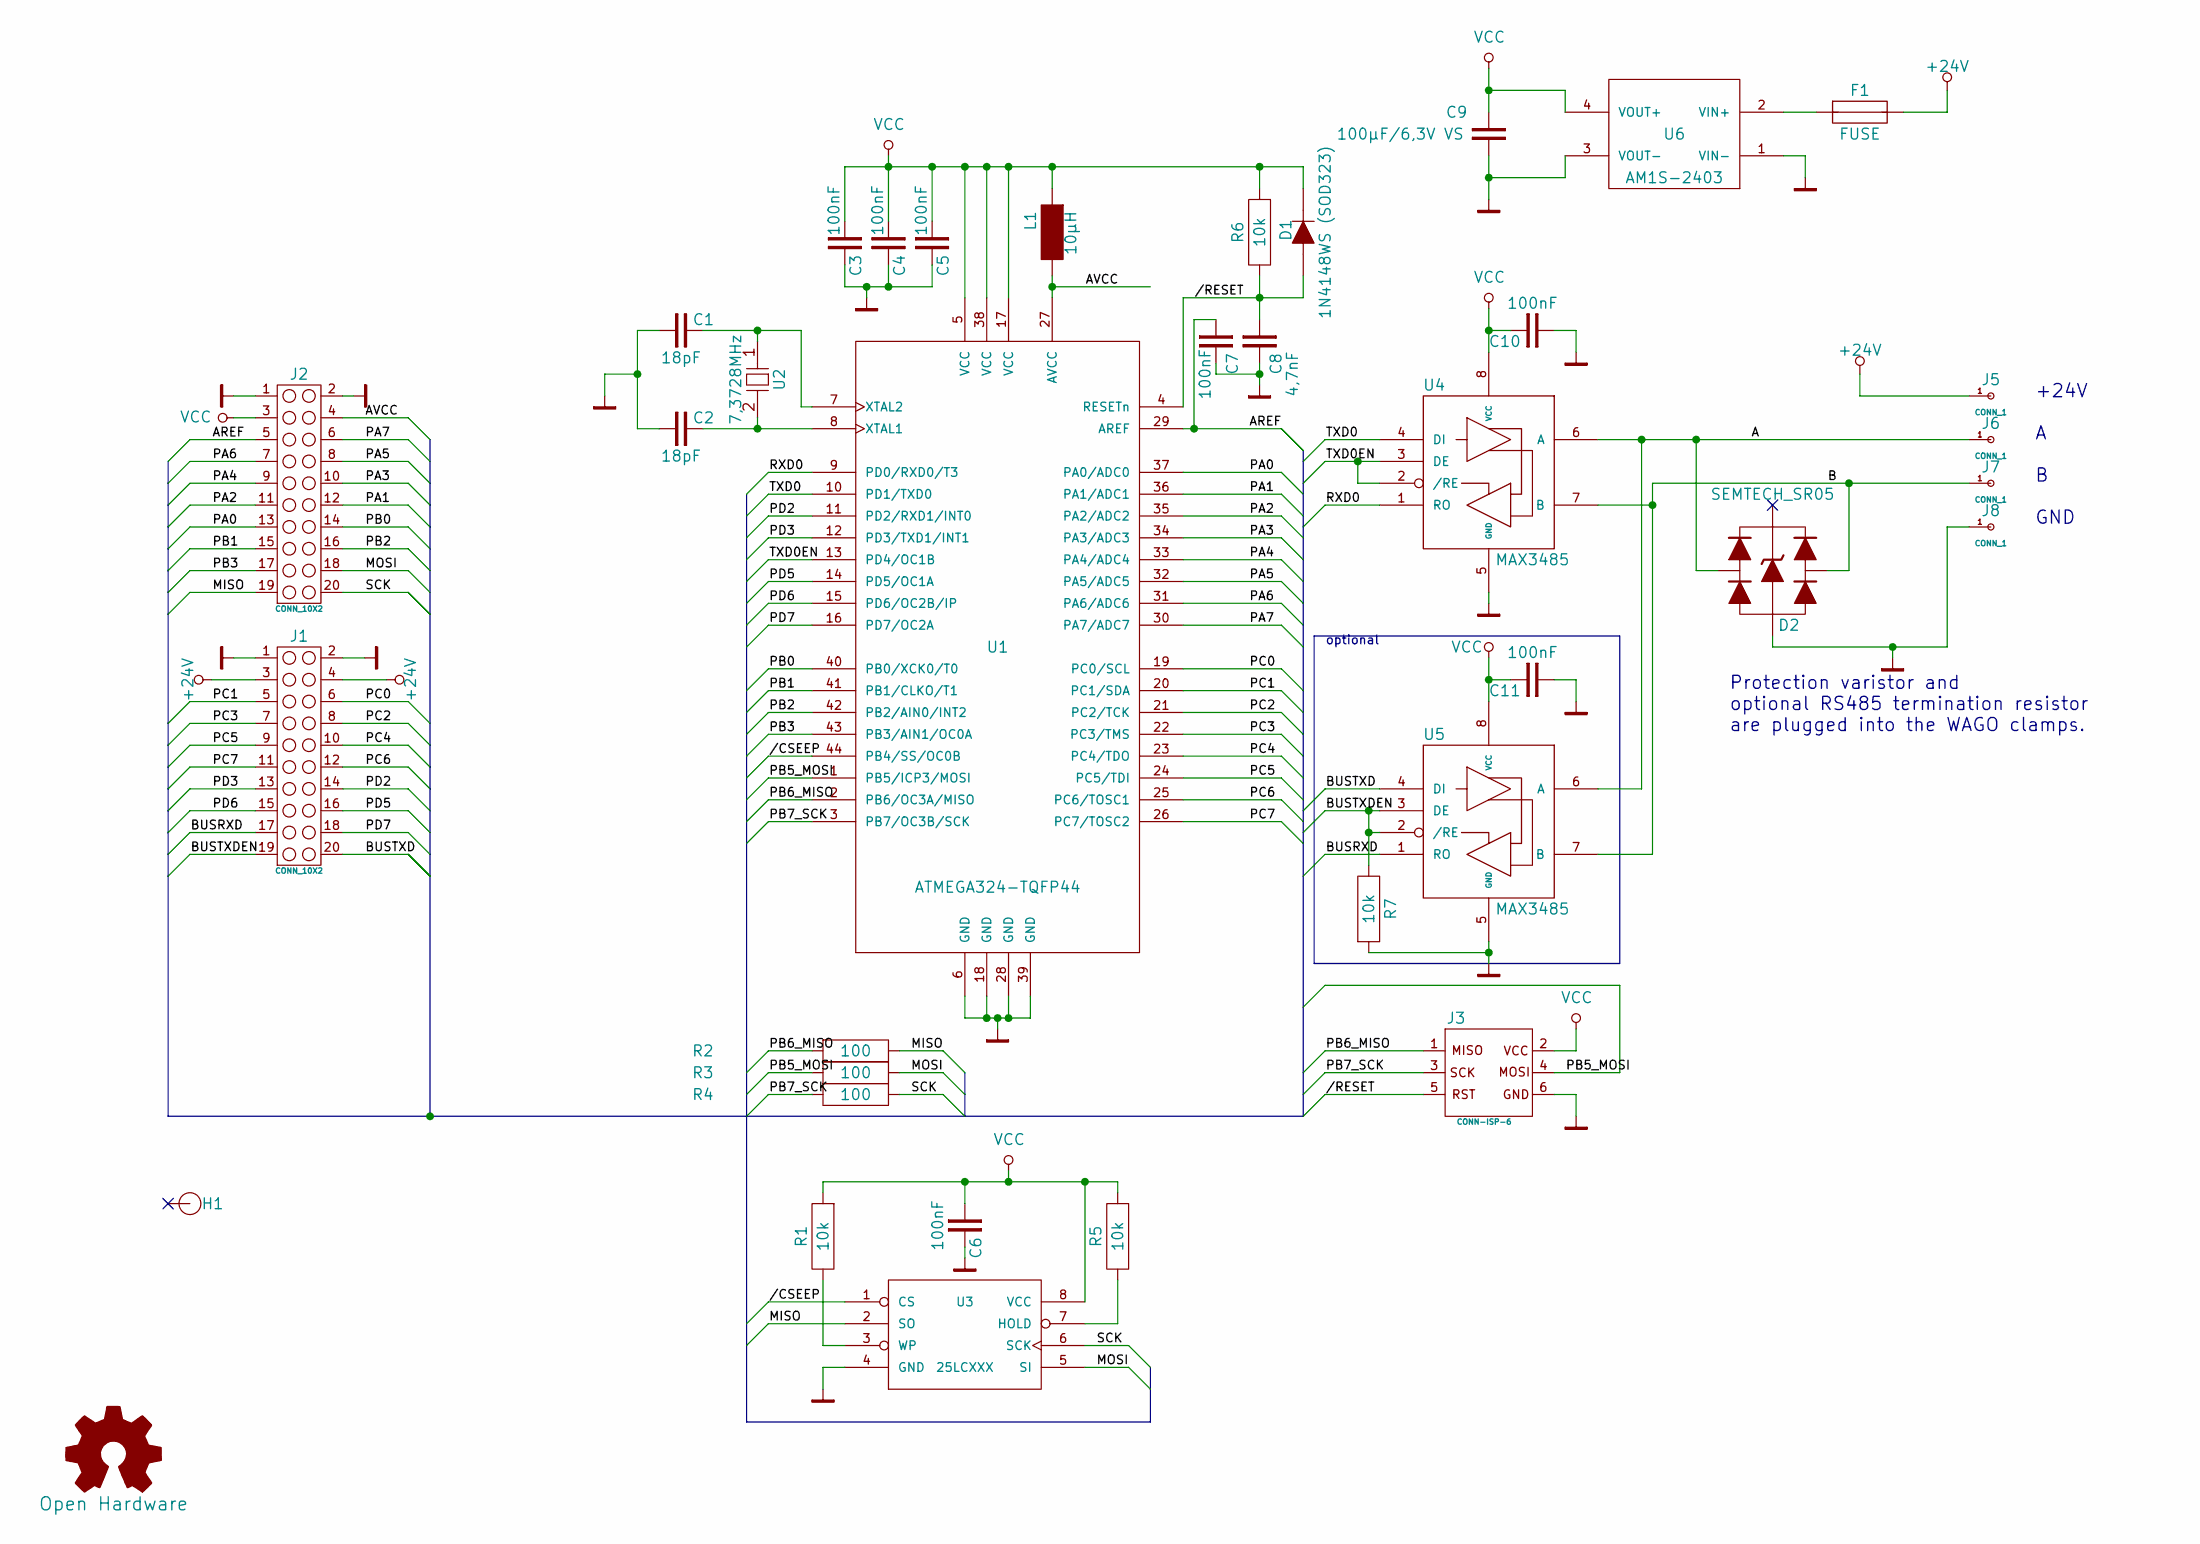
[picture p84: schematic bus-module_atmega324.kicad_sch]

Parts:
C1, C2: 18pF; C_0805
C3, C4, C5, C6, C7, C10, C11: 100nF; C_0805
C8: 4,7nF; C_0805
C9: 100µF/6,3V VS; C_1206
D1: 1N4148WS (SOD323); D_SOD323
D2: SEMTECH_SR05; D_SOT143
F1: FUSE; R_1812
H1: HOLE; HOLE_2.5mm
J1, J2: CONN_10X2; HEADER_10x2
J3: CONN-ISP-6; HEADER_3x2
J5, J6, J7, J8: CONN_1; WAGO243
L1: 10µH; L_0805
LOGO1: Open Hardware; Symbol_OSHW-Logo_SilkScreen
R1, R5, R6, R7: 10k; R_0805
R2, R3, R4: 100; R_0805
U1: ATMEGA324-TQFP44; TQFP-44_10x10mm_Pitch0.8mm
U2: 7,3728MHz; CRY_HC49_SMD
U3: 25LCXXX; SO8E
U4, U5: MAX3485; SO8E
U6: AM1S-2403; AM1S-XXXX_SIL4

Connections:
+24V: F1.2, J1.3, J1.4, J5.1
//CSEEP: U1.44 (PB4/SS/OC0B), U3.1 (CS)
//RESET: C8.1, D1.1 (A), J3.5, R6.2, U1.4 (RESETn)
/A: D2.4, J6.1, U4.6 (A), U5.6 (A)
/AREF: C7.1, J2.5, U1.29 (AREF)
/AVCC: J2.4, L1.2, U1.27 (AVCC)
/B: D2.3, J7.1, U4.7 (B), U5.7 (B)
/BUSRXD: J1.17, U5.1 (RO)
/BUSTXD: J1.20, U5.4 (DI)
/BUSTXDEN: J1.19, R7.2, U5.2 (/RE), U5.3 (DE)
/MISO: J2.19, R2.2, U3.2 (SO)
/MOSI: J2.18, R3.2, U3.5 (SI)
/PA0: J2.13, U1.37 (PA0/ADC0)
/PA1: J2.12, U1.36 (PA1/ADC1)
/PA2: J2.11, U1.35 (PA2/ADC2)
/PA3: J2.10, U1.34 (PA3/ADC3)
/PA4: J2.9, U1.33 (PA4/ADC4)
/PA5: J2.8, U1.32 (PA5/ADC5)
/PA6: J2.7, U1.31 (PA6/ADC6)
/PA7: J2.6, U1.30 (PA7/ADC7)
/PB0: J2.14, U1.40 (PB0/XCK0/T0)
/PB1: J2.15, U1.41 (PB1/CLKO/T1)
/PB2: J2.16, U1.42 (PB2/AIN0/INT2)
/PB3: J2.17, U1.43 (PB3/AIN1/OC0A)
/PB5_MOSI: J3.4, R3.1, U1.1 (PB5/ICP3/MOSI)
/PB6_MISO: J3.1, R2.1, U1.2 (PB6/OC3A/MISO)
/PB7_SCK: J3.3, R4.1, U1.3 (PB7/OC3B/SCK)
/PC0: J1.6, U1.19 (PC0/SCL)
/PC1: J1.5, U1.20 (PC1/SDA)
/PC2: J1.8, U1.21 (PC2/TCK)
/PC3: J1.7, U1.22 (PC3/TMS)
/PC4: J1.10, U1.23 (PC4/TDO)
/PC5: J1.9, U1.24 (PC5/TDI)
/PC6: J1.12, U1.25 (PC6/TOSC1)
/PC7: J1.11, U1.26 (PC7/TOSC2)
/PD2: J1.14, U1.11 (PD2/RXD1/INT0)
/PD3: J1.13, U1.12 (PD3/TXD1/INT1)
/PD5: J1.16, U1.14 (PD5/OC1A)
/PD6: J1.15, U1.15 (PD6/OC2B/IP)
/PD7: J1.18, U1.16 (PD7/OC2A)
/RXD0: U1.9 (PD0/RXD0/T3), U4.1 (RO)
/SCK: J2.20, R4.2, U3.6 (SCK)
/TXD0: U1.10 (PD1/TXD0), U4.4 (DI)
/TXD0EN: U1.13 (PD4/OC1B), U4.2 (/RE), U4.3 (DE)
GND: C1.1, C2.1, C3.2, C4.2, C5.2, C6.2, C7.2, C8.2, C9.2, C10.1, C11.1, D2.1, J1.1, J1.2, J2.1, J2.2, J3.6, J8.1, R7.1, U1.6 (GND), U1.18 (GND), U1.28 (GND), U1.39 (GND), U3.4 (GND), U4.5 (GND), U5.5 (GND), U6.1 (VIN-), U6.3 (VOUT-)
unnamed: C1.2, U1.7 (XTAL2), U2.1
unnamed: C2.2, U1.8 (XTAL1), U2.2
unnamed: F1.1, U6.2 (VIN+)
unnamed: R1.2, U3.3 (WP)
unnamed: R5.2, U3.7 (HOLD)
VCC: C3.1, C4.1, C5.1, C6.1, C9.1, C10.2, C11.2, D1.2 (C), J2.3, J3.2, L1.1, R1.1, R5.1, R6.1, U1.5 (VCC), U1.17 (VCC), U1.38 (VCC), U3.8 (VCC), U4.8 (VCC), U5.8 (VCC), U6.4 (VOUT+)

Notes on the sheet:
Protection varistor and optional RS485 termination resistor are plugged into the WAGO clamps.
optional
+24V A B GND

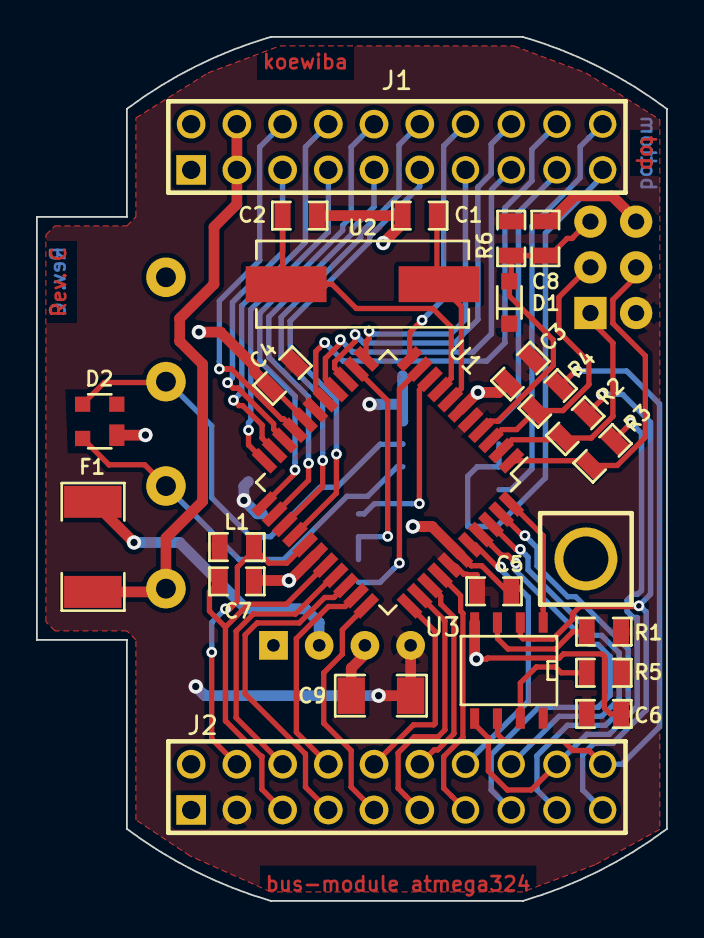
[picture p85: board bus-module_atmega324.kicad_pcb from above]

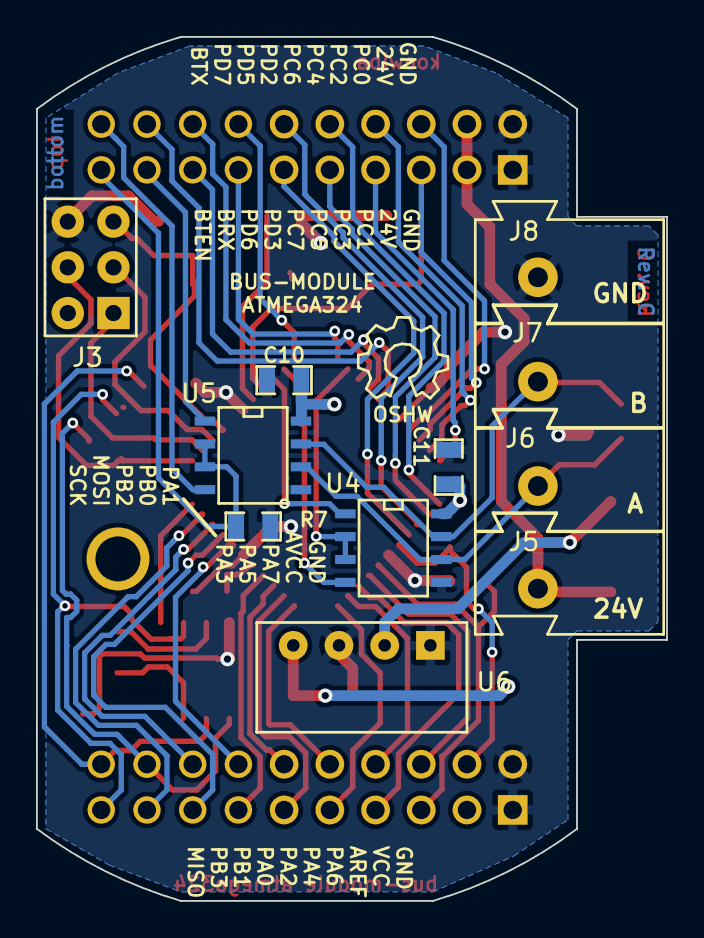
[picture p86: board bus-module_atmega324.kicad_pcb from below]

Board: 2 copper layers, 35.0 x 48.0 mm, 37 parts (12 on the bottom side), 51 nets.
