irqmask/koewiba-domotic/hw/roomthermostat/roomthermostat.kicad_pcb

## KiCad design hw/roomthermostat/roomthermostat.kicad_pcb (2023-12-06)

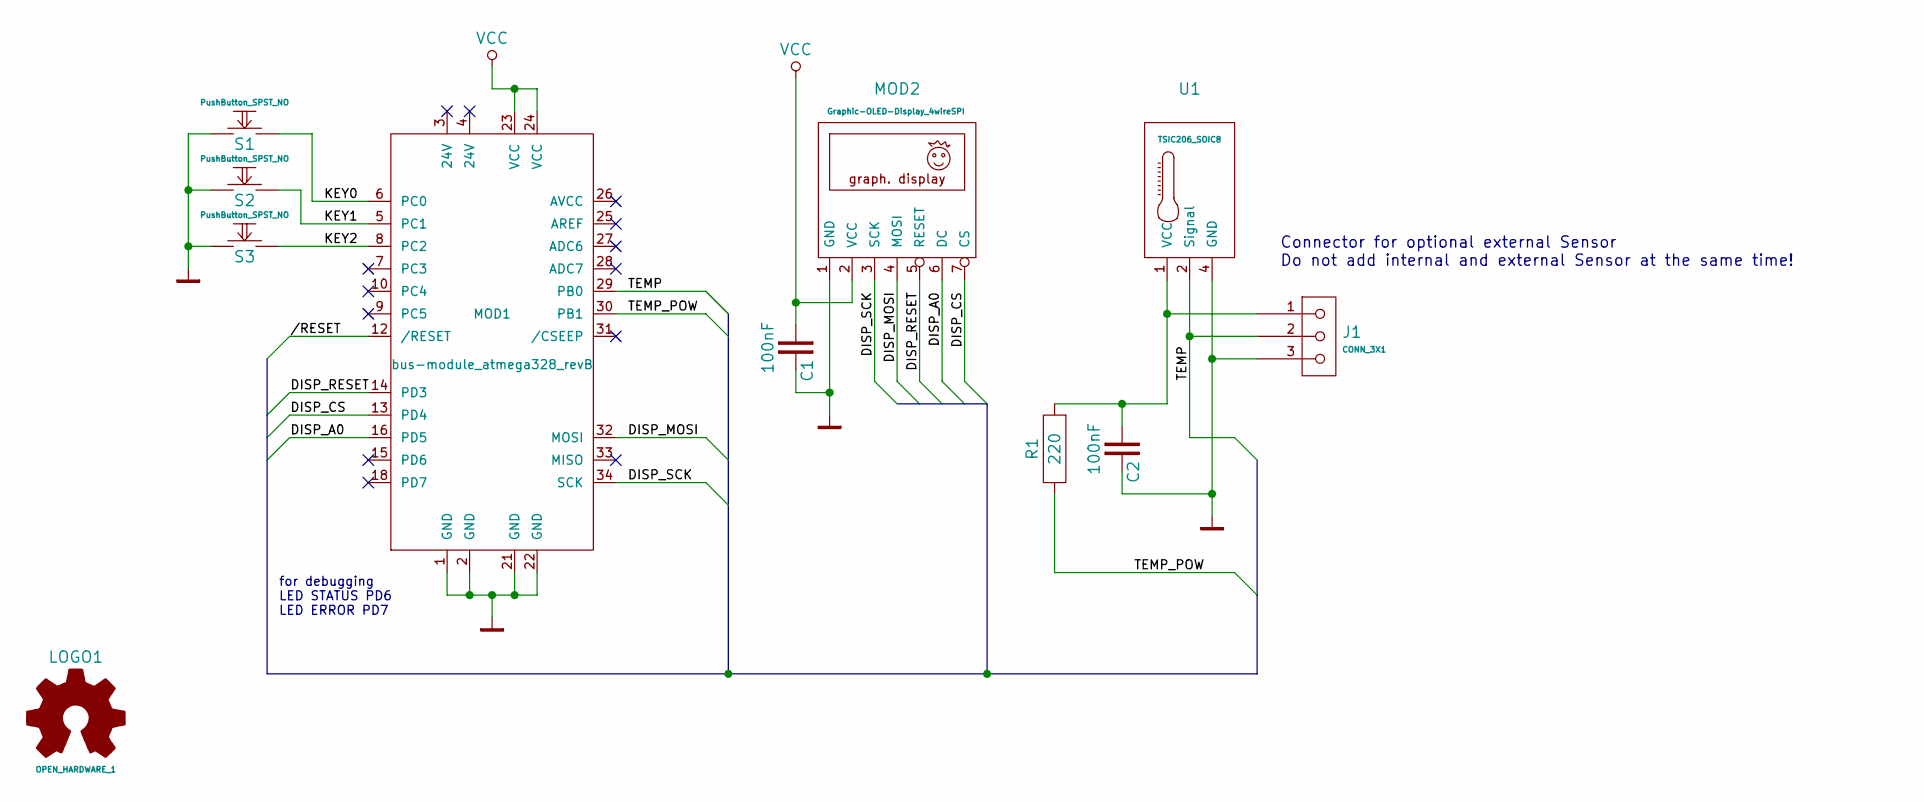
[picture p87: schematic roomthermostat.kicad_sch]

Parts:
C1, C2: 100nF; C_0805
J1: CONN_3X1; HEADER_3x1
LOGO1: OPEN_HARDWARE_1; Symbol_OSHW-Logo_Copper
MOD1: bus-module_atmega328_revB; bus-module_atmega328
MOD2: Graphic-OLED-Display_4wireSPI; GraphDisplay_1_OLED_27x27,5mm_030072BA
R1: 220; R_0805
S1, S2, S3: PushButton_SPST_NO; PushButton_SPST_SMD_JTP-1138_BacksideMount
U1: TSIC206_SOIC8; SO8E

Connections:
/DISP_A0: MOD1.16 (PD5), MOD2.6 (DC)
/DISP_CS: MOD1.13 (PD4), MOD2.7 (CS)
/DISP_MOSI: MOD1.32 (MOSI), MOD2.4 (MOSI)
/DISP_RESET: MOD1.14 (PD3), MOD2.5 (RESET)
/DISP_SCK: MOD1.34 (SCK), MOD2.3 (SCK)
/KEY0: MOD1.6 (PC0), S1.2
/KEY1: MOD1.5 (PC1), S2.2
/KEY2: MOD1.8 (PC2), S3.2
/TEMP: J1.2, MOD1.29 (PB0), U1.2 (Signal)
/TEMP_POW: MOD1.30 (PB1), R1.2
//RESET: MOD1.12 (/RESET)
GND: C1.2, C2.2, J1.3, MOD1.1 (GND), MOD1.2 (GND), MOD1.21 (GND), MOD1.22 (GND), MOD2.1 (GND), S1.1, S2.1, S3.1, U1.4 (GND)
unnamed: C2.1, J1.1, R1.1, U1.1 (VCC)
VCC: C1.1, MOD1.23 (VCC), MOD1.24 (VCC), MOD2.2 (VCC)

Notes on the sheet:
for debugging LED STATUS PD6 LED ERROR PD7
Connector for optional external Sensor Do not add internal and external Sensor at the same time!
