irqmask/koewiba-domotic/hw/roomthermostat/roomthermostat.kicad_pcb

## KiCad design hw/roomthermostat/roomthermostat.kicad_pcb (continued)

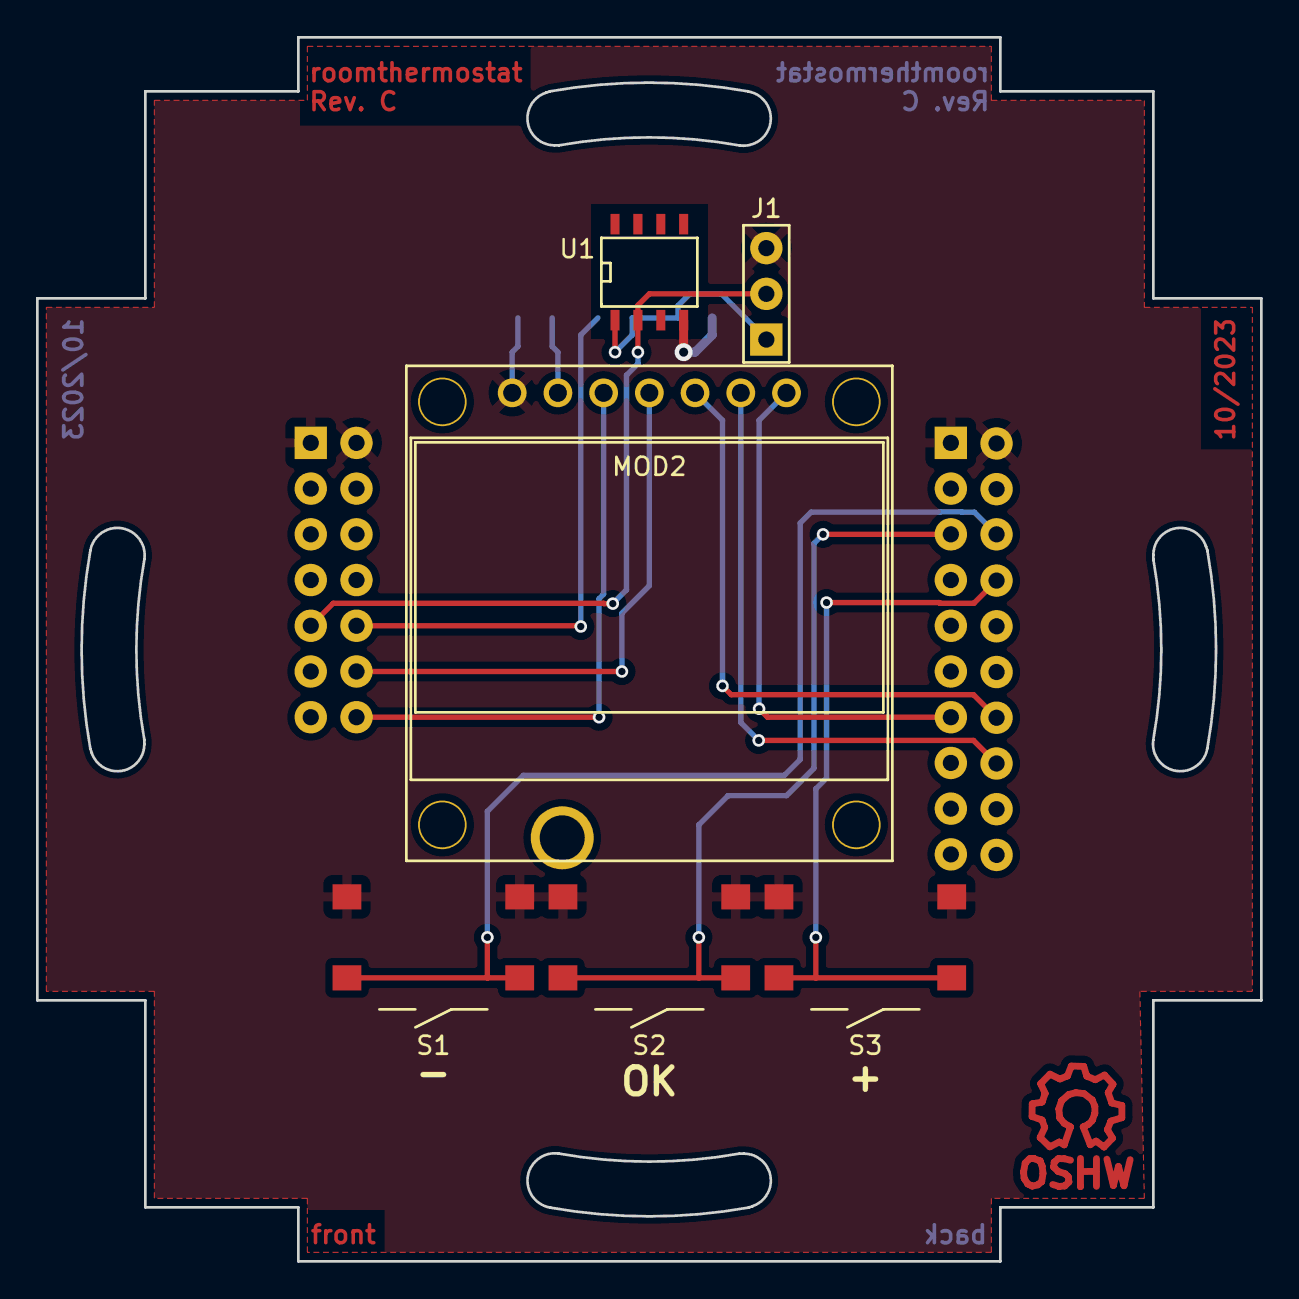
[picture p88: board roomthermostat.kicad_pcb from above]

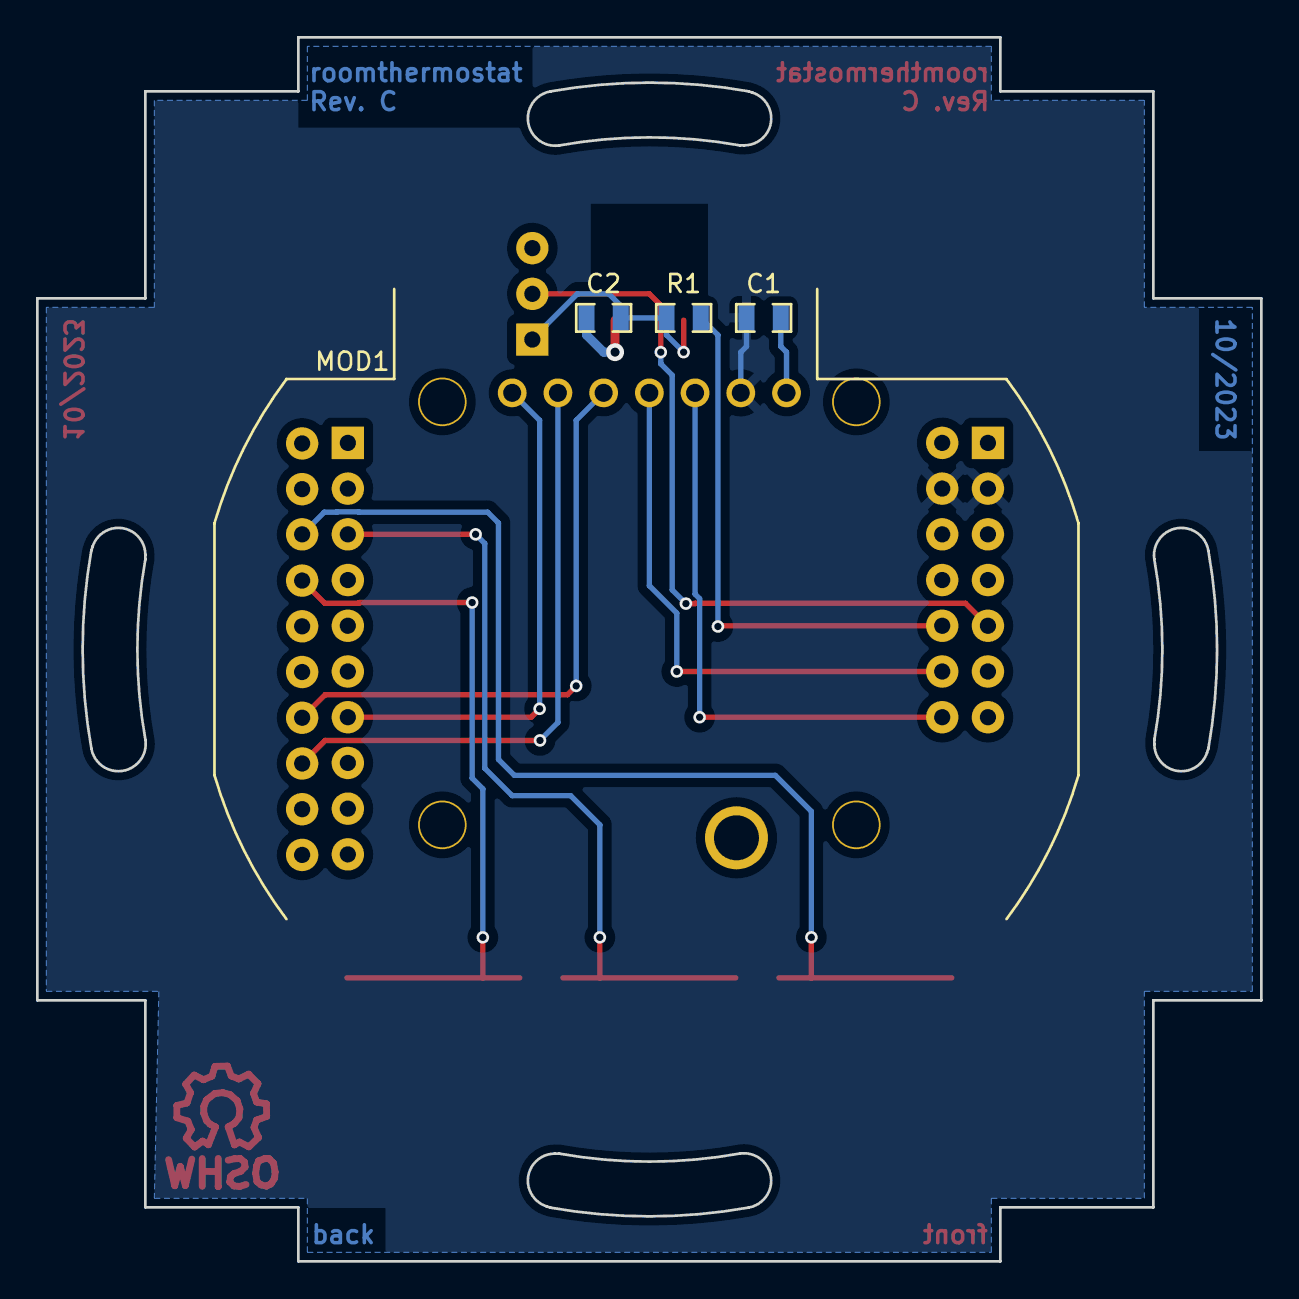
[picture p89: board roomthermostat.kicad_pcb from below]

Board: 2 copper layers, 68.0 x 68.0 mm, 11 parts (4 on the bottom side), 13 nets.
