irqmask/koewiba-domotic/hw/pushbutton8/pushbutton8.kicad_pcb

## KiCad design hw/pushbutton8/pushbutton8.kicad_pcb (2023-12-06)

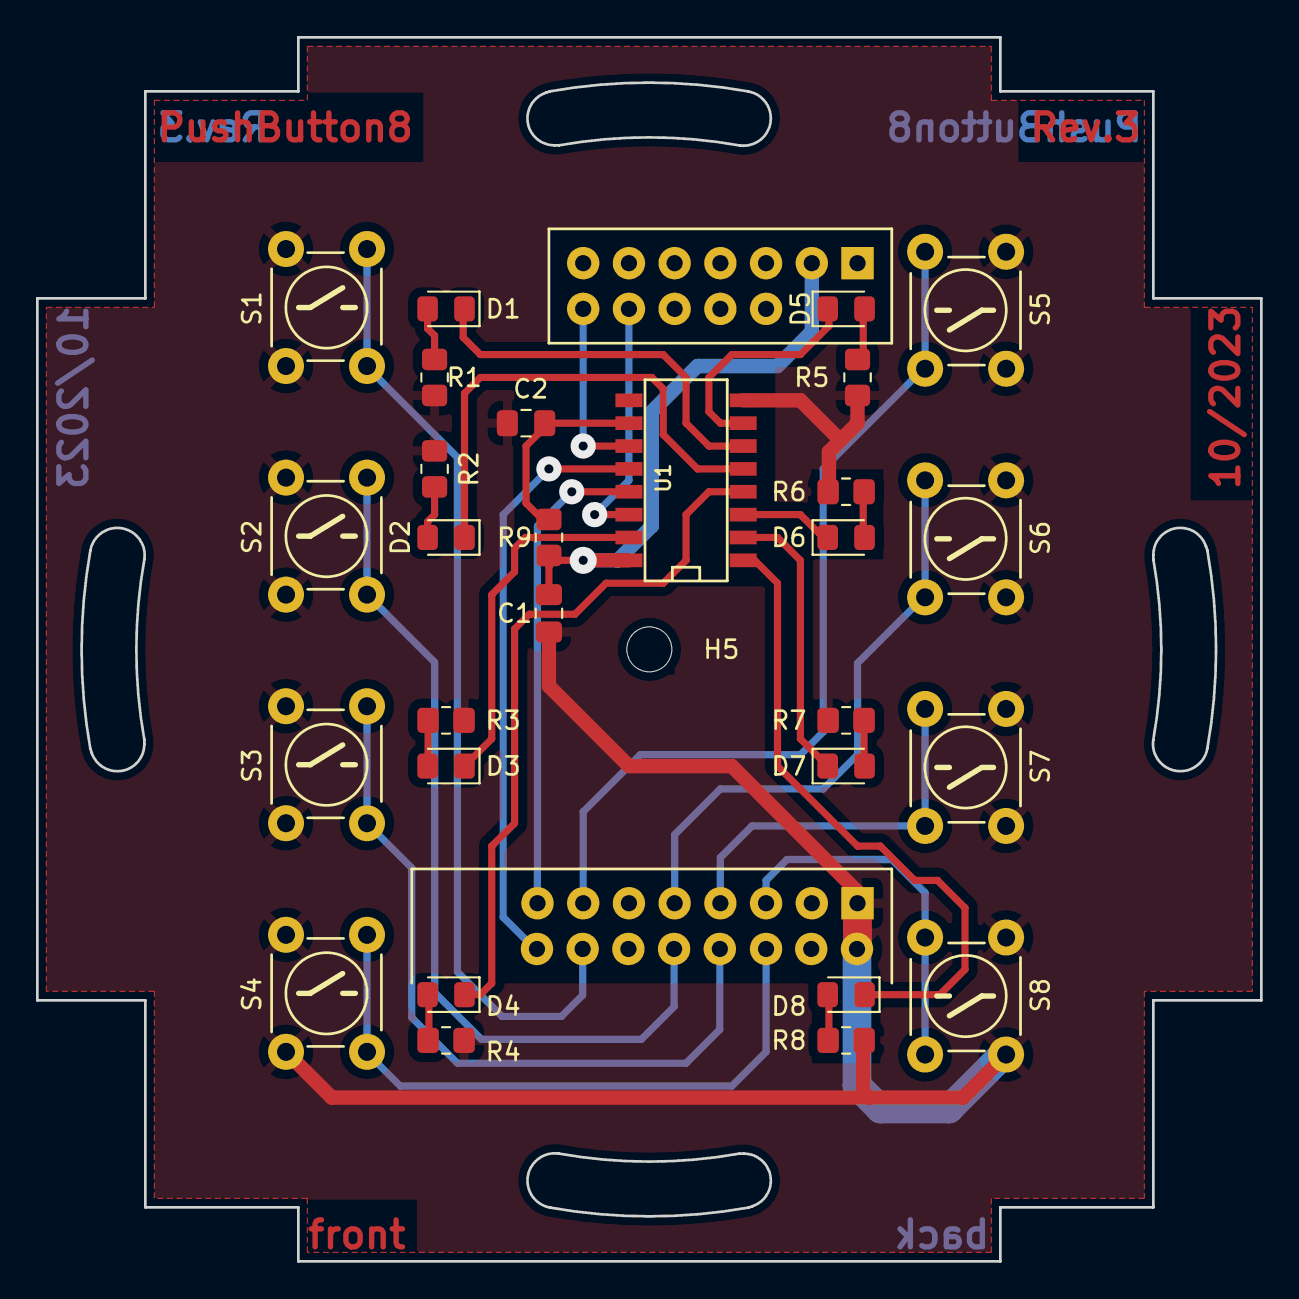
[picture p90: board pushbutton8.kicad_pcb from above]

Board: 2 copper layers, 68.0 x 68.0 mm, 30 parts (1 on the bottom side), 31 nets.

Parts:
C1, C2: 100nF; C_0805_2012Metric_Pad1.18x1.45mm_HandSolder
D1, D2, D3, D4, D5, D6, D7, D8: LED; LED_0805_2012Metric_Pad1.15x1.40mm_HandSolder
H5: HOLE; MountingHole_2.5mm
MOD1: bus-module_atmega328
R1, R2, R3, R4, R5, R6, R7, R8: R; R_0805_2012Metric_Pad1.20x1.40mm_HandSolder
R9: 4k7; R_0805_2012Metric_Pad1.20x1.40mm_HandSolder
S1, S2, S3, S4, S5, S6, S7, S8: TASTER 3301; PHAP3301
U1: 74HC595; SO16N

Connections:
unnamed: C1.1, MOD1.23 (VCC), R9.1, U1.16 (VCC)
unnamed: C1.2, C2.2, MOD1.1 (GND), MOD1.2 (GND), R1.2, R2.2, R3.2, R4.2, R5.2, R6.2, R7.2, R8.2, S1.1, S2.1, S3.1, S4.1, S5.1, S6.1, S7.1, S8.1, U1.8 (GND)
unnamed: C2.1, R9.2, U1.10 (~MR)
unnamed: D1.1 (A), U1.6 (Q6)
unnamed: D1.2 (C), R1.1
unnamed: D2.1 (A), U1.5 (Q5)
unnamed: D2.2 (C), R2.1
unnamed: D3.1 (A), U1.15 (Q0)
unnamed: D3.2 (C), R3.1
unnamed: D4.1 (A), U1.4 (Q4)
unnamed: D4.2 (C), R4.1
unnamed: D5.1 (A), U1.7 (Q7)
unnamed: D5.2 (C), R5.1
unnamed: D6.1 (A), U1.3 (Q3)
unnamed: D6.2 (C), R6.1
unnamed: D7.1 (A), U1.2 (Q2)
unnamed: D7.2 (C), R7.1
unnamed: D8.1 (A), U1.1 (Q1)
unnamed: D8.2 (C), R8.1
unnamed: MOD1.5 (PC1), S8.2
unnamed: MOD1.6 (PC0), S4.2
unnamed: MOD1.7 (PC3), S7.2
unnamed: MOD1.8 (PC2), S3.2
unnamed: MOD1.9 (PC5), S6.2
unnamed: MOD1.10 (PC4), S2.2
unnamed: MOD1.13 (PD4), S5.2
unnamed: MOD1.14 (PD3), S1.2
unnamed: MOD1.15 (PD6), U1.13 (~OE)
unnamed: MOD1.16 (PD5), U1.12 (STCLK)
unnamed: MOD1.32 (MOSI), U1.14 (SER)
unnamed: MOD1.34 (SCK), U1.11 (SRCLK)
