irqmask/koewiba-domotic/hw/heatervalve-interface/heatervalve-interface.kicad_pcb

## KiCad design hw/heatervalve-interface/heatervalve-interface.kicad_pcb (2023-12-06)

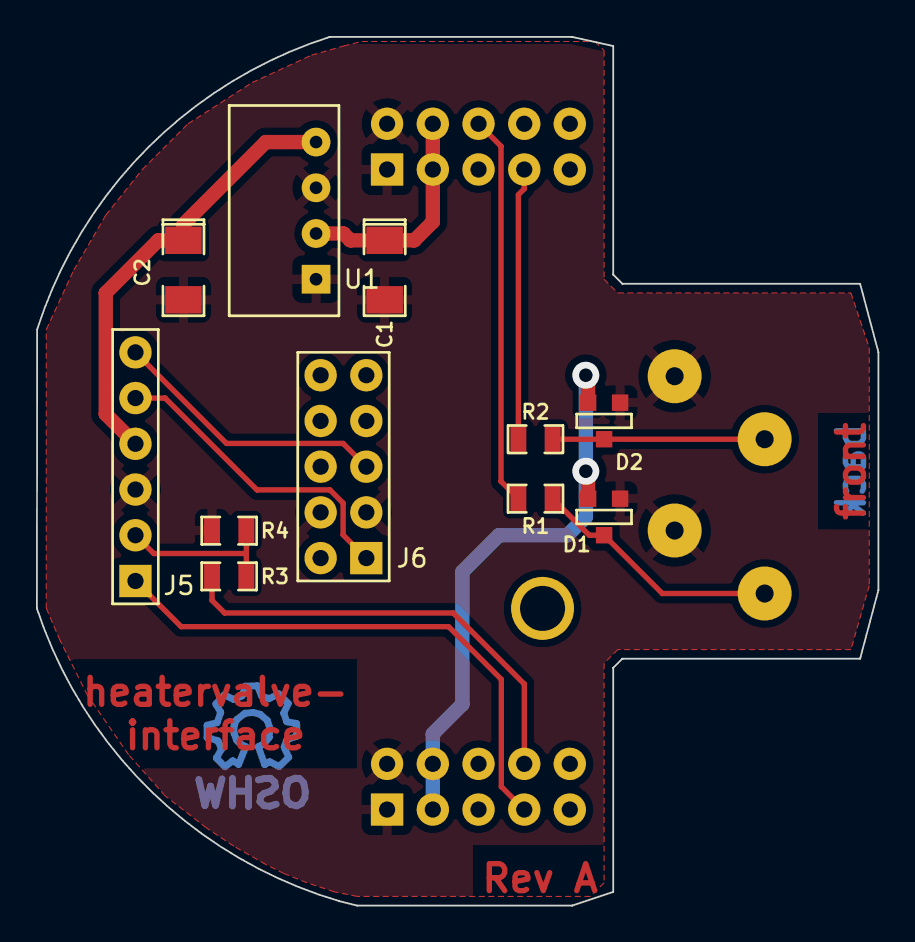
[picture p91: board heatervalve-interface.kicad_pcb from above]

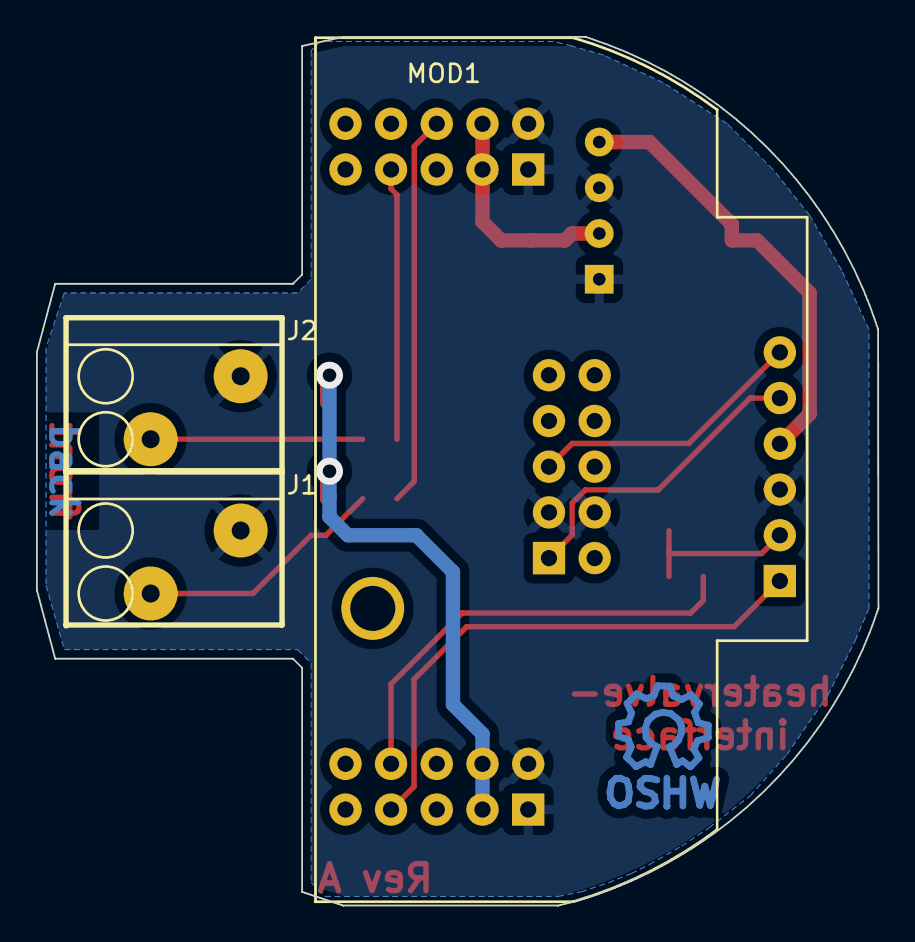
[picture p92: board heatervalve-interface.kicad_pcb from below]

Board: 2 copper layers, 46.8 x 48.3 mm, 15 parts (4 on the bottom side), 13 nets.

Parts:
C1: 470µF; CP_1206
C2: 100µF; CP_1206
D1, D2: BAT54S; SOT23-3
J1, J2: CONN_2X1; WAGO250-202
J5: CONN_6X1; HEADER_6x1
J6: CONN_5X2; HEADER_5x2
LOGO1: OPEN_HARDWARE_1; Symbol_OSHW-Logo_Copper
MOD1: bus-module_attiny1634_revB; bus-module_attiny1634
R1, R2, R3: 4k7; R_0805
R4: 9k1; R_0805
U1: AM1S-2403; AM1S-XXXX_SIL4

Connections:
+3.3V: C2.1, J5.4, U1.4 (VOUT+)
+5V: D1.2, D2.2, MOD1.13 (VCC), MOD1.14 (VCC)
+24V: C1.1, MOD1.3 (24V), MOD1.4 (24V), U1.2 (VIN+)
/RXD: J5.1, MOD1.17 (MISO)
/STM8_RST: J5.5, J6.1
/TXD: MOD1.18 (MOSI), R3.1
GND: C1.2, C2.2, D1.1, D2.1, J1.2, J2.2, J5.3, J6.3, J6.4, MOD1.1 (GND), MOD1.2 (GND), MOD1.11 (GND), MOD1.12 (GND), R4.1, U1.1 (VIN-), U1.3 (VOUT-)
unnamed: D1.3, J1.1, R1.1
unnamed: D2.3, J2.1, R2.1
unnamed: J5.2, R3.2, R4.2
unnamed: J5.6, J6.5
unnamed: MOD1.6 (PA1), R1.2
unnamed: MOD1.7 (PA2), R2.2
