irqmask/koewiba-domotic/hw/buscom/buscom.kicad_pcb

## KiCad design hw/buscom/buscom.kicad_pcb (2023-11-28)

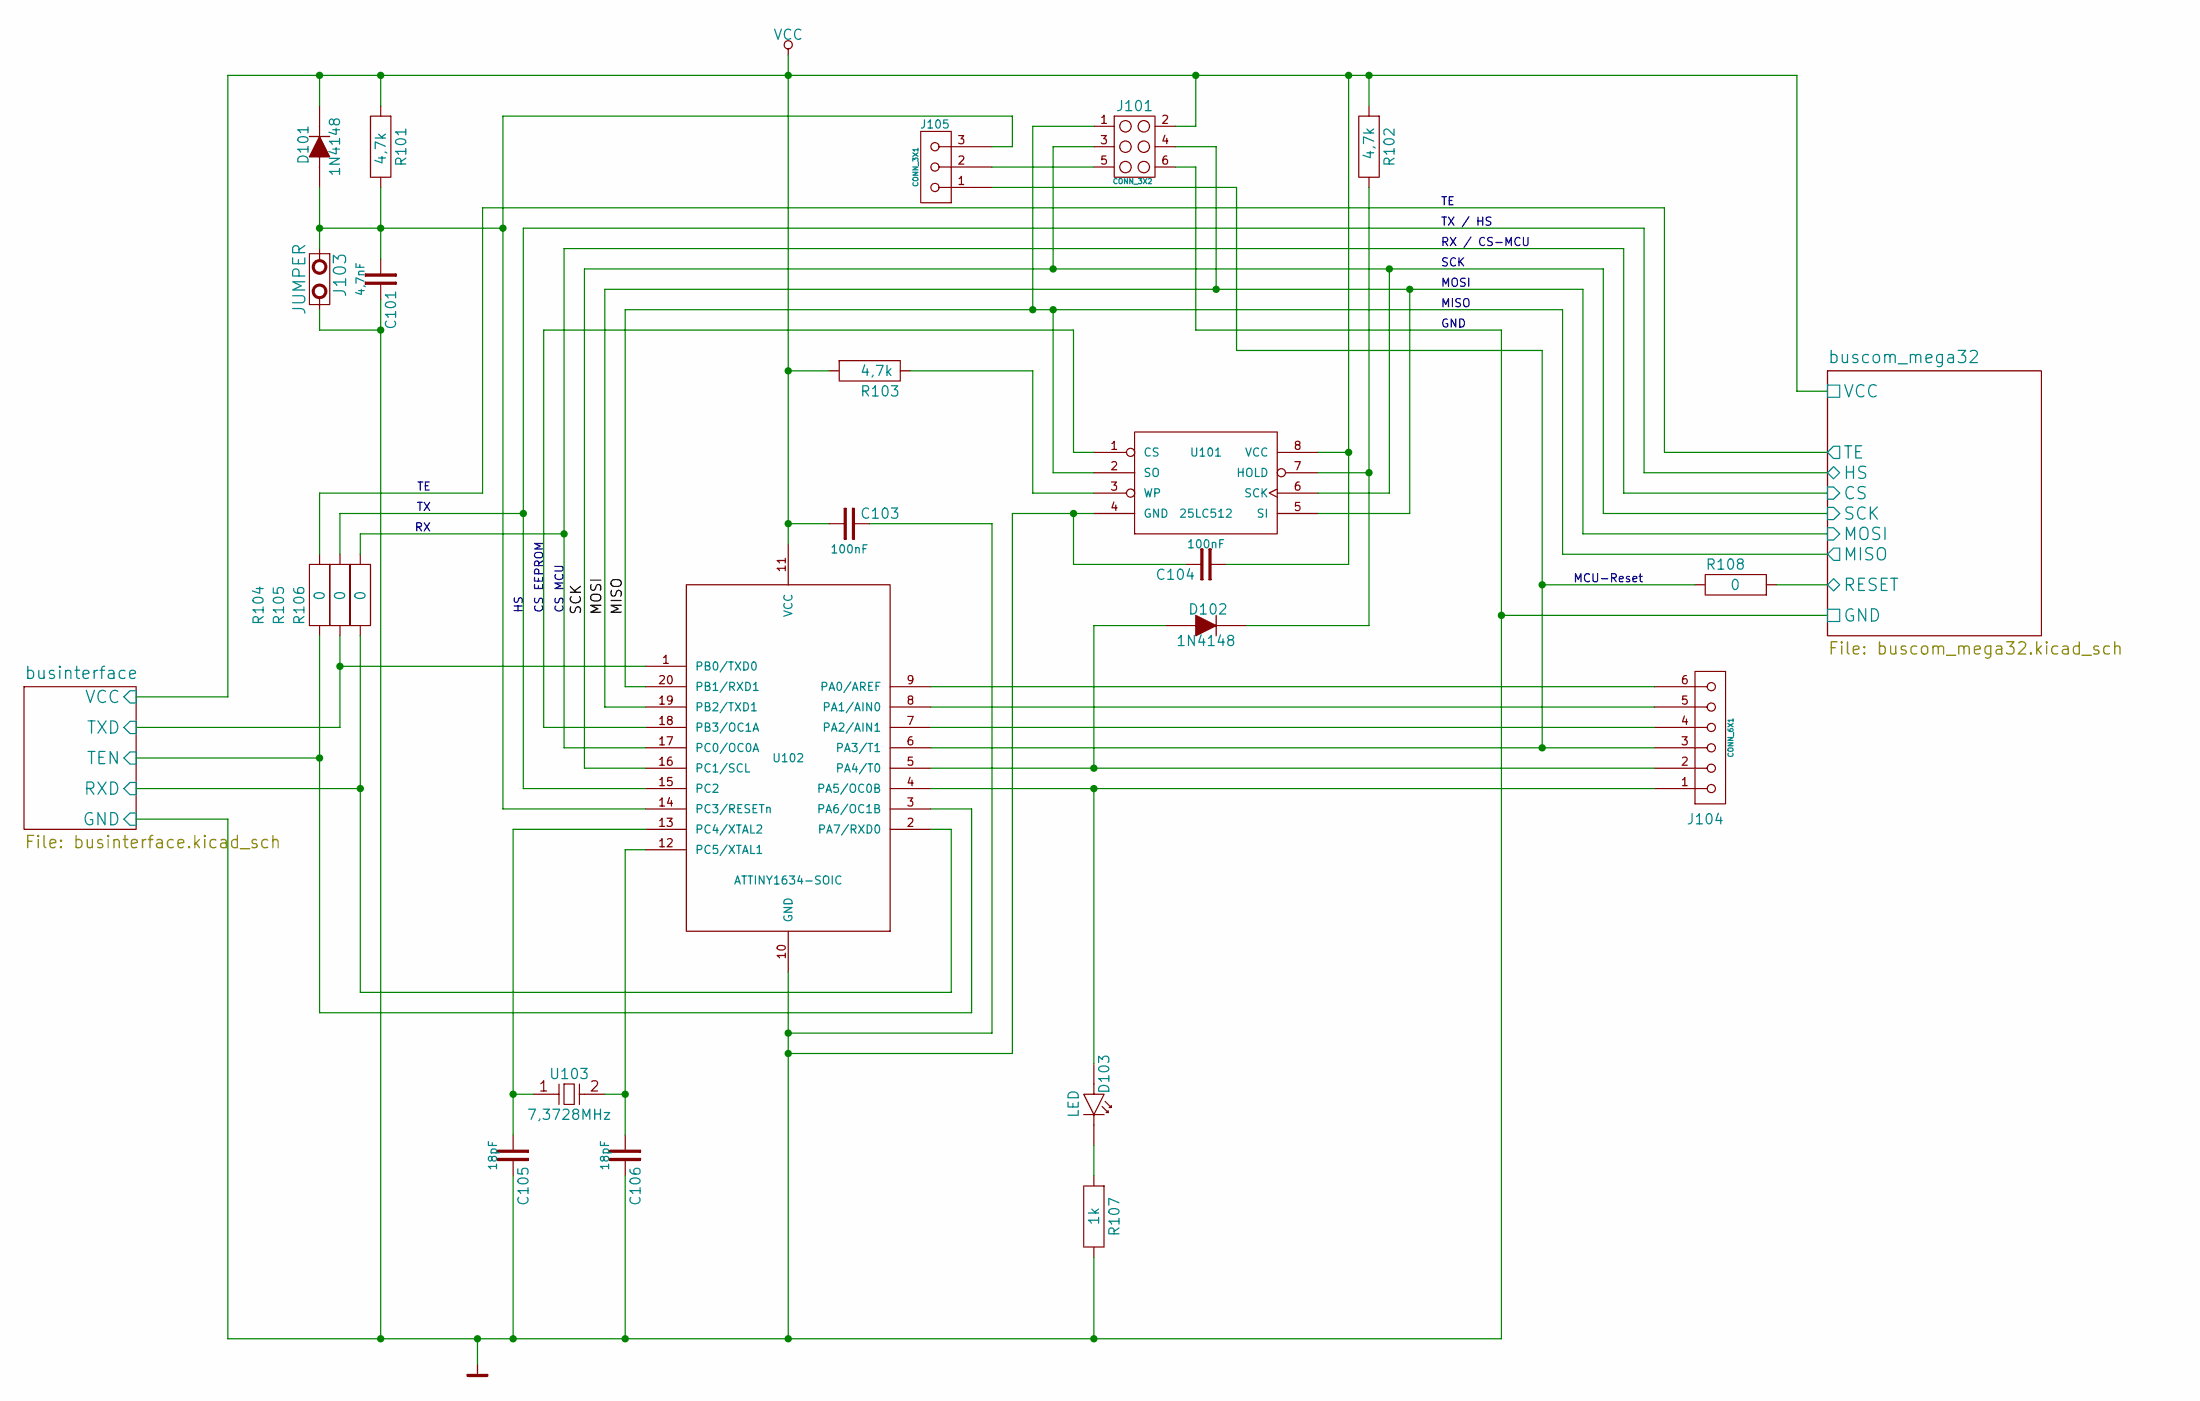
[picture p93: schematic buscom.kicad_sch]

Parts:
C101: 4,7nF
C103, C104: 100nF
C105, C106: 18pF
D101, D102: 1N4148
D103: LED
J101: CONN_3X2
J103: JUMPER
J104: CONN_6X1
J105: CONN_3X1
R101, R102, R103: 4,7k
R104, R105, R106, R108: 0
R107: 1k
U101: 25LC512; SO8N
U102: ATTINY1634-SOIC; SO20L
U103: 7,3728MHz

Connections:
/buscom_1: C101.2, C103.2, C104.2, C105.2, C106.2, J101.6, J103.2, R107.2, U101.4 (GND), U102.10 (GND); also elsewhere on the board
/buscom_3: R108.1; also elsewhere on the board
/buscom_7: J101.1, U101.2 (SO), U102.20 (PB1/RXD1); also elsewhere on the board
/buscom_8: J101.3, U101.6 (SCK), U102.16 (PC1/SCL); also elsewhere on the board
/buscom_9: J101.4, U101.5 (SI), U102.19 (PB2/TXD1); also elsewhere on the board
/buscom_36: R104.1; also elsewhere on the board
/buscom_37: R105.1, U102.15 (PC2); also elsewhere on the board
/buscom_38: R106.1, U102.17 (PC0/OC0A); also elsewhere on the board
/businte2: C103.1, C104.1, D101.2 (C), J101.2, R101.1, R102.1, R103.1, U101.8 (VCC), U102.11 (VCC); also elsewhere on the board
/businte42: R104.2, U102.3 (PA6/OC1B); also elsewhere on the board
/businte43: R105.2, U102.1 (PB0/TXD0); also elsewhere on the board
/businte44: R106.2, U102.2 (PA7/RXD0); also elsewhere on the board
unnamed: J101.5, J105.2
unnamed: J104.3, J105.1, R108.2, U102.6 (PA3/T1)
unnamed: D102.1 (A), J104.2, U102.5 (PA4/T0)
unnamed: U101.1 (CS), U102.18 (PB3/OC1A)
unnamed: C106.1, U102.12 (PC5/XTAL1), U103.2
unnamed: J104.6, U102.9 (PA0/AREF)
unnamed: J104.5, U102.8 (PA1/AIN0)
unnamed: J104.4, U102.7 (PA2/AIN1)
unnamed: D102.2 (C), R102.2, U101.7 (HOLD)
unnamed: R103.2, U101.3 (WP)
unnamed: D103.2 (C), R107.1
unnamed: D103.1 (A), J104.1, U102.4 (PA5/OC0B)
unnamed: C101.1, D101.1 (A), J103.1, J105.3, R101.2, U102.14 (PC3/RESETn)
unnamed: C105.1, U102.13 (PC4/XTAL2), U103.1

Notes on the sheet:
CS EEPROM
MOSI
SCK
MCU-Reset
CS MCU
GND
MISO
RX / CS-MCU
TX / HS

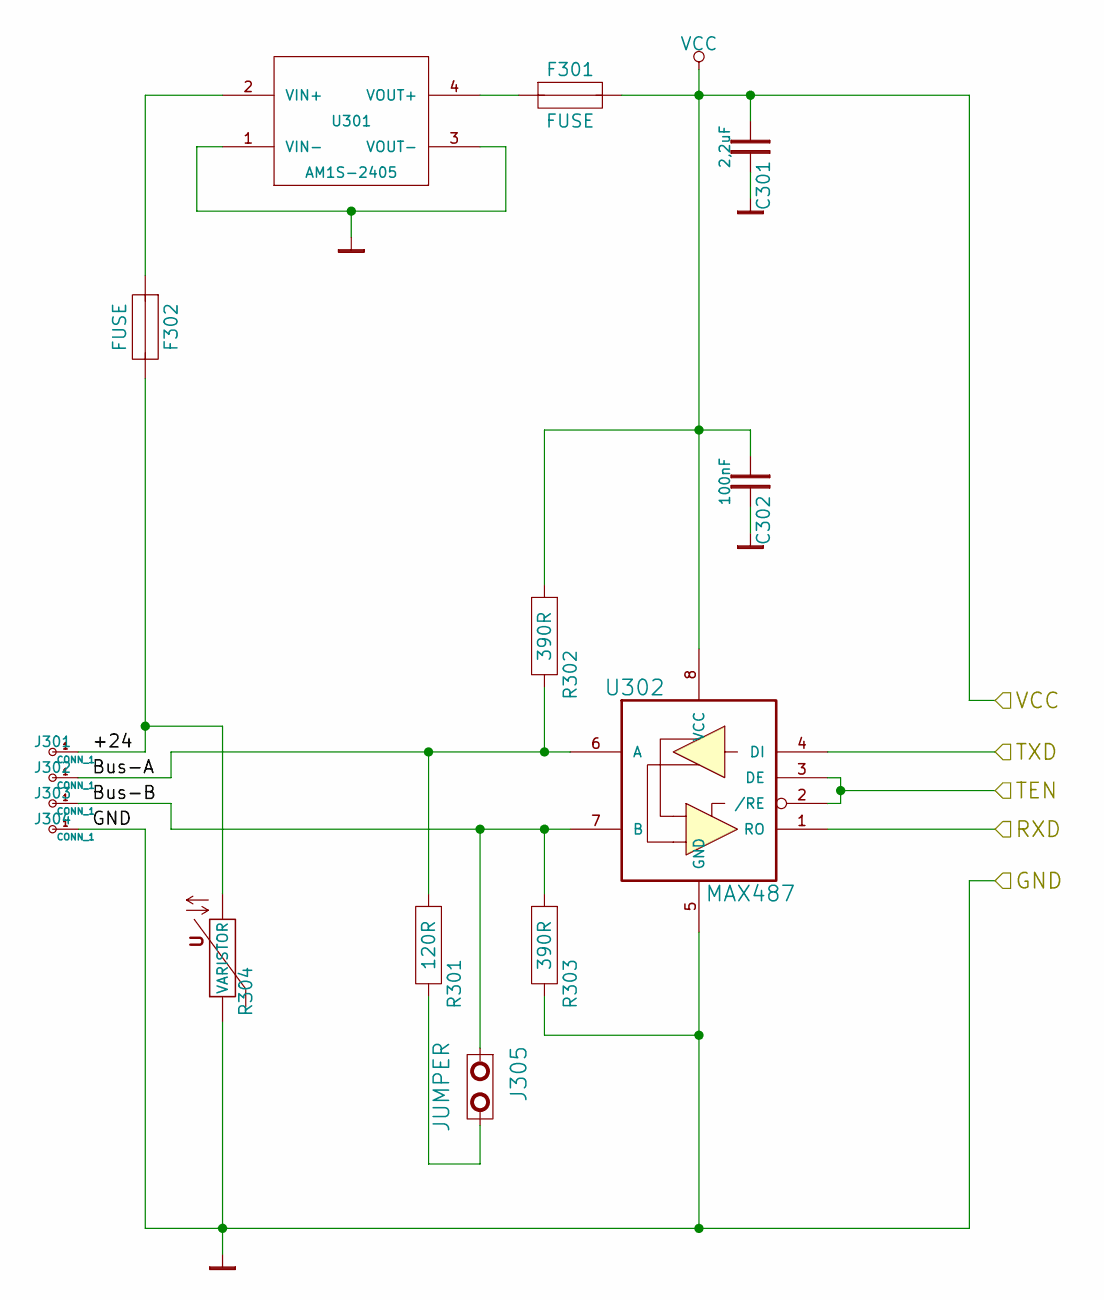
[picture p94: schematic businterface.kicad_sch]

Parts:
C301: 2,2uF
C302: 100nF
F301, F302: FUSE
J301, J302, J303, J304: CONN_1
J305: JUMPER
R301: 120R
R302, R303: 390R
R304: VARISTOR
U301: AM1S-2405; MODULE
U302: MAX487; SSOP28

Connections:
/buscom_1: C301.2, C302.2, J304.1, R303.2, R304.1, U301.1 (VIN-), U301.3 (VOUT-), U302.5 (GND); also elsewhere on the board
/businte2: C301.1, C302.1, F301.2, R302.1, U302.8 (VCC); also elsewhere on the board
/businte6: F302.2, J301.1, R304.2
/businte40: J302.1, R301.1, R302.2, U302.6 (A)
/businte41: J303.1, J305.1, R303.1, U302.7 (B)
/businte42: U302.2 (/RE), U302.3 (DE); also elsewhere on the board
/businte43: U302.4 (DI); also elsewhere on the board
/businte44: U302.1 (RO); also elsewhere on the board
unnamed: F302.1, U301.2 (VIN+)
unnamed: F301.1, U301.4 (VOUT+)
unnamed: J305.2, R301.2

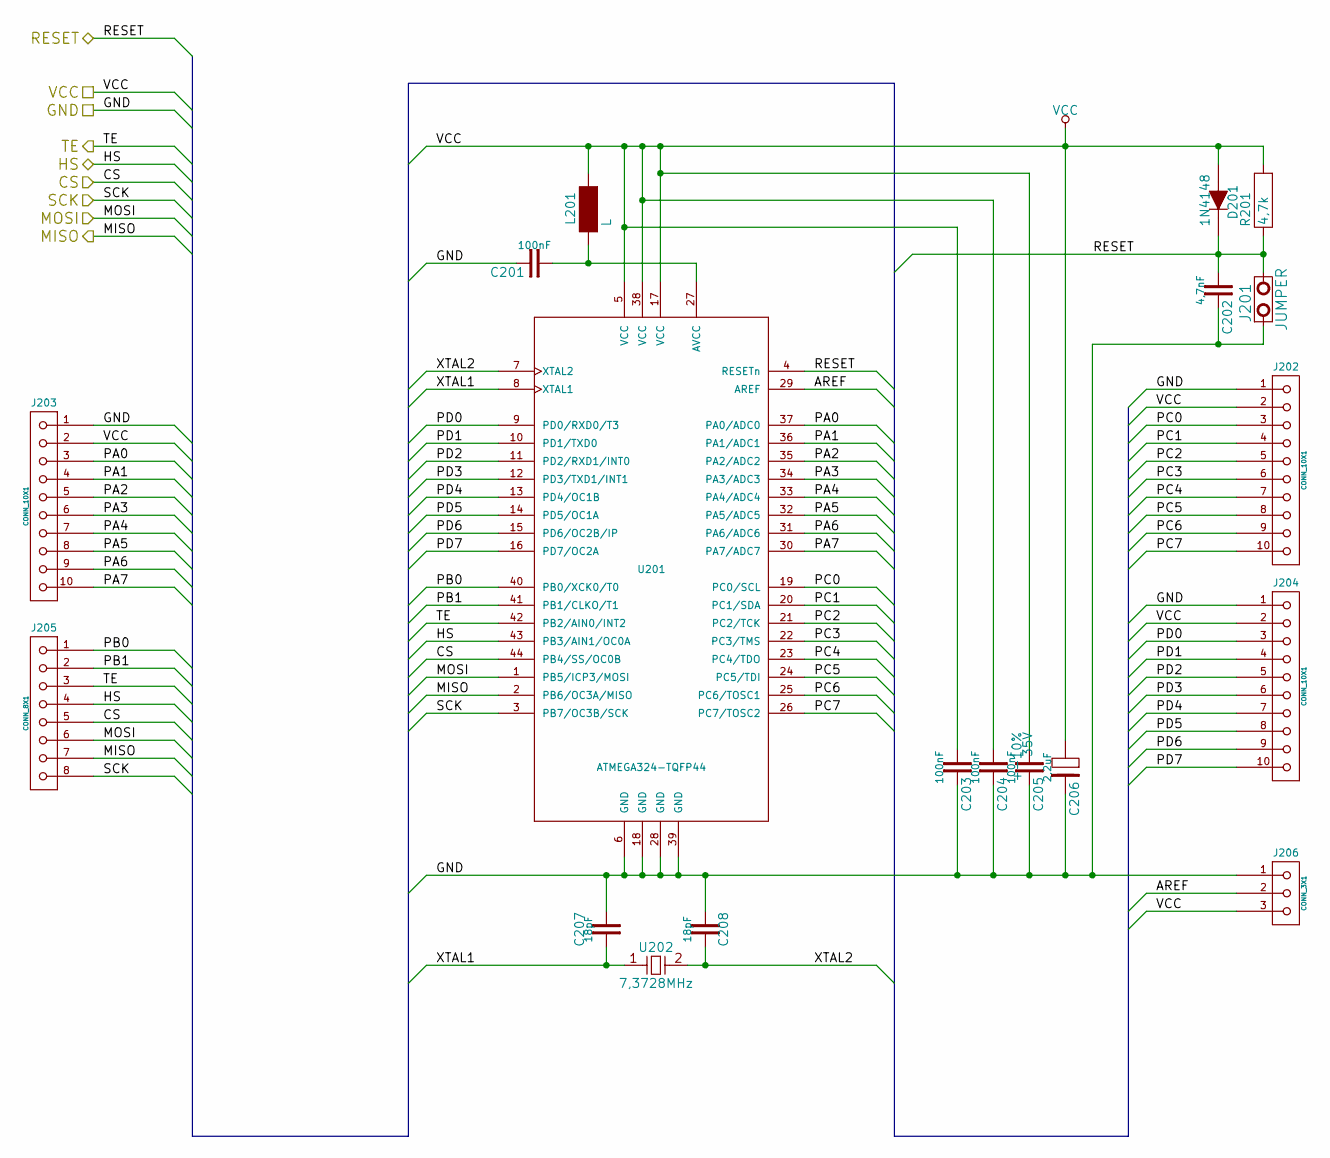
[picture p95: schematic buscom_mega32.kicad_sch]

Parts:
C201, C203, C204, C205: 100nF
C202: 4,7nF
C206: 2,2uF; 35V
C207, C208: 18pF
D201: 1N4148
J201: JUMPER
J202, J203, J204: CONN_10X1
J205: CONN_8X1
J206: CONN_3X1
L201: L
R201: 4,7k
U201: ATMEGA324-TQFP44; TQFP44
U202: 7,3728MHz

Connections:
/buscom_1: C201.2, C202.2, C203.2, C204.2, C205.2, C206.2, C207.1, C208.1, J201.1, J202.1, J203.1, J204.1, J206.1, U201.6 (GND), U201.18 (GND), U201.28 (GND), U201.39 (GND); also elsewhere on the board
/buscom_3: C202.1, D201.2 (C), J201.2, R201.2, U201.4 (RESETn); also elsewhere on the board
/buscom_4: C207.2, U201.8 (XTAL1), U202.1
/buscom_5: C208.2, U201.7 (XTAL2), U202.2
/buscom_7: J205.7, U201.2 (PB6/OC3A/MISO); also elsewhere on the board
/buscom_8: J205.8, U201.3 (PB7/OC3B/SCK); also elsewhere on the board
/buscom_9: J205.6, U201.1 (PB5/ICP3/MOSI); also elsewhere on the board
/buscom_10: J202.3, U201.19 (PC0/SCL)
/buscom_11: J202.4, U201.20 (PC1/SDA)
/buscom_12: J202.5, U201.21 (PC2/TCK)
/buscom_13: J202.6, U201.22 (PC3/TMS)
/buscom_14: J202.7, U201.23 (PC4/TDO)
/buscom_15: J202.8, U201.24 (PC5/TDI)
/buscom_16: J202.9, U201.25 (PC6/TOSC1)
/buscom_17: J202.10, U201.26 (PC7/TOSC2)
/buscom_18: J203.3, U201.37 (PA0/ADC0)
/buscom_19: J203.4, U201.36 (PA1/ADC1)
/buscom_20: J203.5, U201.35 (PA2/ADC2)
/buscom_21: J203.6, U201.34 (PA3/ADC3)
/buscom_22: J203.7, U201.33 (PA4/ADC4)
/buscom_23: J203.8, U201.32 (PA5/ADC5)
/buscom_24: J203.9, U201.31 (PA6/ADC6)
/buscom_25: J203.10, U201.30 (PA7/ADC7)
/buscom_26: J204.3, U201.9 (PD0/RXD0/T3)
/buscom_27: J204.4, U201.10 (PD1/TXD0)
/buscom_28: J204.5, U201.11 (PD2/RXD1/INT0)
/buscom_29: J204.6, U201.12 (PD3/TXD1/INT1)
/buscom_30: J204.7, U201.13 (PD4/OC1B)
/buscom_31: J204.8, U201.14 (PD5/OC1A)
/buscom_32: J204.9, U201.15 (PD6/OC2B/IP)
/buscom_33: J204.10, U201.16 (PD7/OC2A)
/buscom_34: J205.1, U201.40 (PB0/XCK0/T0)
/buscom_35: J205.2, U201.41 (PB1/CLKO/T1)
/buscom_36: J205.3, U201.42 (PB2/AIN0/INT2); also elsewhere on the board
/buscom_37: J205.4, U201.43 (PB3/AIN1/OC0A); also elsewhere on the board
/buscom_38: J205.5, U201.44 (PB4/SS/OC0B); also elsewhere on the board
/buscom_39: J206.2, U201.29 (AREF)
/businte2: C203.1, C204.1, C205.1, C206.1, D201.1 (A), J202.2, J203.2, J204.2, J206.3, L201.1, R201.1, U201.5 (VCC), U201.17 (VCC), U201.38 (VCC); also elsewhere on the board
unnamed: C201.1, L201.2, U201.27 (AVCC)

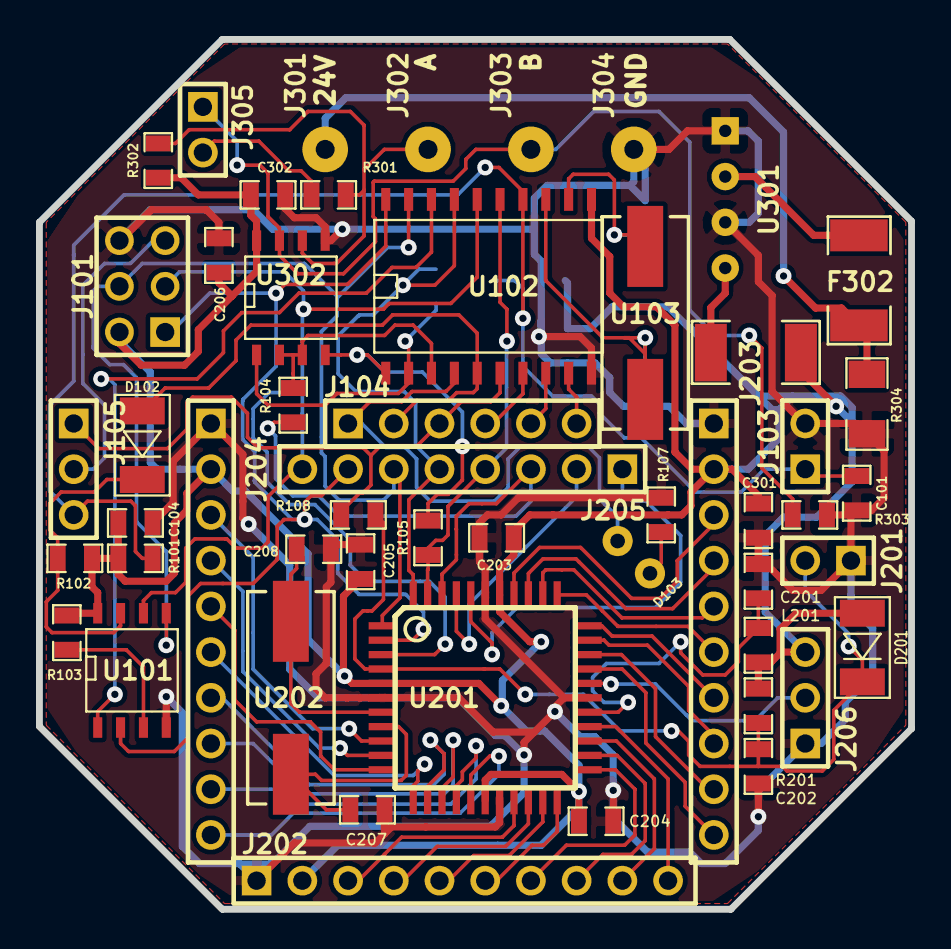
[picture p96: board buscom.kicad_pcb from above]

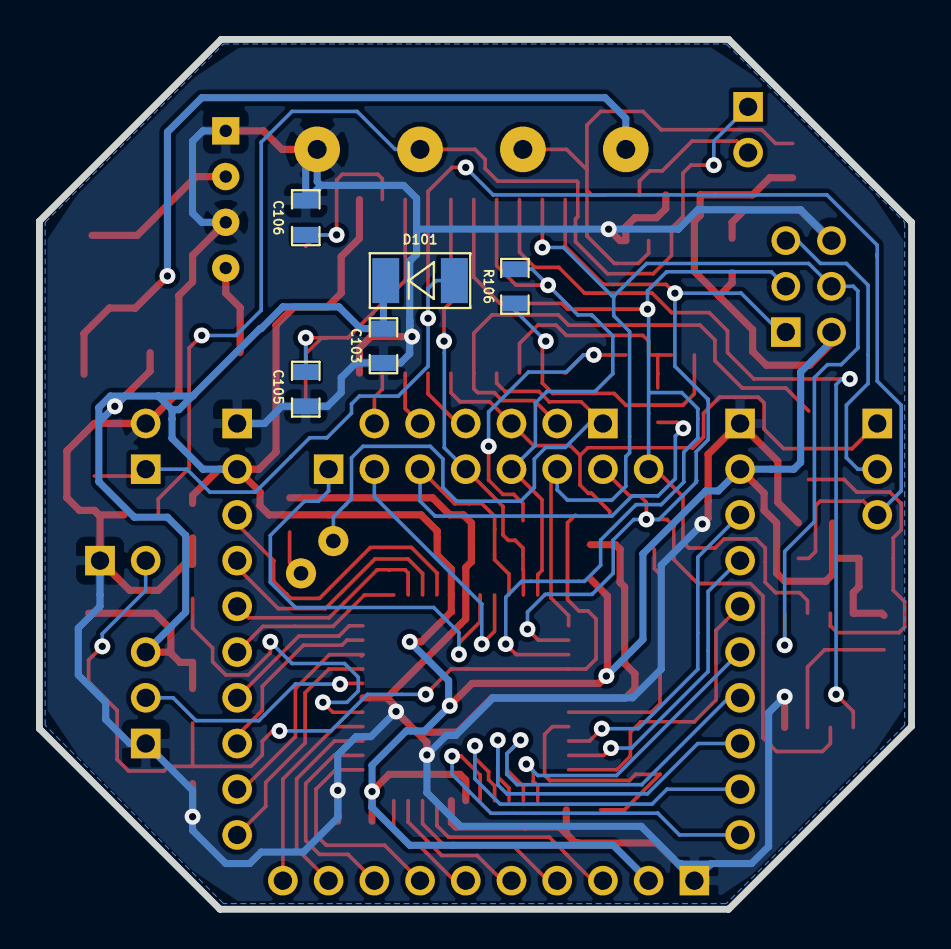
[picture p97: board buscom.kicad_pcb from below]

Board: 2 copper layers, 48.5 x 48.3 mm, 57 parts (5 on the bottom side), 62 nets.
