irqmask/koewiba-domotic/hw/koewibapi/koewibapi.kicad_pcb

## KiCad design hw/koewibapi/koewibapi.kicad_pcb (2023-11-28)

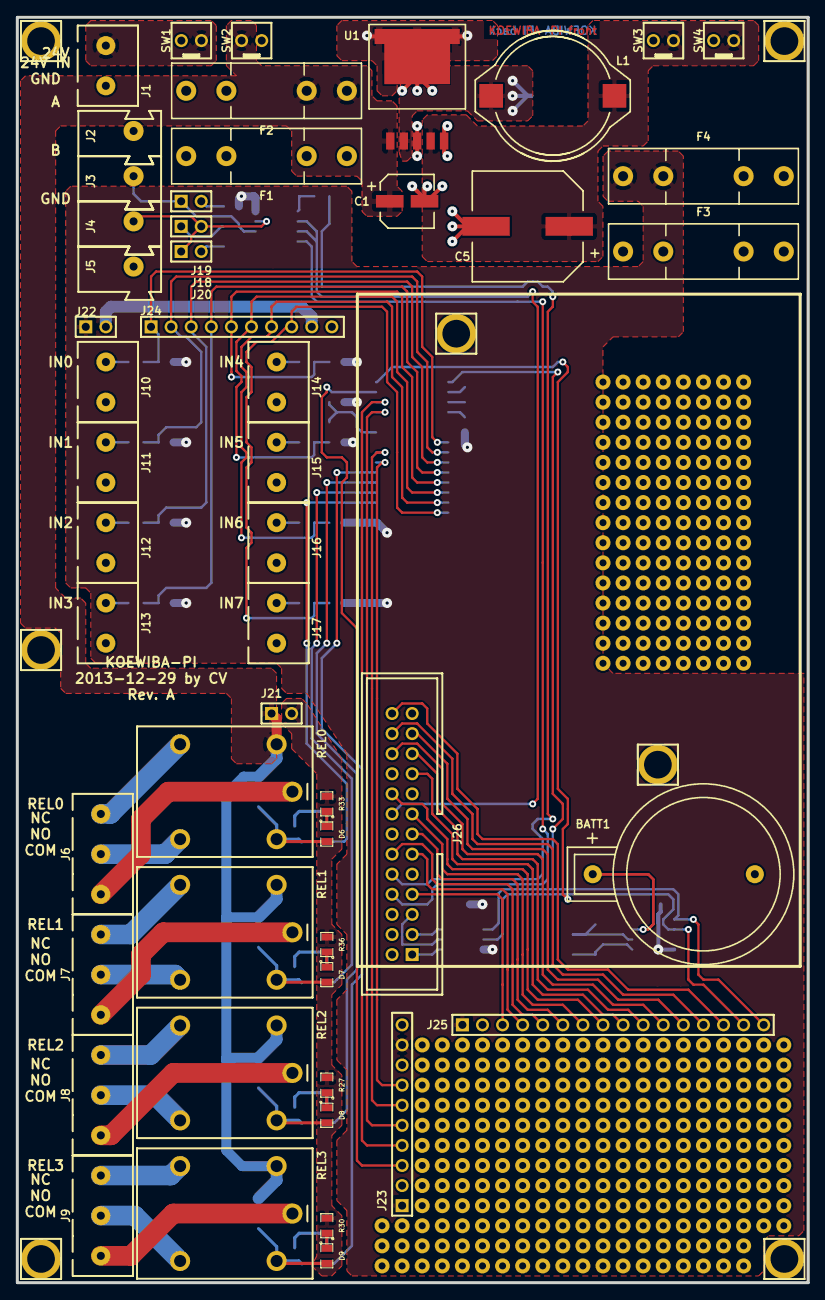
[picture p98: board koewibapi.kicad_pcb from above]

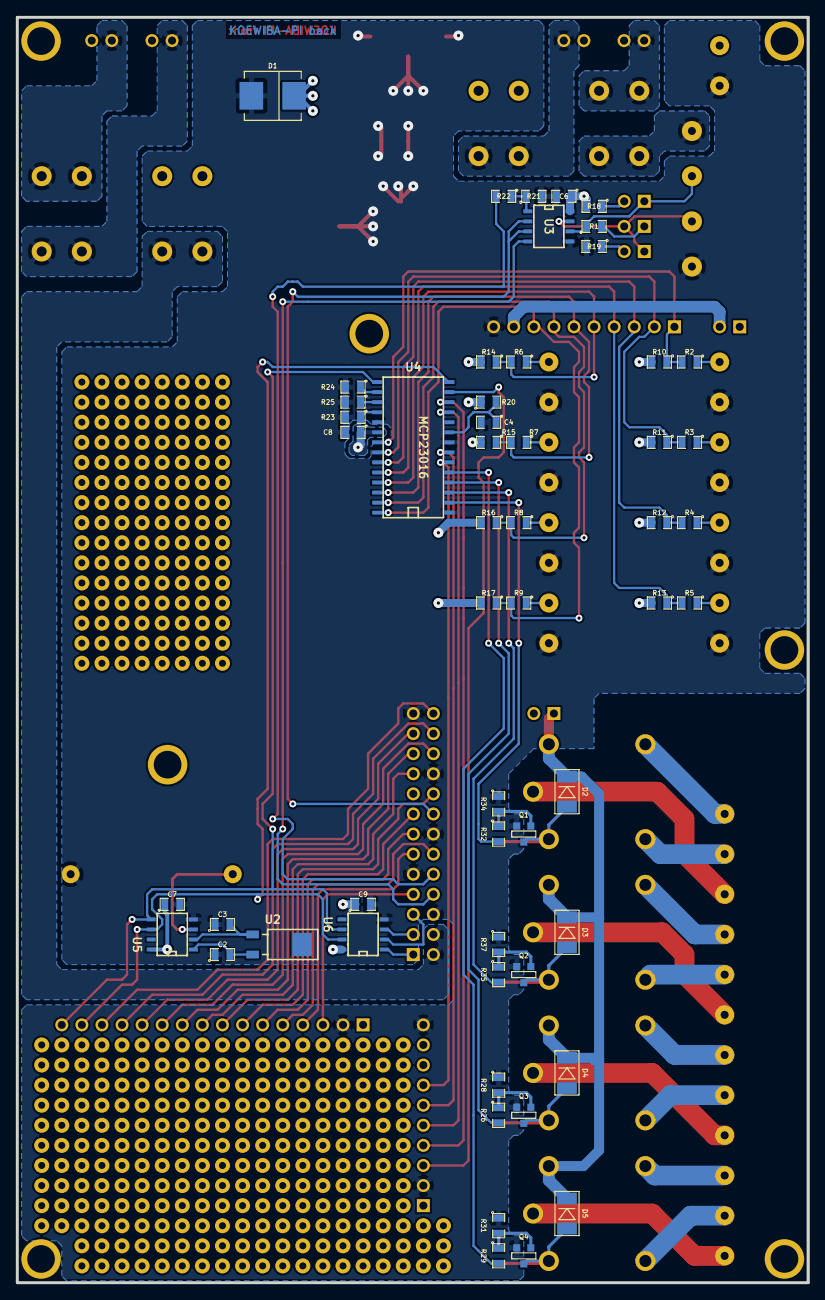
[picture p99: board koewibapi.kicad_pcb from below]

Board: 2 copper layers, 100.0 x 160.0 mm, 134 parts (54 on the bottom side), 96 nets.

Parts:
BATT1: 3V; CR2032H
C1: 100uF; cp_smd_6.3
C2, C3: 12.5pF; SM0805
C4: 33pF; SM0805
C5: 1000uF; cp_smd_12.5
C6, C7, C8, C9: 100nF; SM0805
D1: B_340_F; SMC
D2, D3, D4, D5: 1N4148; MINIMELF
D6, D7, D8, D9: LED_2,2V_25mA; SM0805
F1: 250V/1A_T; FUSE5-20
F2: 250V2,5A_T; FUSE5-20
F3: 250V/1,5A_T; FUSE5-20
F4: 250V/250mA_T; FUSE5-20
FIELD2x1, FIELD2x1#2, FIELD2x1#3, FIELD2x1#4, FIELD2x1#5: VAL**; FIELD2x1
FIELD5x2, FIELD5x2#2, FIELD5x2#3: VAL**; FIELD5x2
FIELD5x3, FIELD5x3#2, FIELD5x3#3: VAL**; FIELD5x3
FIELD5x4, FIELD5x4#2: VAL**; FIELD5x4
FIELD5x5, FIELD5x5#2, FIELD5x5#3, FIELD5x5#4, FIELD5x5#5, FIELD5x5#6, FIELD5x5#7, FIELD5x5#8, FIELD5x5#9: VAL**; FIELD5x5
H1, H2, H3, H4, H5, H6, H7: HOLE; HOLE_3.5mm
J1: POWER_IN_24V; CLAMP_5,08mm_2pole_stackable
J2: BUS_24V; WAGO243
J3, J4: CONN_1X1; WAGO243
J5: BUS_GND; WAGO243
J6: REL0; CLAMP_5,08mm_3pole_stackable
J7: REL1; CLAMP_5,08mm_3pole_stackable
J8: REL2; CLAMP_5,08mm_3pole_stackable
J9: REL3; CLAMP_5,08mm_3pole_stackable
J10: IN0; CLAMP_5,08mm_2pole_stackable
J11: IN1; CLAMP_5,08mm_2pole_stackable
J12: IN2; CLAMP_5,08mm_2pole_stackable
J13: IN3; CLAMP_5,08mm_2pole_stackable
J14: IN4; CLAMP_5,08mm_2pole_stackable
J15: IN5; CLAMP_5,08mm_2pole_stackable
J16: IN6; CLAMP_5,08mm_2pole_stackable
J17: IN7; CLAMP_5,08mm_2pole_stackable
J18: Terminate_Bus; HEADER_2x1
J19: Bus_Pull-Up; HEADER_2x1
J20: Bus_Pull-Down; HEADER_2x1
J21: Activate_output_LEDs; HEADER_2x1
J22: Activate_Input_LEDs; HEADER_2x1
J23: unused_GPIO_Pins; HEADER_10x1
J24: Input_Signals; HEADER_10x1
J25: unused_RPi_Rins; HEADER_16x1
J26: CONN_RASPI_REV2; HEADER_26
L1: 220uH; PISR
Q1, Q2, Q3, Q4: BSS138; SOT23-3
R1: 120; SM0805
R2, R3, R4, R5, R6, R7, R8, R9, R18, R19, R23, R24, R25, R27, R30, R33, R36: 1k; SM0805
R10, R11, R12, R13, R14, R15, R16, R17, R21, R28, R31, R34, R37: 10k; SM0805
R20: 3,9k; SM0805
R22: 5k6; SM0805
R26, R29, R32, R35: 100; SM0805
REL0, REL1, REL2, REL3: OMRON_G5LE-1; omron_G5LE-1
SW1: MAIN; PCB_CON2
SW2: 24V_BUS; PCB_CON2
SW3: 5V_RASPI; PCB_CON2
SW4: 5V_LOGIC; PCB_CON2
U1: LM2576; TO263_5
U2: 32.768kHz; CRYSTAL_MS1V-7
U3: MAX487; SO8E
U4: MCP23016; SO28
U5: DS1307; SO8E
U6: PCA9517; SO8E

Connections:
+3.3V: J26.1, U6.1
+5V: C6.1, C7.1, C8.1, C9.1, F4.2, J22.1, J23.1, J23.9, J25.1, R10.2, R11.2, R12.2, R13.2, R14.2, R15.2, R16.2, R17.2, R18.2, R20.1, U3.8, U4.20, U5.8, U6.8
+24V: C1.1, D2.2, D3.2, D4.2, D5.2, F2.2, J21.1, REL0.5, REL1.5, REL2.5, REL3.5, SW2.2, U1.1
/GP1.4: J23.6, U4.7
/GP1.5: J23.5, U4.11
/GP1.6: J23.4, U4.12
/GP1.7: J23.3, U4.13
/GPINT: J23.7, U4.6
/IN0: J24.1, R2.2, R10.1, U4.21
/IN1: J24.2, R3.2, R11.1, U4.22
/IN2: J24.3, R4.2, R12.1, U4.23
/IN3: J24.4, R5.2, R13.1, U4.24
/IN4: J24.5, R6.2, R14.1, U4.25
/IN5: J24.6, R7.2, R15.1, U4.26
/IN6: J24.7, R8.2, R16.1, U4.27
/IN7: J24.8, R9.2, R17.1, U4.28
/RGPIO4: J25.3, J26.7
/RGPIO7: J25.14, J26.26
/RGPIO8: J25.13, J26.24
/RGPIO9: J25.10, J26.21
/RGPIO10: J25.9, J26.19
/RGPIO11: J25.12, J26.23
/RGPIO17: J25.4, J26.11
/RGPIO18: J25.5, J26.12
/RGPIO22: J25.7, J26.15
/RGPIO24: J25.8, J26.18
/RGPIO25: J25.11, J26.22
/RGPIO27: J25.6, J26.13
/RSCL: J26.5, U6.2
/RSDA: J26.3, U6.3
/RXD: J26.10, R22.2
/Relays_0-1/LEDVCC: J21.2, R27.2, R30.2, R33.2, R36.2
/Relays_0-1/OUTCOM1: J6.3, REL0.1
/Relays_0-1/OUTCOM2: J7.3, REL1.1
/Relays_0-1/OUTNC1: J6.1, REL0.4
/Relays_0-1/OUTNC2: J7.1, REL1.4
/Relays_0-1/OUTNO1: J6.2, REL0.3
/Relays_0-1/OUTNO2: J7.2, REL1.3
/Relays_0-1/REL1: R32.2, U4.2
/Relays_0-1/REL2: R35.2, U4.3
/Relays_2-3/OUTCOM1: J8.3, REL2.1
/Relays_2-3/OUTCOM2: J9.3, REL3.1
/Relays_2-3/OUTNC1: J8.1, REL2.4
/Relays_2-3/OUTNC2: J9.1, REL3.4
/Relays_2-3/OUTNO1: J8.2, REL2.3
/Relays_2-3/OUTNO2: J9.2, REL3.3
/Relays_2-3/REL1: R26.2, U4.4
/Relays_2-3/REL2: R29.2, U4.5
/SCL: J25.15, U4.14, U5.6, U6.7
/SDA: J25.16, U4.15, U5.5, U6.6
/TXD: J26.8, U3.4
/TXDEN: J26.16, U3.2, U3.3
GND: BATT1.2, C1.2, C2.1, C3.1, C4.2, C5.2, C6.2, C7.2, C8.2, C9.2, D1.1, J1.2, J5.1, J10.2, J11.2, J12.2, J13.2, J14.2, J15.2, J16.2, J17.2, J23.2, J23.10, J24.10, J25.2, J26.6, J26.9, J26.14, J26.20, J26.25, Q1.2, Q2.2, Q3.2, Q4.2, R19.2, R21.2, R23.2, R24.2, R25.2, R28.1, R31.1, R34.1, R37.1, U1.3, U1.5, U3.5, U4.1, U4.8, U4.19, U5.4, U6.4
unnamed: J11.1, R3.1
unnamed: J10.1, R2.1
unnamed: J15.1, R7.1
unnamed: J14.1, R6.1
unnamed: J16.1, R8.1
unnamed: J17.1, R9.1
unnamed: J13.1, R5.1
unnamed: J12.1, R4.1
unnamed: J20.2, R19.1
unnamed: J19.2, R18.1
unnamed: J18.1, R1.2
unnamed: R24.1, U4.16
unnamed: R25.1, U4.17
unnamed: R23.1, U4.18
unnamed: R21.1, R22.1, U3.1
unnamed: D1.2, L1.1, U1.2
unnamed: F4.1, SW4.2
unnamed: F3.1, SW3.2
unnamed: F1.2, SW2.1
unnamed: J1.1, SW1.1
unnamed: F1.1, J2.1
unnamed: F2.1, SW1.2
unnamed: BATT1.1, U5.3
unnamed: C2.2, U2.1, U5.1
unnamed: C3.2, U2.2, U5.2
unnamed: F3.2, J26.2, J26.4
unnamed: C5.1, L1.2, SW3.1, SW4.1, U1.4
unnamed: J3.1, J19.1, R1.1, U3.6
unnamed: J4.1, J18.2, J20.1, U3.7
unnamed: C4.1, R20.2, U4.9
unnamed: J22.2, J24.9
unnamed: D2.1, D6.2, Q1.3, REL0.2
unnamed: D7.1, R36.1
unnamed: D3.1, D7.2, Q2.3, REL1.2
unnamed: D6.1, R33.1
unnamed: Q2.1, R35.1, R37.2
unnamed: Q1.1, R32.1, R34.2
unnamed: D9.1, R30.1
unnamed: D4.1, D8.2, Q3.3, REL2.2
unnamed: D5.1, D9.2, Q4.3, REL3.2
unnamed: D8.1, R27.1
unnamed: Q4.1, R29.1, R31.2
unnamed: Q3.1, R26.1, R28.2
