irqmask/koewiba-domotic/hw/gateway_usb/gateway_usb.kicad_pcb

## KiCad design hw/gateway_usb/gateway_usb.kicad_pcb (2023-11-28)

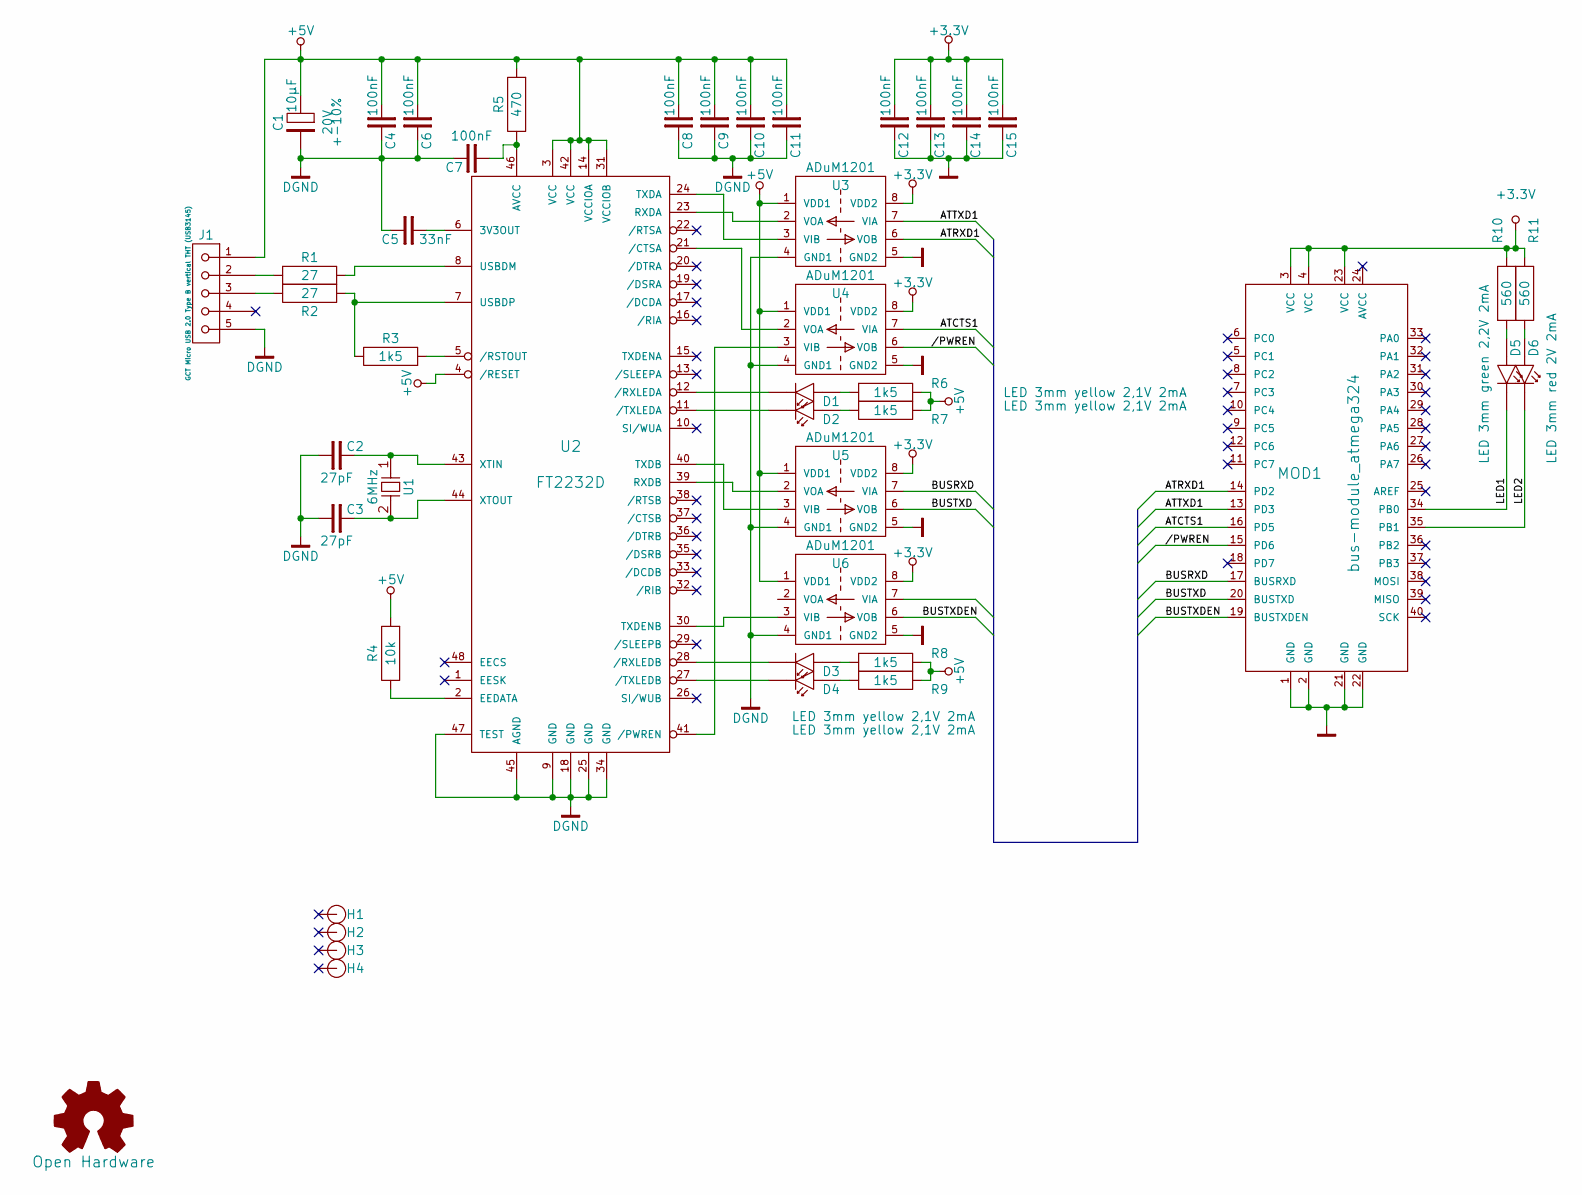
[picture p100: schematic gateway_usb.kicad_sch, Gateway USB]

Parts:
C1: 10µF; cp_smd_6.3; Voltage 20V
C2, C3: 27pF; SM0805
C4, C6, C7, C8, C9, C10, C11, C12, C13, C14, C15: 100nF; SM0805
C5: 33nF; SM0805
D1, D2, D3, D4: LED 3mm yellow 2,1V 2mA; LED_3MM
D5: LED 3mm green 2,2V 2mA; LED_3MM
D6: LED 3mm red 2V 2mA; LED_3MM
H1, H2, H3, H4: HOLE; HOLE_3.5x7mm
J1: GCT Micro USB 2.0 Type B vertical THT (USB3145); USB2.0_micro_THT_vertical_GCT_USB3145
LOGO1: Open Hardware; Symbol_OSHW-Logo_SilkScreen
MOD1: bus-module_atmega324
R1, R2: 27; SM0805
R3, R6, R7, R8, R9: 1k5; SM0805
R4: 10k; SM0805
R5: 470; SM0805
R10, R11: 560; SM0805
U1: 6MHz; HC49-SMD
U2: FT2232D; LQFP-48_7x7mm_Pitch0.5mm
U3, U4, U5, U6: ADuM1201; SO8E

Connections:
+3.3V: C12.1, C13.1, C14.1, C15.1, MOD1.3 (VCC), MOD1.4 (VCC), MOD1.23 (VCC), R10.2, R11.2, U3.8 (VDD2), U4.8 (VDD2), U5.8 (VDD2), U6.8 (VDD2)
+5V: C1.1, C4.1, C6.1, C8.1, C9.1, C10.1, C11.1, J1.1, R4.1, R5.1, R6.2, R7.2, R8.2, R9.2, U2.3 (VCC), U2.4 (/RESET), U2.14 (VCCIOA), U2.31 (VCCIOB), U2.42 (VCC), U3.1 (VDD1), U4.1 (VDD1), U5.1 (VDD1), U6.1 (VDD1)
//PWREN: MOD1.15 (PD6), U4.6 (VOB)
/ATCTS1: MOD1.16 (PD5), U4.7 (VIA)
/ATRXD1: MOD1.14 (PD2), U3.6 (VOB)
/ATTXD1: MOD1.13 (PD3), U3.7 (VIA)
/BUSRXD: MOD1.17 (BUSRXD), U5.7 (VIA)
/BUSTXD: MOD1.20 (BUSTXD), U5.6 (VOB)
/BUSTXDEN: MOD1.19 (BUSTXDEN), U6.6 (VOB)
/LED1: D5.2 (C), MOD1.34 (PB0)
/LED2: D6.2 (C), MOD1.35 (PB1)
DGND: C1.2, C2.1, C3.1, C4.2, C5.2, C6.2, C7.1, C8.2, C9.2, C10.2, C11.2, J1.5, U2.9 (GND), U2.18 (GND), U2.25 (GND), U2.34 (GND), U2.45 (AGND), U2.47 (TEST), U3.4 (GND1), U4.4 (GND1), U5.4 (GND1), U6.4 (GND1)
GND: C12.2, C13.2, C14.2, C15.2, MOD1.1 (GND), MOD1.2 (GND), MOD1.21 (GND), MOD1.22 (GND), U3.5 (GND2), U4.5 (GND2), U5.5 (GND2), U6.5 (GND2)
unnamed: C2.2, U1.1, U2.43 (XTIN)
unnamed: C3.2, U1.2, U2.44 (XTOUT)
unnamed: C5.1, U2.6 (3V3OUT)
unnamed: C7.2, R5.2, U2.46 (AVCC)
unnamed: D1.1 (A), R6.1
unnamed: D1.2 (C), U2.12 (/RXLEDA)
unnamed: D2.1 (A), R7.1
unnamed: D2.2 (C), U2.11 (/TXLEDA)
unnamed: D3.1 (A), R8.1
unnamed: D3.2 (C), U2.28 (/RXLEDB)
unnamed: D4.1 (A), R9.1
unnamed: D4.2 (C), U2.27 (/TXLEDB)
unnamed: D5.1 (A), R10.1
unnamed: D6.1 (A), R11.1
unnamed: J1.2, R1.1
unnamed: J1.3, R2.1
unnamed: R1.2, U2.8 (USBDM)
unnamed: R2.2, R3.2, U2.7 (USBDP)
unnamed: R3.1, U2.5 (/RSTOUT)
unnamed: R4.2, U2.2 (EEDATA)
unnamed: U2.21 (/CTSA), U4.2 (VOA)
unnamed: U2.23 (RXDA), U3.2 (VOA)
unnamed: U2.24 (TXDA), U3.3 (VIB)
unnamed: U2.30 (TXDENB), U6.3 (VIB)
unnamed: U2.39 (RXDB), U5.2 (VOA)
unnamed: U2.40 (TXDB), U5.3 (VIB)
unnamed: U2.41 (/PWREN), U4.3 (VIB)

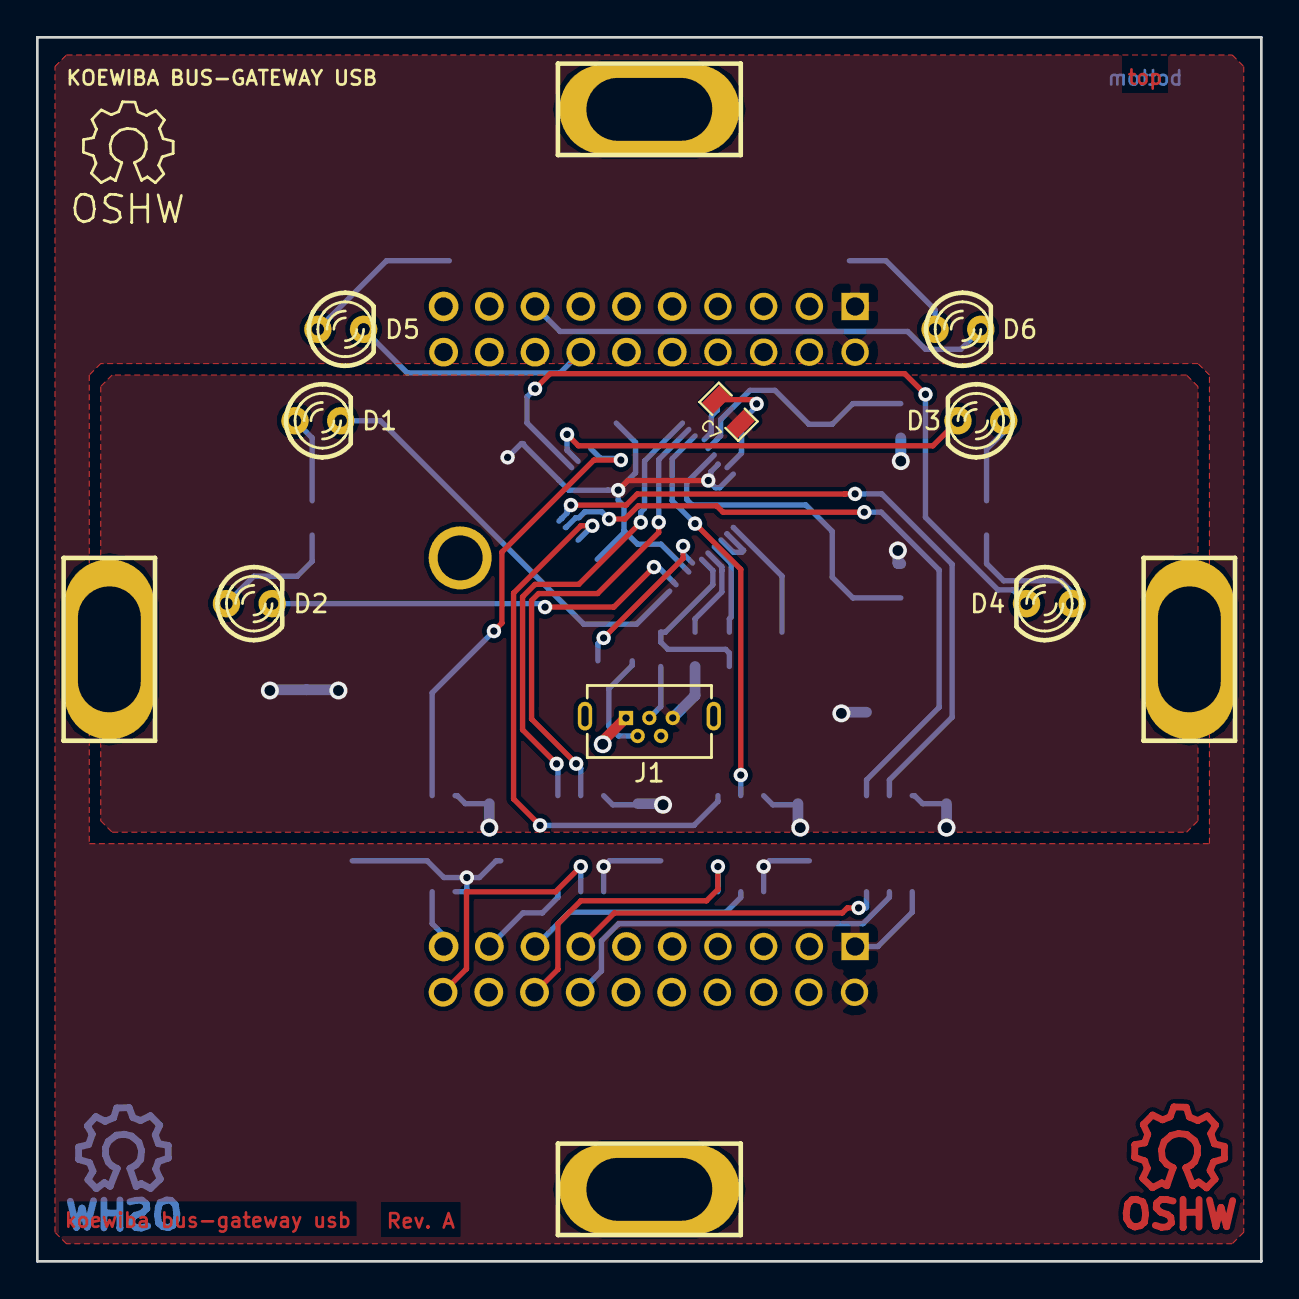
[picture p101: board gateway_usb.kicad_pcb from above]

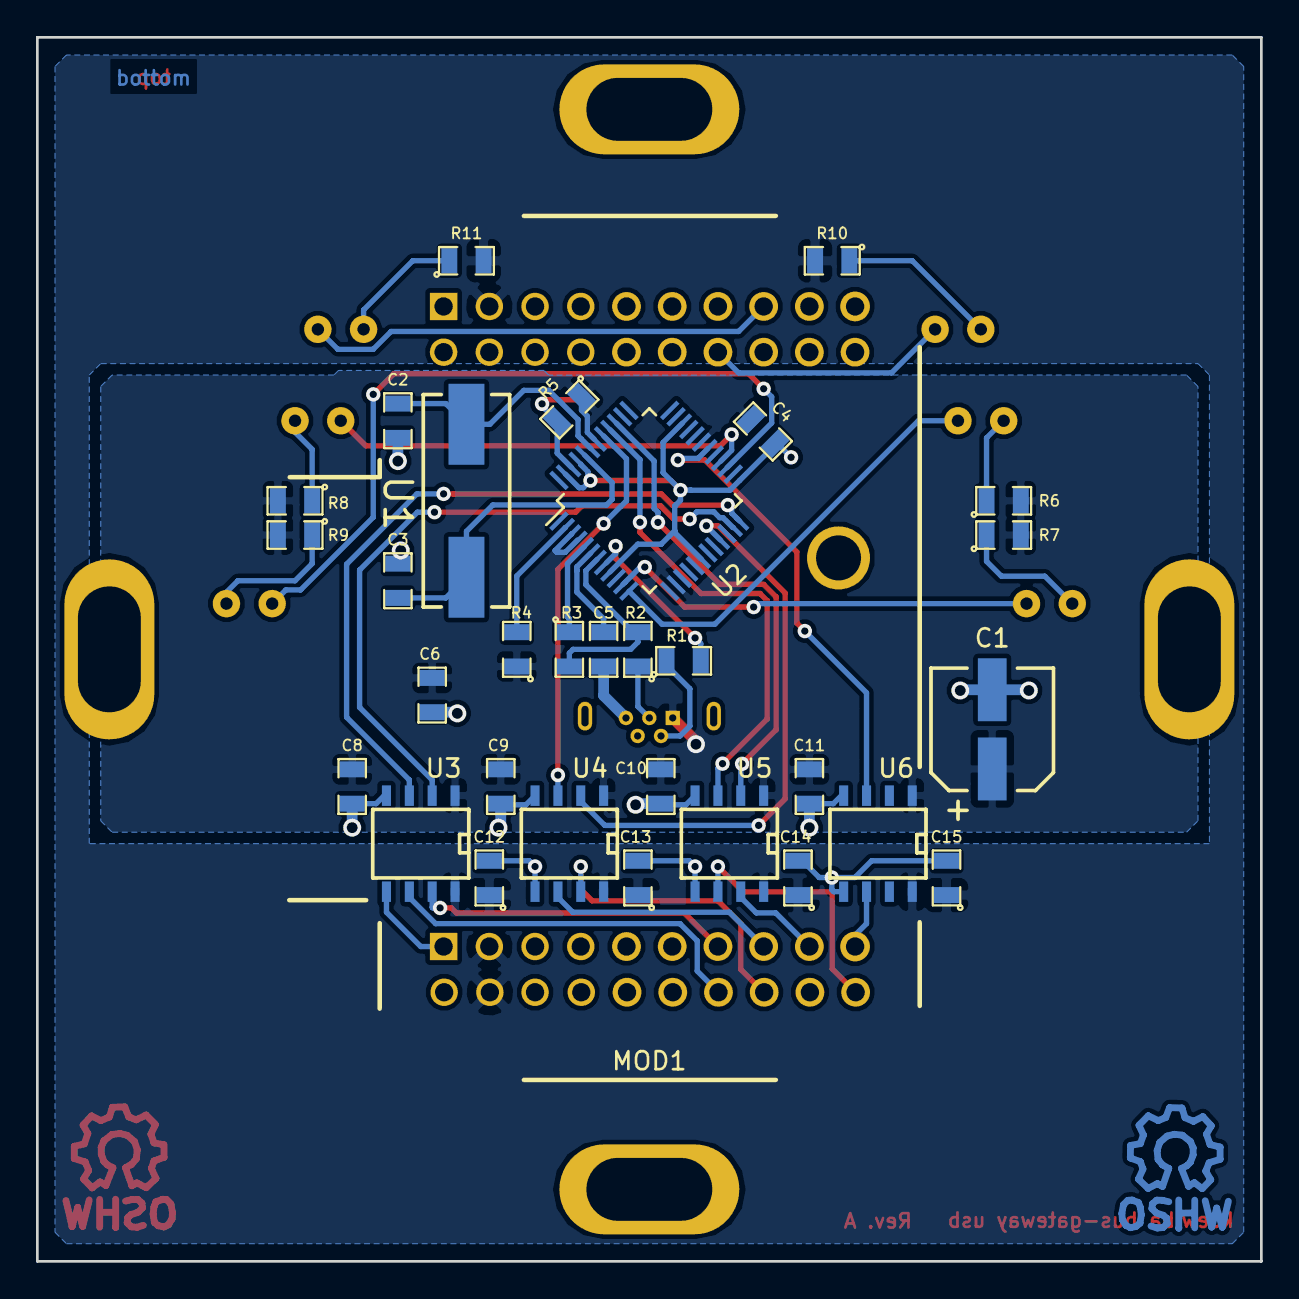
[picture p102: board gateway_usb.kicad_pcb from below]

Board: 2 copper layers, 68.0 x 68.0 mm, 47 parts (33 on the bottom side), 40 nets.

Other parts of the board:
LOGO1#2, LOGO1#3: Open Hardware; Symbol_OSHW-Logo_Copper
