irqmask/koewiba-domotic/hw/motor_switch_3pole/motor_switch_3pole.kicad_pcb

## KiCad design hw/motor_switch_3pole/motor_switch_3pole.kicad_pcb (2023-11-28)

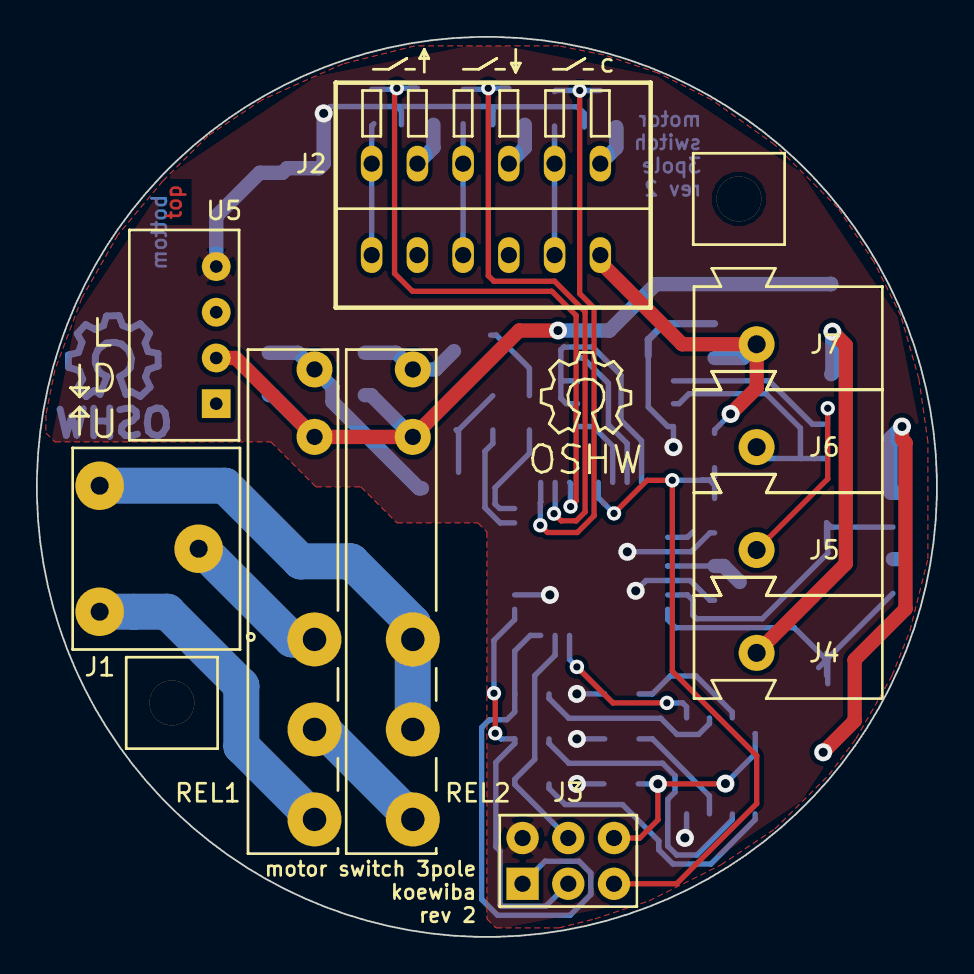
[picture p103: board motor_switch_3pole.kicad_pcb from above]

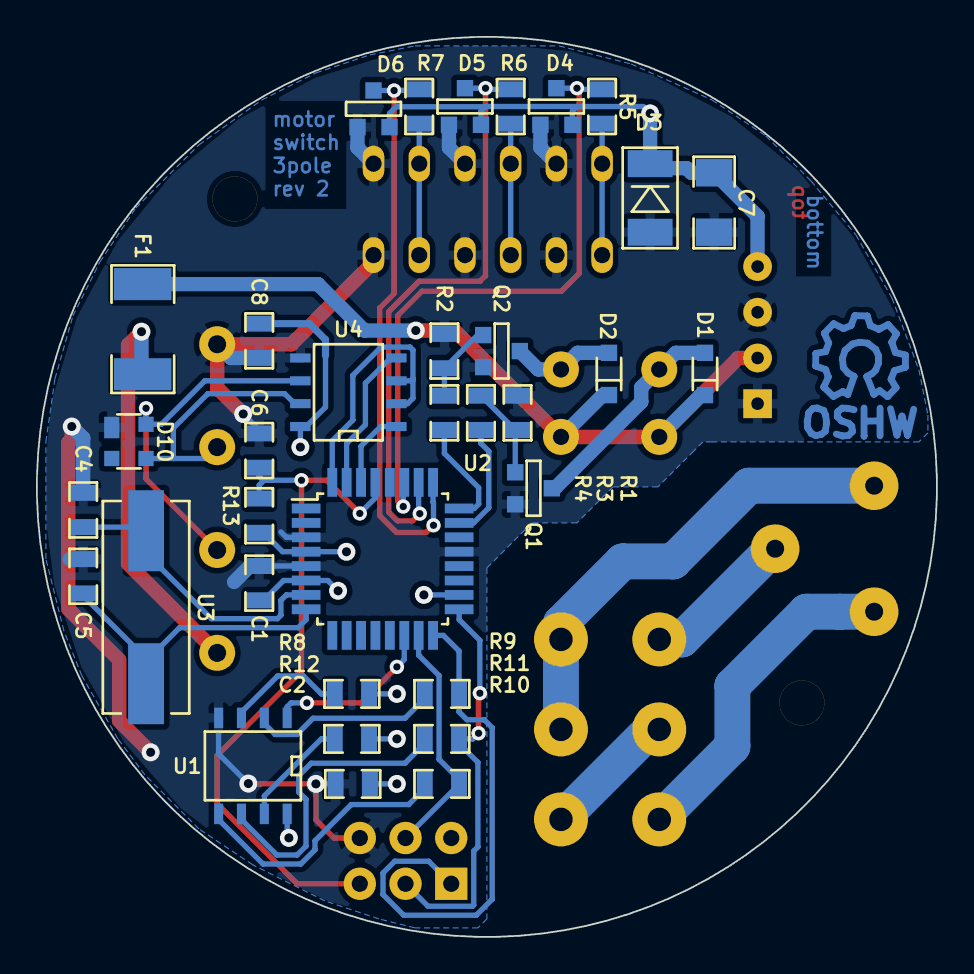
[picture p104: board motor_switch_3pole.kicad_pcb from below]

Board: 2 copper layers, 50.0 x 50.0 mm, 48 parts (35 on the bottom side), 37 nets.

Parts:
C1, C2, C8: 100nF; C_0805
C4, C5: 18pF; C_0805
C6: 4,7nF; C_0805
C7: 100µF / 6V; C_1206
D1, D2: 1N4148; D_SOD323
D3: ZD5V6; D_MINIMELF
D4, D5, D6: BAT54S; SOT23-3
D10: SEMTECH SR05; D_SOT143
F1: FUSE; R_1812
H1, H2: HOLE; HOLE_2.5mm_wo_Copper
J1: WAGO 2081-1123; WAGO_2081-1123
J2: WAGO 233-506; WAGO_233-6
J3: CONN-ISP-6; HEADER_3x2
J4: WAGO 243-723; WAGO_243
J5: WAGO 243-724; WAGO_243
J6: WAGO 243-721; WAGO_243
J7: WAGO 243-722; WAGO_243
LOGO1: OPEN_HARDWARE_1; Symbol_OSHW-Logo_Copper
LOGO2: Open Hardware; Symbol_OSHW-Logo_SilkScreen
Q1, Q2: BSS138; SOT23-3
R1, R2, R8, R12, R13: 10k; R_0805
R3, R4, R9, R10, R11: 100; R_0805
R5, R6, R7: 4k7; R_0805
REL1, REL2: FINDER_34.51.7.024; finder_34.51_1xUM
U1: 25LC256; SO8E
U2: ATMEGA328-TQFP32; TQFP-32_7x7mm_Pitch0.8mm
U3: 7,3728MHz; CRY_HC49_SMD
U4: MAX487ECSA; SO8E
U5: AM1S-2405; AM1S-XXXX_SIL4

Connections:
+5V: C1.1, C2.1, C7.1, C8.2, D3.2, D4.2, D5.2, D6.2, J3.2, R8.1, R12.1, R13.1, U1.8, U2.4, U2.6, U2.18, U4.8, U5.4
+24V: D1.2, D2.2, F1.1, REL1.2, REL2.2, U5.2
/230V_DOWN: J1.2, REL1.3
/230V_L: J1.3, REL2.3, REL2.4
/230V_ON: REL1.4, REL2.5
/230V_UP: J1.1, REL1.5
//button_down: D5.3, R6.1, U2.26
//button_up: D4.3, R5.1, U2.27
//switch_close: D6.3, R7.1, U2.25
/bus_atmega328_basic//CSEEP: U1.1, U2.14
/bus_atmega328_basic//RESET: C6.1, J3.5, R13.2, U2.29
/bus_atmega328_basic/A: D10.4, J5.1, U4.6
/bus_atmega328_basic/B: D10.3, J6.1, U4.7
/bus_atmega328_basic/MISO: R9.2, U1.2
/bus_atmega328_basic/MOSI: R10.2, U1.5
/bus_atmega328_basic/PB3_MOSI: J3.4, R10.1, U2.15
/bus_atmega328_basic/PB4_MISO: J3.1, R9.1, U2.16
/bus_atmega328_basic/PB5_SCK: J3.3, R11.1, U2.17
/bus_atmega328_basic/RXD0: U2.30, U4.1
/bus_atmega328_basic/SCK: R11.2, U1.6
/bus_atmega328_basic/TXD0: U2.31, U4.4
/bus_atmega328_basic/TXD0EN: U2.32, U4.2, U4.3
/relay_on: R4.2, U2.24
/relay_up: R3.2, U2.23
GND: C1.2, C2.2, C4.2, C5.2, C6.2, C7.2, C8.1, D3.1, D4.1, D5.1, D6.1, D10.1, J2.2, J2.4, J2.6, J3.6, J7.1, Q1.2, Q2.2, R1.2, R2.2, U1.4, U2.3, U2.5, U2.21, U4.5, U5.1, U5.3
unnamed: C4.1, U2.7, U3.1
unnamed: C5.1, U2.8, U3.2
unnamed: D1.1, Q1.3, REL1.1
unnamed: D2.1, Q2.3, REL2.1
unnamed: F1.2, J4.1
unnamed: J2.1, R5.2
unnamed: J2.3, R6.2
unnamed: J2.5, R7.2
unnamed: Q1.1, R1.1, R3.1
unnamed: Q2.1, R2.1, R4.1
unnamed: R8.2, U1.3
unnamed: R12.2, U1.7
