irqmask/koewiba-domotic/hw/pi2-base/pi2-base.kicad_pcb

## KiCad design hw/pi2-base/pi2-base.kicad_pcb (2023-11-28)

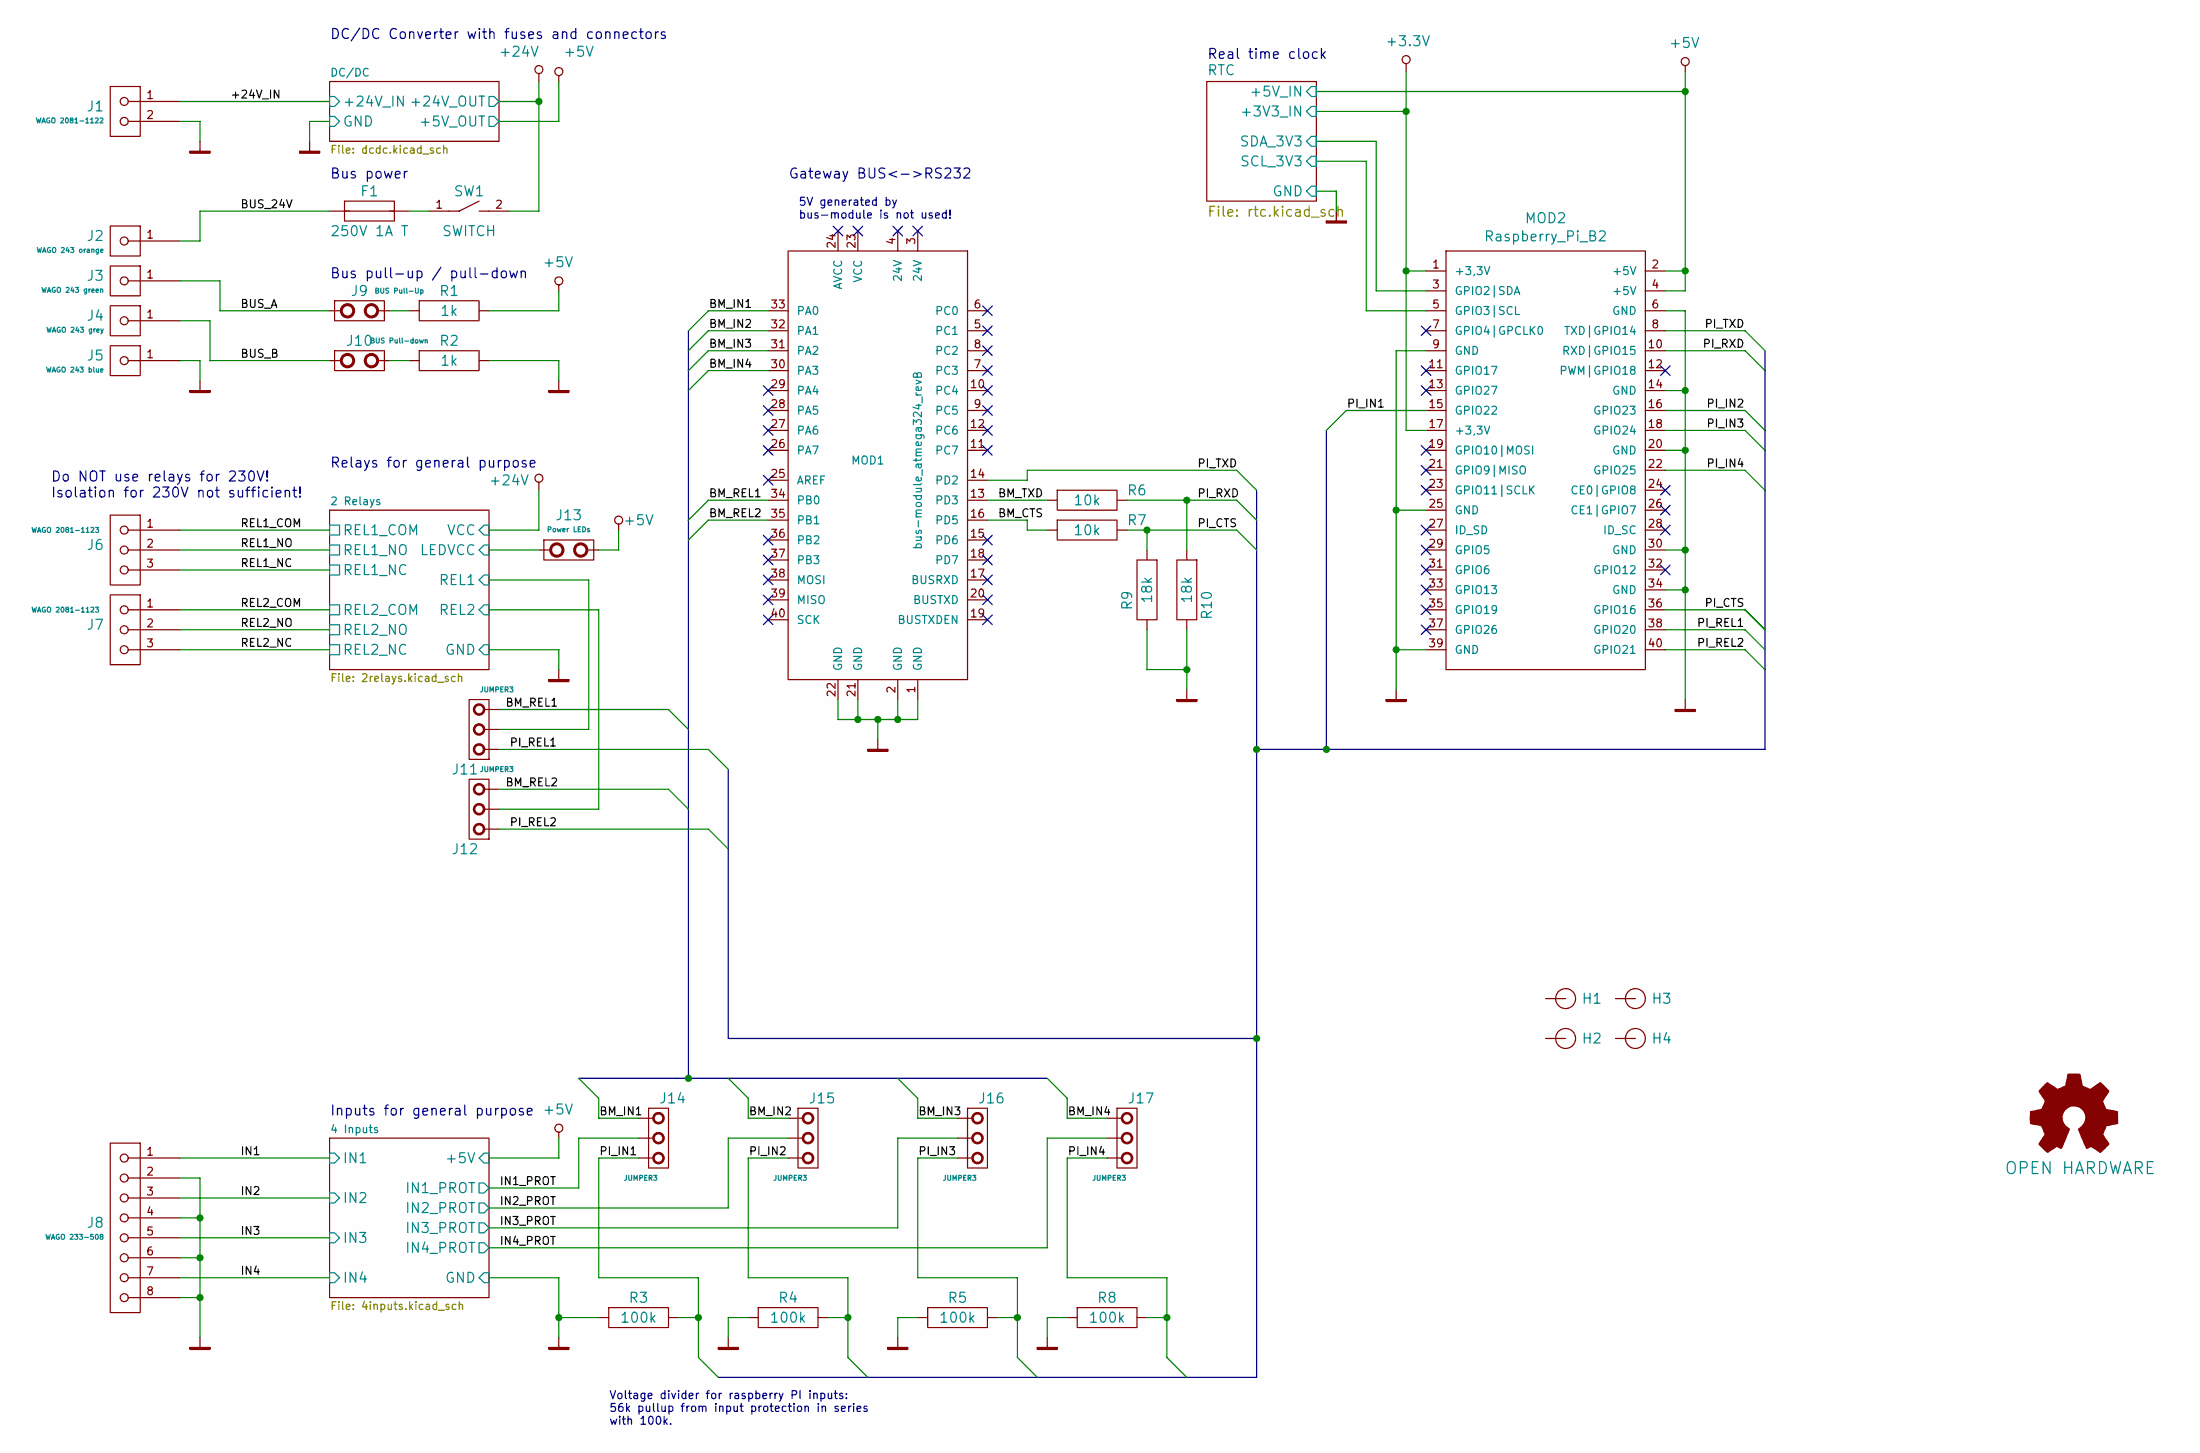
[picture p105: schematic pi2-base.kicad_sch]

Parts:
F1: 250V 1A T; FUSE5-20
H1, H2, H3, H4: HOLE; HOLE_3.5mm
J1: WAGO 2081-1122; WAGO_2081-1122
J2: WAGO 243 orange; WAGO_243
J3: WAGO 243 green; WAGO_243
J4: WAGO 243 grey; WAGO_243
J5: WAGO 243 blue; WAGO_243
J6, J7: WAGO 2081-1123; WAGO_2081-1123
J8: WAGO 233-508; WAGO_233-8
J9: BUS Pull-Up; HEADER_2x1
J10: BUS Pull-down; HEADER_2x1
J11, J12, J14, J15, J16, J17: JUMPER3; HEADER_3x1
J13: Power LEDs; HEADER_2x1
LOGO1: OPEN HARDWARE; Symbol_OSHW-Logo_Copper
MOD1: bus-module_atmega324_revB
MOD2: Raspberry_Pi_B2; raspberry_pi2
R1, R2: 1k; R_0805
R3, R4, R5, R8: 100k; R_0805
R6, R7: 10k; R_0805
R9, R10: 18k; R_0805
SW1: SWITCH; PCB_CON2

Connections:
+3.3V: MOD2.1 (+3,3V), MOD2.17 (+3,3V); also elsewhere on the board
+5V: J13.2, MOD2.2 (+5V), MOD2.4 (+5V), R1.2; also elsewhere on the board
+24V: SW1.2; also elsewhere on the board
/2 Relays/LEDVCC: J13.1; also elsewhere on the board
/2 Relays/REL1: J11.2; also elsewhere on the board
/2 Relays/REL2: J12.2; also elsewhere on the board
/+24V_IN: J1.1; also elsewhere on the board
/BM_CTS: MOD1.16 (PD5), R7.1
/BM_IN1: J14.1, MOD1.33 (PA0)
/BM_IN2: J15.1, MOD1.32 (PA1)
/BM_IN3: J16.1, MOD1.31 (PA2)
/BM_IN4: J17.1, MOD1.30 (PA3)
/BM_REL1: J11.3, MOD1.34 (PB0)
/BM_REL2: J12.3, MOD1.35 (PB1)
/BM_TXD: MOD1.13 (PD3), R6.1
/BUS_24V: F1.1, J2.1
/BUS_A: J3.1, J9.1
/BUS_B: J4.1, J10.1
/IN1: J8.1; also elsewhere on the board
/IN1_PROT: J14.2; also elsewhere on the board
/IN2: J8.3; also elsewhere on the board
/IN2_PROT: J15.2; also elsewhere on the board
/IN3: J8.5; also elsewhere on the board
/IN3_PROT: J16.2; also elsewhere on the board
/IN4: J8.7; also elsewhere on the board
/IN4_PROT: J17.2; also elsewhere on the board
/PI_CTS: MOD2.36 (GPIO16), R7.2, R9.1
/PI_IN1: J14.3, MOD2.15 (GPIO22), R3.2
/PI_IN2: J15.3, MOD2.16 (GPIO23), R4.2
/PI_IN3: J16.3, MOD2.18 (GPIO24), R5.2
/PI_IN4: J17.3, MOD2.22 (GPIO25), R8.2
/PI_REL1: J11.1, MOD2.38 (GPIO20)
/PI_REL2: J12.1, MOD2.40 (GPIO21)
/PI_RXD: MOD2.10 (RXD|GPIO15), R6.2, R10.1
/PI_TXD: MOD1.14 (PD2), MOD2.8 (TXD|GPIO14)
/REL1_COM: J6.1; also elsewhere on the board
/REL1_NC: J6.3; also elsewhere on the board
/REL1_NO: J6.2; also elsewhere on the board
/REL2_COM: J7.1; also elsewhere on the board
/REL2_NC: J7.3; also elsewhere on the board
/REL2_NO: J7.2; also elsewhere on the board
/RTC/SCL_3V3: MOD2.5 (GPIO3|SCL); also elsewhere on the board
/RTC/SDA_3V3: MOD2.3 (GPIO2|SDA); also elsewhere on the board
GND: J1.2, J5.1, J8.2, J8.4, J8.6, J8.8, MOD1.1 (GND), MOD1.2 (GND), MOD1.21 (GND), MOD1.22 (GND), MOD2.6 (GND), MOD2.9 (GND), MOD2.14 (GND), MOD2.20 (GND), MOD2.25 (GND), MOD2.30 (GND), MOD2.34 (GND), MOD2.39 (GND), R2.2, R3.1, R4.1, R5.1, R8.1, R9.2, R10.2; also elsewhere on the board
unnamed: F1.2, SW1.1
unnamed: J9.2, R1.1
unnamed: J10.2, R2.1

Notes on the sheet:
Bus pull-up / pull-down
Bus power
Do NOT use relays for 230V! Isolation for 230V not sufficient!
Voltage divider for raspberry PI inputs: 56k pullup from input protection in series with 100k.
Gateway BUS<->RS232
5V generated by bus-module is not used!
Real time clock
Relays for general purpose
DC/DC Converter with fuses and connectors
Inputs for general purpose

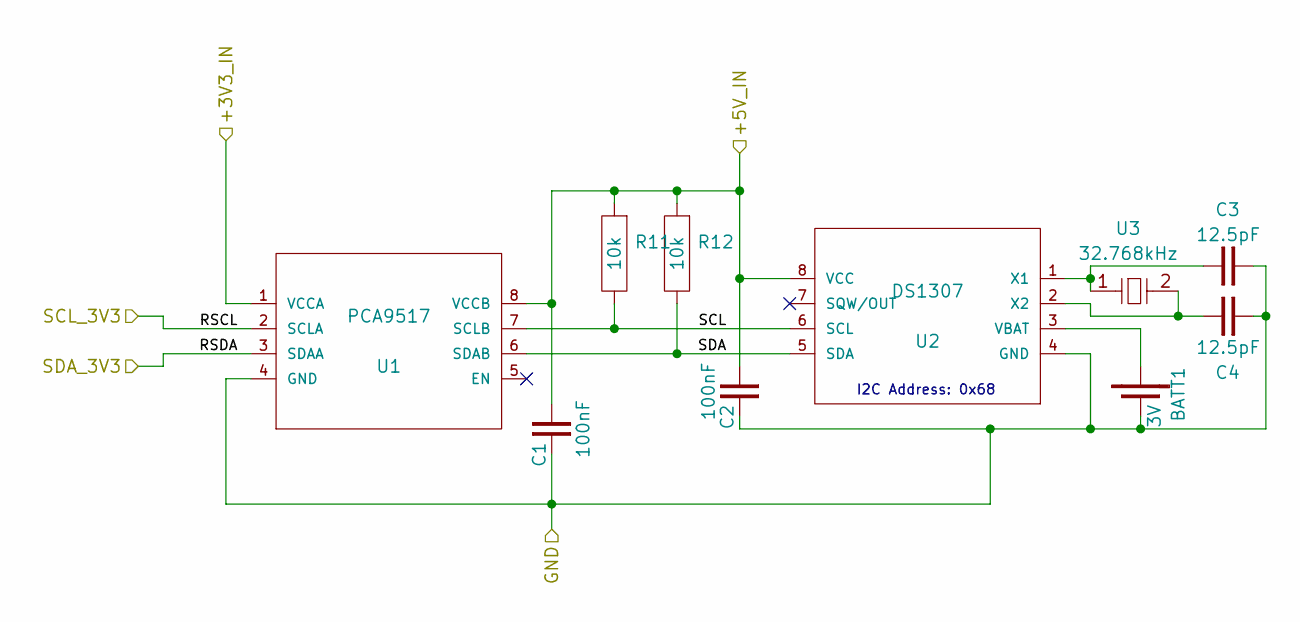
[picture p106: schematic rtc.kicad_sch]

Parts:
BATT1: 3V; CR2032H
C1, C2: 100nF; C_0805
C3, C4: 12.5pF; C_0805
R11, R12: 10k; R_0805
U1: PCA9517; SO8E
U2: DS1307; SO8E
U3: 32.768kHz; CRY_MS1V-7_SMD

Connections:
+3.3V: U1.1 (VCCA); also elsewhere on the board
+5V: C1.1, C2.1, R11.1, R12.1, U1.8 (VCCB), U2.8 (VCC); also elsewhere on the board
/RTC/SCL: R11.2, U1.7 (SCLB), U2.6 (SCL)
/RTC/SCL_3V3: U1.2 (SCLA); also elsewhere on the board
/RTC/SDA: R12.2, U1.6 (SDAB), U2.5 (SDA)
/RTC/SDA_3V3: U1.3 (SDAA); also elsewhere on the board
GND: BATT1.2 (-), C1.2, C2.2, C3.1, C4.1, U1.4 (GND), U2.4 (GND); also elsewhere on the board
unnamed: BATT1.1 (+), U2.3 (VBAT)
unnamed: C3.2, U2.1 (X1), U3.1
unnamed: C4.2, U2.2 (X2), U3.2

Notes on the sheet:
I2C Address: 0x68

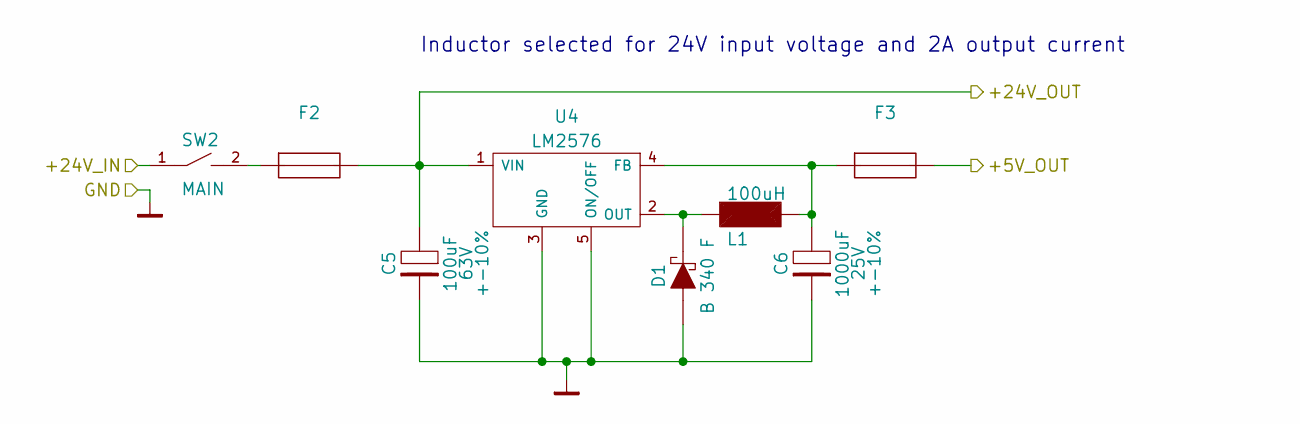
[picture p107: schematic dcdc.kicad_sch, DC/DC Converter]

Parts:
C5: 100uF; CP_RM5.08mm_D10.5mm; Voltage 63V
C6: 1000uF; CP_RM5.08mm_D13.5mm; Voltage 25V
D1: B 340 F; D_SMC
F2, F3: (no value)
L1: 100uH; L_PISR
SW2: MAIN; PCB_CON2
U4: LM2576; TO263_5

Connections:
+5V: F3.2; also elsewhere on the board
+24V: C5.1, F2.2, U4.1 (VIN); also elsewhere on the board
/+24V_IN: SW2.1; also elsewhere on the board
GND: C5.2, C6.2, D1.1 (A), U4.3 (GND), U4.5 (ON/OFF); also elsewhere on the board
unnamed: C6.1, F3.1, L1.2, U4.4 (FB)
unnamed: D1.2 (C), L1.1, U4.2 (OUT)
unnamed: F2.1, SW2.2

Notes on the sheet:
Inductor selected for 24V input voltage and 2A output current
