irqmask/koewiba-domotic/hw/pi2-base/pi2-base.kicad_pcb

## KiCad design hw/pi2-base/pi2-base.kicad_pcb (continued)

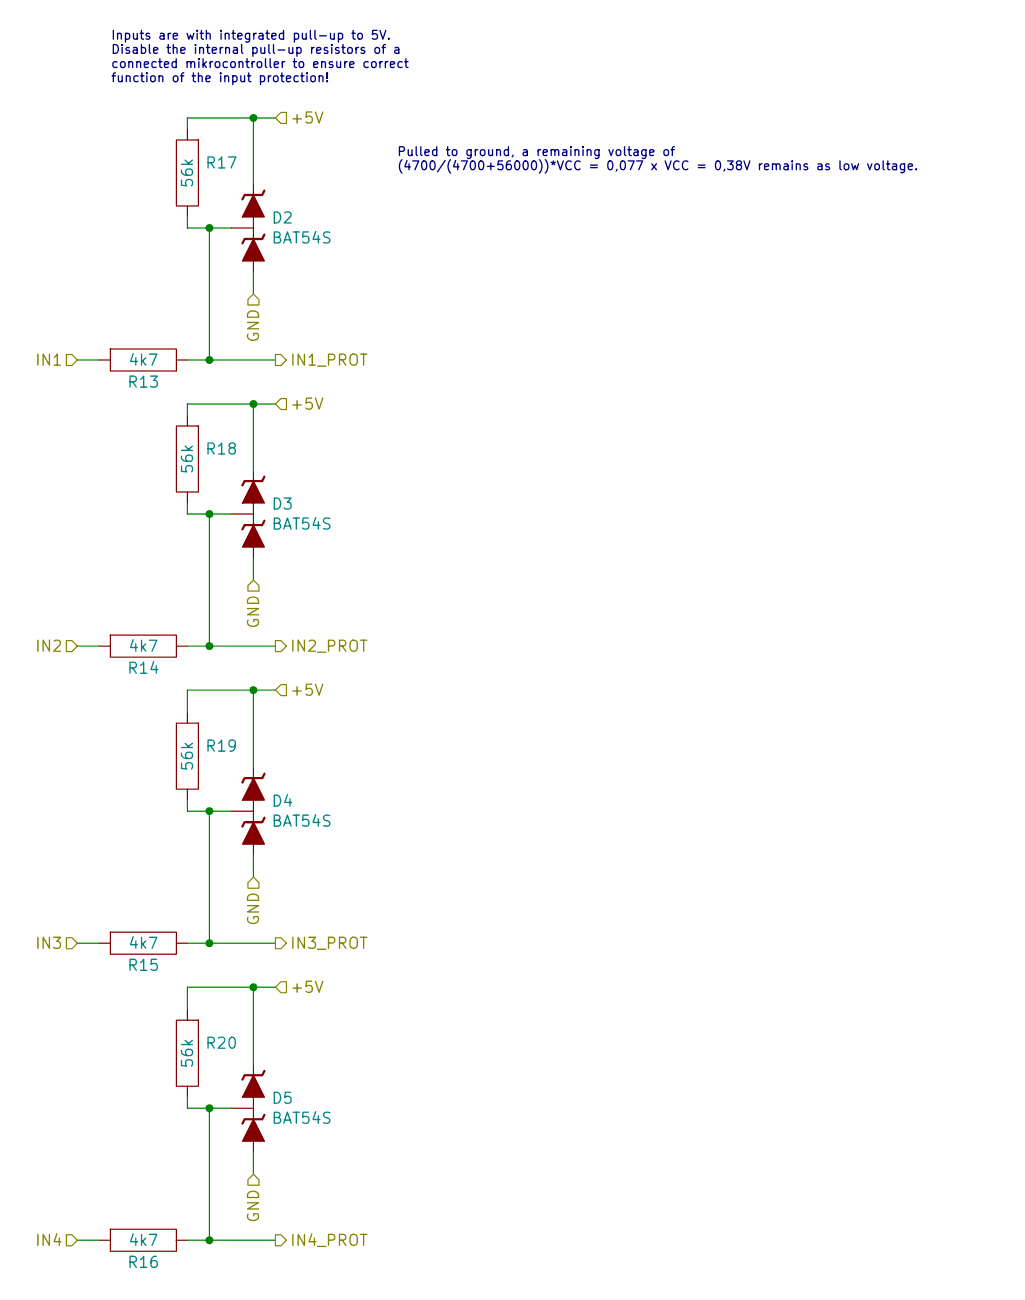
[picture p108: schematic 4inputs.kicad_sch, 4 Inputs]

Parts:
D2, D3, D4, D5: BAT54S; SOT23-3
R13, R14, R15, R16: 4k7; R_0805
R17, R18, R19, R20: 56k; R_0805

Connections:
+5V: D2.2, D3.2, D4.2, D5.2, R17.1, R18.1, R19.1, R20.1; also elsewhere on the board
/IN1: R13.1; also elsewhere on the board
/IN1_PROT: D2.3, R13.2, R17.2; also elsewhere on the board
/IN2: R14.1; also elsewhere on the board
/IN2_PROT: D3.3, R14.2, R18.2; also elsewhere on the board
/IN3: R15.1; also elsewhere on the board
/IN3_PROT: D4.3, R15.2, R19.2; also elsewhere on the board
/IN4: R16.1; also elsewhere on the board
/IN4_PROT: D5.3, R16.2, R20.2; also elsewhere on the board
GND: D2.1, D3.1, D4.1, D5.1; also elsewhere on the board

Notes on the sheet:
Inputs are with integrated pull-up to 5V. Disable the internal pull-up resistors of a connected mikrocontroller to ensure correct function of the input protection!
Pulled to ground, a remaining voltage of (4700/(4700+56000))*VCC = 0,077 x VCC = 0,38V remains as low voltage.

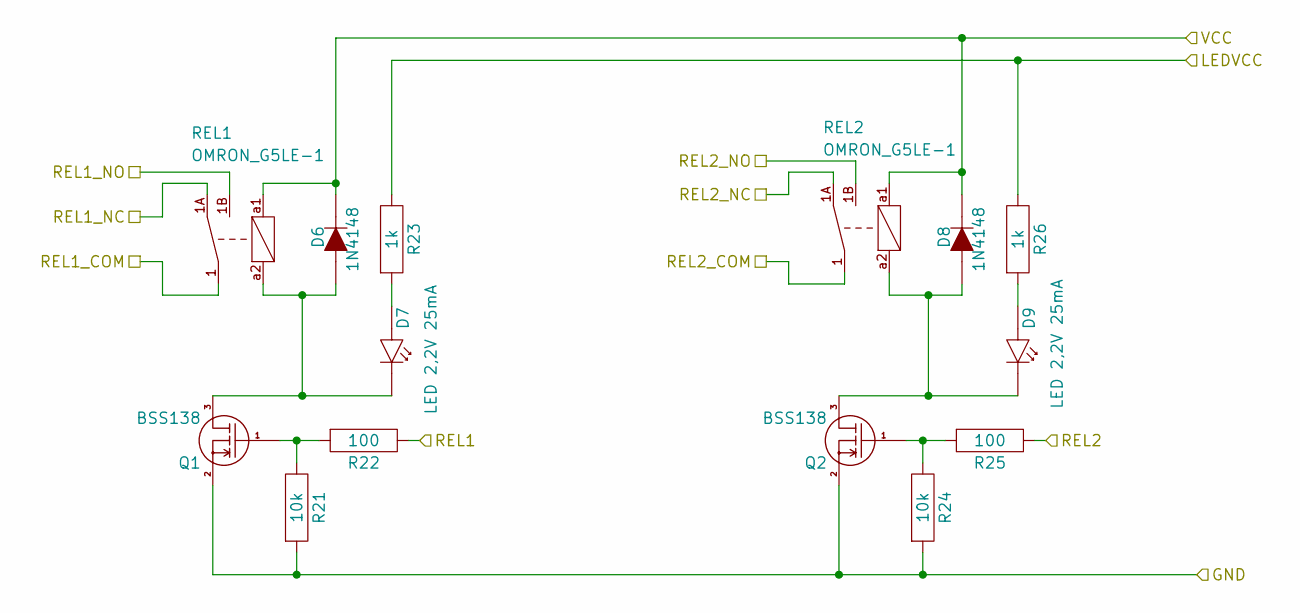
[picture p109: schematic 2relays.kicad_sch, 2 Relays]

Parts:
D6, D8: 1N4148; D_MINIMELF
D7, D9: LED 2,2V 25mA; LED_RM2.54mm_D3mm
Q1, Q2: BSS138; SOT23-3
R21, R24: 10k; R_0805
R22, R25: 100; R_0805
R23, R26: 1k; R_0805
REL1, REL2: OMRON_G5LE-1

Connections:
+24V: D6.2 (C), D8.2 (C), REL1.a1 (+), REL2.a1 (+); also elsewhere on the board
/2 Relays/LEDVCC: R23.2, R26.2; also elsewhere on the board
/2 Relays/REL1: R22.2; also elsewhere on the board
/2 Relays/REL2: R25.2; also elsewhere on the board
/REL1_COM: REL1.1; also elsewhere on the board
/REL1_NC: REL1.1A; also elsewhere on the board
/REL1_NO: REL1.1B; also elsewhere on the board
/REL2_COM: REL2.1; also elsewhere on the board
/REL2_NC: REL2.1A; also elsewhere on the board
/REL2_NO: REL2.1B; also elsewhere on the board
GND: Q1.2 (S), Q2.2 (S), R21.1, R24.1; also elsewhere on the board
unnamed: D6.1 (A), D7.2 (C), Q1.3 (D), REL1.a2 (-)
unnamed: D7.1 (A), R23.1
unnamed: D8.1 (A), D9.2 (C), Q2.3 (D), REL2.a2 (-)
unnamed: D9.1 (A), R26.1
unnamed: Q1.1 (G), R21.2, R22.1
unnamed: Q2.1 (G), R24.2, R25.1

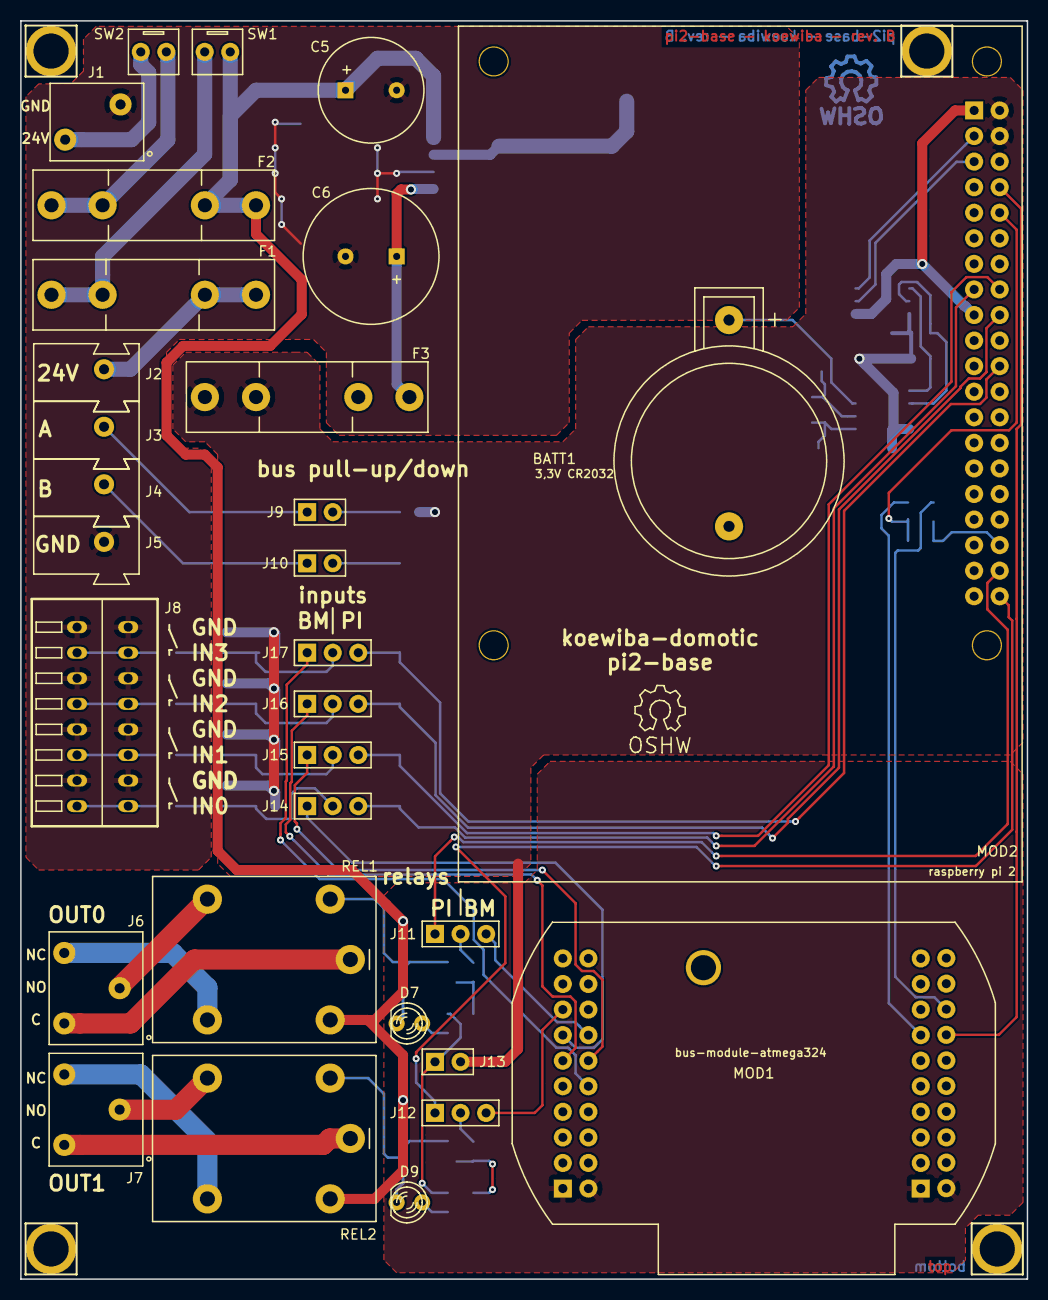
[picture p110: board pi2-base.kicad_pcb from above]

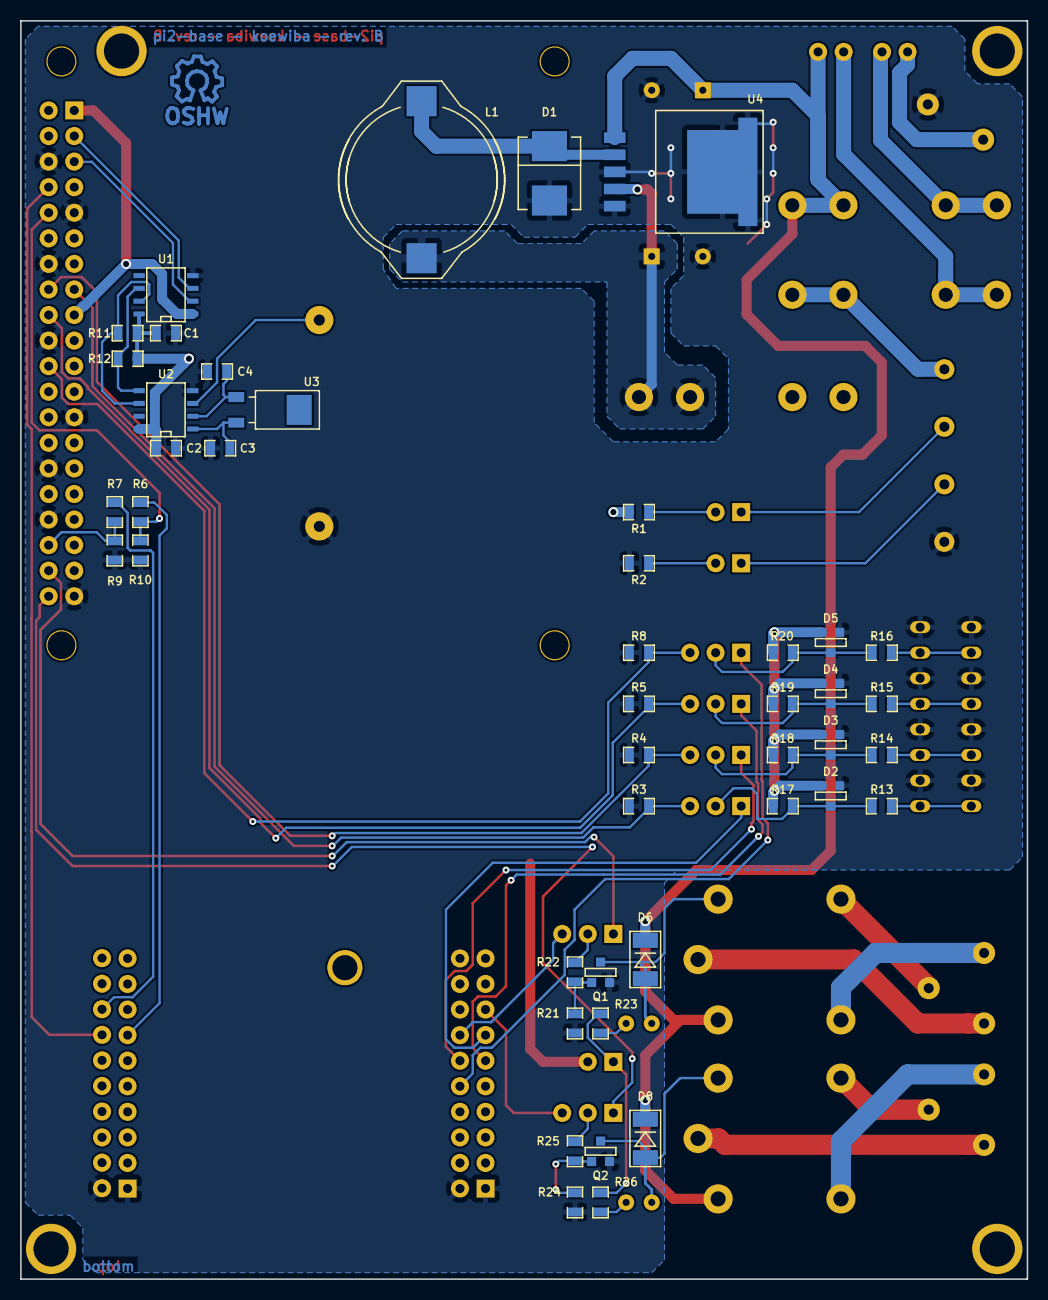
[picture p111: board pi2-base.kicad_pcb from below]

Board: 2 copper layers, 100.0 x 125.0 mm, 81 parts (45 on the bottom side), 61 nets.

Other parts of the board:
Symbol_OSHW-Logo_SilkScreen: Open Source Hardware; Symbol_OSHW-Logo_SilkScreen
