irqmask/koewiba-domotic/hw/motor_switch_3pole_5x/motor_switch_3pole_5x.kicad_pcb

## KiCad design hw/motor_switch_3pole_5x/motor_switch_3pole_5x.kicad_pcb (2023-11-28)

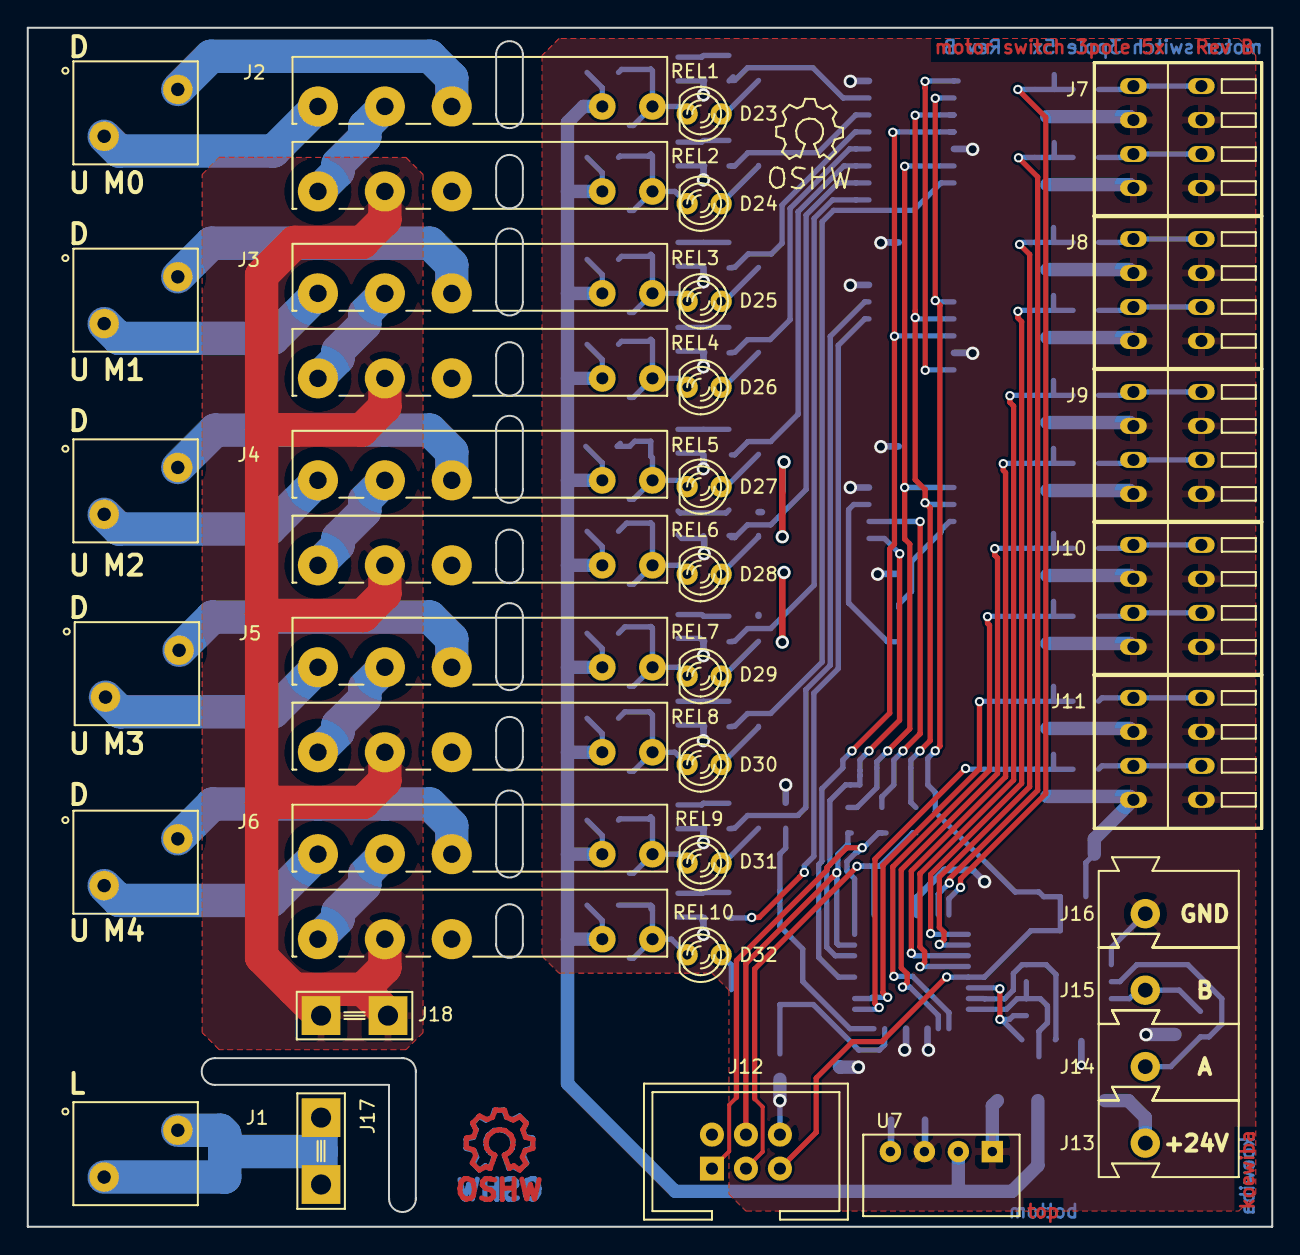
[picture p112: board motor_switch_3pole_5x.kicad_pcb from above]

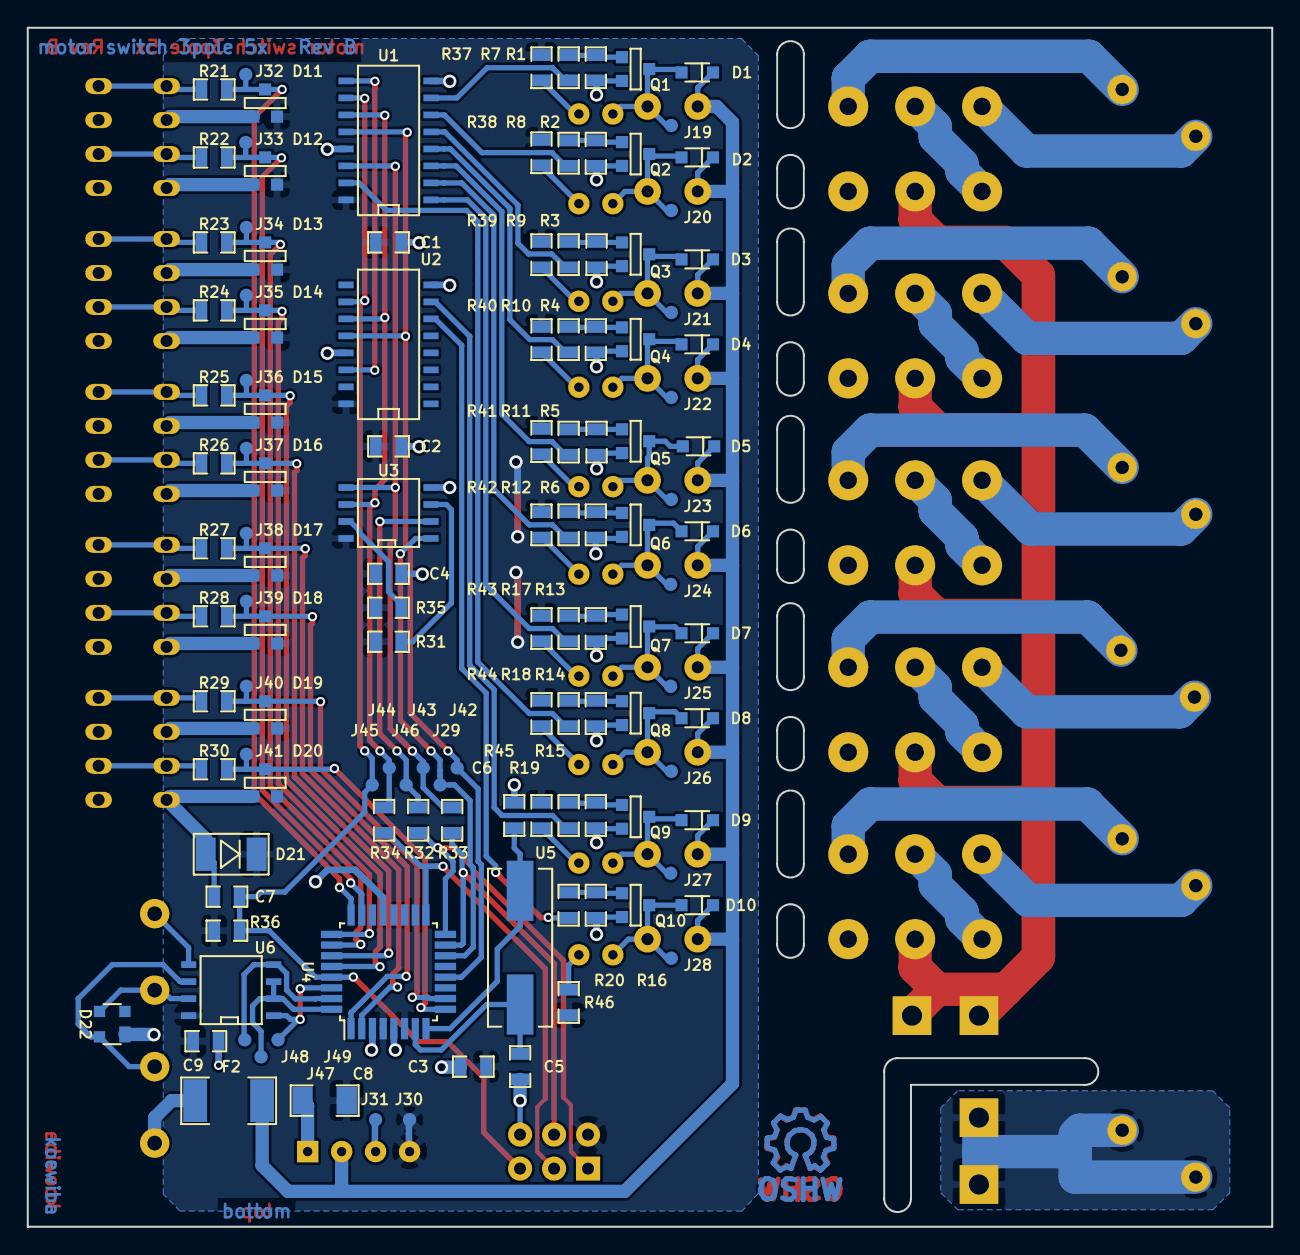
[picture p113: board motor_switch_3pole_5x.kicad_pcb from below]

Board: 2 copper layers, 93.0 x 89.6 mm, 167 parts (126 on the bottom side), 100 nets.

Parts:
C1, C2, C3, C4, C9: 100nF; C_0805
C5, C6: 18pF; C_0805
C7: 4,7nF; C_0805
C8: 100µF / 6V; C_1206
D1, D2, D3, D4, D5, D6, D7, D8, D9, D10: 1N4148; D_SOD323
D11, D12, D13, D14, D15, D16, D17, D18, D19, D20: BAT54S; SOT23-3
D21: ZD; D_MINIMELF
D22: SEMTECH SR05; D_SOT143
D23, D25, D27, D29, D31: yellow, 2,1V/2mA; LED_RM2.54mm_D3mm
D24, D26, D28, D30, D32: green, 2,2V/2mA; LED_RM2.54mm_D3mm
F2: FUSE; R_1812
J1: CONN_2X1; WAGO2081-1122
J2, J3, J4, J5, J6: WAGO 2081-1122; WAGO2081-1122
J7, J8, J9, J10, J11: WAGO 233-504; WAGO233-4
J12: CONN-ISP-6; HEADER_6
J13: WAGO 243-723; WAGO243
J14: WAGO 243-724; WAGO243
J15: WAGO 243-721; WAGO243
J16: WAGO 243-722; WAGO243
J17, J18: CONN_1; CONN1_6.35
J19: tp_output_motor_0_up; Testpoint_1mm
J20: tp_output_motor_on; Testpoint_1mm
J21: tp_output_motor_1_up; Testpoint_1mm
J22: tp_output_motor_1_on; Testpoint_1mm
J23: tp_output_motor_2_up; Testpoint_1mm
J24: tp_output_motor_2_on; Testpoint_1mm
J25: tp_output_motor_3_up; Testpoint_1mm
J26: tp_output_motor_3_on; Testpoint_1mm
J27: tp_output_motor_4_up; Testpoint_1mm
J28: tp_output_motor_4_on; Testpoint_1mm
J29: tp_cseep; Testpoint_1mm
J30: tp_vcc; Testpoint_1mm
J31: tp_gnd; Testpoint_1mm
J32: tp_output_button_0_up; Testpoint_1mm
J33: tp_output_button_0_down; Testpoint_1mm
J34: tp_output_button_1_up; Testpoint_1mm
J35: tp_output_button_1_down; Testpoint_1mm
J36: tp_output_button_2_up; Testpoint_1mm
J37: tp_output_button_2_down; Testpoint_1mm
J38: tp_output_button_3_up; Testpoint_1mm
J39: tp_output_button_3_down; Testpoint_1mm
J40: tp_output_button_4_up; Testpoint_1mm
J41: tp_output_button_4_down; Testpoint_1mm
J42: tp_output_latch; Testpoint_1mm
J43: tp_output_data; Testpoint_1mm
J44: tp_output_clock; Testpoint_1mm
J45: tp_output_reset; Testpoint_1mm
J46: tp_miso; Testpoint_1mm
J47: tp_txden; Testpoint_1mm
J48: tp_txd; Testpoint_1mm
J49: tp_rxd; Testpoint_1mm
LOGO1, LOGO2: OPEN_HARDWARE_1; Symbol_OSHW-Logo_Copper
LOGO4: Open Hardware; Symbol_OSHW-Logo_SilkScreen
Q1, Q2, Q3, Q4, Q5, Q6, Q7, Q8, Q9, Q10: BSS138; SOT23-3
R1, R2, R3, R4, R5, R6, R13, R14, R15, R16, R31, R35, R36: 10k; R_0805
R7, R8, R9, R10, R11, R12, R17, R18, R19, R20, R32, R33, R34: 100; R_0805
R21, R22, R23, R24, R25, R26, R27, R28, R29, R30: 4k7; R_0805
R37, R38, R39, R40, R41, R42, R43, R44, R45, R46: 1k5; R_0805
REL1, REL2, REL3, REL4, REL5, REL6, REL7, REL8, REL9, REL10: FINDER_34.51.7.024; finder_34.51_1xUM
U1, U2: 74HC595; SO16N
U3: 25LC256; SO8N
U4: ATMEGA328-TQFP32; TQFP-32_7x7mm_Pitch0.8mm
U5: 7,3728MHz; CRY_HC49_SMD
U6: MAX487ECSA; SO8N
U7: AM1S-2405; AM1S-XXXX_SIL4

Connections:
+5V: C1.1, C2.1, C3.1, C4.1, C8.1, C9.2, D11.2, D12.2, D13.2, D14.2, D15.2, D16.2, D17.2, D18.2, D19.2, D20.2, D21.2, J12.2, J30.1, R31.1, R35.1, R36.1, R37.2, R38.2, R39.2, R40.2, R41.2, R42.2, R43.2, R44.2, R45.2, R46.2, U1.16, U2.16, U3.8, U4.4, U4.6, U4.18, U6.8, U7.4
+24V: D1.2, D2.2, D3.2, D4.2, D5.2, D6.2, D7.2, D8.2, D9.2, D10.2, F2.1, REL1.2, REL2.2, REL3.2, REL4.2, REL5.2, REL6.2, REL7.2, REL8.2, REL9.2, REL10.2, U7.2
//button_0_down: D12.3, J33.1, R22.1, U4.23
//button_0_up: D11.3, J32.1, R21.1, U4.24
//button_1_down: D14.3, J35.1, R24.1, U4.25
//button_1_up: D13.3, J34.1, R23.1, U4.26
//button_2_down: D16.3, J37.1, R26.1, U4.27
//button_2_up: D15.3, J36.1, R25.1, U4.28
//button_3_down: D18.3, J39.1, R28.1, U4.1
//button_3_up: D17.3, J38.1, R27.1, U4.2
//button_4_down: D20.3, J41.1, R30.1, U4.9
//button_4_up: D19.3, J40.1, R29.1, U4.10
/Motor Relays/230V: J18.1, REL2.4, REL4.4, REL6.4, REL8.4, REL10.4
/Motor Relays/M0_230V_ON: REL1.4, REL2.5
/Motor Relays/M1_230V_ON: REL3.4, REL4.5
/Motor Relays/M2_230V_ON: REL5.4, REL6.5
/Motor Relays/M3_230V_ON: REL7.4, REL8.5
/Motor Relays/M4_230V_ON: REL9.4, REL10.5
/Motor Relays/MOTOR_0_230V_DOWN: J2.1, REL1.3
/Motor Relays/MOTOR_0_230V_UP: J2.2, REL1.5
/Motor Relays/MOTOR_1_230V_DOWN: J3.1, REL3.3
/Motor Relays/MOTOR_1_230V_UP: J3.2, REL3.5
/Motor Relays/MOTOR_2_230V_DOWN: J4.1, REL5.3
/Motor Relays/MOTOR_2_230V_UP: J4.2, REL5.5
/Motor Relays/MOTOR_3_230V_DOWN: J5.1, REL7.3
/Motor Relays/MOTOR_3_230V_UP: J5.2, REL7.5
/Motor Relays/MOTOR_4_230V_DOWN: J6.1, REL9.3
/Motor Relays/MOTOR_4_230V_UP: J6.2, REL9.5
/bus_atmega328_basic//CSEEP: J29.1, U3.1, U4.14
/bus_atmega328_basic/A: D22.4, J14.1, U6.6
/bus_atmega328_basic/B: D22.3, J15.1, U6.7
/bus_atmega328_basic/MISO: J46.1, R32.2, U3.2
/bus_atmega328_basic/PB3_MOSI: J12.4, R33.1, U4.15
/bus_atmega328_basic/PB4_MISO: J12.1, R32.1, U4.16
/bus_atmega328_basic/PB5_SCK: J12.3, R34.1, U4.17
/bus_atmega328_basic/RXD0: J49.1, U4.30, U6.1
/bus_atmega328_basic/TXD0: J48.1, U4.31, U6.4
/bus_atmega328_basic/TXD0EN: J47.1, U4.32, U6.2, U6.3
/motor_0_on: R8.2, U1.6
/motor_0_up: R7.2, U1.7
/motor_1_on: R10.2, U1.4
/motor_1_up: R9.2, U1.5
/motor_2_on: R12.2, U1.2
/motor_2_up: R11.2, U1.3
/motor_3_on: R18.2, U1.15
/motor_3_up: R17.2, U1.1
/motor_4_on: R20.2, U2.6
/motor_4_up: R19.2, U2.7
/output_clock: J44.1, R34.2, U1.11, U2.11, U3.6
/output_data: J43.1, R33.2, U1.14, U3.5
/output_latch: J42.1, U1.12, U2.12, U4.12
/output_reset: C7.1, J12.5, J45.1, R36.2, U1.10, U2.10, U4.29
GND: C1.2, C2.2, C3.2, C4.2, C5.2, C6.2, C7.2, C8.2, C9.1, D11.1, D12.1, D13.1, D14.1, D15.1, D16.1, D17.1, D18.1, D19.1, D20.1, D21.1, D22.1, J7.2, J7.4, J8.2, J8.4, J9.2, J9.4, J10.2, J10.4, J11.2, J11.4, J12.6, J16.1, J31.1, Q1.2, Q2.2, Q3.2, Q4.2, Q5.2, Q6.2, Q7.2, Q8.2, Q9.2, Q10.2, R1.2, R2.2, R3.2, R4.2, R5.2, R6.2, R13.2, R14.2, R15.2, R16.2, U1.8, U1.13, U2.8, U2.13, U3.4, U4.3, U4.5, U4.21, U6.5, U7.1, U7.3
unnamed: C5.1, U4.7, U5.1
unnamed: C6.1, U4.8, U5.2
unnamed: D1.1, D23.2, J19.1, Q1.3, REL1.1
unnamed: D2.1, D24.2, J20.1, Q2.3, REL2.1
unnamed: D10.1, D32.2, J28.1, Q10.3, REL10.1
unnamed: D23.1, R37.1
unnamed: D24.1, R38.1
unnamed: D25.1, R39.1
unnamed: D3.1, D25.2, J21.1, Q3.3, REL3.1
unnamed: D26.1, R40.1
unnamed: D4.1, D26.2, J22.1, Q4.3, REL4.1
unnamed: D27.1, R41.1
unnamed: D5.1, D27.2, J23.1, Q5.3, REL5.1
unnamed: D28.1, R42.1
unnamed: D6.1, D28.2, J24.1, Q6.3, REL6.1
unnamed: D29.1, R43.1
unnamed: D7.1, D29.2, J25.1, Q7.3, REL7.1
unnamed: D30.1, R44.1
unnamed: D8.1, D30.2, J26.1, Q8.3, REL8.1
unnamed: D31.1, R45.1
unnamed: D9.1, D31.2, J27.1, Q9.3, REL9.1
unnamed: D32.1, R46.1
unnamed: F2.2, J13.1
unnamed: J1.1, J1.2, J17.1
unnamed: J7.1, R21.2
unnamed: J7.3, R22.2
unnamed: J8.1, R23.2
unnamed: J8.3, R24.2
unnamed: J9.1, R25.2
unnamed: J9.3, R26.2
unnamed: J10.1, R27.2
unnamed: J10.3, R28.2
unnamed: J11.1, R29.2
unnamed: J11.3, R30.2
unnamed: Q1.1, R1.1, R7.1
unnamed: Q2.1, R2.1, R8.1
unnamed: Q3.1, R3.1, R9.1
unnamed: Q4.1, R4.1, R10.1
unnamed: Q5.1, R5.1, R11.1
unnamed: Q6.1, R6.1, R12.1
unnamed: Q7.1, R13.1, R17.1
unnamed: Q8.1, R14.1, R18.1
unnamed: Q9.1, R15.1, R19.1
unnamed: Q10.1, R16.1, R20.1
unnamed: R31.2, U3.3
unnamed: R35.2, U3.7
unnamed: U1.9, U2.14
