irqmask/koewiba-domotic/hw/busphy_breadboard/busphy_breadboard.kicad_pcb

## KiCad design hw/busphy_breadboard/busphy_breadboard.kicad_pcb (2023-11-28)

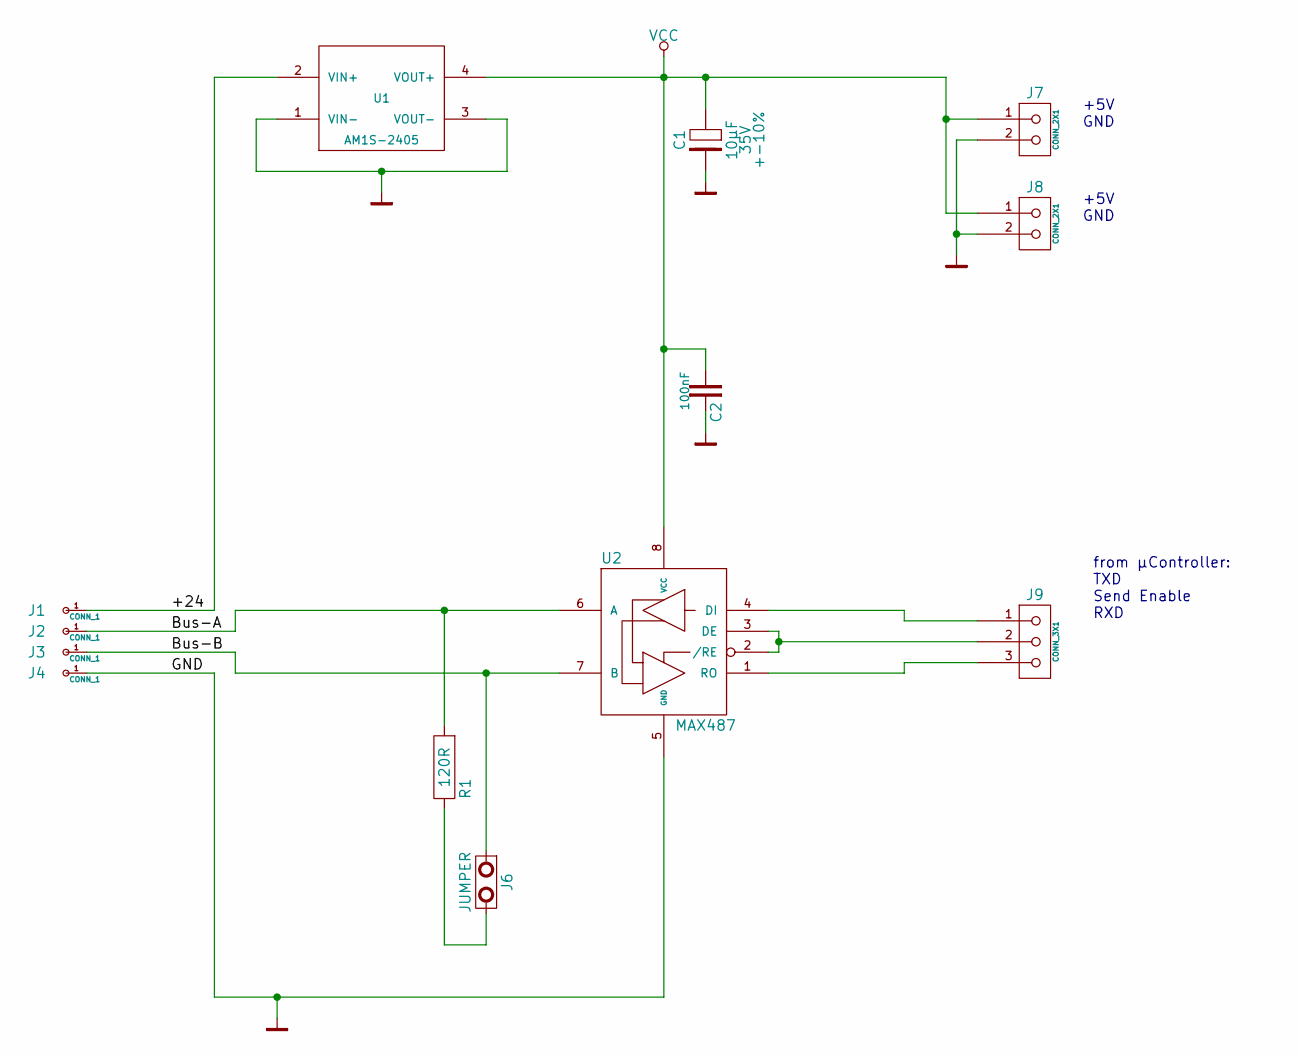
[picture p114: schematic busphy_breadboard.kicad_sch, Breadboard Bus Interface]

Parts:
C1: 10µF; Voltage 35V
C2: 100nF
J1, J2, J3, J4: CONN_1
J6: JUMPER
J7, J8: CONN_2X1
J9: CONN_3X1
R1: 120R
U1: AM1S-2405; AM1S-XXXX_SIL4
U2: MAX487; SSOP28

Connections:
/+24: J1.1, U1.2 (VIN+)
/Bus-A: J2.1, R1.1, U2.6 (A)
/Bus-B: J3.1, J6.1, U2.7 (B)
GND: C1.2, C2.2, J4.1, J7.2, J8.2, U1.1 (VIN-), U1.3 (VOUT-), U2.5 (GND)
unnamed: J9.2, U2.2 (/RE), U2.3 (DE)
unnamed: J9.3, U2.1 (RO)
unnamed: J9.1, U2.4 (DI)
unnamed: J6.2, R1.2
VCC: C1.1, C2.1, J7.1, J8.1, U1.4 (VOUT+), U2.8 (VCC)

Notes on the sheet:
from µController: TXD Send Enable RXD
+5V GND

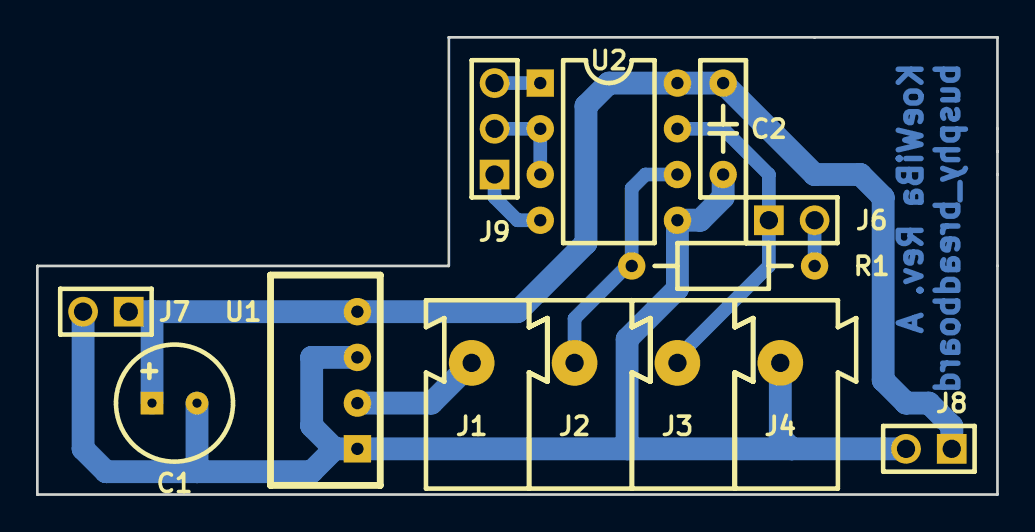
[picture p115: board busphy_breadboard.kicad_pcb from above]

Board: 2 copper layers, 53.3 x 25.4 mm, 13 parts (0 on the bottom side), 9 nets.
