irqmask/koewiba-domotic/hw/buscom-hub/buscom-hub.kicad_pcb

## KiCad design hw/buscom-hub/buscom-hub.kicad_pcb (2023-11-28)

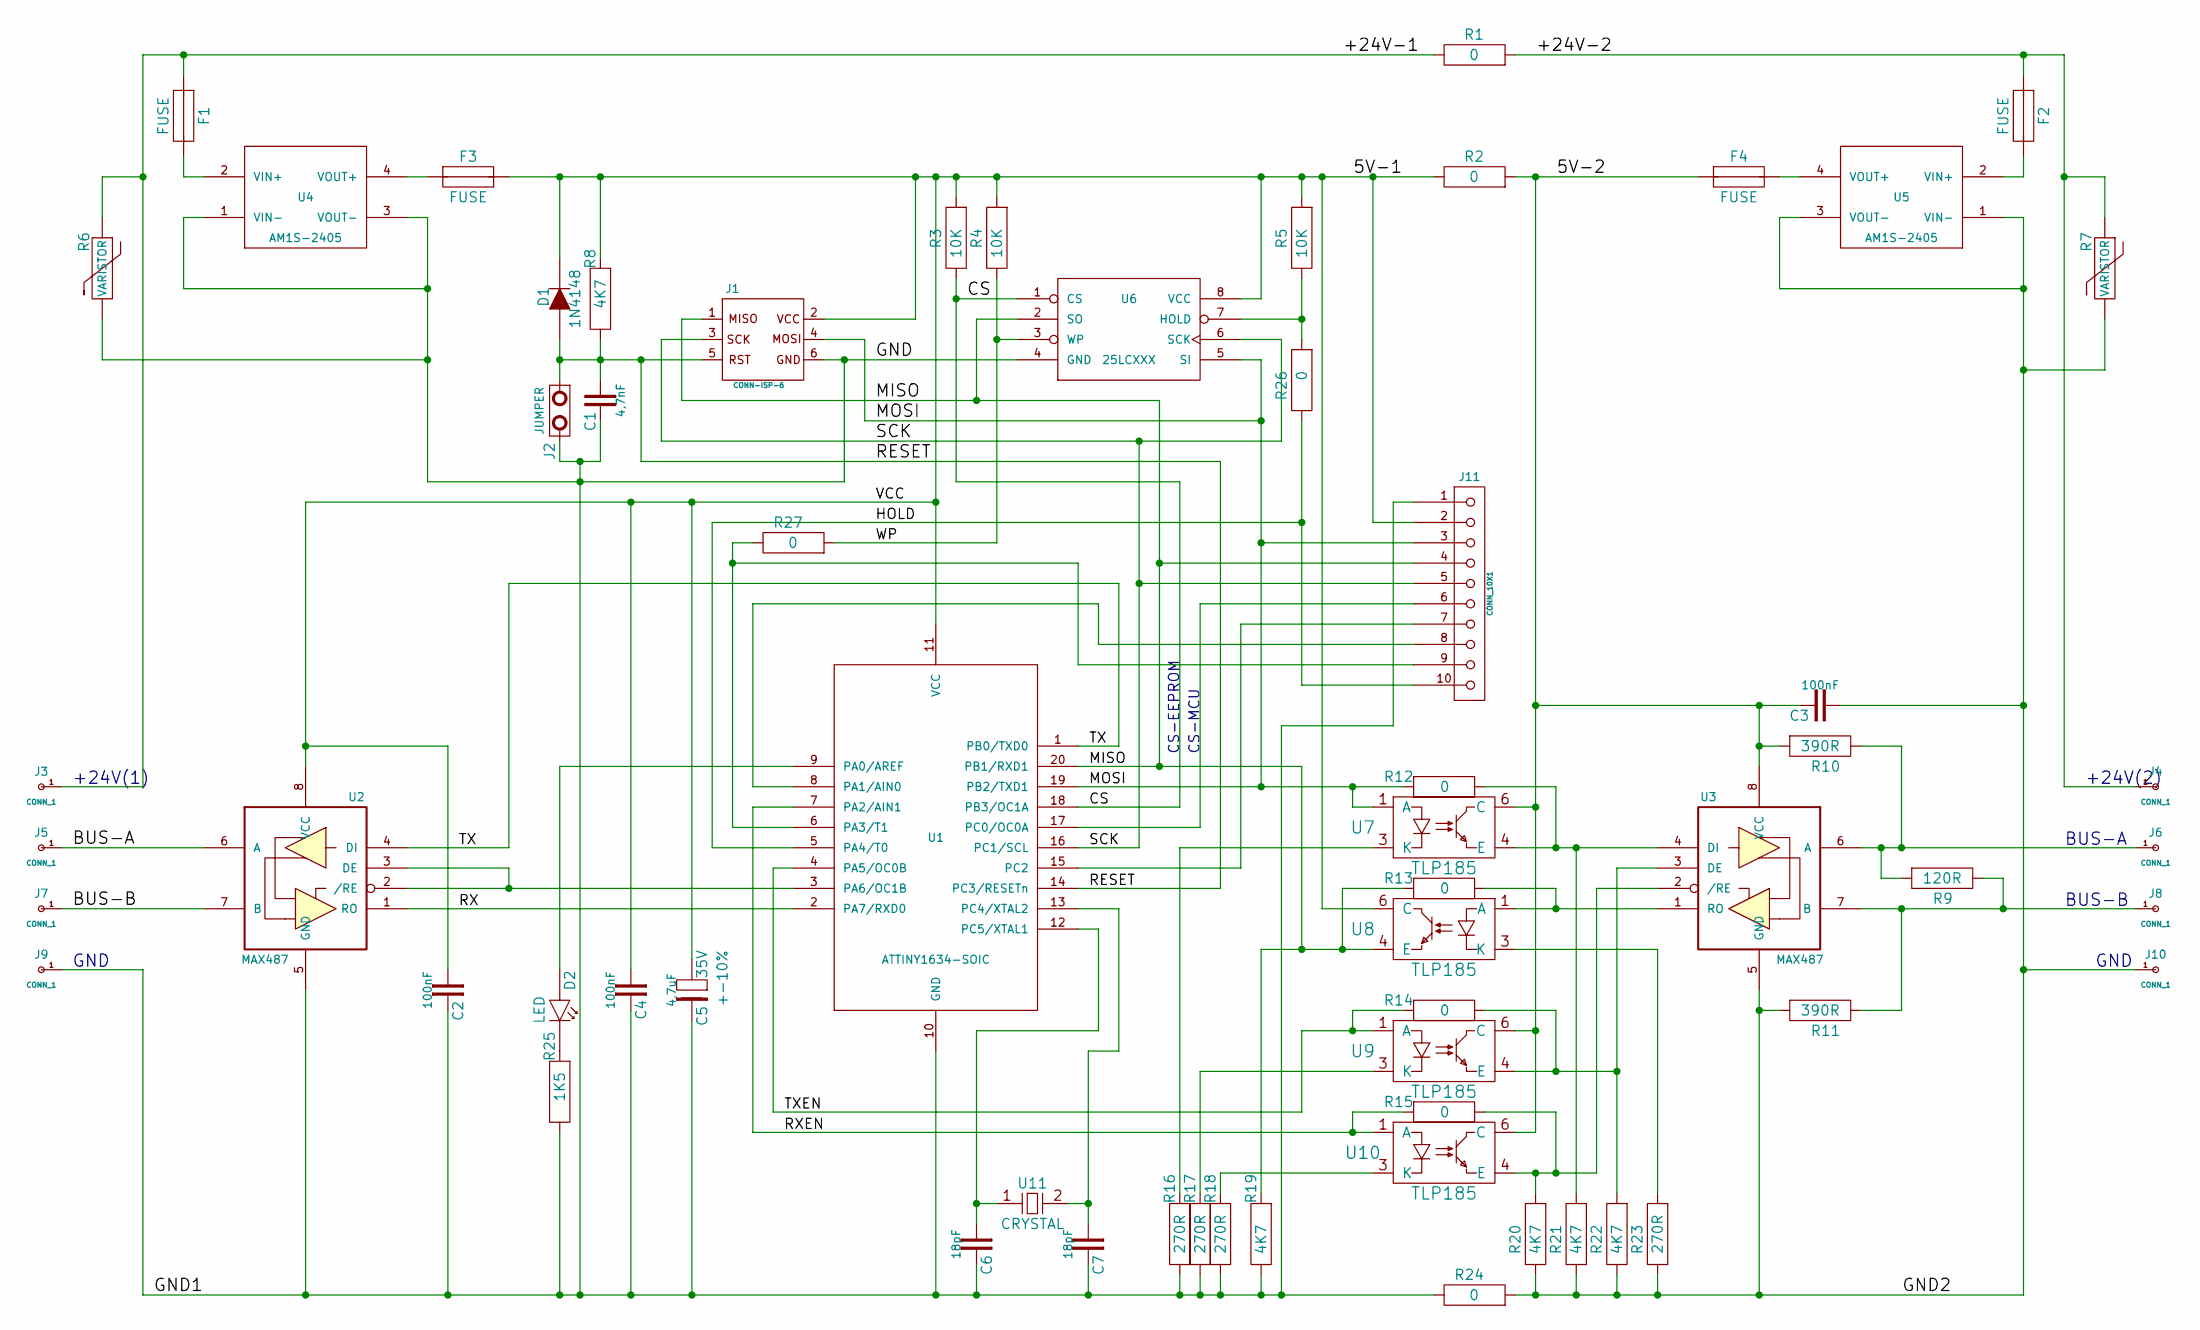
[picture p116: schematic buscom-hub.kicad_sch]

Parts:
C1: 4,7nF
C2, C3, C4: 100nF
C5: 4,7uF; 35V
C6, C7: 18pF
D1: 1N4148
D2: LED
F1, F2, F3, F4: FUSE
J1: CONN-ISP-6; AVR-ISP-6
J2: JUMPER
J3, J4, J5, J6, J7, J8, J9, J10: CONN_1
J11: CONN_10X1
R1, R2, R12, R13, R14, R15, R24, R26, R27: 0
R3, R4, R5: 10K
R6, R7: VARISTOR
R8, R19, R20, R21, R22: 4K7
R9: 120R
R10, R11: 390R
R16, R17, R18, R23: 270R
R25: 1K5
U1: ATTINY1634-SOIC; SO20L
U2, U3: MAX487; SSOP28
U4, U5: AM1S-2405; AM1S-XXXX_SIL4
U6: 25LCXXX; SO8N
U7, U8, U9, U10: TLP185
U11: CRYSTAL

Connections:
/5V-2: C3.2, F4.1, R2.1, R10.1, U3.8 (VCC), U7.6 (C), U9.6 (C), U10.6 (C)
/+24V-1: F1.1, J3.1, R1.2, R6.1
/+24V-2: F2.1, J4.1, R1.1, R7.1
/BUS-A: J5.1, U2.6 (A)
/BUS-B: J7.1, U2.7 (B)
/CS: R3.2, U1.18 (PB3/OC1A), U6.1 (CS)
/GND1: C1.2, C2.2, C4.1, C5.2, C6.2, C7.2, J1.6, J2.2, J9.1, J11.1, R6.2, R16.2, R17.2, R18.2, R19.2, R24.2, R25.2, U1.10 (GND), U2.5 (GND), U4.1 (VIN-), U4.3 (VOUT-), U6.4 (GND)
/GND2: C3.1, J10.1, R7.2, R11.1, R20.2, R21.2, R22.2, R23.2, R24.1, U3.5 (GND), U5.1 (VIN-), U5.3 (VOUT-)
/HOLD: J11.10, R26.2, U1.5 (PA4/T0)
/MISO: J1.1, J11.4, R13.1, R19.1, U1.20 (PB1/RXD1), U6.2 (SO), U8.4 (E)
/MOSI: J1.4, J11.3, R12.1, U1.19 (PB2/TXD1), U6.5 (SI), U7.1 (A)
/RESET: C1.1, D1.1 (A), J1.5, J2.1, R8.2, U1.14 (PC3/RESETn)
/RX: U1.2 (PA7/RXD0), U2.1 (RO)
/RXEN: R15.1, U1.7 (PA2/AIN1), U10.1 (A)
/SCK: J1.3, J11.5, U1.16 (PC1/SCL), U6.6 (SCK)
/TX: U1.1 (PB0/TXD0), U2.4 (DI)
/TXEN: R14.1, U1.4 (PA5/OC0B), U9.1 (A)
/VCC: C2.1, C4.2, C5.1, D1.2 (C), F3.2, J1.2, J11.2, R2.2, R3.1, R4.1, R5.1, R8.1, U1.11 (VCC), U2.8 (VCC), U6.8 (VCC), U8.6 (C)
/WP: R4.2, R27.1, U6.3 (WP)
unnamed: F4.2, U5.4 (VOUT+)
unnamed: D2.2 (C), R25.1
unnamed: J11.8, U1.8 (PA1/AIN0)
unnamed: R14.2, R22.1, U3.3 (DE), U9.4 (E)
unnamed: R18.1, U10.3 (K)
unnamed: R15.2, R20.1, U3.2 (/RE), U10.4 (E)
unnamed: D2.1 (A), U1.9 (PA0/AREF)
unnamed: F1.2, U4.2 (VIN+)
unnamed: F2.2, U5.2 (VIN+)
unnamed: J8.1, R9.2, R11.2, U3.7 (B)
unnamed: C6.1, U1.12 (PC5/XTAL1), U11.1
unnamed: F3.1, U4.4 (VOUT+)
unnamed: R17.1, U9.3 (K)
unnamed: R16.1, U7.3 (K)
unnamed: R23.1, U8.3 (K)
unnamed: J11.6, U1.17 (PC0/OC0A)
unnamed: J11.7, U1.15 (PC2)
unnamed: R12.2, R21.1, U3.4 (DI), U7.4 (E)
unnamed: R5.2, R26.1, U6.7 (HOLD)
unnamed: J11.9, R27.2, U1.6 (PA3/T1)
unnamed: R13.2, U3.1 (RO), U8.1 (A)
unnamed: C7.1, U1.13 (PC4/XTAL2), U11.2
unnamed: U1.3 (PA6/OC1B), U2.2 (/RE), U2.3 (DE)
unnamed: J6.1, R9.1, R10.2, U3.6 (A)

Notes on the sheet:
GND
CS-EEPROM
CS-MCU
BUS-A
BUS-B
+24V(2)
+24V(1)

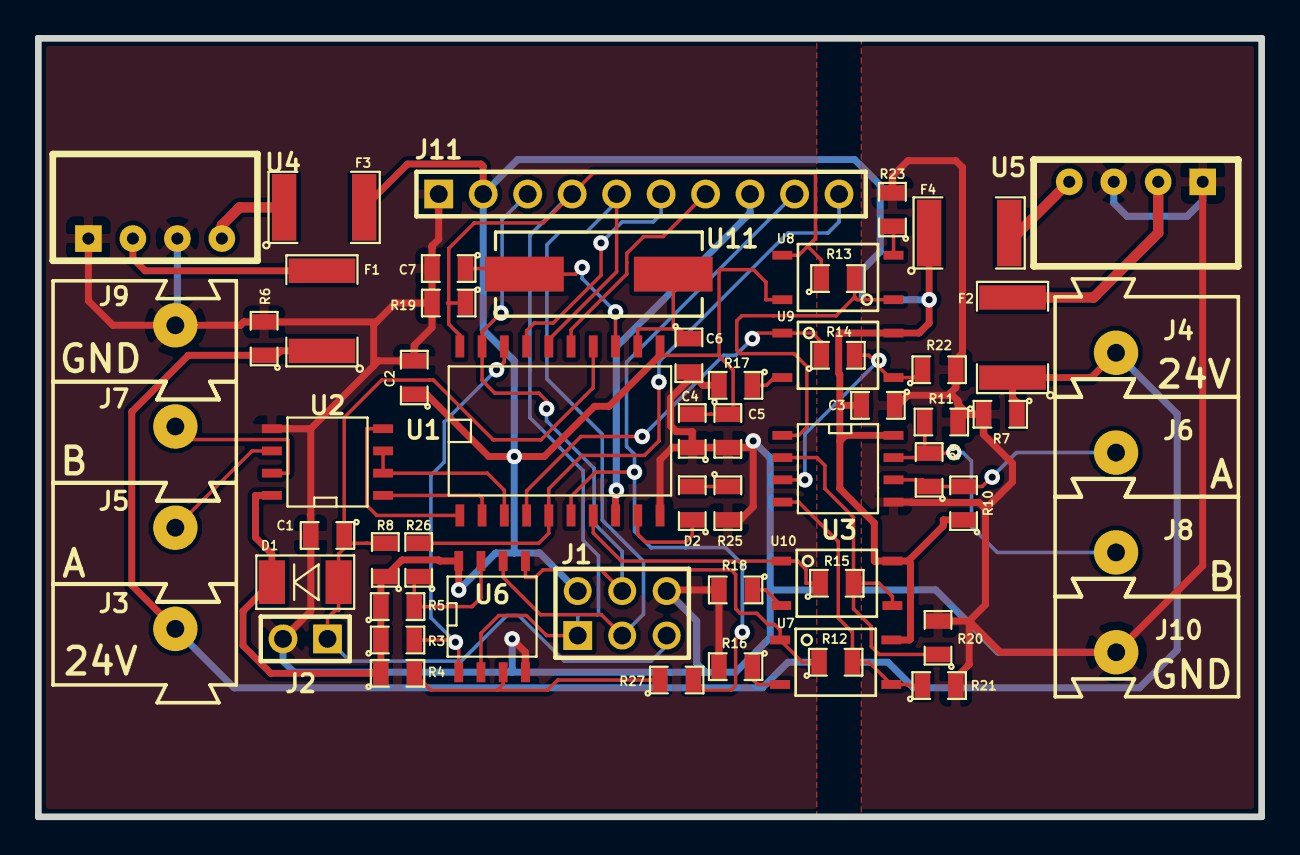
[picture p117: board buscom-hub.kicad_pcb from above]

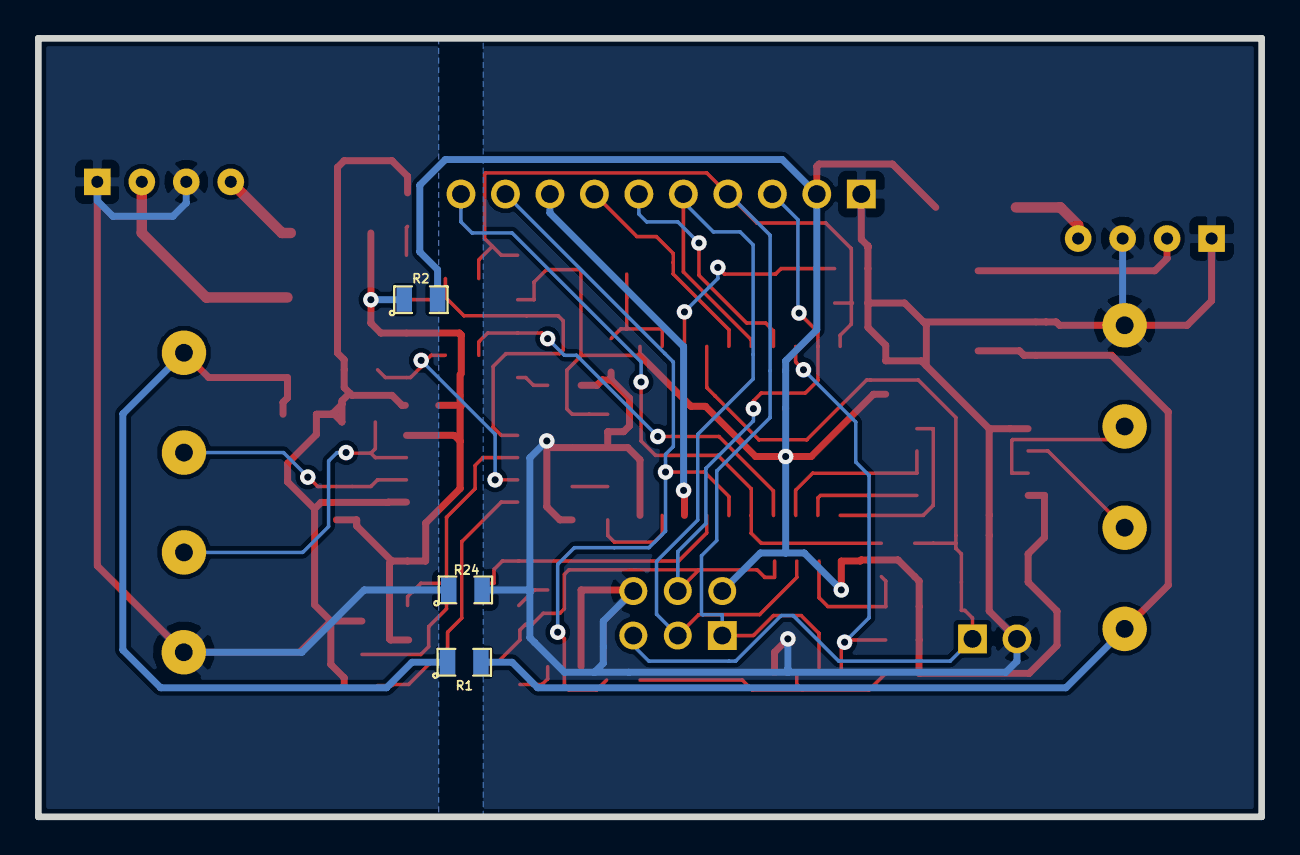
[picture p118: board buscom-hub.kicad_pcb from below]

Board: 2 copper layers, 69.8 x 44.4 mm, 62 parts (3 on the bottom side), 43 nets.
