irqmask/koewiba-domotic/hw/switch_3pole_5x/switch_3pole_5x.kicad_pcb

## KiCad design hw/switch_3pole_5x/switch_3pole_5x.kicad_pcb (2021-03-03)

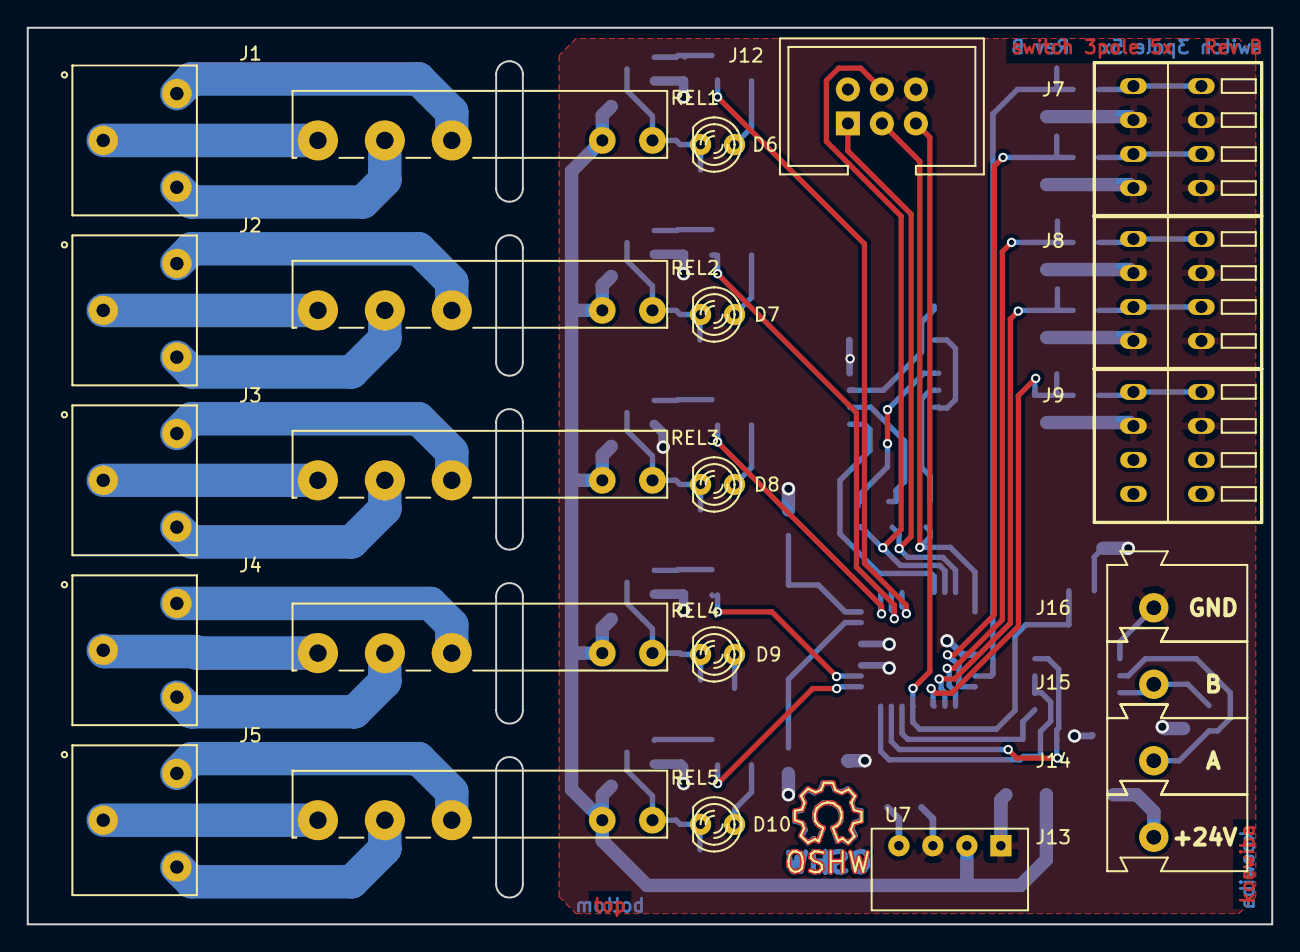
[picture p119: board switch_3pole_5x.kicad_pcb from above]

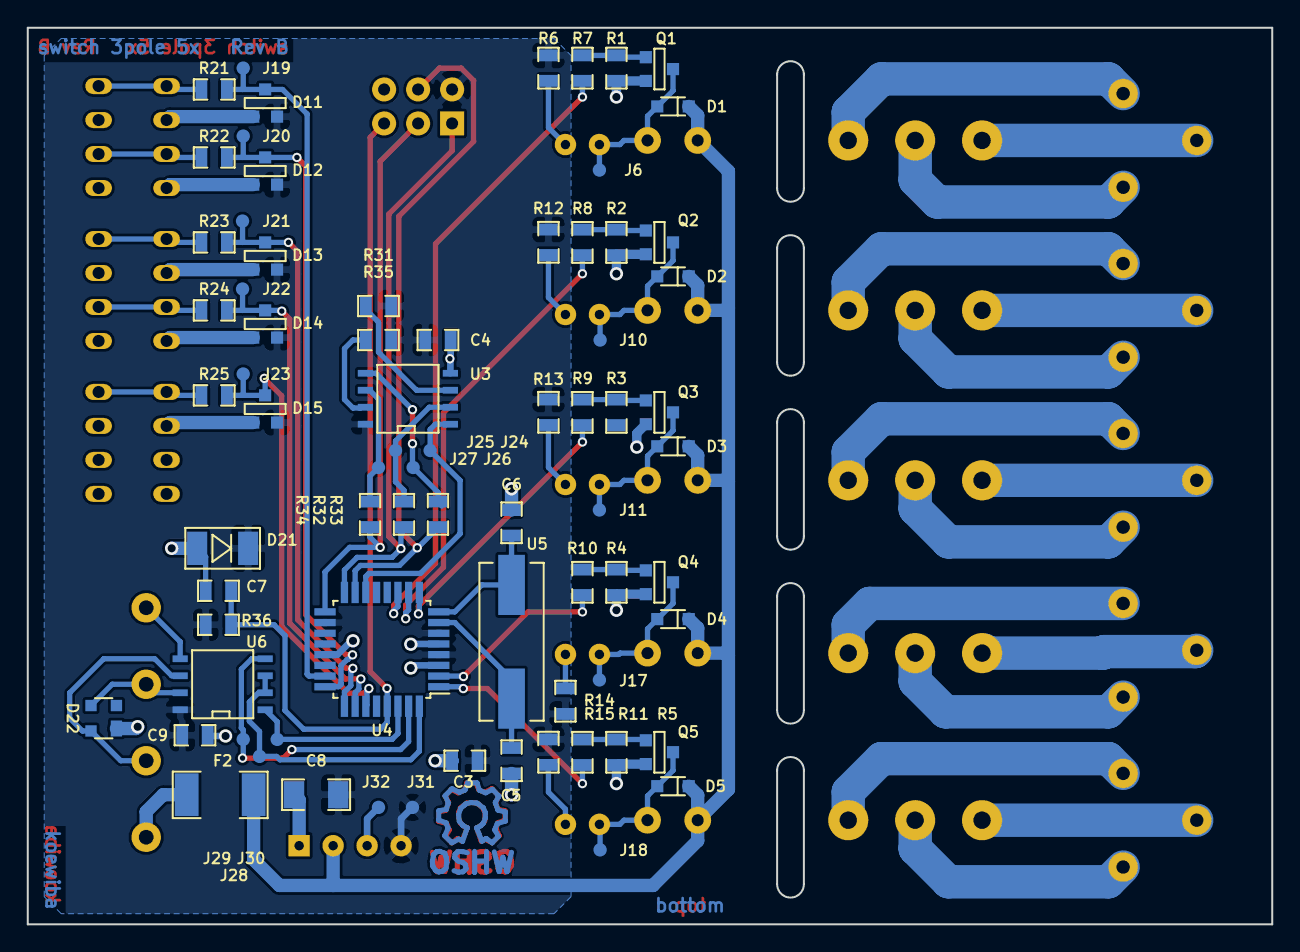
[picture p120: board switch_3pole_5x.kicad_pcb from below]

Board: 2 copper layers, 93.0 x 67.0 mm, 101 parts (75 on the bottom side), 66 nets.

Parts:
C3, C4, C9: 100nF; C_0805
C5, C6: 18pF; C_0805
C7: 4,7nF; C_0805
C8: 100µF / 6V; C_1206
D1, D2, D3, D4, D5: 1N4148; D_SOD323
D6, D7, D8, D9, D10: green, 2,2V/2mA; LED_RM2.54mm_D3mm
D11, D12, D13, D14, D15: BAT54S; SOT23-3
D21: ZD; D_MINIMELF
D22: SEMTECH SR05; D_SOT143
F2: FUSE; R_1812
J1, J2, J3, J4, J5: WAGO 2081-1123; WAGO2081-1123
J6: tp_relay_0; Testpoint_1mm
J7, J8: WAGO 233-504; WAGO233-4
J9: WAGO 233-502; WAGO233-4
J10: tp_relay_1; Testpoint_1mm
J11: tp_relay_2; Testpoint_1mm
J12: CONN-ISP-6; HEADER_6
J13: WAGO 243-723; WAGO243
J14: WAGO 243-724; WAGO243
J15: WAGO 243-721; WAGO243
J16: WAGO 243-722; WAGO243
J17: tp_relay_3; Testpoint_1mm
J18: tp_relay_4; Testpoint_1mm
J19: tp_button_0; Testpoint_1mm
J20: tp_button_1; Testpoint_1mm
J21: tp_button_2; Testpoint_1mm
J22: tp_button_3; Testpoint_1mm
J23: tp_button_4; Testpoint_1mm
J24: tp_cseep; Testpoint_1mm
J25: tp_miso; Testpoint_1mm
J26: tp_mosi; Testpoint_1mm
J27: tp_sck; Testpoint_1mm
J28: tp_txden; Testpoint_1mm
J29: tp_txd; Testpoint_1mm
J30: tp_rxd; Testpoint_1mm
J31: tp_vcc; Testpoint_1mm
J32: tp_gnd; Testpoint_1mm
LOGO1, LOGO2: OPEN_HARDWARE_1; Symbol_OSHW-Logo_Copper
LOGO4: Open Hardware; Symbol_OSHW-Logo_SilkScreen
Q1, Q2, Q3, Q4, Q5: BSS138; SOT23-3
R1, R2, R3, R4, R5, R31, R35, R36: 10k; R_0805
R6, R12, R13, R14, R15: 1k5; R_0805
R7, R8, R9, R10, R11, R32, R33, R34: 100; R_0805
R21, R22, R23, R24, R25: 4k7; R_0805
REL1, REL2, REL3, REL4, REL5: FINDER_34.51.7.024; finder_34.51_1xUM
U3: 25LC256; SO8N
U4: ATMEGA328-TQFP32; TQFP-32_7x7mm_Pitch0.8mm
U5: 7,3728MHz; CRY_HC49_SMD
U6: MAX487ECSA; SO8N
U7: AM1S-2405; AM1S-XXXX_SIL4

Connections:
+5V: C3.1, C4.1, C8.1, C9.2, D11.2, D12.2, D13.2, D14.2, D15.2, D21.2, J12.2, J31.1, R6.2, R12.2, R13.2, R14.2, R15.2, R31.1, R35.1, R36.1, U3.8, U4.4, U4.6, U4.18, U6.8, U7.4
+24V: D1.2, D2.2, D3.2, D4.2, D5.2, F2.1, REL1.2, REL2.2, REL3.2, REL4.2, REL5.2, U7.2
//button_0: D11.3, J19.1, R21.1, U4.23
//button_1: D12.3, J20.1, R22.1, U4.24
//button_2: D13.3, J21.1, R23.1, U4.25
//button_3: D14.3, J22.1, R24.1, U4.26
//button_4: D15.3, J23.1, R25.1, U4.27
/Relays/RELAY_0_COM: J1.3, REL1.4
/Relays/RELAY_0_NC: J1.1, REL1.3
/Relays/RELAY_0_NO: J1.2, REL1.5
/Relays/RELAY_1_COM: J2.3, REL2.4
/Relays/RELAY_1_NC: J2.1, REL2.3
/Relays/RELAY_1_NO: J2.2, REL2.5
/Relays/RELAY_2_COM: J3.3, REL3.4
/Relays/RELAY_2_NC: J3.1, REL3.3
/Relays/RELAY_2_NO: J3.2, REL3.5
/Relays/RELAY_3_COM: J4.3, REL4.4
/Relays/RELAY_3_NC: J4.1, REL4.3
/Relays/RELAY_3_NO: J4.2, REL4.5
/Relays/RELAY_4_COM: J5.3, REL5.4
/Relays/RELAY_4_NC: J5.1, REL5.3
/Relays/RELAY_4_NO: J5.2, REL5.5
/bus_atmega328_basic//CSEEP: J24.1, U3.1, U4.14
/bus_atmega328_basic//RESET: C7.1, J12.5, R36.2, U4.29
/bus_atmega328_basic/A: D22.4, J14.1, U6.6
/bus_atmega328_basic/B: D22.3, J15.1, U6.7
/bus_atmega328_basic/MISO: J25.1, R32.2, U3.2
/bus_atmega328_basic/MOSI: J26.1, R33.2, U3.5
/bus_atmega328_basic/PB3_MOSI: J12.4, R33.1, U4.15
/bus_atmega328_basic/PB4_MISO: J12.1, R32.1, U4.16
/bus_atmega328_basic/PB5_SCK: J12.3, R34.1, U4.17
/bus_atmega328_basic/RXD0: J30.1, U4.30, U6.1
/bus_atmega328_basic/SCK: J27.1, R34.2, U3.6
/bus_atmega328_basic/TXD0: J29.1, U4.31, U6.4
/bus_atmega328_basic/TXD0EN: J28.1, U4.32, U6.2, U6.3
/relay_0: R7.2, U4.11
/relay_1: R8.2, U4.10
/relay_2: R9.2, U4.9
/relay_3: R10.2, U4.2
/relay_4: R11.2, U4.1
GND: C3.2, C4.2, C5.2, C6.2, C7.2, C8.2, C9.1, D11.1, D12.1, D13.1, D14.1, D15.1, D21.1, D22.1, J7.2, J7.4, J8.2, J8.4, J9.2, J12.6, J16.1, J32.1, Q1.2, Q2.2, Q3.2, Q4.2, Q5.2, R1.2, R2.2, R4.2, R5.2, U3.4, U4.3, U4.5, U4.21, U6.5, U7.1, U7.3
unnamed: C5.1, U4.7, U5.1
unnamed: C6.1, U4.8, U5.2
unnamed: D1.1, D6.2, J6.1, Q1.3, REL1.1
unnamed: D2.1, D7.2, J10.1, Q2.3, REL2.1
unnamed: D3.1, D8.2, J11.1, Q3.3, REL3.1
unnamed: D4.1, D9.2, J17.1, Q4.3, REL4.1
unnamed: D6.1, R6.1
unnamed: D7.1, R12.1
unnamed: D8.1, R13.1
unnamed: D9.1, R14.1
unnamed: D10.1, R15.1
unnamed: D5.1, D10.2, J18.1, Q5.3, REL5.1
unnamed: F2.2, J13.1
unnamed: J7.1, R21.2
unnamed: J7.3, R22.2
unnamed: J8.1, R23.2
unnamed: J8.3, R24.2
unnamed: J9.1, R25.2
unnamed: Q1.1, R1.1, R7.1
unnamed: Q2.1, R2.1, R8.1
unnamed: Q3.1, R3.1, R9.1
unnamed: Q4.1, R4.1, R10.1
unnamed: Q5.1, R5.1, R11.1
unnamed: R31.2, U3.3
unnamed: R35.2, U3.7
