irqmask/koewiba-domotic/sw/stm8/heatervalve/encoder.c

/**
 * @addtogroup ENCODER
 *
 * @{
 * @file    encoder.c
 * @brief   A module to interface the heatervalve's encoder.
 *
 * @author  Christian Verhalen
 *///---------------------------------------------------------------------------
/*
 * Copyright (C) 2024  christian <irqmask@web.de>
 *
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
 * You should have received a copy of the GNU General Public License
 * along with this program.  If not, see <http://www.gnu.org/licenses/>.
 */

// --- Include section ---------------------------------------------------------

#include "encoder.h"

#include <stdio.h>

// include
#include "stm8l052c6.h"

#ifdef HAS_APPCONFIG_H
 #include "appconfig.h"
#endif

// --- Definitions -------------------------------------------------------------

#define ENC_DDR     PC_DDR
#define ENC_INPUT   PC_IDR
#define ENC_CR1     PC_CR1
#define ENC_A       PIN_0
#define ENC_B       PIN_1
#define ENC_MASK    (ENC_A | ENC_B)

#define ENC_STATE_00 0
#define ENC_STATE_01 ENC_A
#define ENC_STATE_10 ENC_B
#define ENC_STATE_11 ENC_A | ENC_B

// --- Type definitions --------------------------------------------------------

// --- Local variables ---------------------------------------------------------

static uint8_t g_encval;
static bool g_encval_changed;

static uint8_t g_old_input_state;
static uint8_t g_input_state;


// --- Global variables --------------------------------------------------------

// --- Module global variables -------------------------------------------------

// --- Local functions ---------------------------------------------------------

static void increase(void)
{
    g_encval++;
    g_encval_changed = true;
}

static void decrease(void)
{
    g_encval--;
    g_encval_changed = true;
}

// --- Module global functions -------------------------------------------------

// --- Global functions --------------------------------------------------------

/**
 * Initialize Encoder hardware and data.
 */
void enc_initialize(void)
{
    ENC_DDR &= ~ENC_MASK;   // configure as input
    ENC_CR1 |= ENC_MASK;    // activate internal pull-up resistor
    g_encval = 0;
    g_encval_changed = false;

    g_old_input_state = ENC_INPUT & ENC_MASK;
    g_input_state = g_old_input_state;
}

/**
 * Called ideally by timer interrupt. Reads encoder input and
 * increments / decrements encoder value accordingly.
 */
void enc_on_irq(void)
{
    g_input_state = ENC_INPUT & ENC_MASK;

    if ( g_input_state == g_old_input_state )
        return;

    switch ( g_old_input_state ) {
    case ENC_STATE_00:
        if ( g_input_state == ENC_STATE_01 )
            increase();
        else if ( g_input_state == ENC_STATE_10 )
            decrease();
        break;
    case ENC_STATE_10:
        // don't count this step because it resides in mechanical unstable
        //state
        // if (new == 0b00) g_uEncValue--;
        // else if (new == 0b10) g_uEncValue++;
        break;
    case ENC_STATE_11:
        if ( g_input_state == ENC_STATE_10 )
            increase();
        else if ( g_input_state == ENC_STATE_01 )
            decrease();
        break;
    case ENC_STATE_01:
        // don't count this step because it resides in mechanical unstable
        //state
        // if (new == 0b11) g_uEncValue--;
        // else if (new == 0b00) g_uEncValue++;
        break;
    }
    g_old_input_state = g_input_state;
}

/**
 * @returns true if encoder value changed since last read
 */
bool enc_val_changed(void)
{
    return g_encval_changed;
}

/**
 * Read current encoder value
 */
uint8_t enc_read()
{
    g_encval_changed = false;
    return g_encval;
}

/**
 * Encode background task
 */
void enc_background(void)
{
    if (enc_val_changed()) {
        printf("enc %02x\n", enc_read());
    }
}
/** @} */
