irqmask/koewiba-domotic/sw/shared/heatercontrol_common.h

/**
 * @addtogroup HEATERCONTROL
 * @brief Common setting for heatercontrol applications
 *
 * @{
 * @file    heatercontrol_common.h
 * @brief   Public interface of bus-scheduler wrapper functions.
 *
 * @author  Christian Verhalen
 *///---------------------------------------------------------------------------

#ifndef _HEATERCONTROL_COMMON_H_
#define _HEATERCONTROL_COMMON_H_

// --- Include section ---------------------------------------------------------

// --- Definitions -------------------------------------------------------------

#define HEATERCTRL_MIN_TEMP (27315 + 100)   //!< Minimum temperature 1°C
#define HEATERCTRL_MAX_TEMP (27315 + 4000)  //!< Maximum temperature 40°C

// --- Type definitions --------------------------------------------------------

// --- Local variables ---------------------------------------------------------

// --- Global variables --------------------------------------------------------

// --- Module global variables -------------------------------------------------

// --- Local functions ---------------------------------------------------------

// --- Module global functions -------------------------------------------------

// --- Global functions --------------------------------------------------------


#endif /* _HEATERCONTROL_COMMON_H_ */
/** @} */
