irqmask/koewiba-domotic/sw/shared/bus_transport.c

/**
 * @addtogroup BUS
 * @addtogroup BUS_TRANSPORT
 * @brief Transport protocol for sending and receiving messages on the bus.
 *
 * @{
 * @file    bus_transport.c
 * @brief   Transport protocol for sending and receiving messages on the bus.
 *///---------------------------------------------------------------------------
/*
 * Copyright (C) 2025  christian <irqmask@web.de>
 *
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
 * You should have received a copy of the GNU General Public License
 * along with this program.  If not, see <http://www.gnu.org/licenses/>.
 */

// --- Include section ---------------------------------------------------------

#include "prjconf.h"

#ifdef PRJCONF_UC_AVR
#include <util/delay.h>
#endif

#include "bus_intern.h"
#include "cmddef_common.h"
#include "crc16.h"
#include "sleepmode.h"
#include "timer.h"

// --- Definitions -------------------------------------------------------------

// --- Type definitions --------------------------------------------------------

// --- Local variables ---------------------------------------------------------

// --- Global variables --------------------------------------------------------

// --- Module global variables -------------------------------------------------

// --- Local functions ---------------------------------------------------------

// Reset bus to Idle state.
static void reset_bus(sBus_t* psBus)
{
    psBus->eState = eBus_Idle;
    psBus->sRecvMsg.uOverallLength = 0;
    psBus->sRecvMsg.length = 0;
}

// Create empty message depending on bus's configuration.
static void create_empty_message(sBus_t* psBus)
{
    psBus->auEmptyMsg[0] = BUS_SYNCBYTE;
    psBus->auEmptyMsg[1] = psBus->sCfg.uOwnNodeAddress; // local address on bus
    psBus->auEmptyMsg[2] = 0; // length
}

// Send ACK-Byte.
static void send_ack(sBus_t* psBus)
{
    uint8_t ack = BUS_ACKBYTE;

    bus_phy_send(&psBus->sPhy, &ack, 1) ;
}

// Receive and interpret data.
static bool receive (sBus_t* psBus)
{
    uint16_t crc;
    uint8_t u;
    bool    bytereceived;

    do {
        if (!(bytereceived = bus_phy_data_received(&psBus->sPhy)) ||
            psBus->msg_receive_state == eBUS_RECV_MESSAGE) {
            break; // No byte received or message not retrieved.
        }
        bus_phy_read_byte(&psBus->sPhy, &u);

        // 1. byte: check sync byte
        if (psBus->sRecvMsg.uOverallLength == 0) {
            if (u != BUS_SYNCBYTE) {
                reset_bus(psBus);
                break; // not the sync byte, wait for next byte
            }

        // 2. byte: check token or sender byte
        } else if (psBus->sRecvMsg.uOverallLength == 1) {
            // token received?
            if (u & TOKENBIT) {
                // is it me?
                if ((u & ADDRMASK) == (psBus->sCfg.uOwnNodeAddress)) {
                    psBus->eState = eBus_GotToken;
                } else {
                    psBus->eState = eBus_Idle;
                }
                psBus->sRecvMsg.uOverallLength = 0;
                psBus->sRecvMsg.length = 0;
                break;
            }
            else {
                // message to be received. save sender-address lower byte
                psBus->sRecvMsg.uSender = u;
                psBus->eState = eBus_ReceivingActive;
            }
        }
        // active receiving state, receive and check message
        // and then go back to eBus_Idle state.
        else if (psBus->eState == eBus_ReceivingActive) {
            // 3. byte: LE - Length of message from AR to CRCL
            if (psBus->sRecvMsg.uOverallLength == 2) {
                // check correctness of length
                if ((0==u)) {
                    // empty message received
                    psBus->eState = eBus_Idle;
                    psBus->sRecvMsg.uOverallLength = 0;
                    psBus->msg_receive_state = eBUS_RECV_EMPTY_MESSAGE;
                    break;
                }
                else if (u > BUS_MAXRECVMSGLEN) {
                    // length is zero or length is too big
                    reset_bus(psBus); // wait for next message on bus
                    break;
                }
                psBus->sRecvMsg.length = u;

            // 4. byte: AR - Address receiver 7bit
            } else if (psBus->sRecvMsg.uOverallLength == 3) {
                // check correctness of receiver address
                if (u & TOKENBIT) {
                    // bad receiver address. valid range is 0x00..0x7F
                    reset_bus(psBus);
                    break;
                }
                psBus->sRecvMsg.uReceiver = u;

            // 5. byte: EA - Extended address 4bit sender in higher nibble, 4bit receiver in lower nibble.
            } else if (psBus->sRecvMsg.uOverallLength == 4) {
                psBus->sRecvMsg.uSender |= (((uint16_t)u & 0x00F0) << 4);
                psBus->sRecvMsg.uReceiver |= (((uint16_t)u & 0x000F) << 8);
                // hello, is it me you are looking for (or broadcast-message or router)?
                if (psBus->sCfg.router_mode ||
                    (psBus->sRecvMsg.uReceiver == BUS_BRDCSTADR) ||
                    (psBus->sRecvMsg.uReceiver == (psBus->sCfg.uOwnAddress & BUS_SEGBRDCSTMASK)) ||
                    (psBus->sRecvMsg.uReceiver == psBus->sCfg.uOwnAddress)) {
                    // nothing more to do here.
                } else {
                    // we are not interested in this message
                    psBus->eState = eBus_ReceivingPassive;
                }

            // receive data (5th byte till length + 3(SY+AS+LE) - 2(CRC))
            } else if (psBus->sRecvMsg.uOverallLength > 4) {
                if (psBus->sRecvMsg.uOverallLength == (psBus->sRecvMsg.length + 3 - 2)) {
                    psBus->sRecvMsg.uCRC = u << 8;
                    // N th byte: CRCL - Low byte of 16bit CRC

                } else if (psBus->sRecvMsg.uOverallLength == (psBus->sRecvMsg.length + 3 - 1)) {
                    psBus->sRecvMsg.uCRC |= u;
                    crc = crc_calc16(&psBus->sRecvMsg.auBuf[0], psBus->sRecvMsg.length + 3 - 2);
                    if (crc == psBus->sRecvMsg.uCRC) {
                        // message has been received correctly
                        if (psBus->sCfg.uOwnAddress == psBus->sRecvMsg.uReceiver) {
                            // Send ACK if it was not a broadcast-message.
                            send_ack(psBus);
                        }
                        psBus->msg_receive_state = eBUS_RECV_MESSAGE;
                        psBus->sRecvMsg.uOverallLength = 0;
                        break;
                    } else {
                        // invalid crc of message
                        reset_bus(psBus);
                        break;
                    }

                } else if(psBus->sRecvMsg.uOverallLength >= psBus->sRecvMsg.length + 3) {
                    // invalid length of message
                    reset_bus(psBus);
                    break;
                }
            }
        }

        psBus->sRecvMsg.auBuf[psBus->sRecvMsg.uOverallLength] = u;
        psBus->sRecvMsg.uOverallLength++;

        // passive receiving state, only count bytes till the end of the message
        // and then go back to eBus_Idle state.
        if (psBus->eState == eBus_ReceivingPassive) {
            if (psBus->sRecvMsg.uOverallLength >= (psBus->sRecvMsg.length + 3 - 1)) {
                psBus->msg_receive_state = eBUS_RECV_FOREIGN_MESSAGE;
                reset_bus(psBus);
                // wait for ACK of receiver of foreign message
                timer_start(&psBus->ack_timeout, TIMER_MS_2_TICKS(BUS_ACK_TIMEOUT));
                psBus->eState = eBus_AckWaitReceiving;
            }
        }
    } while ( false );

    return bytereceived;
}

// Check if data had to be sent or otherwise send empty message.
static void initiate_sending (sBus_t* psBus)
{
    uint16_t crc;
    uint8_t* msg_buf;
    uint8_t  q_msg_len, q_pending;

    psBus->eState = eBus_Sending;

    // is there no old message to be re-sent?
    if (psBus->sSendMsg.uRetries > 0) {
        // initiate sending of the message
        bus_phy_send(&psBus->sPhy,
                     psBus->sSendMsg.auBuf,
                     psBus->sSendMsg.uOverallLength);
    } else {
        // is there a pending new message to be sent?
        q_pending = q_get_pending(&psBus->tx_queue);
        // if overall-length is set, message is completely enqueued
        if (q_pending > 0) {
            q_msg_len = q_get_byte(&psBus->tx_queue);

            // check if read message length matches with the number of pending bytes
            if (q_msg_len > q_pending) {
                // the queue is corrupt
                q_initialize(&psBus->tx_queue,
                             psBus->tx_queue_data,
                             sizeof(psBus->tx_queue_data));
                // send empty message
                bus_phy_send(&psBus->sPhy, psBus->auEmptyMsg, BUS_EMPTY_MSG_LEN);
            }
            psBus->sSendMsg.uOverallLength = q_msg_len;

            // copy message from queue to send buffer
            msg_buf = psBus->sSendMsg.auBuf;
            while (q_msg_len--) {
                *msg_buf++ = q_get_byte(&psBus->tx_queue);
            }

            // calculate checksum and reset the retry counter
            crc = crc_calc16(&psBus->sSendMsg.auBuf[0], psBus->sSendMsg.uOverallLength);
            psBus->sSendMsg.auBuf[psBus->sSendMsg.uOverallLength++] = crc >> 8;
            psBus->sSendMsg.auBuf[psBus->sSendMsg.uOverallLength++] = crc & 0xFF;
            psBus->sSendMsg.uRetries = BUS_MAX_MSGRETRIES;

            // initiate sending of the message
            bus_phy_send(&psBus->sPhy,
                         psBus->sSendMsg.auBuf,
                         psBus->sSendMsg.uOverallLength);
        } else {
            // send empty message
            bus_phy_send(&psBus->sPhy, psBus->auEmptyMsg, BUS_EMPTY_MSG_LEN);
        }
    }
}

// Check if data has been sent.
static void check_message_sent (sBus_t* psBus)
{
    // data completely sent?
    if (bus_phy_sending(&psBus->sPhy) == true) return;
    // some retries left, then move to waiting for ack.
    if (0 < psBus->sSendMsg.uRetries) {
        psBus->sSendMsg.uRetries--;
        psBus->eState = eBus_AckWaitSending;
    } else {
        // empty message has been sent
        psBus->eState = eBus_Idle;
    }

}

// Wait for an acknowledge byte after message has been sent
static void wait_for_ack_after_sending (sBus_t* psBus)
{
    uint8_t u = 0;
    bool    ack_received = false;

    do {
        if (!bus_phy_data_received(&psBus->sPhy) ||
            !bus_phy_read_byte(&psBus->sPhy, &u)) {
            break; // No byte received.
        }

        switch (u) {
        case BUS_ACKBYTE:
            psBus->sSendMsg.uRetries = 0;
            ack_received = true;
            reset_bus(psBus); // go back to idle
            // TODO CV / TODO RM: notify application, that ACK byte has been received.
            break;

        default:
            // not the ACK byte, reset bus, go back to idle
            reset_bus(psBus);
            break;
        }

        // has message been acknowledged at all?
        if (psBus->sSendMsg.uRetries == 0) {
            // end sending message
            psBus->sSendMsg.uOverallLength = 0;
            if (!ack_received) {
                // TODO CV / TODO RM: notify application, that ACK byte has not
                // been received.
            }
        }
    } while(false);
}

// wait until an ACK byte has been sent by the receiver of the foreign message
static void wait_for_ack_passive (sBus_t* psBus)
{
    uint8_t u;

    do {
        if (timer_is_elapsed(&psBus->ack_timeout)) {
            // timeout. go back to idle
            reset_bus(psBus);
            break;
        }
        else if (!bus_phy_data_received(&psBus->sPhy) ||
                 psBus->msg_receive_state == eBUS_RECV_MESSAGE) {
            break; // No byte received or message not retrieved.
        }
        bus_phy_read_byte(&psBus->sPhy, &u);

        if (u == BUS_ACKBYTE) {
            // ACK byte received, reset bus and wait for next token.
            reset_bus(psBus);
        } else {
            // ACK not received, something else received.
            // Also reset the bus and back to idle
        }
    } while(false);
}

// --- Module global functions -------------------------------------------------

/**
 * Reset bus state.
 *
 * @param[in]   psBus       Handle of the bus.
 */
void bus_trp_reset (sBus_t* psBus)
{
    reset_bus(psBus);
}

/**
 * Manage sending and receiving of messages.
 *
 * @param[in]   psBus       Handle of the bus.
 *
 * @returns true, if there is a pending received message, otherwise false.
 */
bool bus_trp_send_and_receive (sBus_t* psBus)
{
    uint8_t bb = 0;

    switch (psBus->eState) {
    case eBus_GotToken:
        // initiate sending of message
        initiate_sending(psBus);
        break;

    case eBus_Sending:
        // message is currently being sent
        check_message_sent(psBus);
        break;

    case eBus_AckWaitSending:
        wait_for_ack_after_sending(psBus);
        break;

    case eBus_AckWaitReceiving:
        wait_for_ack_passive(psBus);
        break;

    case eBus_InitWait:
        if (bus_phy_data_received(&psBus->sPhy)) {
            sleep_request(false);
            psBus->eState = eBus_Idle;
            psBus->eModuleState = eMod_Running;
        } else {
            // wait until first byte is ready to be received
            break;
        }
        // otherwise fall through to eBus_Idle state
        // no break
    case eBus_Idle:
    case eBus_ReceivingWait:
    case eBus_ReceivingActive:
    case eBus_ReceivingPassive:
    default:
        // repeat receiving while queue is not empty
        while (psBus->msg_receive_state != eBUS_RECV_MESSAGE && bb<2) {
            if (receive(psBus) == false) break;
            bb++;
        }
        break;
    }

    return (psBus->msg_receive_state == eBUS_RECV_MESSAGE);
}

/**
 * Start sending of sleep command.
 *
 * @param[in]   psBus       Handle of the bus.
 *
 * @returns true, if the sleep command has been sent, otherwise false.
 */
bool bus_trp_send_sleepcmd (sBus_t* psBus)
{
    uint16_t crc;
    uint8_t msg[8];

    msg[0] = BUS_SYNCBYTE;                      // SY - Syncronization byte: '�' = 0b10011010
    msg[1] = psBus->sCfg.uOwnNodeAddress;       // AS - Address sender on bus 7bit
    msg[2] = sizeof(msg) - 3;                   // LE - Length of message from AR to CRCL
    // AR - Address receiver 7bit (Bus-Segment-Broadcast)
    msg[3] = ((psBus->sCfg.uOwnAddress & 0x00FF) & BUS_SEGBRDCSTMASK);
    // EA - Extended address 4bit sender in higher nibble, 4bit receiver in lower nibble.
    msg[4] = (psBus->sCfg.uOwnExtAddress & (BUS_SEGBRDCSTMASK >> 8)) |
             (psBus->sCfg.uOwnExtAddress << 4);
    msg[5] = eCMD_SLEEP;                        // MD - Sleep-Command
    crc = crc_calc16(&msg[0], 6);
    msg[6] = crc >> 8;
    msg[7] = crc & 0xFF;

    if( bus_phy_send(&psBus->sPhy, msg, sizeof msg) ) {
        while( bus_phy_sending(&psBus->sPhy) ) {}; // Wait till message is sent completely.
        return true;
    }
    return false;
}

/**
 * Send acknowledge byte.
 *
 * @param[in]   bus         Handle of the bus.
 */
void bus_trp_send_ackbyte (sBus_t* bus)
{
    send_ack(bus);
}

// --- Global functions --------------------------------------------------------

/**
 * Configure the bus interface and data.
 * @note Has to be called before bus_initialize() is called the first time.
 *
 * @param[in]   psBus       Handle of the bus.
 * @param[in]   uNodeAddress Address of this node.
 */
void bus_configure (sBus_t* psBus, uint16_t uNodeAddress)
{
    psBus->sCfg.uOwnAddress = uNodeAddress;
    psBus->sCfg.uOwnNodeAddress = uNodeAddress & 0x007F;
    psBus->sCfg.uOwnExtAddress = (uNodeAddress >> 8) & 0x000F;
    psBus->sCfg.router_mode = false;
    create_empty_message(psBus);
}

/**
 * Initialize Bus interface.
 *
 * @param[in]   psBus       Handle of the bus.
 * @param[in]   uUart       Number of the UART. 0=first.
 */
void bus_initialize (sBus_t* psBus, uint8_t uUart)
{
    psBus->eState = eBus_InitWait;
    psBus->sSendMsg.uRetries = 0;
    psBus->sSendMsg.uOverallLength = 0;
    psBus->eModuleState = eMod_Sleeping;
    bus_phy_initialize(&psBus->sPhy, uUart);
    bus_flush_bus(psBus);
    q_initialize(&psBus->tx_queue,
                 psBus->tx_queue_data,
                 sizeof(psBus->tx_queue_data));
}

void bus_set_router_mode (sBus_t* bus, bool router_mode)
{
    bus->sCfg.router_mode = router_mode;
}

/**
 * Flushes phy-buffer and resets bus.
 *
 * @param[in]   psBus       Handle of the bus.
 */
void bus_flush_bus (sBus_t* psBus)
{
    bus_phy_flush(&psBus->sPhy);
    reset_bus(psBus);
}

/**
 * Checks if there is a pending message to be read.
 *
 * @param[in]   psBus       Handle of the bus.
 *
 * @returns true, if there is a pending message.
 */
bool bus_get_message (sBus_t* psBus)
{
    return bus_trp_send_and_receive(psBus);
}

/**
 * Reads a pending message.
 *
 * @param[in] 	psBus       Handle of the bus.
 * @param[out] 	puSender    Sender of the message.
 * @param[out] 	puLen       (Netto) Length of the message.
 * @param[out]  puMsg       Received message.
 *
 * @returns true, if a message has been received and.
 */
bool bus_read_message (sBus_t*  psBus,
                       uint16_t* puSender,
                       uint8_t* puLen,
                       uint8_t* puMsg)
{
    uint8_t len = 0;

    do {
        // is there a new message pending?
        if (psBus->msg_receive_state != eBUS_RECV_MESSAGE) {
            break;
        }
        *puSender   = psBus->sRecvMsg.uSender;

        while (len < psBus->sRecvMsg.length - 4) {
            puMsg[len] = psBus->sRecvMsg.auBuf[5 + len];
            len ++;
        }
        // reset bus to IDLE state, so we are ready to receive the next message
        psBus->msg_receive_state = eBUS_RECV_NOTHING;
        psBus->sRecvMsg.length = 0;
        psBus->sRecvMsg.uOverallLength = 0;
        psBus->eState = eBus_Idle;

        *puLen      = len;
        return true;
    } while ( false );

    return false;
}

/**
 * Reads a pending message.
 *
 * @param[in]   psBus       Handle of the bus.
 * @param[out]  puSender    Sender of the message.
 * @param[out]  puReceiver  Receiver of the message.
 * @param[out]  puLen       (Netto) Length of the message.
 * @param[out]  puMsg       Received message.
 * @param[out]  puCRC       CRC of the message.
 *
 * @returns true, if a message has been received and.
 */
bool bus_read_message_verbose (sBus_t*   psBus,
                               uint16_t* puSender,
                               uint16_t* puReceiver,
                               uint8_t*  puLen,
                               uint8_t*  puMsg,
                               uint16_t* puCRC)
{
    uint8_t len = 0;

    do {
        // is there a new message pending?
        if (psBus->msg_receive_state != eBUS_RECV_MESSAGE) {
            break;
        }
        *puSender   = psBus->sRecvMsg.uSender;
        *puReceiver = psBus->sRecvMsg.uReceiver;
        while (len < psBus->sRecvMsg.length - 4) {
            puMsg[len] = psBus->sRecvMsg.auBuf[5 + len];
            len ++;
        }
        // reset bus to IDLE state, so we are ready to receive the next message
        psBus->msg_receive_state = eBUS_RECV_NOTHING;
        psBus->sRecvMsg.length = 0;
        psBus->sRecvMsg.uOverallLength = 0;
        psBus->eState = eBus_Idle;

        *puLen      = len;
        *puCRC      = psBus->sRecvMsg.uCRC;
        return true;
    } while ( false );

    return false;
}

/**
 * Send a message.
 *
 * @param[in]   psBus       Handle of the bus.
 * @param[in]   uReceiver   Receiver address of the message.
 * @param[in]   uLen        (Netto) Length of the message.
 * @param[in]   puMsg       Message to send.
 *
 * @returns true, if the message has successfully been queued.
 * @note Use bus_is_idle() to check if message is successfully transmitted.
 */
bool bus_send_message (sBus_t*          psBus,
                       uint16_t         uReceiver,
                       uint8_t          uLen,
                       const uint8_t*   puMsg)
{
    uint8_t  overall_msg_len;

    do {
        // wake-up bus
        if(eMod_Sleeping == psBus->eModuleState) {
            sleep_request(false);
        	bus_send_wakeupbyte(psBus);
        	psBus->eModuleState = eMod_Running;
        	bus_flush_bus(psBus);
        }

    	// check length of message to be sent.
        if (uLen == 0 ||
            uLen > BUS_MAXSENDMSGLEN) {
        	break;
        }

        // check if there is enough free space in the send queue
        // OVERALLLENGTH + SYNC + ADDR + LEN + RECV + EA + uLen
        if (q_get_free(&psBus->tx_queue) < uLen + 6) {
            break;
        }

        // save length of message in queue
        overall_msg_len = uLen + 5; //SYNC + ADDR + LEN + RECV + EA (without CRC)
        q_put_byte(&psBus->tx_queue, overall_msg_len);

        // prepare message header
        q_put_byte(&psBus->tx_queue, BUS_SYNCBYTE);
        q_put_byte(&psBus->tx_queue, psBus->sCfg.uOwnNodeAddress & 0x007F);
        q_put_byte(&psBus->tx_queue, uLen + 4); // RECV + EA + 2byte CRC
        q_put_byte(&psBus->tx_queue, uReceiver & 0x007F);
        // EA - Extended address 4bit sender in higher nibble, 4bit receiver
        // in lower nibble.
        q_put_byte(&psBus->tx_queue, ((uReceiver & 0x0F00) >> 8) |
                          (psBus->sCfg.uOwnExtAddress << 4));

        // copy data
        while (uLen--) {
            q_put_byte(&psBus->tx_queue, *puMsg++);
        }

        return true;
    } while ( false );

    return false;
}

/**
 * Send a ACK-message.
 *
 * @param[in]   psBus       Handle of the bus.
 *
 * @returns true, if the message has successfully been queued.
 * @note Use bus_is_idle() to check if message is successfully transmitted.
 */
bool bus_send_ack_message (sBus_t* psBus, uint16_t uReceiver)
{
    uint16_t crc;

    do {
        // prepare message header
        psBus->sSendMsg.uOverallLength = 0;
        psBus->sSendMsg.auBuf[psBus->sSendMsg.uOverallLength++] = BUS_SYNCBYTE;
        psBus->sSendMsg.auBuf[psBus->sSendMsg.uOverallLength++] = psBus->sCfg.uOwnNodeAddress & 0x007F;
        psBus->sSendMsg.auBuf[psBus->sSendMsg.uOverallLength++] = 5;
        psBus->sSendMsg.auBuf[psBus->sSendMsg.uOverallLength++] = uReceiver & 0x007F;
        // EA - Extended address 4bit sender in higher nibble, 4bit receiver in lower nibble.
        psBus->sSendMsg.auBuf[psBus->sSendMsg.uOverallLength++] =
            (((uReceiver & 0x0F00) >> 8) |
            ((psBus->sCfg.uOwnNodeAddress & 0x0F00) >> 4));
        // copy data
        psBus->sSendMsg.auBuf[psBus->sSendMsg.uOverallLength++] = eCMD_ACK;
        // calculate and send CRC
        crc = crc_calc16(&psBus->sSendMsg.auBuf[0], psBus->sSendMsg.uOverallLength);
        psBus->sSendMsg.auBuf[psBus->sSendMsg.uOverallLength++] = crc >> 8;
        psBus->sSendMsg.auBuf[psBus->sSendMsg.uOverallLength++] = crc & 0xFF;
        return true;
    } while ( false );
    return false;
}

/**
 * Check if bus is in IDLE state.
 *
 * @param[in]   psBus       Handle of the bus.
 * @returns true, if bus is IDLE.
 */
bool bus_is_idle (sBus_t*       psBus)
{
    return (psBus->eState == eBus_Idle);
}

/**
 * Set module into sleep mode.
 *
 * @param[in]   psBus       Handle of the bus.
 */
void bus_sleep (sBus_t*       psBus)
{
	psBus->eModuleState = eMod_Sleeping;

	sleep_request(true);
}

/**
 * Send the bus wake-up byte.
 * @param[in]   psBus      Handle of the bus.
 * @returns true, if the wake-up byte has been sent otherwise false.
 */
bool bus_send_wakeupbyte(sBus_t* psBus)
{
    uint8_t msg = BUS_WAKEUPBYTE;
    if (bus_phy_send(&psBus->sPhy, &msg, 1)) {
        while( bus_phy_sending(&psBus->sPhy) ) {}; // Wait till message is sent completely.
        return true;
    }
    return false;
}

/** @} */
/** @} */
