irqmask/koewiba-domotic/sw/avr/shared/gdisplay_font_x16.c

/**
 * @addtogroup DISPLAY
 * @addtogroup GDISPLAY
 * @brief Contains a 17x16 font for a graphic display.
 *
 * The following paragraph describes the format of the font data. At the
 * beginning three bytes of a header describe the font format:
 * 1st byte: Bytes per character
 * 2nd byte: Width in pixels
 * 3rd byte: Height in pixels
 * 4th byte till end: character data.
 *
 * With the forth byte the character data begins. Every character begins with
 * one length byte. it represents the width of the character in pixels. For
 * example the ! has a width of 3.
 * Then each byte represents a column of picels of a character. If the height is
 * greater than one byte, all bytes of one column are consecutively.
 * The space between each char has to be added manually.
 *
 * @{
 * @file    gdisplay_font_x16.c
 * @brief   Contains a 17x16 font for a graphic display.
 *
 * @author  Christian Verhalen
 *///---------------------------------------------------------------------------
/*
 * Copyright (C) 2019  christian <irqmask@web.de>
 *
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
 * You should have received a copy of the GNU General Public License
 * along with this program.  If not, see <http://www.gnu.org/licenses/>.
 */

// --- Include section ---------------------------------------------------------

#include <avr/pgmspace.h>

#include "prjtypes.h"

// --- Definitions -------------------------------------------------------------

// --- Type definitions --------------------------------------------------------

// --- Local variables ---------------------------------------------------------

// --- Global variables --------------------------------------------------------

// FontName : Liberation_Sans17x16
// FontSize : 17 x 16

const uint8_t gdisp_font1_x16[] PROGMEM = {
        0x23, 0x11, 0x10,
        0x09, 0x00, 0x00, 0x00, 0x00, 0x00, 0x00, 0x00, 0x00, 0x00, 0x00, 0x00, 0x00, 0x00, 0x00, 0x00, 0x00, 0x00, 0x00, 0x00, 0x00, 0x00, 0x00, 0x00, 0x00, 0x00, 0x00, 0x00, 0x00, 0x00, 0x00, 0x00, 0x00, 0x00, 0x00,  // Code for char
        0x03, 0xFF, 0x1D, 0xFF, 0x1D, 0xFF, 0x1D, 0x00, 0x00, 0x00, 0x00, 0x00, 0x00, 0x00, 0x00, 0x00, 0x00, 0x00, 0x00, 0x00, 0x00, 0x00, 0x00, 0x00, 0x00, 0x00, 0x00, 0x00, 0x00, 0x00, 0x00, 0x00, 0x00, 0x00, 0x00,  // Code for char !
        0x07, 0x1F, 0x00, 0x1F, 0x00, 0x1F, 0x00, 0x00, 0x00, 0x1F, 0x00, 0x1F, 0x00, 0x1F, 0x00, 0x00, 0x00, 0x00, 0x00, 0x00, 0x00, 0x00, 0x00, 0x00, 0x00, 0x00, 0x00, 0x00, 0x00, 0x00, 0x00, 0x00, 0x00, 0x00, 0x00,  // Code for char "
        0x0B, 0x00, 0x01, 0x10, 0x19, 0x90, 0x07, 0x3C, 0x01, 0x13, 0x01, 0x10, 0x01, 0x10, 0x19, 0x90, 0x07, 0x3C, 0x01, 0x13, 0x01, 0x10, 0x00, 0x00, 0x00, 0x00, 0x00, 0x00, 0x00, 0x00, 0x00, 0x00, 0x00, 0x00, 0x00,  // Code for char #
        0x09, 0x38, 0x0C, 0x7C, 0x1C, 0xFE, 0x3C, 0xC6, 0x30, 0xFF, 0x7F, 0xC6, 0x31, 0x9E, 0x3F, 0x9C, 0x1F, 0x18, 0x0F, 0x00, 0x00, 0x00, 0x00, 0x00, 0x00, 0x00, 0x00, 0x00, 0x00, 0x00, 0x00, 0x00, 0x00, 0x00, 0x00,  // Code for char $
        0x0F, 0x7E, 0x00, 0xFF, 0x00, 0x81, 0x00, 0x81, 0x10, 0xFF, 0x1C, 0x3E, 0x0F, 0x80, 0x03, 0xE0, 0x00, 0x38, 0x00, 0xDE, 0x0F, 0xE7, 0x1F, 0x21, 0x10, 0x20, 0x10, 0xE0, 0x1F, 0xC0, 0x07, 0x00, 0x00, 0x00, 0x00,  // Code for char %
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
        };

// --- Module global variables -------------------------------------------------

// --- Local functions ---------------------------------------------------------

// --- Module global functions -------------------------------------------------

// --- Global functions --------------------------------------------------------

/** @} */
