irqmask/koewiba-domotic/sw/avr/shared/gdisplay_font_x24.c

/**
 * @addtogroup DISPLAY
 * @addtogroup GDISPLAY
 * @brief Contains a 31x24 font for a graphic display.
 *
 * The following paragraph describes the format of the font data. At the
 * beginning three bytes of a header describe the font format:
 * 1st byte: Bytes per character
 * 2nd byte: Width in pixels
 * 3rd byte: Height in pixels
 * 4th byte till end: character data.
 *
 * With the forth byte the character data begins. Every character begins with
 * one length byte. it represents the width of the character in pixels. For
 * example the ! has a width of 4.
 * Then each byte represents a column of picels of a character. If the height is
 * greater than one byte, all bytes of one column are consecutively.
 * The space between each char has to be added manually.
 *
 * @{
 * @file    gdisplay_font31x24.c
 * @brief   Contains a 31x24 font for a graphic display.
 *
 * @author  Christian Verhalen
 *///---------------------------------------------------------------------------
/*
 * Copyright (C) 2019  christian <irqmask@web.de>
 *
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
 * You should have received a copy of the GNU General Public License
 * along with this program.  If not, see <http://www.gnu.org/licenses/>.
 */

// --- Include section ---------------------------------------------------------

#include <avr/pgmspace.h>

#include "prjtypes.h"

// --- Definitions -------------------------------------------------------------

// --- Type definitions --------------------------------------------------------

// --- Local variables ---------------------------------------------------------

// --- Global variables --------------------------------------------------------

// FontName : Liberation_Sans31x24
// FontSize : 31 x 24

const uint8_t gdisp_font1_x24[] PROGMEM = {
        0x5E, 0x1F, 0x18,
        0x10, 0x00, 0x00, 0x00, 0x00, 0x00, 0x00, 0x00, 0x00, 0x00, 0x00, 0x00, 0x00, 0x00, 0x00, 0x00, 0x00, 0x00, 0x00, 0x00, 0x00, 0x00, 0x00, 0x00, 0x00, 0x00, 0x00, 0x00, 0x00, 0x00, 0x00, 0x00, 0x00, 0x00, 0x00, 0x00, 0x00, 0x00, 0x00, 0x00, 0x00, 0x00, 0x00, 0x00, 0x00, 0x00, 0x00, 0x00, 0x00, 0x00, 0x00, 0x00, 0x00, 0x00, 0x00, 0x00, 0x00, 0x00, 0x00, 0x00, 0x00, 0x00, 0x00, 0x00, 0x00, 0x00, 0x00, 0x00, 0x00, 0x00, 0x00, 0x00, 0x00, 0x00, 0x00, 0x00, 0x00, 0x00, 0x00, 0x00, 0x00, 0x00, 0x00, 0x00, 0x00, 0x00, 0x00, 0x00, 0x00, 0x00, 0x00, 0x00, 0x00, 0x00,  // Code for char
        0x04, 0xFF, 0x7F, 0x3E, 0xFF, 0x7F, 0x3E, 0xFF, 0x7F, 0x3E, 0xFF, 0x7F, 0x3E, 0x00, 0x00, 0x00, 0x00, 0x00, 0x00, 0x00, 0x00, 0x00, 0x00, 0x00, 0x00, 0x00, 0x00, 0x00, 0x00, 0x00, 0x00, 0x00, 0x00, 0x00, 0x00, 0x00, 0x00, 0x00, 0x00, 0x00, 0x00, 0x00, 0x00, 0x00, 0x00, 0x00, 0x00, 0x00, 0x00, 0x00, 0x00, 0x00, 0x00, 0x00, 0x00, 0x00, 0x00, 0x00, 0x00, 0x00, 0x00, 0x00, 0x00, 0x00, 0x00, 0x00, 0x00, 0x00, 0x00, 0x00, 0x00, 0x00, 0x00, 0x00, 0x00, 0x00, 0x00, 0x00, 0x00, 0x00, 0x00, 0x00, 0x00, 0x00, 0x00, 0x00, 0x00, 0x00, 0x00, 0x00, 0x00, 0x00, 0x00, 0x00,  // Code for char !
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

// --- Local functions ---------------------------------------------------------

// --- Module global functions -------------------------------------------------

// --- Global functions --------------------------------------------------------

/** @} */
