irqmask/koewiba-domotic/sw/avr/shared/gdisplay_font_x8.c

/**
 * @addtogroup DISPLAY
 * @addtogroup GDISPLAY
 * @brief Contains a 8x8 font for a graphic display.
 *
 * The following paragraph describes the format of the font data. At the
 * beginning three bytes of a header describe the font format:
 * 1st byte: Bytes per character
 * 2nd byte: Width in pixels
 * 3rd byte: Height in pixels
 * 4th byte till end: character data.
 *
 * With the forth byte the character data begins. Every character begins with
 * one length byte. it represents the width of the character in pixels. For
 * example the ! has a width of 1.
 * Then each byte represents a column of picels of a character. If the height is
 * greater than one byte, all bytes of one column are consecutively.
 * The space between each char has to be added manually.
 *
 * @{
 * @file    gdisplay_font_x8.c
 * @brief   Contains a 8x8 font for a graphic display.
 *
 * @author  Christian Verhalen
 *///---------------------------------------------------------------------------
/*
 * Copyright (C) 2019  christian <irqmask@web.de>
 *
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
 * You should have received a copy of the GNU General Public License
 * along with this program.  If not, see <http://www.gnu.org/licenses/>.
 */

// --- Include section ---------------------------------------------------------

#include <avr/pgmspace.h>

#include "prjtypes.h"

// --- Definitions -------------------------------------------------------------

// --- Type definitions --------------------------------------------------------

// --- Local variables ---------------------------------------------------------

// --- Global variables --------------------------------------------------------

const uint8_t gdisp_font1_x8[] PROGMEM = {
        0x09, 0x08, 0x08,
        0x05, 0x00, 0x00, 0x00, 0x00, 0x00, 0x00, 0x00, 0x00,  // Code for char
        0x01, 0x5F, 0x00, 0x00, 0x00, 0x00, 0x00, 0x00, 0x00,  // Code for char !
        0x03, 0x07, 0x00, 0x07, 0x00, 0x00, 0x00, 0x00, 0x00,  // Code for char "
        0x07, 0x10, 0x74, 0x1F, 0x14, 0x7C, 0x17, 0x04, 0x00,  // Code for char #
        0x05, 0x44, 0x4A, 0xFF, 0x52, 0x22, 0x00, 0x00, 0x00,  // Code for char $
        0x08, 0x04, 0x0A, 0x2A, 0x14, 0x08, 0x14, 0x2A, 0x28,  // Code for char %
        0x06, 0x36, 0x49, 0x49, 0x36, 0x28, 0x40, 0x00, 0x00,  // Code for char &
        0x01, 0x07, 0x00, 0x00, 0x00, 0x00, 0x00, 0x00, 0x00,  // Code for char '
        0x02, 0x7E, 0x81, 0x00, 0x00, 0x00, 0x00, 0x00, 0x00,  // Code for char (
        0x02, 0x81, 0x7E, 0x00, 0x00, 0x00, 0x00, 0x00, 0x00,  // Code for char )
        0x06, 0x00, 0x14, 0x08, 0x3E, 0x08, 0x14, 0x00, 0x00,  // Code for char *
        0x06, 0x00, 0x08, 0x08, 0x3E, 0x08, 0x08, 0x00, 0x00,  // Code for char +
        0x02, 0x80, 0x60, 0x00, 0x00, 0x00, 0x00, 0x00, 0x00,  // Code for char ,
        0x03, 0x10, 0x10, 0x10, 0x00, 0x00, 0x00, 0x00, 0x00,  // Code for char -
        0x02, 0x00, 0x60, 0x00, 0x00, 0x00, 0x00, 0x00, 0x00,  // Code for char .
        0x03, 0x60, 0x1C, 0x03, 0x00, 0x00, 0x00, 0x00, 0x00,  // Code for char /
        0x04, 0x3E, 0x41, 0x41, 0x3E, 0x00, 0x00, 0x00, 0x00,  // Code for char 0
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

// --- Local functions ---------------------------------------------------------

// --- Module global functions -------------------------------------------------

// --- Global functions --------------------------------------------------------

/** @} */
