irqmask/koewiba-domotic/(commit log)

2012-11-17 fixed testuart compile error.
    [bus_phy.c]
2012-11-18 fixed DDR configuration of RS486 driver
    [bus.h, bus_intern.h, bus_phy.c, bus_transport.c]
2012-11-18 - registerbit-defines inserted for differentiation between Atmega8 / Atmega88.
2012-11-18 new: - switch-on/off transmit-driver before/after sending. - global switch for listening on receiver while sending data.
2012-11-25 replaced tabs with spaces
    [bus.h, bus_intern.h, bus_phy.c]
2012-12-22 clock/timer module added
2012-12-22 - inserted compiler-switches for working with ATmega8/88.
2012-12-22 ATMega88 IRQ names corrected
    [bus_phy.c]
2012-12-22 restored broken code-parts from revision 383 to make software run.
    [bus_phy.c]
2012-12-22 moved led-functions to new created led_debug.c/h for using debug-led's in different projects.
2012-12-22 created led_debug.c/h for using debug-led's in different projects.
2012-12-26 - Comments added to debug code.\n- Added missing modules to makefiles.\n- Moved creation of scheduler (debug-)nodes to testscheduler code.\n- Fixed search for duplicate node numbers, when adding node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
    [roomthermostate.sch]
2012-12-29 - first version of discovery-scheduling. - LED-switching by using defines.
2013-02-23 code beautified. added device requirement file.
2013-03-08 Bugfix: Chaotic bus-messaging after sending a real message on the bus.
    [bus_schedul.c, bus_transport.c]
2013-03-29 bugfix in message storing.
    [bus_transport.c]
2013-03-29 Bugfix: receiving data-bytes causes busReset.
    [bus_transport.c]
2013-04-27 common shared schematics, buscom schematics and roomthermostate schematics added.
    [buscom.sch, buscom_mega32.sch, businterface.sch, roomthermostate.sch]
2013-04-27 added missing file of roomthermostate
    [businterface.sch]
2013-05-05 changed tracknames.
    [buscom.sch, buscom_mega32.sch, businterface.sch]
2013-05-05 added first draft of buscom-board.
    [buscom.brd]
2013-05-05 - footprint attiny1634 corrected. - elements fitting into octagonal board.
    [buscom.brd, buscom.sch, buscom_mega32.sch, businterface.sch]
2013-05-07 updated businterface
    [businterface.sch, roomthermostate.sch]
2013-05-13 Scaled down PCB-diameter for fitting in wall-hole.
    [buscom.brd]
2013-05-14 - updated roomthermostate schematics - added hardware README
    [businterface.sch, roomthermostate.sch]
2013-05-14 - added first version of netlist and component assignment
    [roomthermostate.brd]
2013-05-17 Buscom-hub serves for interconnecting two bus lines. On the primary line it is recognized as a bus-subscriber, on the second line as scheduler(master).
    [buscom-hub.brd, buscom-hub.sch]
2013-05-17 - footprint texts adjusted - gnd areas added
    [buscom-hub.brd, buscom.brd]
2013-05-17 aligned order of WAGO-connectors to comply with bus-connecting standard.
    [buscom-hub.brd, buscom-hub.sch]
2013-05-18 updated buscom and buscom-hub with fixed footprints
    [buscom-hub.brd, buscom.brd, roomthermostate.brd]
2013-07-06 further drawing of roomthermostate schematics and footprint selection
    [buscom-hub.brd, businterface.sch, roomthermostate.brd, roomthermostate.sch]
2013-08-30 - eeprom_spi, queue, spi, uart module added. - moved test... into tests directory - testspi, testasm, testbootloader added. - AVR Studio 6 project structure for tests added. Makefiles for GCC have to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
2013-08-30 Added description of fuse bytes and settings for koewiba domotic.
2013-09-02 Fixed register names in uart module
    [queue.h, uart.c, uart.h]
2013-09-12 - SPI uses now only symbol names from ucontroller.h - added atmega324 SPI registers to ucontroller.h - initial (untested) revision of graphical display driver module - folder structure and AVRStudio 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
2013-09-18 - added missing address operator
    [gdisplay.c]
2013-09-18 - fixed ucontroller.h for non-AVRStudio use - several tests in testbootloader1 done - make gdisplay functional - added missing moddefs_common.h
    [appconfig.h, bus.h, bus_phy.c, disp_st7565.c, gdisplay.c, gdisplay.h, main_roomthermostate.c]
2013-09-22 - prototype of roomthermostate display - bugfixes in gdisplay - new 16pixel symbol module added
    [gdisplay.c, gdisplay.h, gdisplay_symbols_x16.c, gdisplay_symbols_x24.c, main_roomthermostate.c]
2013-11-16 - clock: ticks in 16bit - added appconfig and pcbconfig
2013-11-16 - sleep command number fix
    [cmddef_common.h, main_roomthermostate.c]
2013-12-21 initial revision of koewibapi added
    [2relays.sch, koewibapi.brd, koewibapi.sch]
2013-12-22 new schematic symbols used
    [businterface.sch, roomthermostate.sch]
2013-12-29 Initial revision of layout of KOEWIBA-PI. Gerber files also added.
    [2relays.sch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]
2013-12-29 fixed mirrored drill plan
    [koewibapi-Kommentare.gbr, koewibapi-Lötstoppmaske - rückseitig.gbs, koewibapi-Lötstoppmaske - vorderseitig.gts, koewibapi-Platinenumrisse.gbr, koewibapi-Rückseite.gbl, koewibapi-Siebdruck - rückseitig.gbo, koewibapi-Siebdruck - vorderseitig.gto, koewibapi-Vorderseite.gtl]
2013-12-29 Updated Fuse description in Fuses.txt Cleanup of unused files comm.c, comm.h and systemtimer.h in taster8 project Description of registers and register commands updated. Implemented register commands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
2013-12-30 Schematic changes: - TXEN now on PD4 - Temperature sensor power is switchable - LCD Reset added - CS of EEP and LCD switched
    [businterface.sch, roomthermostate.sch]
2014-01-05 - Timer will be removed from timer-array at the same time it has zero-counted, so there is no gap between timer elapsed and timer removed. - Timer is retriggerable by now.
2014-01-05 Debug-LED defines moved here from led_debug.h.
2014-01-06 - fixed space issues in layout - L1 value changed
    [2relays.sch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]
2014-01-06 - moved function 'vInitLedAndKeys' into main-functions, because this is app- and pcb-dependent. - moved LED-defines into pcbconfig.h. - built special 'SPI_vMasterInitBlk' for ATtiny1634. - added defi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
2014-02-04 module PWM added. Unittest framefork and unittest for PWM added.
2014-03-04 initial revision of pwm module, pwm application and zagwire module
2014-03-05 added missing files of pwm-dimmer-3chn
    [appconfig.h, main_pwm-dimmer-3chn.c]
2014-03-08 New compiler-switches for working under Windows OS.
2014-03-08 Changes for establishing an optional second UART. This is a precondition for implementing the bushub-function.
2014-03-09 PWM testcode added to application
2014-03-23 - PWM module updated and tested. One remaining error, PWM is going only to 50% duty-cycle.
    [main_pwm-dimmer-3chn.c, pcbconfig.h, pwm.c, pwm.h]
2014-04-14 added processor-timing and TSIC calculations
    [PeripheralCalculations.ods]
2014-04-14 fixed PWM table and PWM demo-code in pwm-dimmer-3chn. TODO: make true 100% duty-cycle at PWM value of 255
    [main_pwm-dimmer-3chn.c, pwm.c]
2014-04-18 Fixed register names for atmega324
    [pcbconfig.h, ucontroller.h]
2014-04-18 Fixed obsolete BUS_TXRX_COMBINED. Use define TXRXEN0_SPERATE instead.
    [bus_phy.c]
2014-04-18 Scheduler uses bitmasks to mark present or missing modules on bus. scheduler_attiny1634 added initially.
    [appconfig.h, bus.h, bus_intern.h, bus_phy.c, bus_schedul.c, bus_transport.c, main_scheduler.c, pcbconfig.h]
2014-04-18 Switched pwm to timer 2. Fixed unittest of pwm module.
    [main_pwm-dimmer-3chn.c, pcbconfig.h, pwm.c, pwm.h, testpwm.c, ucontroller.h]
2014-04-18 fixed name for PRJCONF_APPLE
    [prjconf.h]
2014-04-18 PWM module runs currently with 16MHz.
2014-04-19 Changed function names to lower-case with underscores.
2014-04-19 - changed function names to lower-case with underscores. - Reduced nodeAnswerTimout to 50ms.
2014-04-19 Switch outputs off, when PWM is initialized.
2014-04-19 Bugfix in register.c Register and EEPROM enumerations of taster8 application implemented.
    [appconfig.h, application.c, application.h, appregister.c, register.c]
2014-04-19 Refactoring to lower-case. Applied register module changes to roomthermostate and pwm-dimmer-3chn application.
2014-04-19 Adapted unittest to new lower-case function-names.
2014-04-19 Defined TXRXEN0_SEPERATE for elector-pcb (bugfix for sending messages three times).
    [bus_transport.c, pcbconfig.h]
2014-09-02 Operating system independent library "libsystem" of socket, serial, event, time etc funtions added. Operating system architecture added to handle KWB connections and interprocess communication. Route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
2014-10-03 added timer functions
2014-10-03 Added perror() messages if sys_* functions fail. Implemented missing sys_socket_flush() and sys_socket_get_pending() functions.
    [bus_phy_os.c, vos.c]
2014-10-07 removed "#ifdef BUS_SCHEDULER" statements. bugfix in scheduler, which prevents sending a token to module with address 1.
    [bus.h, bus_schedul.c, bus_transport.c]
2014-10-08 - implement tcp socket open call for vbusd - return error code when opening a serial port failed
2014-10-16 led_debug adjusted to new coding style.
2014-11-29 Removed debug-LED defines.
2014-11-30 Bugfix of resending of not-acknowledged messages. (After inserting TX-queue)
    [bus.h, bus_transport.c]
2014-12-27 set revision to A
    [2relays.sch, koewibapi.sch]
2014-12-28 - Register 'UCSR0C' is used twice (in uart- and spi-mode) BIT_1 has different names (uart: UCPHA0 spi: UCSZ00). Because this is not included in "avr/iotn1634" it has to be defined in spi.h. - EEPROM-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
2014-12-28 Further developement of kwbrouter. First routing of messages function, but not enough debugged. known bug: sends messages to itself. Added sys_socket_get_name() to libsystem. Added handler for incomm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
    [message.h]
2015-01-17 New module 'testgateway232_atmega324' established for communication between computer's serial interface and koewiba-bus: - renamed queue's read and write pointers for better understanding what type t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
2015-01-18 error code enums reordered
    [message.h, vos.c]
2015-01-18 moved LED_ERROR_XXX defines to led_debug.h
2015-01-18 Added missing file 'queue.c'.
    [queue.c]
2015-01-18 SPI: implemented second SPI interface for controllers with two SPI interfaces Adopt other module to new SPI interface Coding guidelines party applied (where changes have been made) Moved LED_ERROR_XX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
2015-01-22 Device requirements added.
2015-01-25 - Added block commands for rejecting and resetting the block data transfer. - Added destination enums for block data. - Increased BUS_MAXSENDMSGLEN to 36 for block data transfer. - New functions 'clk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
    [bus.h, clock.c, clock.h, cmddef_common.h, main_gateway.c, pcbconfig.h, ucontroller.h]
2015-01-25 - correction in clock.c: assignment in if-clause. - correction in spi.h: too many parentheses in #define. - renamed sRecvMsg.uLength into sRecvMsg.length in testgateway232 to comply with 'bus.h'
    [clock.c, main_gateway.c, spi.h]
2015-01-26 - added destination type 'serial comm' for block data. - added element 'active' to timer structure for detecting, if timer is in use. - amended function q_put_byte() with queue-full check and return 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
2015-03-15 revision comments on kwbpi pcb
2015-03-29 Fixed port bit names
    [main_gateway.c]
2015-03-31 Coding guidelines applied to uart, eeprom_spi and testeeprom. Make testeeprom comilable again.
2015-04-03 UART module supports now two uarts.
2015-04-03 cleanup of spi and eeprom module.
2015-06-01 Initial revision of busphy_breadboard revision A
    [busphy_breadboard.kicad_pcb, busphy_breadboard.sch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]
2015-06-28 Pin specifications added.
2015-08-01 Software folders restructured. It is now better sorted between common files, avr files and os files. Makefiles adapted. Unused upload folder deleted.
    [PeripheralCalculations.ods]
2015-10-29 Initial revision of block_message module. Rework of testprotocol to support the block_message module. Codeing guidelines applied to clock module.
    [block_message.c, block_message.h, bus.h, clock.c, clock.h, crc16.c, crc16.h]
2015-11-01 bus-module_atmega324 initial revision. First prototypes will be manufactured in this revision -> Hardware Revision A
    [board_outline.dxf, board_outline_missing_left.dxf, bus-module_atmega324.kicad_pcb, bus-module_atmega324.sch]
2015-11-01 bus-module_atmega328 initial revision. First prototypes will be manufactured in this revision -> Hardware Revision A
    [bus-module_atmega328.kicad_pcb, bus-module_atmega328.sch]
2015-11-01 bus-module_attiny1634 initial revision. First prototypes will be manufactured in this revision -> Hardware Revision A
    [bus-module_attiny1634.kicad_pcb, bus-module_attiny1634.sch]
2015-11-01 gateway_usb module initial revision. First prototypes will be manufactured in this revision -> Hardware Revision A
    [gateway_usb.kicad_pcb, gateway_usb.sch]
2015-11-01 Gerber files of: bus-module_atmega324 bus-module_atmega328 bus-module_attiny1634 gateway_usb
    [bus-module_atmega324-B_Cu.gbr, bus-module_atmega324-B_Mask.gbr, bus-module_atmega324-B_SilkS.gbr, bus-module_atmega324-Edge_Cuts.gbr, bus-module_atmega324-F_Cu.gbr, bus-module_atmega324-F_Mask.gbr, bus-module_atmega324-F_SilkS.gbr, bus-module_atmega324.drl]
2015-11-01 Added missing library files. Cleanup of schematic library paths.
2015-11-01 Don't ignore .lib files (needed in kicad) Ignore Eclipse's .metadata. Ignore every file marked with _old
2015-11-01 Templates for PCB outlines.
    [front_panel_for_60mm_wall_inlet.kicad_pcb, in_wall_pcb_50mm.kicad_pcb]
2015-11-21 BOMs for bus-module_attiny1634, bus-module_atmega328, bus-module_atmega324 and gateway_usb added.
    [bus-module_atmega324_bom.csv, bus-module_atmega328_bom.csv, bus-module_attiny1634_bom.csv, gateway_usb_bom.csv]
2015-12-06 - Added standard pin assignment for ATMega328
2015-12-06 Added Fuses for ATTiny1634
2015-12-06 - Refactoring of led_debug module - Cleanup of pcbconfig files
2015-12-06 Bugfix of ATTiny1634 and ATMega328 SPI
    [spi.h]
2015-12-06 Cleanup unused files
    [roomthermostate.brd]
2015-12-06 - Changed polarity of LEDs in led_debug module. µC is sink. Connect LEDs from VCC to µC - Bugfixed version of test_eeprom. - Message is sent after EEProm test.
    [led_debug.h]
2015-12-06 Use bus-module_atmega328 instead of single atmega324 controller.
    [businterface.sch, roomthermostate.sch]
2015-12-06 Initial revision of roomthermostate board outline
    [roomthermostate.kicad_pcb]
2015-12-06 Start of development of Rev. B: - integrated fuse for 24V supply. - new footprint SOT143 for TVS-Diode. - replaced TVS-Diode footprint by SOT143. - added revision text on copper layer.
    [bus-module_atmega324.kicad_pcb, bus-module_atmega324.sch, bus-module_atmega328.kicad_pcb, bus-module_atmega328.sch, bus-module_attiny1634.kicad_pcb, bus-module_attiny1634.sch]
2016-01-17 - updated fuse settings for attiny1634
2016-03-13 bugfixes in bootloader and block-message protocol. CRC algorithms changed due to size issues in bootloader. First working version of firmware download to an atmega328!!!
    [block_message.c, crc16.c, crc16.h, pcbconfig.h]
2016-03-24 Simplify switching of separate RS485 sned and receive enables
2016-03-24 Make bootloader debug-code switchable ON/OFF by switch DEBUG_LED_OUTPUT
2016-03-24 Added port/pin defines for debug output
2016-03-24 file header documentation fixed
    [appconfig.h, appregister.c, appversion.c]
2016-03-25 printf's replaced with log_msg(), log_error(), log_sys_error() and log_warning().
    [log.c, log.h, message.c]
2016-05-18 Added initial files
    [motor_switch_3pole.kicad_pcb, motor_switch_3pole.sch]
2016-05-19 - replaced bool with BOOL in all OS code (not yet in AVR code) - make kwbfirmware and libsystem compilable the windows portion of the code still has to be implemented in libsystem and ioloop!
    [bus_phy_os.c, bus_transport.c, ioloop.c, ioloop.h]
2016-05-31 Make code C99 compatible and use stdbool.h Replace all BOOL, FALSE, TRUE occurances with bool, false, true.
    [application.h, appregister.c, block_message.c, block_message.h, bus_gateway.c, bus_gateway.h, bus_phy.c, bus_scheduler.h]
2016-06-20 changed to SMD components
    [motor_switch_3pole.kicad_pcb, motor_switch_3pole.sch]
2016-09-05 motor control 3pole layouted and ready for review
    [bus_atmega328_basic.sch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]
2016-09-28 Final revision 1 files of motor_switch_3pole added. Prototype PCBs of this revision have been ordered
    [bus_atmega328_basic.sch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]
2016-10-05 Added missing solder-stop-masks
    [motor_switch_3pole-B.Mask.gbr, motor_switch_3pole-F.Mask.gbr]
2016-10-11 - Added unit-tests (currently for systhread and systime) (need external CUnit library) - Set C/C++ standard to 11 - use strnlen instead of strnlen_s because MinGW doesn't support strnlen_s - added ge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
2016-10-15 Add hint for devicename on windows kwbmonitor: recognize ACK bytes kwbmonitor: fixed "negative timestamp" bug.
2016-10-15 Fixed check of invalid file descriptors
    [vos.c]
2016-10-15 don't compile unittests under linux. 64bit CUnit seems currently not to be available under Kubuntu 14.04.
2016-10-15 fixed call to register_do_command changed LED PCBConfig from MAsk to Index
    [main_roomthermostate.c, pcbconfig.h]
2016-12-03 Errata for revision 1 pcb added
2016-12-03 Backup of revision 1 schematic and gerber files
    [motor_switch_3pole-B.Cu.gbr, motor_switch_3pole-B.Mask.gbr, motor_switch_3pole-B.SilkS.gbr, motor_switch_3pole-Dwgs.User.gbr, motor_switch_3pole-Edge.Cuts.gbr, motor_switch_3pole-F.Cu.gbr, motor_switch_3pole-F.Mask.gbr, motor_switch_3pole-F.SilkS.gbr]
2016-12-03 Fixed relay pinout bug
    [bus_atmega328_basic.sch, motor_switch_3pole.csv, motor_switch_3pole.kicad_pcb, motor_switch_3pole.sch]
2016-12-03 Initial revision of blind control software. First simple test functionality: Button up issues motor to drive up. Button down issues motor to drive down.
    [appconfig.h, application.c, appregister.c, appversion.c, datetime.c, datetime.h]
2016-12-03 Motor logic
2016-12-06 Initial revision of pi2-base pcb
    [2relays.sch, 4inputs.sch, dcdc.sch, pi2-base.kicad_pcb, pi2-base.sch, rtc.sch]
2016-12-11 pi2-base revision 1 (prototypes ordered)
    [2relays.sch, 4inputs.sch, dcdc.sch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]
2016-12-23 replaced TRUE/FALSE with true/false
    [application.c, appregister.c]
2016-12-23 - cleanup registers - debounce and edge detection implemented for inputs - motor statemachine implemented
2016-12-23 fixed clock parameters. now clock has 10ms interval.
    [clock.c]
2016-12-23 fixed CLOCK_MS_2_TICKS makro. Now supporting times > 655ms
    [clock.h]
2017-01-14 reverse byte order of register commands
    [register.c]
2017-01-14 Increased number of timers to 5. Get elapsed ticks and get inital tick count functions added.
2017-01-14 first working version of blindcontrol (clock.h was missing)
    [clock.h]
2017-02-06 Gerber files of revision 2 of motor_switch_3pole.
    [motor_switch_3pole-B.Cu.gbr, motor_switch_3pole-B.Mask.gbr, motor_switch_3pole-B.SilkS.gbr, motor_switch_3pole-Dwgs.User.gbr, motor_switch_3pole-Edge.Cuts.gbr, motor_switch_3pole-F.Cu.gbr, motor_switch_3pole-F.Mask.gbr, motor_switch_3pole-F.SilkS.gbr]
2017-02-10 Changed resistor values from 56k/100k to 10k/18k of voltage divider of TXD and CTS
    [pi2-base.csv, pi2-base.kicad_pcb, pi2-base.sch]
2017-02-10 Reverted rescue lib
    [pi2-base.sch]
2017-02-10 SPI resistors changed from 1k to 100
    [bus-module_atmega324.kicad_pcb, bus-module_atmega324.sch, bus-module_atmega324_bom.csv, bus-module_atmega328.kicad_pcb, bus-module_atmega328.sch, bus-module_atmega328_bom.csv, bus-module_attiny1634.kicad_pcb, bus-module_attiny1634.sch]
2017-02-11 Fixed missing definition of CLOCK_NUM_TIMER. (Might happened during emrging)
    [clock.h]
2017-02-11 Added common howto for software related topics (raspberry etc.)
2017-02-12 Updated schematic PDFs to current schematic version
2017-02-27 bugfix: fill extended address byte correctly with own address when sending messages
    [bus_transport.c]
2017-02-27 bugfix: set correct extended address byte when sending
    [bus_gateway.c]
2017-03-13 Prevent going to sleepmode. Fix integer overflow in blindctrl.c
    [blindctrl.c, motor.c]
2017-03-13 Prevent sleepmode function added
    [appconfig.h, sleepmode.c, sleepmode.h]
2017-03-13 blind-control: 100% means now fully closed blind, 0% means full open blind. Integer overflow error fixed when times are calculated. When blind position is unknown, assume 50%=set-point=current positi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
    [appconfig.h, appversion.c, blindctrl.c]
2017-03-26 Bugfix of versioninfo registers and answer_register_request
    [appversion.c, main_gateway.c, main_roomthermostate.c, main_scheduler.c, moddef_common.h, register.c]
2017-04-14 fixed kwbtest: msg_s_set_close..handler( need endpoint instead of socket structure
2017-04-14 Automatically creae unix sockets file
2017-09-06 Fix kwbmqttgateway 99%CPU usage
    [ioloop.c, ioloop.h]
2017-11-01 added koewiba specific log masks changed all status-/error-output from stdout to stderr used log module where applicable
    [log.h, message.c]
2018-03-28 Fixed AVR build for 1.8.0+Atmel3.5.0-1
    [ucontroller.h]
2018-03-30 added multiple blind support. single blindcontrol software adjusted accordingly. date and time module added. added register documentation for blind-control
    [RegisterOverview.ods]
2018-03-30 Initial revision of blind-control_5+4 Bugfix "blindctrl is not sending SetPointRegister"
    [appconfig.h, application.c, appregister.c, appversion.c, blindctrl.c, pcbconfig.h]
2018-03-31 Fixed old TODO: check whole node address not only the lower byte.
    [appversion.c, bus_transport.c]
2018-03-31 Hardware PCB layout of pushbutton8 revision 1
    [pushbutton8.kicad_pcb, pushbutton8.sch]
2018-03-31 pushbutton8 software initial working demo version with fixed receiver and commands
    [appconfig.h, application.c, application.h, appregister.c, pcbconfig.h]
2018-05-14 Renamed module clock into timer
2018-05-14 Added date and time functionality to blind-control and blind-control5+4 application Added mode-register to blind-control and blind-control5+4 application (currently unused)
    [RegisterOverview.ods]
2018-06-07 Feat: Add alarmclock and datetime module to blind-control_atmega328p. Feat: Add registers for alarmclock and datetime module's configuration Fix: Only move blinds on alarmclock events when blinds are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
    [RegisterOverview.ods]
2018-06-07 Feat: Add PCB for controller for 5 blinds
    [bus_atmega328_basic.sch, inputs.sch, motor_relays.sch, motor_switch_3pole_5x.kicad_pcb, motor_switch_3pole_5x.sch]
2018-06-13 Fix: Size of vias and DRC issues
    [motor_switch_3pole_5x.kicad_pcb]
2018-06-13 Feat: Add motor mode configuration
2018-06-13 Feat: Initial revision of bus-splitter PCB
    [bus-splitter.kicad_pcb, bus-splitter.sch]
2018-06-13 Fix: Silkscreen jumper description Fix: Relay pinout
    [2relays.sch, 4inputs.sch, dcdc.sch, pi2-base.kicad_pcb, pi2-base.sch, rtc.sch]
2018-06-13 Move: old rev 1 gerber files
    [pi2-base-B.Cu.gbr, pi2-base-B.Mask.gbr, pi2-base-B.SilkS.gbr, pi2-base-Dwgs.User.gbr, pi2-base-Edge.Cuts.gbr, pi2-base-F.Cu.gbr, pi2-base-F.Mask.gbr, pi2-base-F.SilkS.gbr]
2018-06-13 Del: Moved to Rev1 folder
    [pi2-base-B.Cu.gbr, pi2-base-B.Mask.gbr, pi2-base-B.SilkS.gbr, pi2-base-Dwgs.User.gbr, pi2-base-Edge.Cuts.gbr, pi2-base-F.Cu.gbr, pi2-base-F.Mask.gbr, pi2-base-F.SilkS.gbr]
2018-06-24 Fix: Update timestamp of kicad project
2018-06-24 Del: Old roomthermostat
    [roomthermostate.kicad_pcb, roomthermostate.sch]
2018-06-24 Feat: Initial revision of roomthermostat PCB
    [roomthermostat.kicad_pcb, roomthermostat.sch]
2018-08-30 Moved motor connectors to avoid THT pad touching the housing
    [motor_switch_3pole_5x.kicad_pcb]
2018-09-18 added LEDs and testpoints to PCB
    [bus_atmega328_basic.sch, inputs.sch, motor_relays.sch, motor_switch_3pole_5x.kicad_pcb, motor_switch_3pole_5x.sch]
2018-09-19 updated 3d footprints created schematic and gerber files
    [motor_switch_3pole_5x-B.Cu.gbr, motor_switch_3pole_5x-B.Mask.gbr, motor_switch_3pole_5x-B.SilkS.gbr, motor_switch_3pole_5x-Cmts.User.gbr, motor_switch_3pole_5x-Dwgs.User.gbr, motor_switch_3pole_5x-Edge.Cuts.gbr, motor_switch_3pole_5x-F.Cu.gbr, motor_switch_3pole_5x-F.Mask.gbr]
2018-09-19 created 3d images, schematics and gerber files for roomthermostat
    [roomthermostat-B.Cu.gbr, roomthermostat-B.Mask.gbr, roomthermostat-B.SilkS.gbr, roomthermostat-Cmts.User.gbr, roomthermostat-Dwgs.User.gbr, roomthermostat-Edge.Cuts.gbr, roomthermostat-F.Cu.gbr, roomthermostat-F.Mask.gbr]
2018-09-23 bus-module_atmega328 update to rev B
    [bus-module_atmega328-B.Cu.gbr, bus-module_atmega328-B.Mask.gbr, bus-module_atmega328-B.Paste.gbr, bus-module_atmega328-B.SilkS.gbr, bus-module_atmega328-Cmts.User.gbr, bus-module_atmega328-Dwgs.User.gbr, bus-module_atmega328-Edge.Cuts.gbr, bus-module_atmega328-F.Cu.gbr]
2018-09-23 make roomthermostat compatible to bus-module_atmega328 rev A and rev B
    [roomthermostat-B.Cu.gbr, roomthermostat-B.Mask.gbr, roomthermostat-B.SilkS.gbr, roomthermostat-Cmts.User.gbr, roomthermostat-Dwgs.User.gbr, roomthermostat-Edge.Cuts.gbr, roomthermostat-F.Cu.gbr, roomthermostat-F.Mask.gbr]
2018-09-23 deleted obsolete files
    [businterface.sch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]
2018-09-23 added bus-module_atmega324 rev B
    [bus-module_atmega324-B.Cu.gbr, bus-module_atmega324-B.Mask.gbr, bus-module_atmega324-B.SilkS.gbr, bus-module_atmega324-Cmts.User.gbr, bus-module_atmega324-Dwgs.User.gbr, bus-module_atmega324-Edge.Cuts.gbr, bus-module_atmega324-F.Cu.gbr, bus-module_atmega324-F.Mask.gbr]
2018-09-24 changed 3,3V net to VCC net changed silkscreen description of pins removed need of rescue lib
    [bus-module_atmega324-B.Cu.gbr, bus-module_atmega324-B.Mask.gbr, bus-module_atmega324-B.SilkS.gbr, bus-module_atmega324-Cmts.User.gbr, bus-module_atmega324-Dwgs.User.gbr, bus-module_atmega324-Edge.Cuts.gbr, bus-module_atmega324-F.Cu.gbr, bus-module_atmega324-F.Mask.gbr]
2018-09-24 fixed silkscreen pinout description for 24V pins
    [bus-module_atmega328-B.Cu.gbr, bus-module_atmega328-B.Mask.gbr, bus-module_atmega328-B.Paste.gbr, bus-module_atmega328-B.SilkS.gbr, bus-module_atmega328-Cmts.User.gbr, bus-module_atmega328-Dwgs.User.gbr, bus-module_atmega328-Edge.Cuts.gbr, bus-module_atmega328-F.Cu.gbr]
2018-09-24 initial revision of bus-module_attiny1634 revB. not checked yet
    [bus-module_attiny1634.kicad_pcb, bus-module_attiny1634.sch]
2018-09-24 Renamed Rev2 -> RevB Updated 3d footprints Replaced busmodule RevA with RevB symbol
    [2relays.sch, 4inputs.sch, dcdc.sch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]
2018-09-24 removed old and unused gerber files
    [pi2-base-B.Cu.gbr, pi2-base-B.Mask.gbr, pi2-base-B.SilkS.gbr, pi2-base-Dwgs.User.gbr, pi2-base-Edge.Cuts.gbr, pi2-base-F.Cu.gbr, pi2-base-F.Mask.gbr, pi2-base-F.SilkS.gbr]
2018-09-24 remove old, unused BOM
    [pi2-base.csv]
2018-09-25 Finalized revB of bus-module_attiny1634
    [bus-module_attiny1634-B.Cu.gbr, bus-module_attiny1634-B.Mask.gbr, bus-module_attiny1634-B.SilkS.gbr, bus-module_attiny1634-Cmts.User.gbr, bus-module_attiny1634-Dwgs.User.gbr, bus-module_attiny1634-Edge.Cuts.gbr, bus-module_attiny1634-F.Cu.gbr, bus-module_attiny1634-F.Mask.gbr]
2018-09-26 Changed motor_switch_3pole revision from 1 to A Updated §D images Updated gerber files Created BOM and component placement drawings
    [motor_switch_3pole_5x-B.Cu.gbr, motor_switch_3pole_5x-B.Mask.gbr, motor_switch_3pole_5x-B.SilkS.gbr, motor_switch_3pole_5x-Cmts.User.gbr, motor_switch_3pole_5x-Dwgs.User.gbr, motor_switch_3pole_5x-Edge.Cuts.gbr, motor_switch_3pole_5x-F.Cu.gbr, motor_switch_3pole_5x-F.Mask.gbr]
2018-09-26 changed revision 1 to revision A
    [bus_atmega328_basic.sch, inputs.sch, motor_relays.sch]
2018-09-26 set correct revision to B
    [2relays.sch, 4inputs.sch, dcdc.sch, rtc.sch]
2018-10-04 changed pushbuttons of roomthermostate
    [roomthermostat-B.Cu.gbr, roomthermostat-B.Mask.gbr, roomthermostat-B.SilkS.gbr, roomthermostat-Cmts.User.gbr, roomthermostat-Dwgs.User.gbr, roomthermostat-Edge.Cuts.gbr, roomthermostat-F.Cu.gbr, roomthermostat-F.Mask.gbr]
2018-10-24 Fixed PCB: Removed copper logo
    [motor_switch_3pole_5x-B.Cu.gbr, motor_switch_3pole_5x-B.Mask.gbr, motor_switch_3pole_5x-B.SilkS.gbr, motor_switch_3pole_5x-Cmts.User.gbr, motor_switch_3pole_5x-Dwgs.User.gbr, motor_switch_3pole_5x-Edge.Cuts.gbr, motor_switch_3pole_5x-F.Cu.gbr, motor_switch_3pole_5x-F.Mask.gbr]
2018-12-27 Update to revision B. Fixed footprint of U4
    [bus_atmega328_basic.sch, inputs.sch, motor_relays.sch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]
2019-01-01 Fix broken data structure. WIP!
    [motor.c]
2019-01-02 add roomthermostate test application.
    - test eeprom
    - test display
    - test zagwire temperature sensor
    - test buttons
2019-01-02 Fix compile errors. Still not compiling. needs changes from branch kwbrouter
    [appregister.c, disp_sh1106.c, disp_sh1106.h, zagwire.c]
2019-01-02 Add missing declaration of app_versioninfo
    [appconfig.h]
2019-02-03 Extracted sn74595 code from ledskeys
2019-02-03 removed obsolete files after merge
    [bus-module_atmega324-B_Cu.gbr, bus-module_atmega324-B_Mask.gbr, bus-module_atmega324-B_SilkS.gbr, bus-module_atmega324-Edge_Cuts.gbr, bus-module_atmega324-F_Cu.gbr, bus-module_atmega324-F_Mask.gbr, bus-module_atmega324-F_SilkS.gbr, bus-module_atmega324.drl]
2019-02-03 R2, R3, R4 100 Ohms
    [bus-module_atmega324.kicad_pcb, bus-module_atmega324_bom.csv, bus-module_atmega328.kicad_pcb, bus-module_atmega328.sch, bus-module_atmega328_bom.csv, bus-module_attiny1634.kicad_pcb, bus-module_attiny1634.sch, bus-module_attiny1634_bom.csv]
2019-02-08 temporarily checked in. eeprom_spi and test_eeprom_and propably test need rework!
    [application.c, eeprom_spi.c]
2019-02-18 Use serial device and baudrate given in options
2019-02-20 EEPROM timeout only 8bit Fix EEPROM test: check return-code of eep_read and eep_write Main: Display and send EEPROM test result only once.
    [eeprom_spi.c, zagwire.h]
2019-02-20 PIN assignment for revision B. Additionally drive reset pin of display.
2019-02-20 set board id, app id , board revision and app version
2019-03-05 Change pin-assignment of display and temp.sensor
    * bumped revision to rev B
    [roomthermostat-B.Cu.gbr, roomthermostat-B.Mask.gbr, roomthermostat-B.SilkS.gbr, roomthermostat-Cmts.User.gbr, roomthermostat-Dwgs.User.gbr, roomthermostat-Edge.Cuts.gbr, roomthermostat-F.Cu.gbr, roomthermostat-F.Mask.gbr]
2019-03-07 Increase WAGO hole diameter, replace ELKO with keramic capacitor, Increase WAGO hole diameter, update footprints, add pull-down to BUSTXEN, update footprints, set Rev to C
    [bus-module_atmega324-B.Cu.gbr, bus-module_atmega324-B.Mask.gbr, bus-module_atmega324-B.SilkS.gbr, bus-module_atmega324-Cmts.User.gbr, bus-module_atmega324-Dwgs.User.gbr, bus-module_atmega324-Edge.Cuts.gbr, bus-module_atmega324-F.Cu.gbr, bus-module_atmega324-F.Mask.gbr]
2019-03-07 Increase WAGO hole diameter, replace ELKO with keramic capacitor, Increase WAGO hole diameter, update footprints, update footprints, set Rev to C
    [bus-module_atmega328-B.Cu.gbr, bus-module_atmega328-B.Mask.gbr, bus-module_atmega328-B.Paste.gbr, bus-module_atmega328-B.SilkS.gbr, bus-module_atmega328-Cmts.User.gbr, bus-module_atmega328-Dwgs.User.gbr, bus-module_atmega328-Edge.Cuts.gbr, bus-module_atmega328-F.Cu.gbr]
2019-03-07 Increase hole diameter of WAGO243 connector by 0.1mm
    [board_outline.dxf, board_outline_missing_left.dxf, bus-module_atmega328_pin-assignment_for_switches_3pole_5x.ods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]
2019-03-24 Add installation notes for Raspberry Pi
2019-04-17 Bugfix: Send year as 16bit register value
    [appregister.c, appversion.c]
2019-04-19 Fix sleepmode for wall clock.
    Add new preprocessor define TIMER_WAKEUP which controlls if the timer
    may wake the controller. This is needed if a wall-clock or
    similar is driven by the timer and needs
    cyclic calls.
    [appconfig.h, bus_transport.c, main_avr.c, sleepmode.c, sleepmode.h, timer.c, timer.h]
2019-04-19 Increased version after bugfix in sleepmode
    [appversion.c]
2019-04-19 Wallclock stops when controller goes into sleepmode; refs #2
    Fix issue that module does not receive messages after sleepmode
    [bus_gateway.c, bus_transport.c, main_avr.c, main_gateway.c]
2019-04-19 Wallclock stops when controller goes into sleepmode; refs #2
    Remove switching debug LED during sleepmode
2019-04-19 Wallclock stops when controller goes into sleepmode; refs #2
    Apply sleepmode changes to scheduler
    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
2019-04-20 Reduce kwbmonitor print width
2019-07-06 Fix EEProm write. This fixes also firmware update functionality
    [block_message.c, bus.h, bus_transport.c, cmddef_common.h, crc16.c, crc16.h, eeprom_spi.c]
2019-10-30 cleanup unfinished projects pushbutton8 and blindcontrol_5x
    [bus-module_atmega328_pin-assignment_for_switches_3pole_5x.ods, bus_atmega328_basic.sch, inputs.sch, motor_relays.sch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]
2019-10-30 Add led 2two channel controller application skeleton
2019-10-30 Initial working version of LED2CHN application
2019-10-30 Prevent module from going to sleep. (Workaround)
    [application.c]
2019-10-30 Add led2_atmega324p project to global build list
2019-10-30 initial version of pushbutton8 hw and sw
    [pushbutton8.kicad_pcb, pushbutton8.sch]
2019-12-08 Add description to prepare a raspberry pi.
2019-12-22 Initial revision of router for TCP sockets
2019-12-22 Fix TCP/IP socket server
2019-12-28 Fix assertion. Graceful degradation when a socket connection fails to establish
2020-01-18 bugfix on led pin assignment and wake-up on keypress.
    [application.c, main_avr.c, pcbconfig.h, sleepmode.c, spi.h]
2020-01-18 preserved revision A schematic
2020-01-18 Added first iteration of rev B - usable with Reb B and newer bus-modules which have 24V on header
    [pushbutton8.kicad_pcb, pushbutton8.sch]
2020-01-21 Fix ioloop timer reload
    [ioloop.c]
2020-01-26 ioloop: fix timer rollover bug kwbmqttgateway: re-connect when connection lost added API documentation
    [ioloop.c]
2020-03-19 Fix window state register number
    [RegisterOverview.ods]
2020-03-27 Update register layout of led2_atmega324
    Split intensity setpoint, current intensity and saved intensity
    [RegisterOverview.ods]
2020-04-12 insert page breaks to improve printed version
2020-05-05 Add hardware doc drafts and sw drawings
    [PinningLists.ods]
2020-10-11 Fix logging of strings, catching exceptions, kwbtest sends 1 message Fix syssocket unix socket
    [exceptions.h]
2020-10-14 apply astyle code formatting
    [astyle.cfg]
2020-10-21 Document code and APIs, Fix doxygen warnings
    The components include, kwbrouter, libkwb, libsystem, kwbtest and
    unittests have been documented.
    [connection_serial.h, connection_socket.h, log.h, message.h]
2021-03-03 Feat: Initial revision of switch_3pole_5x PCB
    [bus_atmega328_basic.sch, inputs.sch, relays.sch, switch_3pole_5x.kicad_pcb, switch_3pole_5x.sch]
2021-03-03 Feat: Update kicad project file
2021-03-03 Moved connectors towards inner board to avoid TH pads touching housing
    [switch_3pole_5x.kicad_pcb]
2021-03-03 Added LED and testpoints
    [bus_atmega328_basic.sch, inputs.sch, relays.sch, switch_3pole_5x.sch]
2021-03-03 added testpoints and LEDs updated 3d footprints
    [relays.sch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]
2021-03-03 added soldermask gerber files (other filed changed due to timestamps)
    [switch_3pole_5x-B.Cu.gbr, switch_3pole_5x-B.Mask.gbr, switch_3pole_5x-B.SilkS.gbr, switch_3pole_5x-Cmts.User.gbr, switch_3pole_5x-Dwgs.User.gbr, switch_3pole_5x-Edge.Cuts.gbr, switch_3pole_5x-F.Cu.gbr, switch_3pole_5x-F.Mask.gbr]
2021-03-03 fixed switch_3pole_5x library references added component placement drawings updated 3d images and gerber files
    [bus_atmega328_basic.sch, inputs.sch, relays.sch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]
2021-03-03 Update to revision B. Fix footprint of U4 (TQFP32)
    [bus_atmega328_basic.sch, inputs.sch, relays.sch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]
2021-03-03 Increase hole diameter of WAGO243 connectors by 0.1mm
    [switch_3pole_5x-B.Cu.gbr, switch_3pole_5x-B.Mask.gbr, switch_3pole_5x-B.SilkS.gbr, switch_3pole_5x-Cmts.User.gbr, switch_3pole_5x-Dwgs.User.gbr, switch_3pole_5x-Edge.Cuts.gbr, switch_3pole_5x-F.Cu.gbr, switch_3pole_5x-F.Mask.gbr]
2021-03-03 sort BOM by reference
    [switch_3pole_5x_bom.csv]
2021-03-03 add switch5 test firmware
2021-03-03 add switch5 register layout
    [RegisterOverview.ods]
2021-03-03 initial version of switch5 firmware
2021-03-10 moved relay switching into new output module
    add license texts
    implement first register setter/getter
    [RegisterOverview.ods]
2021-03-20 Implemet alarm timer to switch on/off
    [RegisterOverview.ods]
2021-04-02 Fix motor - pin assignment
    [appconfig.h, application.c, application.h, appregister.c, appversion.c, output.c, output.h, pcbconfig.h]
2021-04-07 kwbfirmware: Add ability to use socket connection via kwbrouter
2021-04-30 Fix mixed up/down keys in blindcontrol
    [application.c]
2021-06-20 Fix setting day of week.
    [datetime.c]
2021-07-23 Send current intensity if led finishes changing
2021-07-23 send setpoint when buttun switched on or off
2021-11-26 Set brownout reset level for atmega324
    EEProm content only of atmega324 modules got corrupted form time to time.
    According to "the internet", a unstable power supply (e.g. caused by bouncing when switchin on/off) could be the root cause.
2021-12-20 Added ATmega328pb and ATmega324pa to the compiler switches.
2021-12-20 Intermediate status with fixed message table to send the correct message when a key is pressed.
    [application.c]
2021-12-20 Add calculation documentation for zagwire protocol.
    [PeripheralCalculations.ods]
2021-12-20 Change zagwire protocol to interrupt driven zagwire receiving
2021-12-20 Add initial version of roomthermostat
    * Moved inputs.* from blindcontrol to shared
    * Measure temperature, send and display it
    * Change desired temperatur on keypress
2021-12-20 Enable tsic temperature sensor
2021-12-20 switch up/down buttons
2021-12-20 dim display after 10s, switch off after 60s
2021-12-20 clear frame error flag if it occurs
    [bus_phy.c]
2021-12-20 Zagwire: sample pulses in interrupt routine, evaluate in non-irq context
    The negative pulse times of the 20 bits of the zagwire packet are recorded in the interrupt,
    but evaluated later in the application. This leads to improved error detection. During testing we had 0 gliches in ~30mins.
    It is not possible to reduce the error rate to zero due to the high interrupt activity in the bus-module, which disturbs the input capture timer interrupt.
    If the error rate is considered too high later, a different sensor with an "AVR-friendly" and KWB friendly
    protocol needs to be selected.
    [PeripheralCalculations.ods]
2021-12-20 add functions to draw temperature
2021-12-20 define registers for roomthermostate
    [RegisterOverview.ods]
2021-12-20 add vacation mode and react to remote messages of window open/close states
    [RegisterOverview.ods]
2021-12-20 fix switching between vacation mode and window open state
    [application.c, appregister.c]
2022-01-28 Add initial heatervalve schematics and pin assignment (work in progress)
    [bus_atmega328_basic.sch, heatervalve.kicad_pcb, heatervalve.sch, pinassignment.ods]
2022-02-20 first complete draft of heatervalve schematic
    [bus_atmega328_basic.sch, heatervalve.kicad_pcb, heatervalve.sch, pinassignment.ods]
2022-04-09 Add heatervalve schematic
    [bus_atmega328_basic.sch, heatervalve.sch]
2022-04-21 add initial application for heatervalve attiny1634 firmware
    * currently no functionality implemented
2022-04-21 add initial stm8 heatervalve application
    * command interpreter
    * motor initialization and movement to position
    * peek / poke commands for debugging purposes
2022-04-21 remove debug output in motor component
2022-04-21 Initial version of blindcontrol for 5 blinds
    [bus_atmega328_basic.sch, inputs.sch, motor_relays.sch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]
2022-04-21 Initial version of test software for motor switch 5x
2022-04-21 Add initial revision blindcontrol for 5 motors controlled over sn74595
2022-04-21 Add blind-control_5x and test_motor_switch_5 to buildall script Set correct versions for blind-control_5x and test_motor_switch_5
    [appconfig.h, application.c, appregister.c, appversion.c, moddef_common.h, pcbconfig.h]
2022-04-21 add command srt to set remotely measures temperatures
2022-04-22 add simple proportional regulation ouput motorposition at end of movement
2022-04-22 Add registers to configure remote temperature sensors Forward current temperature and temperature setpoint to stm8
2022-04-22 add temperature offset to given temperature
2022-04-22 heatervalve stm8: debug messages begin with #
2022-04-22 heatervalve_gateway: add register for debugger receiver module id
2022-04-22 heatervalve: add register to set kp and forward it to the stm8
2022-10-03 Fix mixup of blindcontrol input keys
    [application.c]
2022-10-09 fix kwbfirmware, reset and receive bootloader flags correctly
    * make sure kwbfirmware only reacts to messages from module which is currently updated
    * reset flag if bldflags have been received befor sending request message
    * (minor bug) reset unused bootloader flag in bootloader
2022-10-09 Add motor_switch_3pole pcb component drawings
2022-10-10 Automatically generate version.h for package
    * version information will be used during compiling software and firmware components.
    * it became to cumbersome to set version for each component manually and seperately. It is most important to track versions within an installation. It is not so important when each version changed in the repository.
2022-11-27 roomthermostate: validate desired temperature value received over bus
2022-12-10 Load Module layout file in JSON format and write value file after backup
    * no values are currently read from the module. Only the layout file is read and the values file is written
2022-12-10 Implemented reading register values file
    Writing register values is already implemented, too. But it is currently disabled and untested.
2022-12-18 register / backup work in progress
    [RegisterOverview.ods]
2022-12-18 switch5: every timer has a setpoint
    no extra timer to switch on or off
2022-12-19 Roomthermostat: Add timer to set temperature at certain times a day
2022-12-19 Update roomthermostate register layout
    [RegisterOverview.ods]
2023-10-12 New hw pushbutton8 rev.3: New KiCAD file types and PCB
    - PCB with ground planes instead of unconnected copper islands.
    - Update to KiCAD 6 file format.
    - Reorganization of PDF files (rev1..3 preproduction, revA will be the first official).
    [pushbutton8.kicad_pcb, pushbutton8.kicad_sch, pushbutton8.sch]
2023-10-13 add better front panel with wall inlets and arced holes
    [front_panel_for_60mm_wall_inlet2.kicad_pcb]
2023-10-13 Update to KiCAD6: bus-module_atmega324
    [bus-module_atmega324.kicad_pcb, bus-module_atmega324.kicad_sch, bus-module_atmega324.sch]
2023-10-13 Update to KiCAD6: bus-module_atmega328
    [bus-module_atmega328.kicad_pcb, bus-module_atmega328.kicad_sch, bus-module_atmega328.sch]
2023-10-13 Update to KiCAD6: bus-module_attiny1634
    [bus-module_attiny1634.kicad_pcb, bus-module_attiny1634.kicad_sch, bus-module_attiny1634.sch]
2023-10-14 Move temperature sensor to other PCB side
    * so the temperature senso faces into the room, not into the wall
    [roomthermostat.kicad_pcb]
2023-10-14 roomthermostat: Update PCB edged and add ext. sensor
    * add edge.cuts cutouts for mounting screws and frame
    * add external connector for temperature sensor
    (do not add internal and external sensor at the same time!)
    [roomthermostat.kicad_pcb, roomthermostat.kicad_sch, roomthermostat.sch]
2023-10-15 Update to KiCAD6: buscom
    [buscom.brd, buscom.kicad_pcb, buscom.kicad_sch, buscom.sch, buscom_mega32.kicad_sch, buscom_mega32.sch, businterface.kicad_sch, businterface.sch]
2023-10-15 Update to KiCAD6: motor_switch_3pole_5x
    [bus_atmega328_basic.kicad_sch, bus_atmega328_basic.sch, inputs.kicad_sch, inputs.sch, motor_relays.kicad_sch, motor_relays.sch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]
2023-10-15 Update to KiCAD6: motor_switch_3pole
    [bus_atmega328_basic.kicad_sch, bus_atmega328_basic.sch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]
2023-10-15 Update to KiCAD6: switch_3pole_5x
    [bus_atmega328_basic.kicad_sch, bus_atmega328_basic.sch, inputs.kicad_sch, inputs.sch, relays.kicad_sch, relays.sch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]
2023-10-15 Update to KiCAD6: pi2-base
    [2relays.kicad_sch, 2relays.sch, 4inputs.kicad_sch, 4inputs.sch, businterface.sch, dcdc.kicad_sch, dcdc.sch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]
2023-10-15 Update to KiCAD6: koewibapi
    [2relays.kicad_sch, 2relays.sch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]
2023-10-15 Update to KiCAD6: gateway_usb
    [gateway_usb-B_Cu.gbr, gateway_usb-B_Mask.gbr, gateway_usb-B_SilkS.gbr, gateway_usb-Edge_Cuts.gbr, gateway_usb-F_Cu.gbr, gateway_usb-F_Mask.gbr, gateway_usb-F_SilkS.gbr, gateway_usb.drl]
2023-10-15 Update to KiCAD6: busphy_breadboard
    [busphy_breadboard.kicad_pcb, busphy_breadboard.kicad_sch, busphy_breadboard.sch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]
2023-10-15 Update to KiCAD6: buscom-hub
    [buscom-hub.brd, buscom-hub.kicad_pcb, buscom-hub.kicad_sch, buscom-hub.sch]
2023-10-16 roomthermostat: move pushbuttons to front side
    [roomthermostat.kicad_pcb]
2023-11-19 heatervalve_interface: Update schematic and add PCB design
    [heatervalve-interface.kicad_pcb, heatervalve-interface.kicad_sch]
2023-11-20 roomthermostat: update component drawings and bom
    [roomthermostat_bom.csv]
2023-11-29 pushbutton8 rev.3: Curved slotted holes and enhanced circuit track routing.
    This variant has been prototyped at home and tested successfully in Nov. 2023.
    [pushbutton8.kicad_pcb, pushbutton8.kicad_sch]
2023-12-06 heatervalve-interface Create gerber files for Rev A
    [heatervalve-interface-B_Cu.gbr, heatervalve-interface-B_Mask.gbr, heatervalve-interface-B_Paste.gbr, heatervalve-interface-B_Silkscreen.gbr, heatervalve-interface-Edge_Cuts.gbr, heatervalve-interface-F_Cu.gbr, heatervalve-interface-F_Mask.gbr, heatervalve-interface-F_Paste.gbr]
2023-12-06 pusbutton8: create gerber files
    [pushbutton8-B_Cu.gbr, pushbutton8-B_Fab.gbr, pushbutton8-B_Mask.gbr, pushbutton8-B_Paste.gbr, pushbutton8-B_Silkscreen.gbr, pushbutton8-Edge_Cuts.gbr, pushbutton8-F_Cu.gbr, pushbutton8-F_Fab.gbr]
2023-12-06 roomthermostat: add gerber files for Rev C
    [roomthermostat-B.Cu.gbr, roomthermostat-B.Mask.gbr, roomthermostat-B.SilkS.gbr, roomthermostat-B_Cu.gbr, roomthermostat-B_Fab.gbr, roomthermostat-B_Mask.gbr, roomthermostat-B_Paste.gbr, roomthermostat-B_Silkscreen.gbr]
2023-12-06 bus-module_atmega324: create new gerber files for Rev C
    [bus-module_atmega324-B.Cu.gbr, bus-module_atmega324-B.Mask.gbr, bus-module_atmega324-B.SilkS.gbr, bus-module_atmega324-B_Cu.gbr, bus-module_atmega324-B_Mask.gbr, bus-module_atmega324-B_Silkscreen.gbr, bus-module_atmega324-Cmts.User.gbr, bus-module_atmega324-Dwgs.User.gbr]
2023-12-06 bus-module_atmega328: create new gerber files for Rev C
    [bus-module_atmega328-B.Cu.gbr, bus-module_atmega328-B.Mask.gbr, bus-module_atmega328-B.SilkS.gbr, bus-module_atmega328-B_Cu.gbr, bus-module_atmega328-B_Mask.gbr, bus-module_atmega328-B_Paste.gbr, bus-module_atmega328-B_Silkscreen.gbr, bus-module_atmega328-Cmts.User.gbr]
2023-12-06 bus-module_attiny1634: create new gerber files for Rev C
    [bus-module_attiny1634-B.Cu.gbr, bus-module_attiny1634-B.Mask.gbr, bus-module_attiny1634-B.Paste.gbr, bus-module_attiny1634-B.SilkS.gbr, bus-module_attiny1634-B_Cu.gbr, bus-module_attiny1634-B_Mask.gbr, bus-module_attiny1634-B_Paste.gbr, bus-module_attiny1634-B_Silkscreen.gbr]
2023-12-18 test_motor_switch_5 and test_switch_5: Fix missing version header and version length
    [appversion.c]
2023-12-18 basic_app_stmega324p: Add missing app_on_pinchangeinterrupt()
    as empty template
    [application.c]
2023-12-18 basic_app_stmega328p: Add missing app_on_pinchangeinterrupt()
    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
    [application.c]
2023-12-18 basic_app_attiny1634: Add missing app_on_pinchangeinterrupt()
    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
    [application.c, main_avr.c]
2023-12-18 blind-control_5: Add missing app_on_pinchangeinterrupt()
    [application.c]
2023-12-18 blind-control_atmega328p: Add missing app_on_pinchangeinterrupt()
    [application.c]
2023-12-18 heatervalve_gateway_attiny1624: Add missing app_on_pinchangeinterrupt()
    [application.c]
2023-12-18 led2_atmega324p: Add missing app_on_pinchangeinterrupt()
    [application.c]
2023-12-18 roomthermostat: Add missing app_on_pinchangeinterrupt()
    [application.c]
2023-12-18 switch5_atmega328p: Add missing app_on_pinchangeinterrupt()
    [application.c]
2023-12-18 elektor_bus-node_atmega88: Add missing app_on_pinchangeinterrupt()
    [application.c]
2023-12-18 test_motor_switch_5_atmega328p: Add missing app_on_pinchangeinterrupt()
    [application.c]
2023-12-18 test_switch_5_atmega328p: Add missing app_on_pinchangeinterrupt()
    [application.c]
2023-12-28 Correction of the blind-control_5x register numbers.
    [application.c]
2023-12-28 pushbutton8 sw: test version for two pushbutton8 modules
    Pushing one button of the left side sends message to other module and the LED next to the corresponding button lights up or blinks.
    Pushing one button of the right side resets corresponding LED on the other module.
    Module addresses of sender and receiver must be set in "application.c" line 32 and 33.
    [application.c, appregister.c]
2023-12-28 heatervalve_gateway: Fix version information
    [appversion.c]
2023-12-28 heatervalve: fix build
2023-12-29 heatervalve: disable uart TX when not sending
    STM8 TX signal disturbs ATtiny1634 SPI MOSI signal, which shares the same pin as Attiny's second UART. Therefore STM8 must put its TXD pin to high-Z mode when it does not send.
    Unecessary sending must be limited to debug purposes.
    So makeing debug output disableable :-)
    Default: debug output is disabled.
2023-12-29 attiny1634: fix access to ext. SPI EEProm
    * add extra spi_transmit_blk routine for attiny1634
    * do not read SPI data register twice on ATtiny1634! Only first read is valid.
    [eeprom_spi.c, spi.h, ucontroller.h]
2024-01-30 RegisterOverview: Intermediate state for pushbutton8 config registers.
    [RegisterOverview.ods]
2024-01-31 attiny1634: use USI for SPI instead of USART
2024-01-31 SPI: Fix USI-SPI driver on ATtiny1634
    Immediately after 8th clock, the read data is still in the USIDR register not in the buffer register.
    Since we control the clock from the CPU directly, there is no need to use the buffer register.
    [spi.h]
2024-01-31 basic_app_attiny1634: Add LED-debug module and fix symbols
    [application.c]
2024-01-31 heatervalve-interface: reserved 0x000A as board id
2024-01-31 heatervale-interface: Disable UART when block transfer is ongoing
2024-01-31 heatervalve: First iteration of application register layout
    [RegisterOverview.ods]
2024-01-31 RegisterOverview: gateway - add input registers
    [RegisterOverview.ods]
2024-01-31 roomthermostat: Switch input module from 'inputs' to 'input'
2024-02-05 heatervalve: monitor the two contact inputs
2024-02-11 heatervalve_interface: enable pull-up resistors for contact inputs
    On ATtiny1634 pull-ups are enabled by writing to register PUExn instead of PORTxn
2024-02-11 Add heatervale_interface to build targets
2024-02-11 blind-control_atmega328p: Set pin change register during initialization, not in background routine
2025-01-10 Fixed inline functions bug (avr-gcc) by defining it static.
    [spi.h]
2025-01-10 pushbutton8: Behavior of application configurable by register settings.
    [koewibapi-2023-11-12-22-56-27.sch]
2025-01-10 pushbutton8: LED control via bitmask setting in config register.
    - LED mode (blink|on|off) is now controlled by writing the LED registers starting at address 160.
2025-01-10 pushbutton8: New LED function type "Led_switch_register" (255=on).
    - For switch state messages (0=off, 255=on) there is a new LED function
    "eMsgDepFunc_Led_switch_register" that handles this kind of bus messages.
2025-01-11 Read module list from JSON and display those modules
    * move string to number (and vice versa) conversion to libkwb
    * read JSON module file and print it
2025-01-11 Fix versioninfo of elektor_bus-node
    [appversion.c]
2025-01-12 scheduler: Scheduler must not discard received messages
    Previously the scheduler reset the bus when a message has been received, not distinguishing if it was addressed to the scheduler or not.
    Now the scheduler received messages to its address, segment broadcast of same segment and broadcast messages.
    [bus_scheduler.c, bus_transport.c, led_debug.h, main_scheduler.c, pcbconfig.h, register.c]
2025-01-15 Enable SPI to allow EEProm to be programmed
2025-03-11 Prevent gateway from going into sleep
    [appconfig.h, main_gateway.c]
2025-03-11 Replaced tabs with spaces, added code commentation
    [main_gateway.c]
2025-03-11 Fix type in register overview
    [RegisterOverview.ods]
2025-03-14 scheduler: revert previous commit, use NULL instead for 0 for pointer
    [main_scheduler.c]
2025-03-18 Remove workaround, preventing gateway going into sleepmode.
    This workaround itself caused issues when a message was received on serial line and should be conveyed to the bus.
    [appconfig.h, main_gateway.c]
2025-04-05 Set pin-change bits and define needed interrupt handlers
    as well as some cleanup
2025-09-23 Fix bugs detected by coverity
    [connection.cpp, connection.h, connection_serial.cpp, connection_serial.h, connection_socket.cpp]
2025-11-08 kwbconfiguration: action- / command-handler
    Add an action- / command- handler to run actions in single and multithreaded environments
    The BaseCommand and CommandHandler take care of notification and synchronization over thread boundaries.
    still WIP
2025-11-08 kwbconfiguration: Integrate command handler
    * usecase: UI thread issues command, main thread receives and starts it, UI thread wait for command to be finished
2025-11-08 roomthermostat: Dislpay 'SOLL' and 'IST' over associated temperature values
2025-11-08 Zagwire bit-time varies between 104 and 128us
    New sensors work apparently using 104us bit-time instead of 128us.
    Therefore the bit-times have been adjusted covering both frequencies
    [PeripheralCalculations.ods]
2025-11-08 Averaging and hysteresis built into temperature reporting.
2025-11-09 heatervalve_interface: activate pin-change wake-up for contacts
2025-11-09 Add ability to invert debug LEDs
    [led_debug.h]
2025-11-09 heatervalve_gateway: Add debug LEDs
    LEDs low current, connected from portpin A4 and A5 to GND
2025-11-09 heatervalve: Fix type of putchar()
    [uart.c, uart.h]
2025-11-09 heatervalve: Describe UART baudrate calculation
2025-11-09 heatervalve: Do not toggle TX enable
2025-11-09 heatervalve: Use own stm8 header
    also reduce F_CPU to 2MHz and baudrate to 9600
2025-11-09 heatervalve: Add basic LCD driver
2025-11-09 heatervalve: fix lcd segment and ram assignments
2025-11-09 heatervalve: add encoder API
2025-11-09 heatervalve_gateway: keep sub-module in reset while updating firmware
    [application.c, heatervalve.c, heatervalve.h]
2025-11-09 heatervalve: improve lcd parameters
2025-11-09 heatervalve_gateway: only pull reset to GND. release by setting to high-impedance
    [heatervalve.c]
2025-11-09 heatervalve_gateway: add initial register layout file
2025-11-09 heatervale_gateway: receive and process rotary encoder data
    * sort heatervalve submodule functions into heatervalve module.
    * alter temperature setpoint based on encoder difference
    * forward altered setpoint to roomthermostat and display on submodule
2025-11-09 heatervalve: add commands for LCD display and encoder
    * new command 'dv' - display value
    * send encoder values over UART
2025-11-09 heatervalve: UART gets receive queue
2025-11-09 heatervalve: add commented code for UART tx queue
    Currently not working and also not needed urgently.
    [queue.h, uart.c]
2025-11-09 roomthermostat: switch on display if new setpoint received
2025-11-09 heatervalve*: move remote_tempsense and control_temp from heatervalve into heatervalve_gateway
2025-11-09 heatervalve: remote control STM8 reset from heatervalve_gateway
    - commented code
    [heatervalve.c]
2025-11-09 heatevalve: Display decimal point for temperature
2025-11-09 heatervalve/roomthermostate: common temperature setpoint limits 1°C..40°C
2025-11-09 heatervalve: show '----' in display when started
2025-11-09 heatervalve: Implement sampling of internal temperature sensor
    * also create encoder background routine
2025-11-09 heatervalve: monitor motor current during homing
2025-11-09 heatervalve: fix warnings
2025-11-09 heatervalve_gateway: Use maximum bus send size to forwards strings
2025-11-10 heatervalve: wake-up from sleepmode
